ttrain4086-cpu/Kicad-VME-Wren-Update/clocks.kicad_sch

## KiCad design clocks.kicad_sch (2026-05-15)

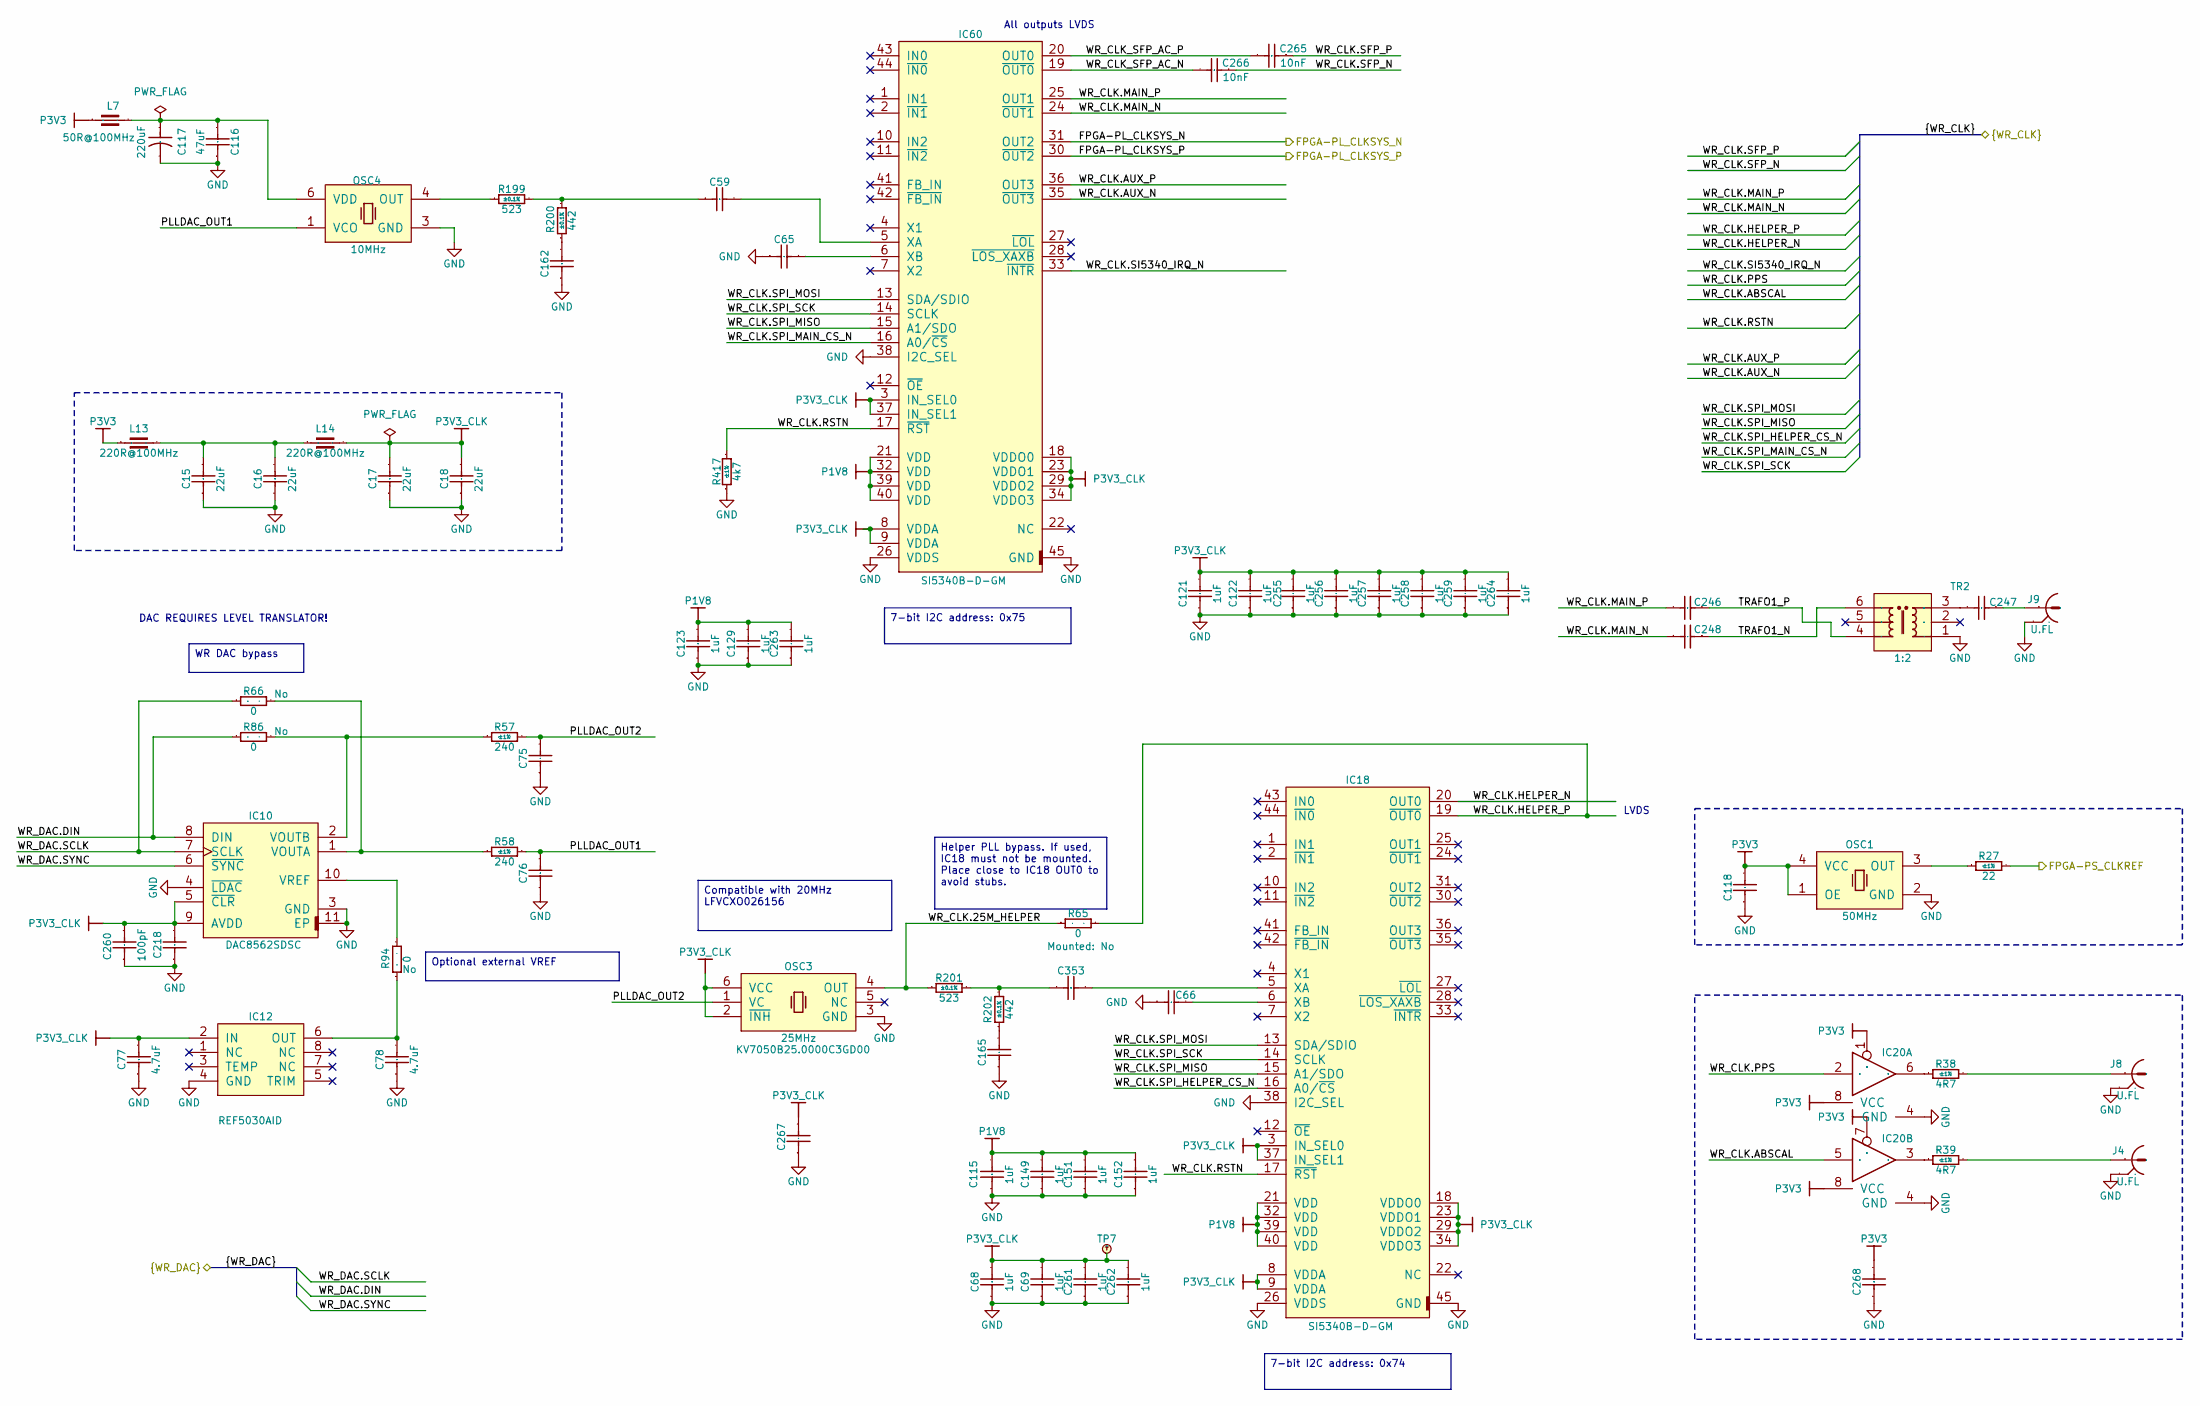
[picture p1: schematic clocks.kicad_sch]

Parts:
C15, C16, C17, C18: CC0603_22UF_10V_20%_X5R; CAPC1608X90N; Voltage 10V; Tolerance ±20%; Part Number CC0603_22UF_10V_20%_X5R
C59, C65, C66, C75, C76, C118, C162, C165, C218, C246, C247, C248, C267, C268, C353: CC0402_100NF_16V_10%_X7R; CAPC1005X55N; Voltage 16V; Tolerance ±10%; Part Number CC0402_100NF_16V_10%_X7R
C68, C69, C115, C121, C122, C123, C129, C149, C151, C152, C255, C256, C257, C258, C259, C261, C262, C263, C264: CC0402_1UF_25V_10%_X5R; CAPC1005X55N; Voltage 25V; Tolerance ±10%; Part Number CC0402_1UF_25V_10%_X5R
C77, C78: CC0402_4.7UF_6.3V_20%_X5R; CAPC1005X55N; Voltage 6.3V; Tolerance ±20%; Part Number CC0402_4.7UF_6.3V_20%_X5R
C116: CC1206_47UF_25V_20%_X5R; CAPC3216X180N; Voltage 25V; Tolerance ±20%; Part Number CC1206_47UF_25V_20%_X5R
C117: CAER_220UF_16V_20%_PANASONIC_16SEPC220MD; CAPPR350-850X700_A; Voltage 16V; Tolerance ±20%; Part Number CAER_220UF_16V_20%_PANASONIC_16SEPC220MD
C260: CC0402_100PF_50V_5%_C0G; CAPC1005X55N; Voltage 50V; Tolerance ±5%; Part Number CC0402_100PF_50V_5%_C0G
C265, C266: CC0402_10NF_16V_10%_X7R; CAPC1005X55N; Voltage 16V; Tolerance ±10%; Part Number CC0402_10NF_16V_10%_X7R
IC10: DAC8562SDSC; TEXAS_DSC (S-PWSON-N10); Part Number DAC8562SDSC
IC12: REF5030AID; SOIC127P600X175-8N; Part Number REF5030AID
IC18, IC60: SI5340B-D-GM; QFN50P700X700X90-45N-S530; Part Number SI5340B-D-GM
IC20: SN74LVC2G126DCT; SOP65P400X130-8N; Part Number SN74LVC2G126DCT
J4, J8, J9: HIROSE_U.FL-R-SMT-1(10); Part Number HIROSE_U.FL-R-SMT-1(10)
L7: IND1206_MURATA_BLM31PG500SN1; IND_MURATA_BLM31PG; Part Number IND1206_MURATA_BLM31PG500SN1
L13, L14: IND0805_MURATA_BLM21PG221SN1D; INDC2012X105N; Tolerance ±25%; Part Number IND0805_MURATA_BLM21PG221SN1D
OSC1: OSC_50MHZ_EPSON_SG-8018CE; OSC_EPSON_SG-8018CE; Part Number OSC_50MHZ_EPSON_SG-8018CE
OSC3: OSC_25MHZ_KYOCERA_KV7050B25.0000C3GD00; OSC_KYOCERA_KV7050B-C3; Part Number OSC_25MHZ_KYOCERA_KV7050B25.0000C3GD00
OSC4: OSC_10MHZ_CONNOR-WINFIELD_DOT050V-010.0M; OSC_CONNOR-WINFIELD_DOT050V; Part Number OSC_10MHZ_CONNOR-WINFIELD_DOT050V-010.0M
R27: R0402_22R_1%_0.0625W_100PPM; RESC1005X40N; Tolerance ±1%; Part Number R0402_22R_1%_0.0625W_100PPM
R38, R39: R0805_4R7_1%_0.125W_200PPM; RESC2012X60N; Tolerance ±1%; Part Number R0805_4R7_1%_0.125W_200PPM
R57, R58: R0402_240R_1%_0.0625W_100PPM; RESC1005X40N; Tolerance ±1%; Part Number R0402_240R_1%_0.0625W_100PPM
R65, R66, R86, R94: R0402_0R_JUMPER; RESC1005X40N; Part Number R0402_0R_JUMPER
R199, R201: R0603_523R_0.1%_0.063W_10PPM; RESC1608X55N; Tolerance ±0.1%; Part Number R0603_523R_0.1%_0.063W_10PPM
R200, R202: R0603_442R_0.1%_0.063W_10PPM; RESC1608X55N; Tolerance ±0.1%; Part Number R0603_442R_0.1%_0.063W_10PPM
R417: R0402_4K7_1%_0.0625W_100PPM; RESC1005X40N; Tolerance ±1%; Part Number R0402_4K7_1%_0.0625W_100PPM
TP7: Tomachie_TP_N; TPS127
TR2: XFMR_MINI-CIRCUITS_ADT2-1T+; XFMR_MINI-CIRCUITS_CD542; Part Number XFMR_MINI-CIRCUITS_ADT2-1T+

Connections:
FPGA-PL_CLKSYS_N: IC60.31 (OUT2)
FPGA-PL_CLKSYS_P: IC60.30 (~OUT2)
FPGA-PS_CLKREF: R27.2
GND: C15.1, C16.1, C17.1, C18.1, C65.1, C66.1, C68.1, C69.1, C75.1, C76.1, C77.1, C78.1, C115.1, C116.1, C117.2, C118.1, C121.1, C122.1, C123.1, C129.1, C149.1, C151.1, C152.1, C162.1, C165.1, C218.1, C255.1, C256.1, C257.1, C258.1, C259.1, C260.1, C261.1, C262.1, C263.1, C264.1, C267.1, C268.1, IC10.3 (GND), IC10.4 (~LDAC), IC10.11 (EP), IC12.4 (GND), IC18.26 (VDDS), IC18.38 (I2C_SEL), IC18.45 (GND), IC20.4 (GND), IC60.26 (VDDS), IC60.38 (I2C_SEL), IC60.45 (GND), J4.2, J8.2, J9.2, OSC1.2 (GND), OSC3.3 (GND), OSC4.3 (GND), R417.1, TR2.1
unnamed: C15.2, C16.2, L13.2, L14.1
unnamed: C59.1, R199.2, R200.2
unnamed: C59.2, IC60.5 (XA)
unnamed: C65.2, IC60.6 (XB)
unnamed: C66.2, IC18.6 (XB)
unnamed: C78.2, IC12.6 (OUT), R94.1
unnamed: C116.2, C117.1, L7.2, OSC4.6 (VDD)
unnamed: C162.2, R200.1
unnamed: C165.2, R202.1
unnamed: C247.1, J9.1
unnamed: C247.2, TR2.3 (PDOT)
unnamed: C353.1, R201.2, R202.2
unnamed: C353.2, IC18.5 (XA)
unnamed: IC10.1 (VOUTA), R58.1, R66.2
unnamed: IC10.2 (VOUTB), R57.1, R86.2
unnamed: IC10.10 (VREF), R94.2
unnamed: IC20.3 (2Y), R39.1
unnamed: IC20.6 (1Y), R38.1
unnamed: J4.1, R39.2
unnamed: J8.1, R38.2
unnamed: OSC1.3 (OUT), R27.1
unnamed: OSC4.4 (OUT), R199.1
P1V8: C115.2, C123.2, C129.2, C149.2, C151.2, C152.2, C263.2, IC18.21 (VDD), IC18.32 (VDD), IC18.39 (VDD), IC18.40 (VDD), IC60.21 (VDD), IC60.32 (VDD), IC60.39 (VDD), IC60.40 (VDD)
P3V3: C118.2, C268.2, IC20.1 (1~OE), IC20.7 (7~OE), IC20.8 (VCC), L7.1, L13.1, OSC1.1 (OE), OSC1.4 (VCC)
P3V3_CLK: C17.2, C18.2, C68.2, C69.2, C77.2, C121.2, C122.2, C218.2, C255.2, C256.2, C257.2, C258.2, C259.2, C260.2, C261.2, C262.2, C264.2, C267.2, IC10.5 (~CLR), IC10.9 (AVDD), IC12.2 (IN), IC18.3 (IN_SEL0), IC18.8 (VDDA), IC18.9 (VDDA), IC18.18 (VDDO0), IC18.23 (VDDO1), IC18.29 (VDDO2), IC18.34 (VDDO3), IC18.37 (IN_SEL1), IC60.3 (IN_SEL0), IC60.8 (VDDA), IC60.9 (VDDA), IC60.18 (VDDO0), IC60.23 (VDDO1), IC60.29 (VDDO2), IC60.34 (VDDO3), IC60.37 (IN_SEL1), L14.2, OSC3.2 (~INH), OSC3.6 (VCC), TP7.1
PLLDAC_OUT1: C76.2, OSC4.1 (VCO), R58.2
PLLDAC_OUT2: C75.2, OSC3.1 (VC), R57.2
TRAFO1_N: C248.1, TR2.6 (SDOT)
TRAFO1_P: C246.1, TR2.4 (S)
WR_CLK.25M_HELPER: OSC3.4 (OUT), R65.1, R201.1
WR_CLK.ABSCAL: IC20.5 (2A)
WR_CLK.AUX_N: IC60.35 (~OUT3)
WR_CLK.AUX_P: IC60.36 (OUT3)
WR_CLK.HELPER_N: IC18.20 (OUT0)
WR_CLK.HELPER_P: IC18.19 (~OUT0), R65.2
WR_CLK.MAIN_N: C248.2, IC60.24 (~OUT1)
WR_CLK.MAIN_P: C246.2, IC60.25 (OUT1)
WR_CLK.PPS: IC20.2 (1A)
WR_CLK.RSTN: IC18.17 (~RST), IC60.17 (~RST), R417.2
WR_CLK.SFP_N: C266.1
WR_CLK.SFP_P: C265.1
WR_CLK.SI5340_IRQ_N: IC60.33 (~INTR)
WR_CLK.SPI_HELPER_CS_N: IC18.16 (A0/~CS)
WR_CLK.SPI_MAIN_CS_N: IC60.16 (A0/~CS)
WR_CLK.SPI_MISO: IC18.15 (A1/SDO), IC60.15 (A1/SDO)
WR_CLK.SPI_MOSI: IC18.13 (SDA/SDIO), IC60.13 (SDA/SDIO)
WR_CLK.SPI_SCK: IC18.14 (SCLK), IC60.14 (SCLK)
WR_CLK_SFP_AC_N: C266.2, IC60.19 (~OUT0)
WR_CLK_SFP_AC_P: C265.2, IC60.20 (OUT0)
WR_DAC.DIN: IC10.8 (DIN), R86.1
WR_DAC.SCLK: IC10.7 (SCLK), R66.1
WR_DAC.SYNC: IC10.6 (~SYNC)

Notes on the sheet:
DAC REQUIRES LEVEL TRANSLATOR!
LVDS
All outputs LVDS
Helper PLL bypass. If used, IC18 must not be mounted. Place close to IC18 OUT0 to avoid stubs.
Compatible with 20MHz LFVCXO026156
7-bit I2C address: 0x75
Optional external VREF
7-bit I2C address: 0x74
WR DAC bypass
