ttrain4086-cpu/Kicad-VME-Wren-Update/ddr4-ps.kicad_sch

## KiCad design ddr4-ps.kicad_sch (2026-05-15)

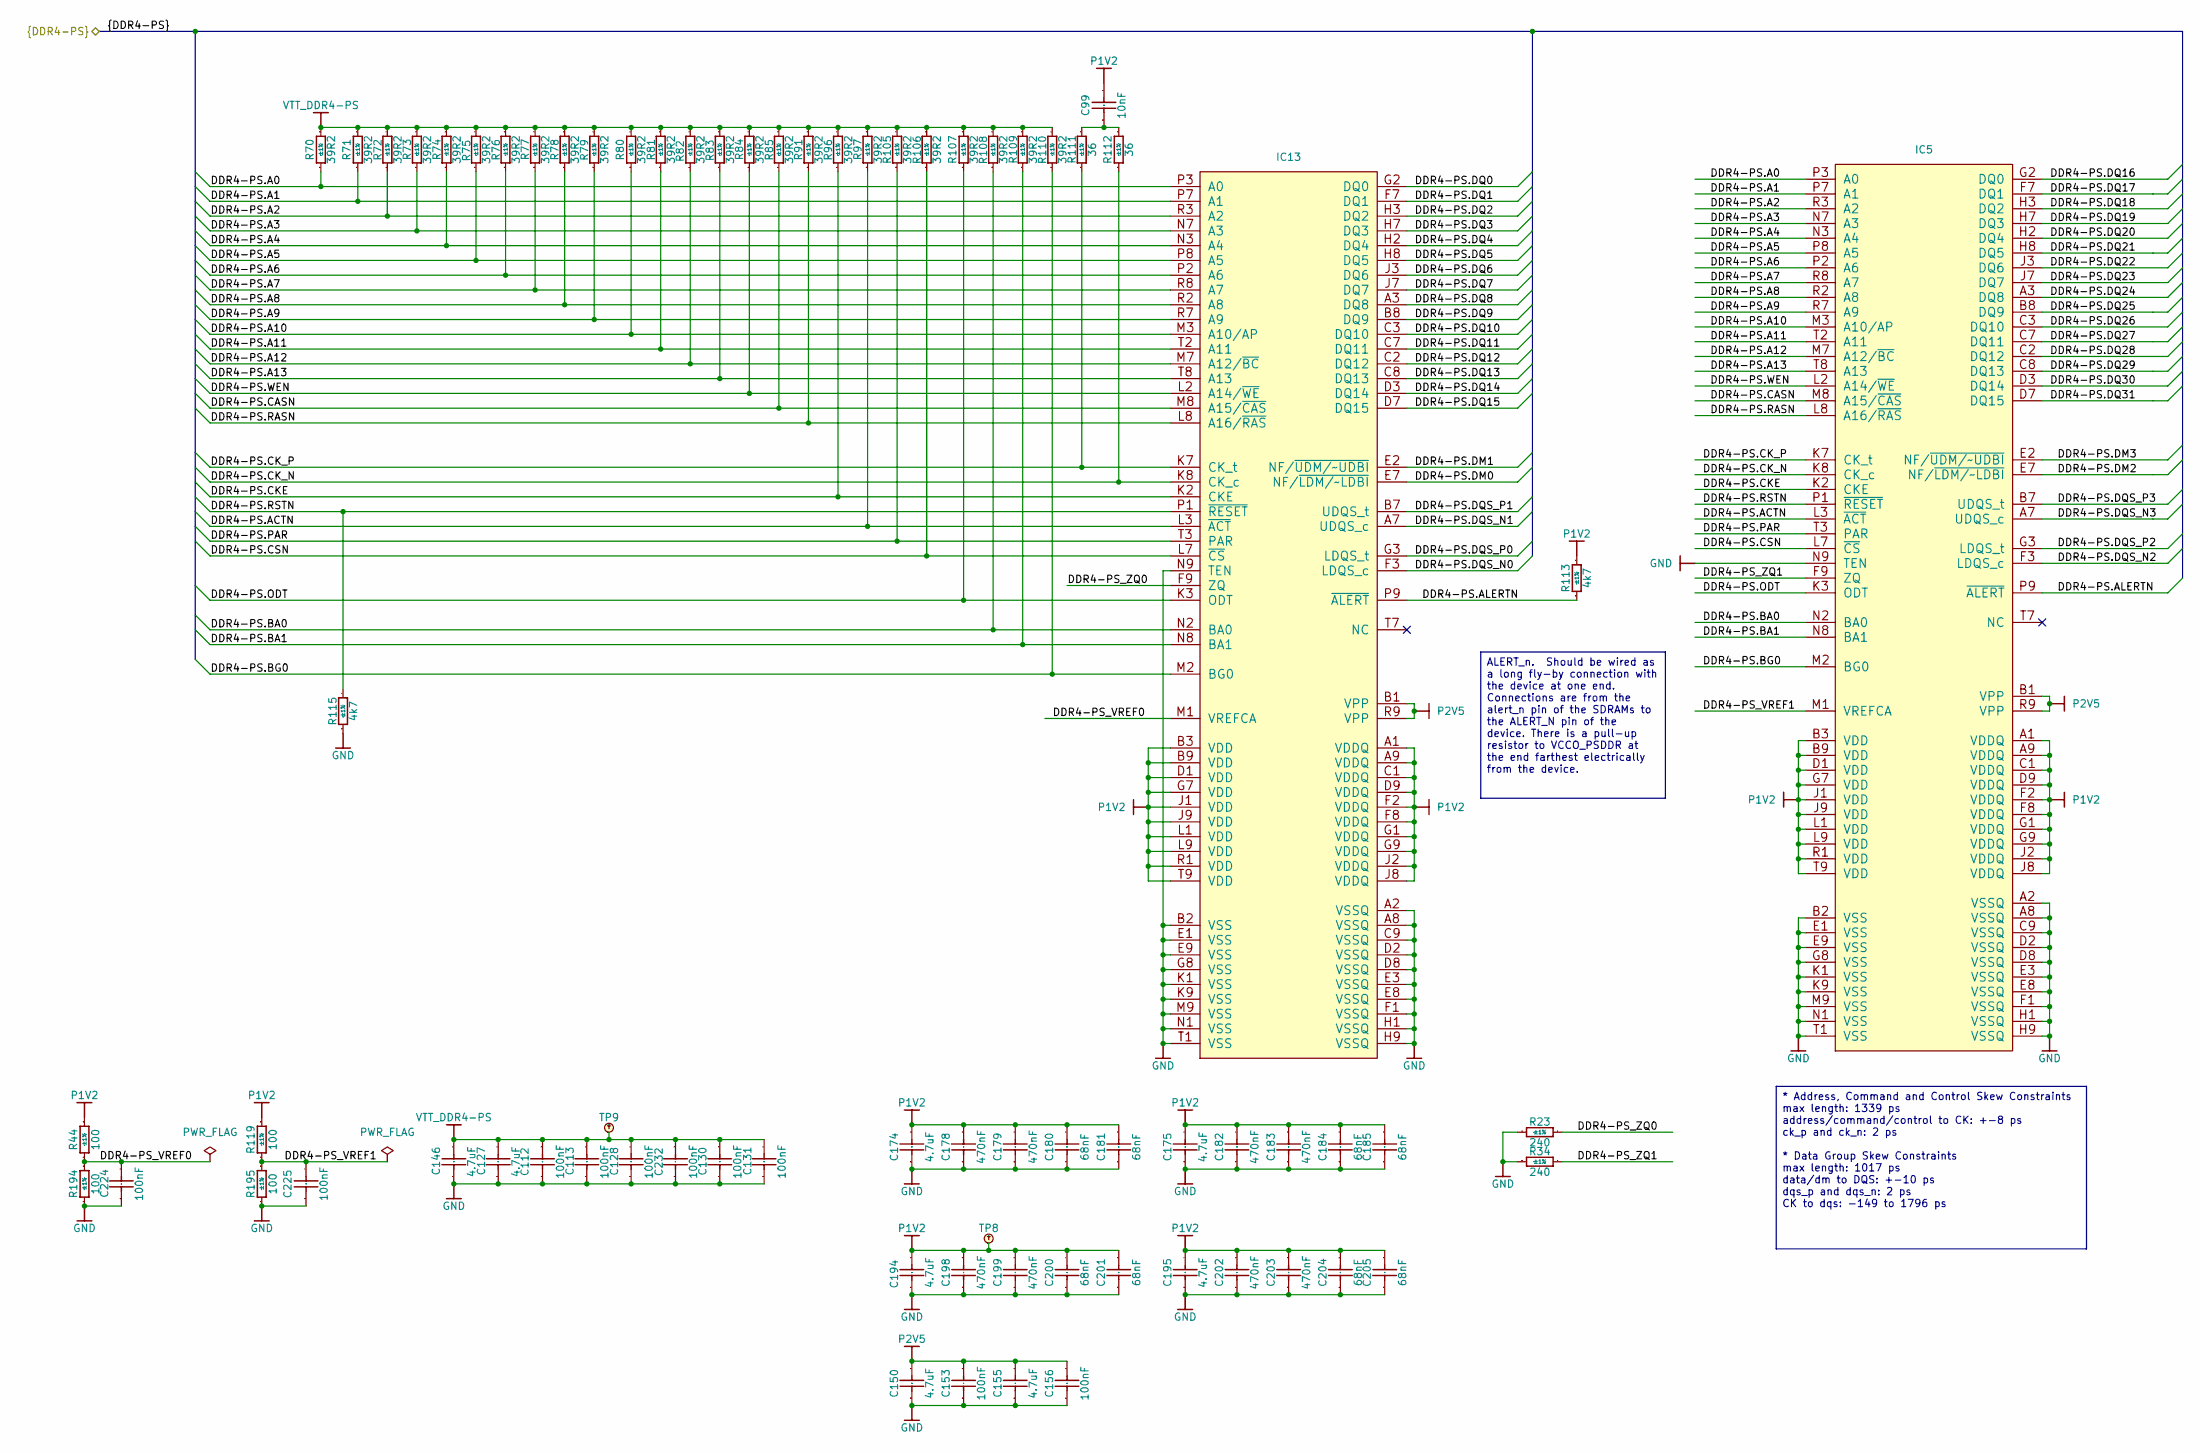
[picture p2: schematic ddr4-ps.kicad_sch]

Parts:
C99: CC0402_10NF_16V_10%_X7R; CAPC1005X55N; Voltage 16V; Tolerance ±10%; Part Number CC0402_10NF_16V_10%_X7R
C112, C113, C128, C130, C131, C153, C156, C224, C225, C232: CC0402_100NF_25V_10%_X7R_YUDEN_TMK105B7104KVHF; CAPC1005X55N; Voltage 25V; Tolerance ±10%; Part Number CC0402_100NF_25V_10%_X7R_YUDEN_TMK105B7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
C127, C146, C150, C155, C174, C175, C194, C195: CC0402_4.7UF_6.3V_20%_X5R; CAPC1005X55N; Voltage 6.3V; Tolerance ±20%; Part Number CC0402_4.7UF_6.3V_20%_X5R
C178, C179, C182, C183, C198, C199, C202, C203: CC0402_470NF_6.3V_10%_X5R; CAPC1005X55N; Voltage 6.3V; Tolerance ±10%; Part Number CC0402_470NF_6.3V_10%_X5R
C180, C181, C184, C185, C200, C201, C204, C205: CC0402_68NF_16V_10%_X7R; CAPC1005X55N; Voltage 16V; Tolerance ±10%; Part Number CC0402_68NF_16V_10%_X7R
IC5, IC13: MT40A512M16LY-075-E; BGA96C80P9X16_750X1350X120; Part Description +1.2V, 8Gb (512 Meg x 16) Automotive DD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
R23, R34: R0402_240R_1%_0.0625W_100PPM; RESC1005X40N; Tolerance ±1%; Part Number R0402_240R_1%_0.0625W_100PPM
R44, R119, R194, R195: R0402_100R_1%_0.0625W_100PPM; RESC1005X40N; Tolerance ±1%; Part Number R0402_100R_1%_0.0625W_100PPM
R70, R71, R72, R73, R74, R75, R76, R77, R78, R79, R80, R81, R82, R83, R84, R85, R91, R96, R97, R105, R106, R107, R108, R109, R110: R0402_39R2_1%_0.063W_100PPM; RESC1005X40N; Tolerance ±1%; Part Number R0402_39R2_1%_0.063W_100PPM
R111, R112: R0402_36R_1%_0.0625W_100PPM; RESC1005X40N; Tolerance ±1%; Part Number R0402_36R_1%_0.0625W_100PPM
R113, R115: R0402_4K7_1%_0.0625W_100PPM; RESC1005X40N; Tolerance ±1%; Part Number R0402_4K7_1%_0.0625W_100PPM
TP8, TP9: Tomachie_TP_N; TPS127

Connections:
DDR4-PS.A0: IC5.P3 (A0), IC13.P3 (A0), R70.1
DDR4-PS.A1: IC5.P7 (A1), IC13.P7 (A1), R71.1
DDR4-PS.A2: IC5.R3 (A2), IC13.R3 (A2), R72.1
DDR4-PS.A3: IC5.N7 (A3), IC13.N7 (A3), R73.1
DDR4-PS.A4: IC5.N3 (A4), IC13.N3 (A4), R74.1
DDR4-PS.A5: IC5.P8 (A5), IC13.P8 (A5), R75.1
DDR4-PS.A6: IC5.P2 (A6), IC13.P2 (A6), R76.1
DDR4-PS.A7: IC5.R8 (A7), IC13.R8 (A7), R77.1
DDR4-PS.A8: IC5.R2 (A8), IC13.R2 (A8), R78.1
DDR4-PS.A9: IC5.R7 (A9), IC13.R7 (A9), R79.1
DDR4-PS.A10: IC5.M3 (A10/AP), IC13.M3 (A10/AP), R80.1
DDR4-PS.A11: IC5.T2 (A11), IC13.T2 (A11), R81.1
DDR4-PS.A12: IC5.M7 (A12/~BC), IC13.M7 (A12/~BC), R82.1
DDR4-PS.A13: IC5.T8 (A13), IC13.T8 (A13), R83.1
DDR4-PS.ACTN: IC5.L3 (~ACT), IC13.L3 (~ACT), R97.1
DDR4-PS.ALERTN: IC5.P9 (~ALERT), IC13.P9 (~ALERT), R113.1
DDR4-PS.BA0: IC5.N2 (BA0), IC13.N2 (BA0), R108.1
DDR4-PS.BA1: IC5.N8 (BA1), IC13.N8 (BA1), R109.1
DDR4-PS.BG0: IC5.M2 (BG0), IC13.M2 (BG0), R110.1
DDR4-PS.CASN: IC5.M8 (A15/~CAS), IC13.M8 (A15/~CAS), R85.1
DDR4-PS.CKE: IC5.K2 (CKE), IC13.K2 (CKE), R96.1
DDR4-PS.CK_N: IC5.K8 (CK_c), IC13.K8 (CK_c), R112.1
DDR4-PS.CK_P: IC5.K7 (CK_t), IC13.K7 (CK_t), R111.1
DDR4-PS.CSN: IC5.L7 (~CS), IC13.L7 (~CS), R106.1
DDR4-PS.DM0: IC13.E7 (NF/~LDM/~LDBI)
DDR4-PS.DM1: IC13.E2 (NF/~UDM/~UDBI)
DDR4-PS.DM2: IC5.E7 (NF/~LDM/~LDBI)
DDR4-PS.DM3: IC5.E2 (NF/~UDM/~UDBI)
DDR4-PS.DQ0: IC13.G2 (DQ0)
DDR4-PS.DQ1: IC13.F7 (DQ1)
DDR4-PS.DQ2: IC13.H3 (DQ2)
DDR4-PS.DQ3: IC13.H7 (DQ3)
DDR4-PS.DQ4: IC13.H2 (DQ4)
DDR4-PS.DQ5: IC13.H8 (DQ5)
DDR4-PS.DQ6: IC13.J3 (DQ6)
DDR4-PS.DQ7: IC13.J7 (DQ7)
DDR4-PS.DQ8: IC13.A3 (DQ8)
DDR4-PS.DQ9: IC13.B8 (DQ9)
DDR4-PS.DQ10: IC13.C3 (DQ10)
DDR4-PS.DQ11: IC13.C7 (DQ11)
DDR4-PS.DQ12: IC13.C2 (DQ12)
DDR4-PS.DQ13: IC13.C8 (DQ13)
DDR4-PS.DQ14: IC13.D3 (DQ14)
DDR4-PS.DQ15: IC13.D7 (DQ15)
DDR4-PS.DQ16: IC5.G2 (DQ0)
DDR4-PS.DQ17: IC5.F7 (DQ1)
DDR4-PS.DQ18: IC5.H3 (DQ2)
DDR4-PS.DQ19: IC5.H7 (DQ3)
DDR4-PS.DQ20: IC5.H2 (DQ4)
DDR4-PS.DQ21: IC5.H8 (DQ5)
DDR4-PS.DQ22: IC5.J3 (DQ6)
DDR4-PS.DQ23: IC5.J7 (DQ7)
DDR4-PS.DQ24: IC5.A3 (DQ8)
DDR4-PS.DQ25: IC5.B8 (DQ9)
DDR4-PS.DQ26: IC5.C3 (DQ10)
DDR4-PS.DQ27: IC5.C7 (DQ11)
DDR4-PS.DQ28: IC5.C2 (DQ12)
DDR4-PS.DQ29: IC5.C8 (DQ13)
DDR4-PS.DQ30: IC5.D3 (DQ14)
DDR4-PS.DQ31: IC5.D7 (DQ15)
DDR4-PS.DQS_N0: IC13.F3 (LDQS_c)
DDR4-PS.DQS_N1: IC13.A7 (UDQS_c)
DDR4-PS.DQS_N2: IC5.F3 (LDQS_c)
DDR4-PS.DQS_N3: IC5.A7 (UDQS_c)
DDR4-PS.DQS_P0: IC13.G3 (LDQS_t)
DDR4-PS.DQS_P1: IC13.B7 (UDQS_t)
DDR4-PS.DQS_P2: IC5.G3 (LDQS_t)
DDR4-PS.DQS_P3: IC5.B7 (UDQS_t)
DDR4-PS.ODT: IC5.K3 (ODT), IC13.K3 (ODT), R107.1
DDR4-PS.PAR: IC5.T3 (PAR), IC13.T3 (PAR), R105.1
DDR4-PS.RASN: IC5.L8 (A16/~RAS), IC13.L8 (A16/~RAS), R91.1
DDR4-PS.RSTN: IC5.P1 (~RESET), IC13.P1 (~RESET), R115.2
DDR4-PS.WEN: IC5.L2 (A14/~WE), IC13.L2 (A14/~WE), R84.1
DDR4-PS_VREF0: C224.2, IC13.M1 (VREFCA), R44.2, R194.1
DDR4-PS_VREF1: C225.2, IC5.M1 (VREFCA), R119.2, R195.1
DDR4-PS_ZQ0: IC13.F9 (ZQ), R23.2
DDR4-PS_ZQ1: IC5.F9 (ZQ), R34.2
GND: C112.1, C113.1, C127.1, C128.1, C130.1, C131.1, C146.1, C150.1, C153.1, C155.1, C156.1, C174.1, C175.1, C178.1, C179.1, C180.1, C181.1, C182.1, C183.1, C184.1, C185.1, C194.1, C195.1, C198.1, C199.1, C200.1, C201.1, C202.1, C203.1, C204.1, C205.1, C224.1, C225.1, C232.1, IC5.A2 (VSSQ), IC5.A8 (VSSQ), IC5.B2 (VSS), IC5.C9 (VSSQ), IC5.D2 (VSSQ), IC5.D8 (VSSQ), IC5.E1 (VSS), IC5.E3 (VSSQ), IC5.E8 (VSSQ), IC5.E9 (VSS), IC5.F1 (VSSQ), IC5.G8 (VSS), IC5.H1 (VSSQ), IC5.H9 (VSSQ), IC5.K1 (VSS), IC5.K9 (VSS), IC5.M9 (VSS), IC5.N1 (VSS), IC5.N9 (TEN), IC5.T1 (VSS), IC13.A2 (VSSQ), IC13.A8 (VSSQ), IC13.B2 (VSS), IC13.C9 (VSSQ), IC13.D2 (VSSQ), IC13.D8 (VSSQ), IC13.E1 (VSS), IC13.E3 (VSSQ), IC13.E8 (VSSQ), IC13.E9 (VSS), IC13.F1 (VSSQ), IC13.G8 (VSS), IC13.H1 (VSSQ), IC13.H9 (VSSQ), IC13.K1 (VSS), IC13.K9 (VSS), IC13.M9 (VSS), IC13.N1 (VSS), IC13.N9 (TEN), IC13.T1 (VSS), R23.1, R34.1, R115.1, R194.2, R195.2
unnamed: C99.1, R111.2, R112.2
P1V2: C99.2, C174.2, C175.2, C178.2, C179.2, C180.2, C181.2, C182.2, C183.2, C184.2, C185.2, C194.2, C195.2, C198.2, C199.2, C200.2, C201.2, C202.2, C203.2, C204.2, C205.2, IC5.A1 (VDDQ), IC5.A9 (VDDQ), IC5.B3 (VDD), IC5.B9 (VDD), IC5.C1 (VDDQ), IC5.D1 (VDD), IC5.D9 (VDDQ), IC5.F2 (VDDQ), IC5.F8 (VDDQ), IC5.G1 (VDDQ), IC5.G7 (VDD), IC5.G9 (VDDQ), IC5.J1 (VDD), IC5.J2 (VDDQ), IC5.J8 (VDDQ), IC5.J9 (VDD), IC5.L1 (VDD), IC5.L9 (VDD), IC5.R1 (VDD), IC5.T9 (VDD), IC13.A1 (VDDQ), IC13.A9 (VDDQ), IC13.B3 (VDD), IC13.B9 (VDD), IC13.C1 (VDDQ), IC13.D1 (VDD), IC13.D9 (VDDQ), IC13.F2 (VDDQ), IC13.F8 (VDDQ), IC13.G1 (VDDQ), IC13.G7 (VDD), IC13.G9 (VDDQ), IC13.J1 (VDD), IC13.J2 (VDDQ), IC13.J8 (VDDQ), IC13.J9 (VDD), IC13.L1 (VDD), IC13.L9 (VDD), IC13.R1 (VDD), IC13.T9 (VDD), R44.1, R113.2, R119.1, TP8.1
P2V5: C150.2, C153.2, C155.2, C156.2, IC5.B1 (VPP), IC5.R9 (VPP), IC13.B1 (VPP), IC13.R9 (VPP)
VTT_DDR4-PS: C112.2, C113.2, C127.2, C128.2, C130.2, C131.2, C146.2, C232.2, R70.2, R71.2, R72.2, R73.2, R74.2, R75.2, R76.2, R77.2, R78.2, R79.2, R80.2, R81.2, R82.2, R83.2, R84.2, R85.2, R91.2, R96.2, R97.2, R105.2, R106.2, R107.2, R108.2, R109.2, R110.2, TP9.1

Notes on the sheet:
* Address, Command and Control Skew Constraints max length: 1339 ps address/command/control to CK: +-8 ps ck_p and ck_n: 2 ps * Data Group Skew Constraints max length: 1017 ps data/dm to DQS: +-10 ps dqs_p and dqs_n: 2 ps CK to dqs: -149 to 1796 ps
ALERT_n. Should be wired as a long fly-by connection with the device at one end. Connections are from the alert_n pin of the SDRAMs to the ALERT_N pin of the device. There is a pull-up resistor to VCCO_PSDDR at the end farthest electrically from the device.
