ttrain4086-cpu/Kicad-VME-Wren-Update/flash.kicad_sch

## KiCad design flash.kicad_sch (2026-05-15)

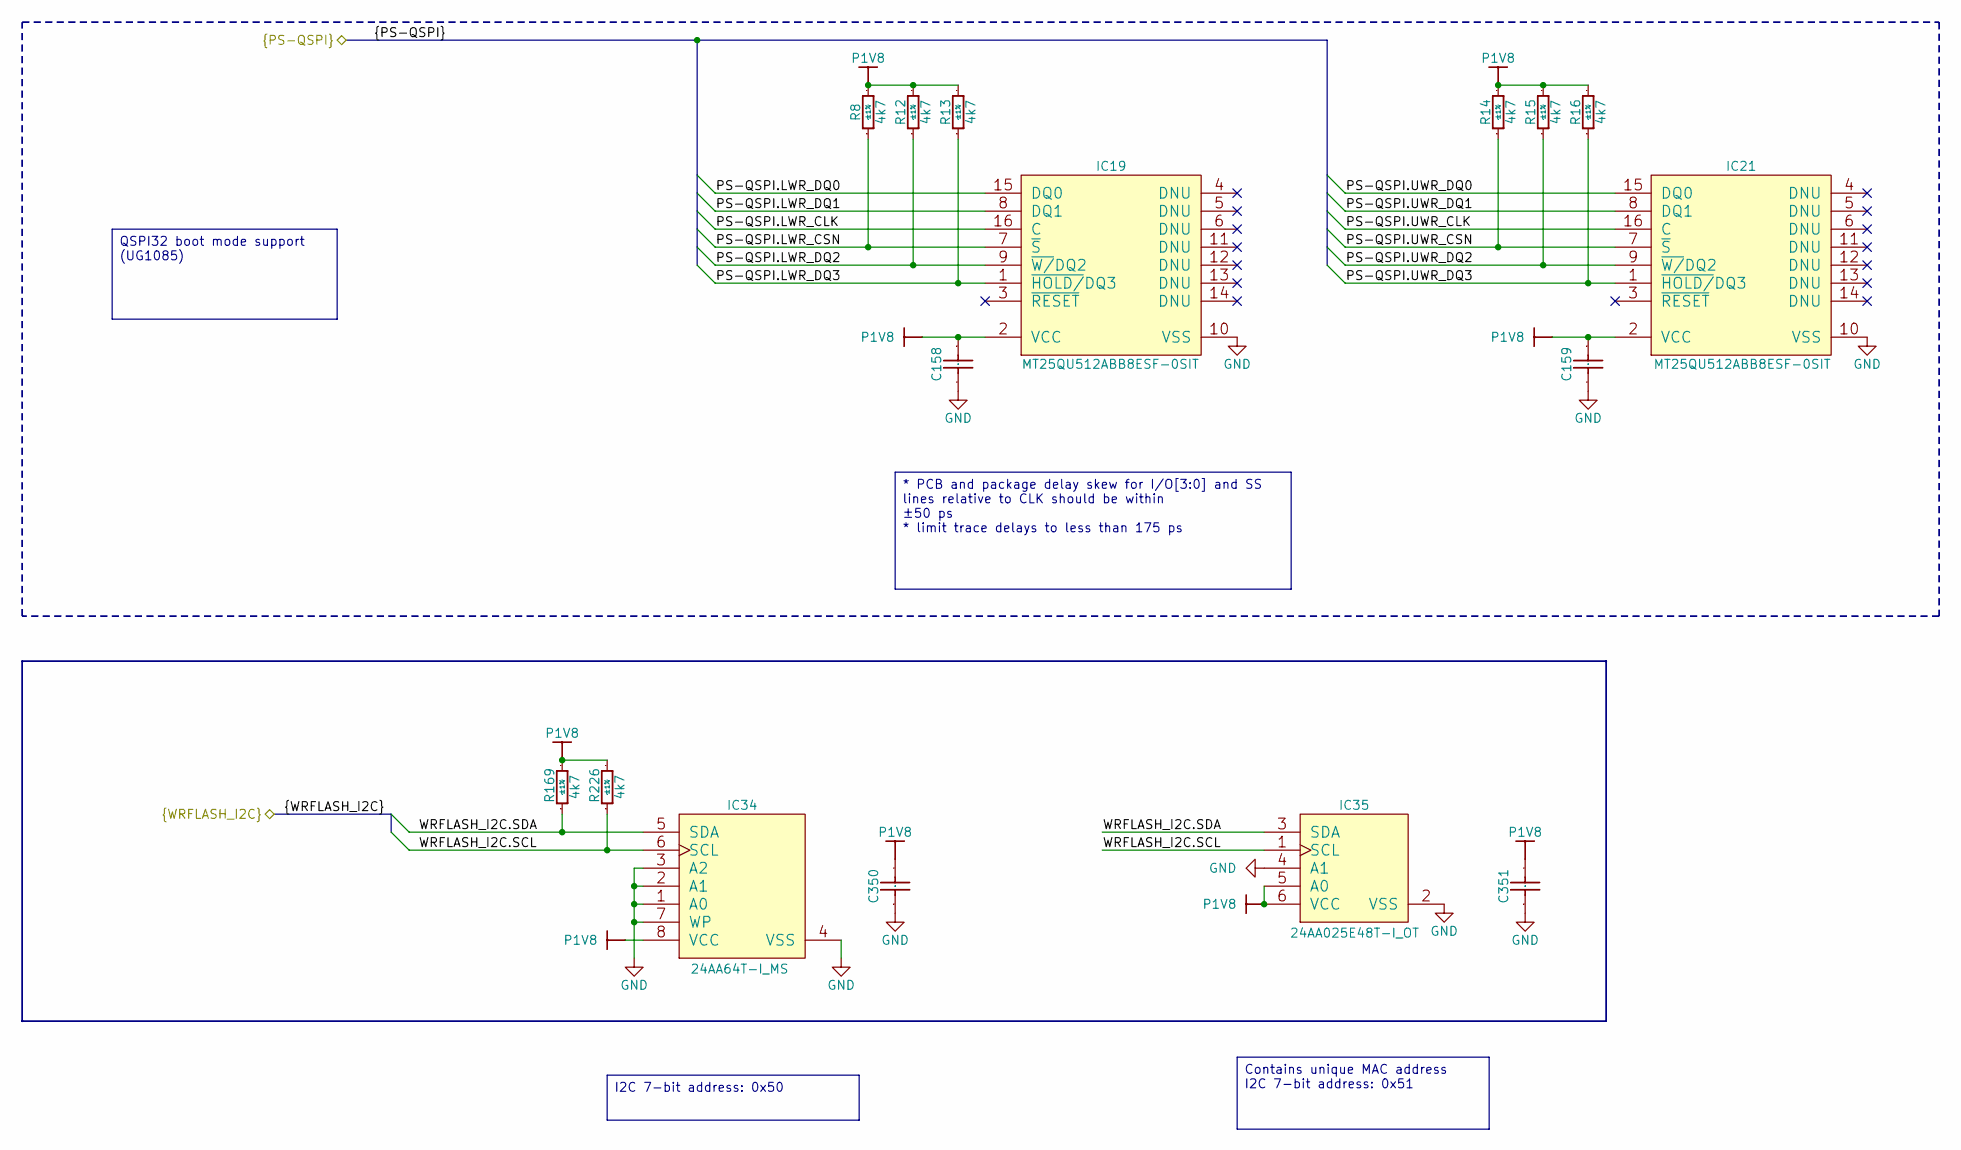
[picture p3: schematic flash.kicad_sch]

Parts:
C158, C159, C350, C351: CC0402_100NF_16V_10%_X7R; CAPC1005X55N; Voltage 16V; Tolerance ±10%; Part Number CC0402_100NF_16V_10%_X7R
IC19, IC21: MT25QU512ABB8ESF-0SIT; SOIC127P1030X265-16N; Part Number MT25QU512ABB8ESF-0SIT
IC34: 24AA64T-I_MS; SOP65P490X110-8N; Part Number 24AA64T-I_MS
IC35: 24AA025E48T-I_OT; SOT95P280X145-6N; Part Number 24AA025E48T-I_OT
R8, R12, R13, R14, R15, R16, R169, R226: R0402_4K7_1%_0.0625W_100PPM; RESC1005X40N; Tolerance ±1%; Part Number R0402_4K7_1%_0.0625W_100PPM

Connections:
GND: C158.2, C159.2, C350.1, C351.1, IC19.10 (VSS), IC21.10 (VSS), IC34.1 (A0), IC34.2 (A1), IC34.3 (A2), IC34.4 (VSS), IC34.7 (WP), IC35.2 (VSS), IC35.4 (A1)
P1V8: C158.1, C159.1, C350.2, C351.2, IC19.2 (VCC), IC21.2 (VCC), IC34.8 (VCC), IC35.5 (A0), IC35.6 (VCC), R8.2, R12.2, R13.2, R14.2, R15.2, R16.2, R169.2, R226.2
PS-QSPI.LWR_CLK: IC19.16 (C)
PS-QSPI.LWR_CSN: IC19.7 (~S), R8.1
PS-QSPI.LWR_DQ0: IC19.15 (DQ0)
PS-QSPI.LWR_DQ1: IC19.8 (DQ1)
PS-QSPI.LWR_DQ2: IC19.9 (~W/DQ2), R12.1
PS-QSPI.LWR_DQ3: IC19.1 (~HOLD/DQ3), R13.1
PS-QSPI.UWR_CLK: IC21.16 (C)
PS-QSPI.UWR_CSN: IC21.7 (~S), R14.1
PS-QSPI.UWR_DQ0: IC21.15 (DQ0)
PS-QSPI.UWR_DQ1: IC21.8 (DQ1)
PS-QSPI.UWR_DQ2: IC21.9 (~W/DQ2), R15.1
PS-QSPI.UWR_DQ3: IC21.1 (~HOLD/DQ3), R16.1
WRFLASH_I2C.SCL: IC34.6 (SCL), IC35.1 (SCL), R226.1
WRFLASH_I2C.SDA: IC34.5 (SDA), IC35.3 (SDA), R169.1

Notes on the sheet:
* PCB and package delay skew for I/O[3:0] and SS lines relative to CLK should be within ±50 ps * limit trace delays to less than 175 ps
QSPI32 boot mode support (UG1085)
I2C 7-bit address: 0x50
Contains unique MAC address I2C 7-bit address: 0x51
