ttrain4086-cpu/Kicad-VME-Wren-Update/fp_connectors.kicad_sch

## KiCad design fp_connectors.kicad_sch (2026-05-15)

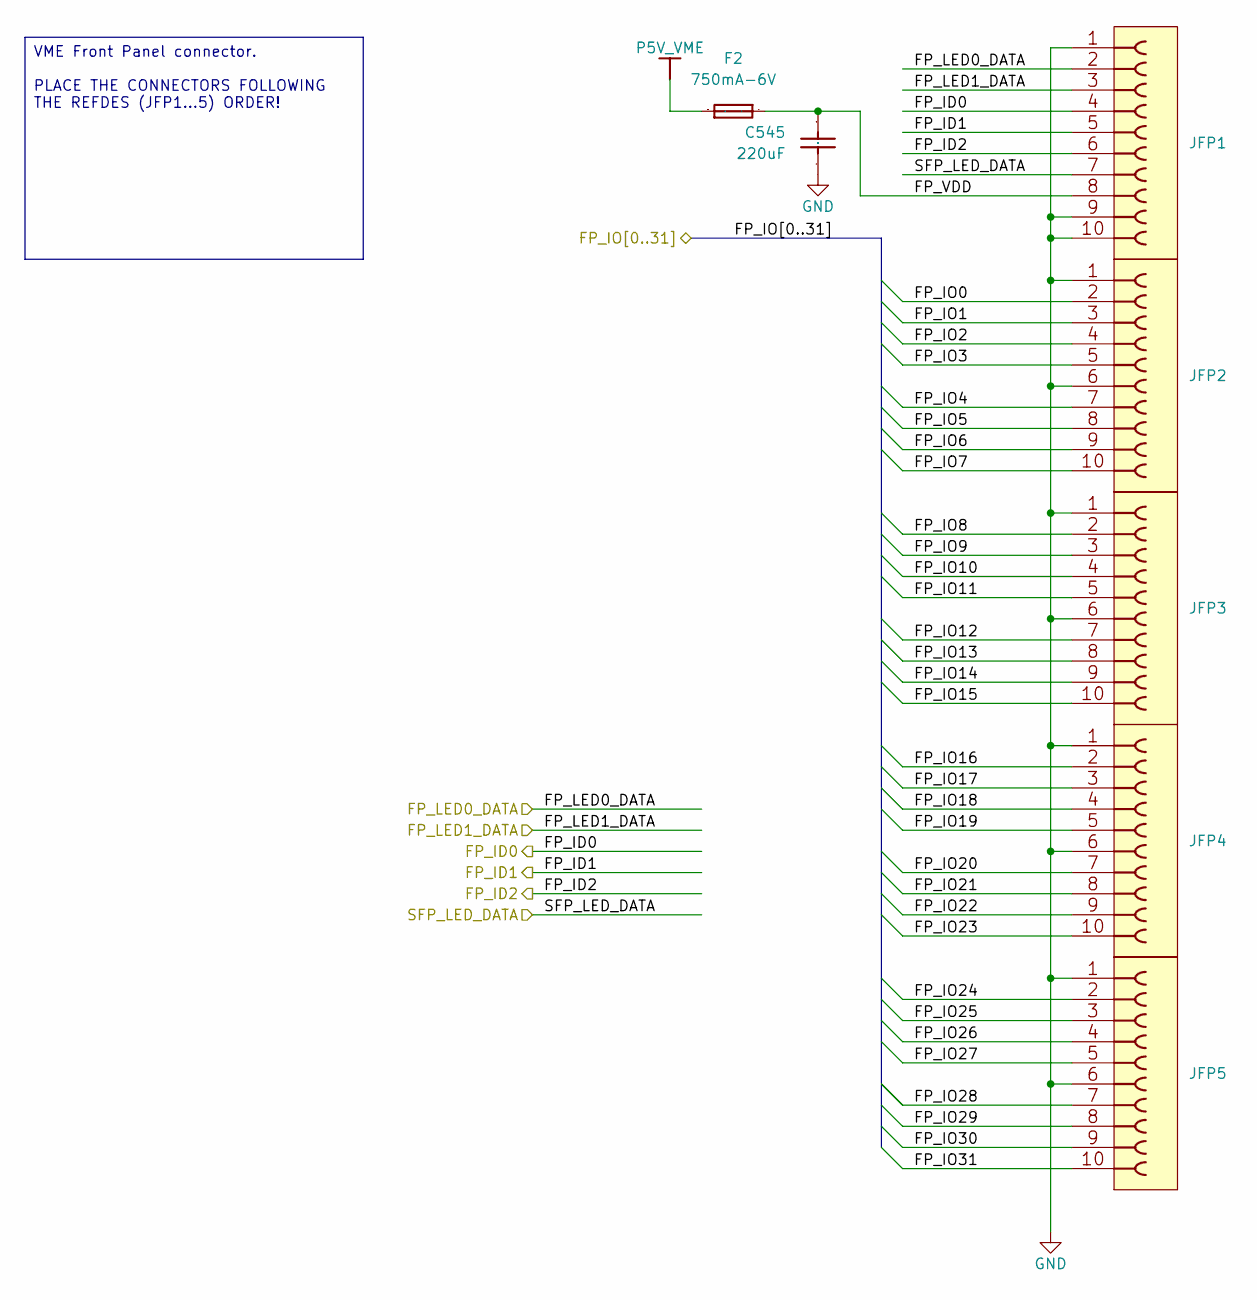
[picture p4: schematic fp_connectors.kicad_sch]

Parts:
C545: CC1210_220UF_6.3V_20%_X5R; CAPC3225X280N; Voltage 6.3V; Tolerance ±20%; Part Number CC1210_220UF_6.3V_20%_X5R
F2: FUSR_LITTELFUSE_0603L075SL; FUSR_LITTELFUSE_0603L; Part Number FUSR_LITTELFUSE_0603L075SL
JFP1, JFP2, JFP3, JFP4, JFP5: HARWIN_M22-6541042R; Part Number HARWIN_M22-6541042R

Connections:
FP_ID0: JFP1.4
FP_ID1: JFP1.5
FP_ID2: JFP1.6
FP_IO0: JFP2.2
FP_IO1: JFP2.3
FP_IO2: JFP2.4
FP_IO3: JFP2.5
FP_IO4: JFP2.7
FP_IO5: JFP2.8
FP_IO6: JFP2.9
FP_IO7: JFP2.10
FP_IO8: JFP3.2
FP_IO9: JFP3.3
FP_IO10: JFP3.4
FP_IO11: JFP3.5
FP_IO12: JFP3.7
FP_IO13: JFP3.8
FP_IO14: JFP3.9
FP_IO15: JFP3.10
FP_IO16: JFP4.2
FP_IO17: JFP4.3
FP_IO18: JFP4.4
FP_IO19: JFP4.5
FP_IO20: JFP4.7
FP_IO21: JFP4.8
FP_IO22: JFP4.9
FP_IO23: JFP4.10
FP_IO24: JFP5.2
FP_IO25: JFP5.3
FP_IO26: JFP5.4
FP_IO27: JFP5.5
FP_IO28: JFP5.7
FP_IO29: JFP5.8
FP_IO30: JFP5.9
FP_IO31: JFP5.10
FP_LED0_DATA: JFP1.2
FP_LED1_DATA: JFP1.3
FP_VDD: C545.1, F2.2, JFP1.8
GND: C545.2, JFP1.1, JFP1.9, JFP1.10, JFP2.1, JFP2.6, JFP3.1, JFP3.6, JFP4.1, JFP4.6, JFP5.1, JFP5.6
P5V_VME: F2.1
SFP_LED_DATA: JFP1.7

Notes on the sheet:
VME Front Panel connector. PLACE THE CONNECTORS FOLLOWING THE REFDES (JFP1...5) ORDER!
