ttrain4086-cpu/Kicad-VME-Wren-Update/fpga-config.kicad_sch

## KiCad design fpga-config.kicad_sch (2026-05-15)

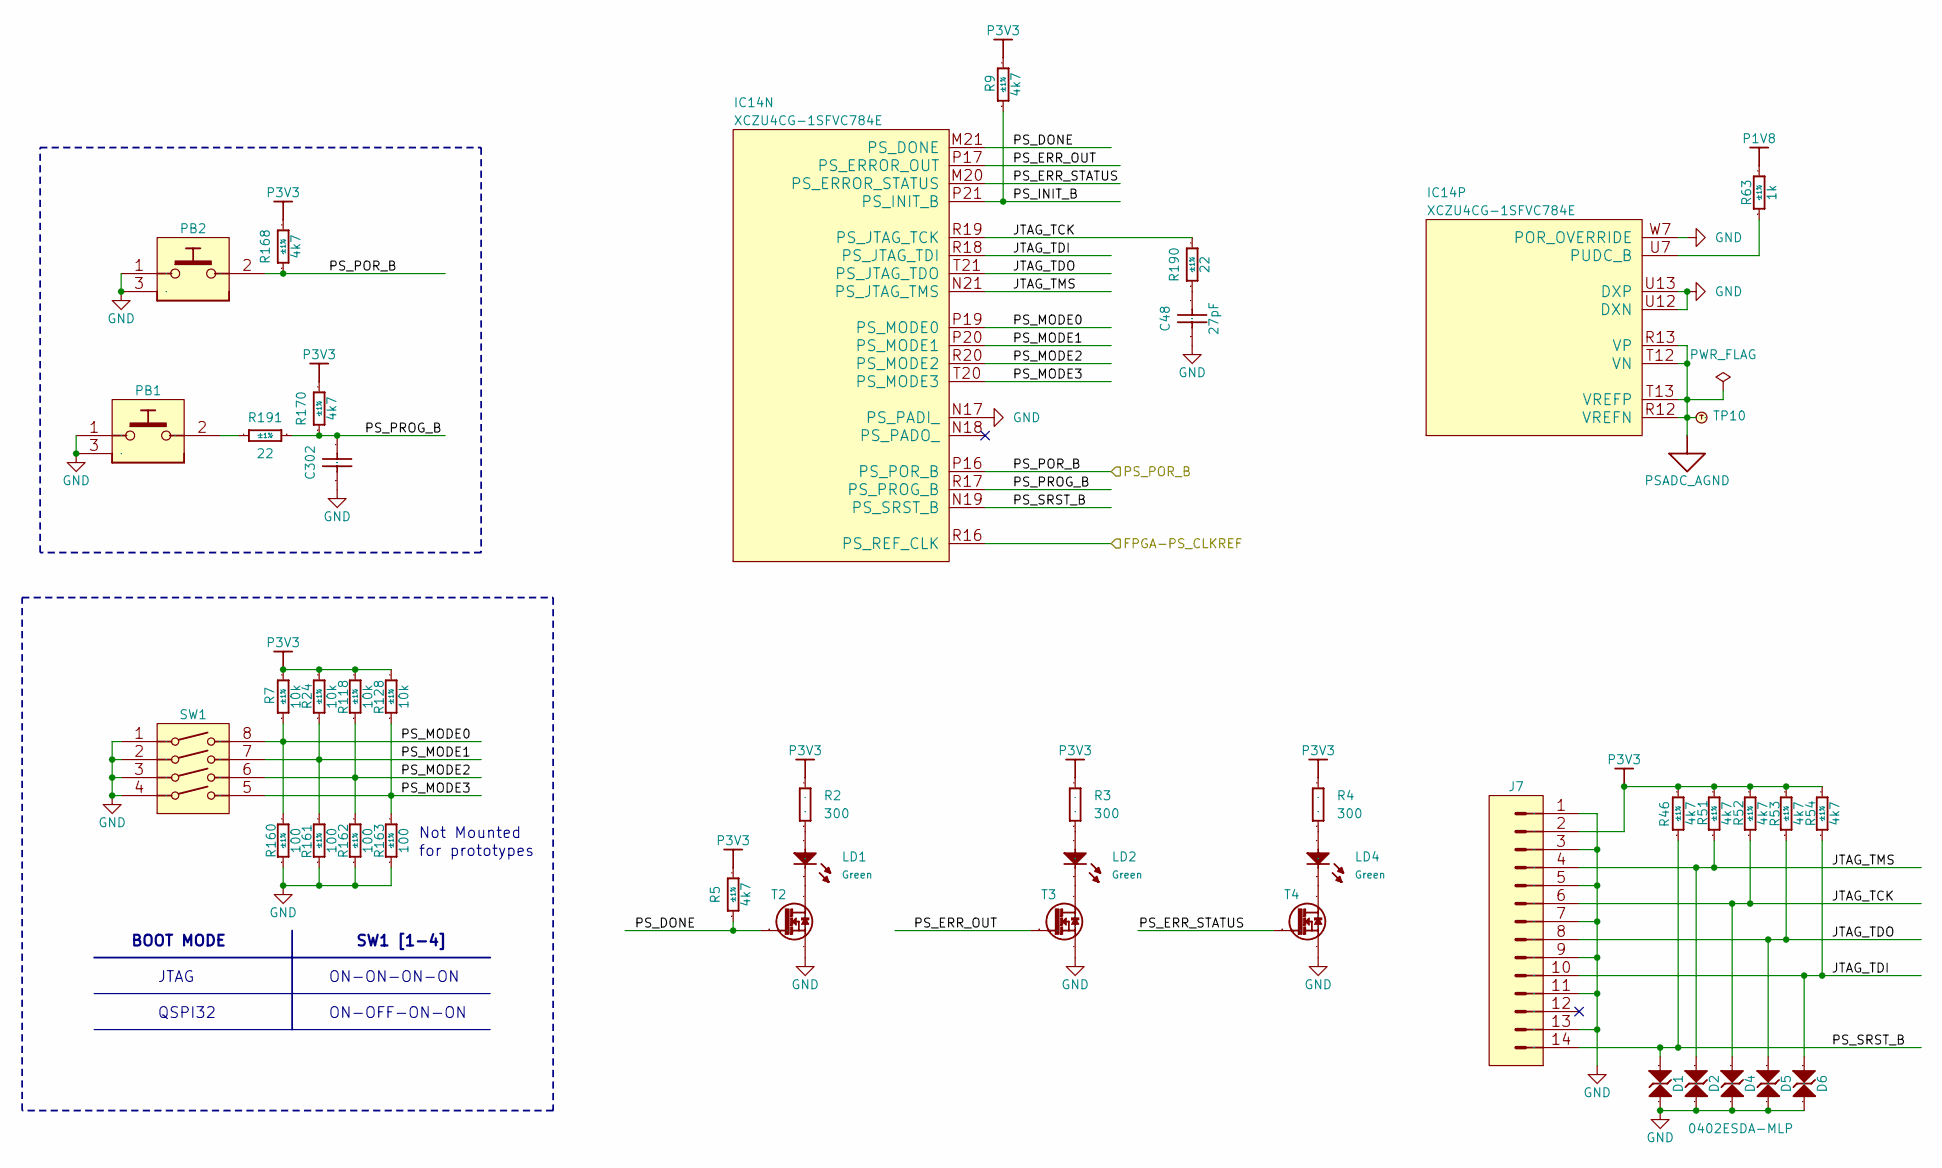
[picture p5: schematic fpga-config.kicad_sch]

Parts:
C48: CC0402_27PF_50V_5%_C0G; CAPC1005X55N; Voltage 50V; Tolerance ±5%; Part Number CC0402_27PF_50V_5%_C0G
C302: CC0402_100NF_16V_10%_X7R; CAPC1005X55N; Voltage 16V; Tolerance ±10%; Part Number CC0402_100NF_16V_10%_X7R
D1, D2, D4, D5, D6: 0402ESDA-MLP; EATON_0402ESDA-MLP; Voltage 8kV; Part Number 0402ESDA-MLP
IC14: XCZU4CG-1SFVC784E; BGA784C80P28X28_2300X2300X332; Part Number XCZU4CG-1SFVC784E
J7: MOLEX_87832-1420; Part Number MOLEX_87832-1420
LD1, LD2, LD4: LED_KINGBRIGHT_KPH-1608CGCK; Part Number LED_KINGBRIGHT_KPH-1608CGCK
PB1, PB2: PB_OMRON_B3U-1100P; Part Number PB_OMRON_B3U-1100P
R2, R3, R4: R0402_300R_1%_0.0625W_100PPM; RESC1005X40N; Tolerance ±1%; Part Number R0402_300R_1%_0.0625W_100PPM
R5, R9, R46, R51, R52, R53, R54, R168, R170: R0402_4K7_1%_0.0625W_100PPM; RESC1005X40N; Tolerance ±1%; Part Number R0402_4K7_1%_0.0625W_100PPM
R7, R24, R118, R128: R0402_10K_1%_0.0625W_100PPM; RESC1005X40N; Tolerance ±1%; Part Number R0402_10K_1%_0.0625W_100PPM
R63: R0402_1K_1%_0.0625W_100PPM; RESC1005X40N; Tolerance ±1%; Part Number R0402_1K_1%_0.0625W_100PPM
R160, R161, R162, R163: R0402_100R_1%_0.0625W_100PPM; RESC1005X40N; Tolerance ±1%; Part Number R0402_100R_1%_0.0625W_100PPM
R190, R191: R0402_22R_1%_0.0625W_100PPM; RESC1005X40N; Tolerance ±1%; Part Number R0402_22R_1%_0.0625W_100PPM
SW1: SW_TYCO_1571983-4; Part Number SW_TYCO_1571983-4
T2, T3, T4: BSS138LT1G; SOT95P240X110-3N; Part Number BSS138LT1G
TP10: Tomachie_TP_E; TPS127

Connections:
FPGA-PS_CLKREF: IC14.R16 (PS_REF_CLK)
GND: C48.1, C302.1, D1.2, D2.2, D4.2, D5.2, D6.2, IC14.N17 (PS_PADI_), IC14.U12 (DXN), IC14.U13 (DXP), IC14.W7 (POR_OVERRIDE), J7.1, J7.3, J7.5, J7.7, J7.9, J7.11, J7.13, PB1.1, PB1.3, PB2.1, PB2.3, R160.1, R161.1, R162.1, R163.1, SW1.1, SW1.2, SW1.3, SW1.4, T2.2 (S), T3.2 (S), T4.2 (S)
JTAG_TCK: D4.1, IC14.R19 (PS_JTAG_TCK), J7.6, R52.1, R190.2
JTAG_TDI: D6.1, IC14.R18 (PS_JTAG_TDI), J7.10, R54.1
JTAG_TDO: D5.1, IC14.T21 (PS_JTAG_TDO), J7.8, R53.1
JTAG_TMS: D2.1, IC14.N21 (PS_JTAG_TMS), J7.4, R51.1
unnamed: C48.2, R190.1
unnamed: IC14.U7 (PUDC_B), R63.1
unnamed: LD1.1 (C), T2.3 (D)
unnamed: LD1.2 (A), R2.1
unnamed: LD2.1 (C), T3.3 (D)
unnamed: LD2.2 (A), R3.1
unnamed: LD4.1 (C), T4.3 (D)
unnamed: LD4.2 (A), R4.1
unnamed: PB1.2, R191.2
P1V8: R63.2
P3V3: J7.2, R2.2, R3.2, R4.2, R5.2, R7.2, R9.2, R24.2, R46.2, R51.2, R52.2, R53.2, R54.2, R118.2, R128.2, R168.2, R170.2
PSADC_AGND: IC14.R12 (VREFN), IC14.R13 (VP), IC14.T12 (VN), IC14.T13 (VREFP), TP10.1
PS_DONE: IC14.M21 (PS_DONE), R5.1, T2.1 (G)
PS_ERR_OUT: IC14.P17 (PS_ERROR_OUT), T3.1 (G)
PS_ERR_STATUS: IC14.M20 (PS_ERROR_STATUS), T4.1 (G)
PS_INIT_B: IC14.P21 (PS_INIT_B), R9.1
PS_MODE0: IC14.P19 (PS_MODE0), R7.1, R160.2, SW1.8
PS_MODE1: IC14.P20 (PS_MODE1), R24.1, R161.2, SW1.7
PS_MODE2: IC14.R20 (PS_MODE2), R118.1, R162.2, SW1.6
PS_MODE3: IC14.T20 (PS_MODE3), R128.1, R163.2, SW1.5
PS_POR_B: IC14.P16 (PS_POR_B), PB2.2, R168.1
PS_PROG_B: C302.2, IC14.R17 (PS_PROG_B), R170.1, R191.1
PS_SRST_B: D1.1, IC14.N19 (PS_SRST_B), J7.14, R46.1

Notes on the sheet:
ON-ON-ON-ON
for prototypes
Not Mounted
BOOT MODE
JTAG
ON-OFF-ON-ON
QSPI32
SW1 [1-4]
