ttrain4086-cpu/Kicad-VME-Wren-Update/fpga-hd-banks.kicad_sch

## KiCad design fpga-hd-banks.kicad_sch (2026-05-15)

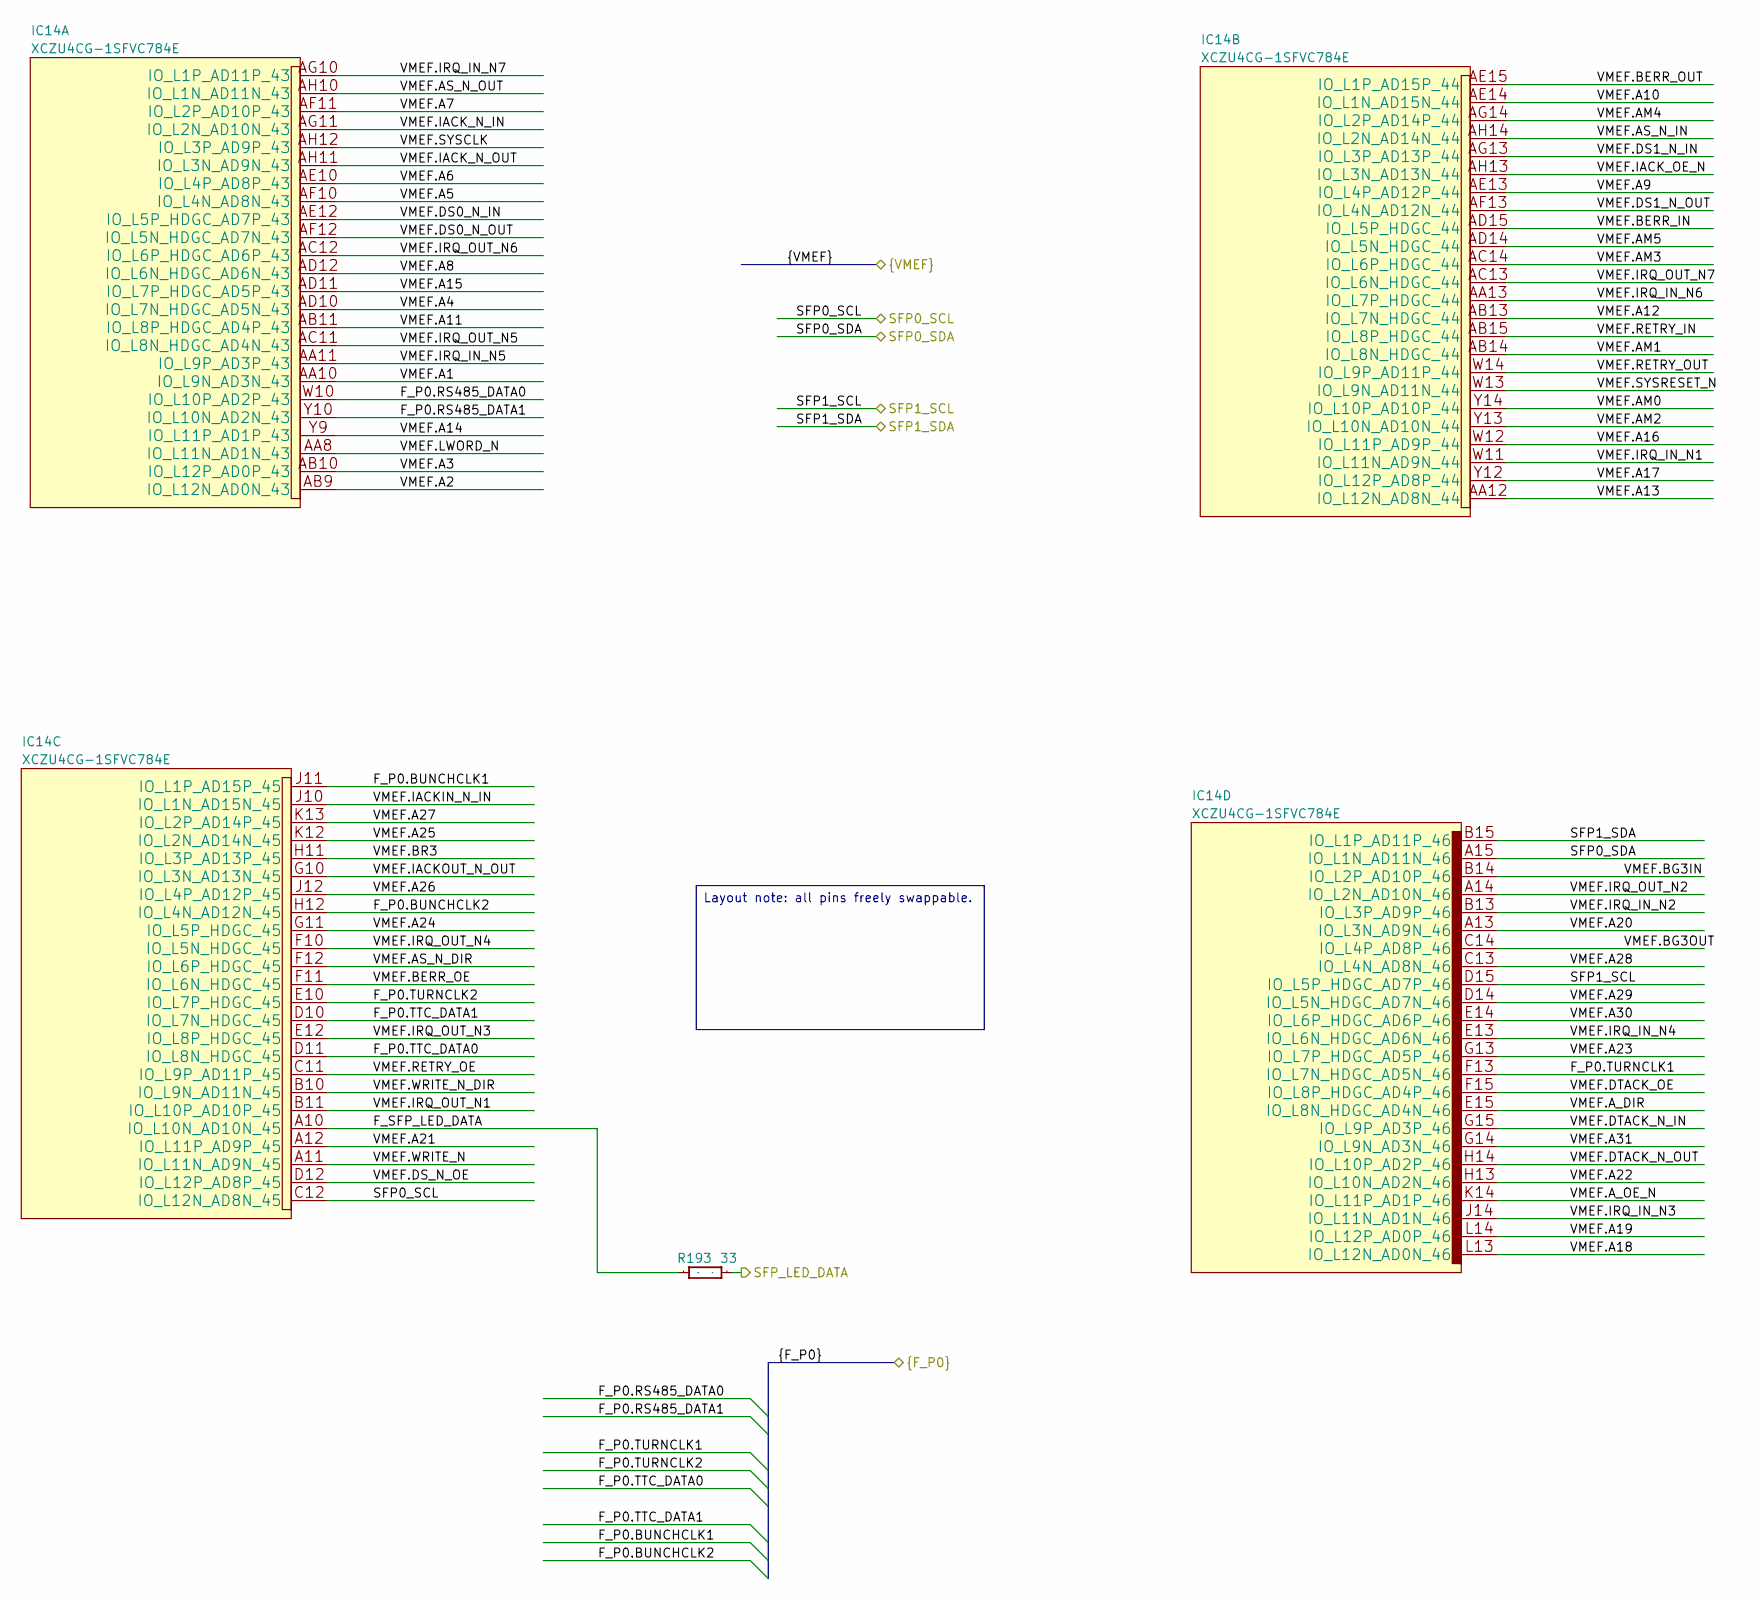
[picture p6: schematic fpga-hd-banks.kicad_sch]

Parts:
IC14: XCZU4CG-1SFVC784E; BGA784C80P28X28_2300X2300X332; Part Number XCZU4CG-1SFVC784E
R193: R0402_33R_1%_0.0625W_100PPM; RESC1005X40N; Tolerance ±1%; Part Number R0402_33R_1%_0.0625W_100PPM

Connections:
F_P0.BUNCHCLK1: IC14.J11 (IO_L1P_AD15P_45)
F_P0.BUNCHCLK2: IC14.H12 (IO_L4N_AD12N_45)
F_P0.RS485_DATA0: IC14.W10 (IO_L10P_AD2P_43)
F_P0.RS485_DATA1: IC14.Y10 (IO_L10N_AD2N_43)
F_P0.TTC_DATA0: IC14.D11 (IO_L8N_HDGC_45)
F_P0.TTC_DATA1: IC14.D10 (IO_L7N_HDGC_45)
F_P0.TURNCLK1: IC14.F13 (IO_L7N_HDGC_AD5N_46)
F_P0.TURNCLK2: IC14.E10 (IO_L7P_HDGC_45)
F_SFP_LED_DATA: IC14.A10 (IO_L10N_AD10N_45), R193.1
SFP0_SCL: IC14.C12 (IO_L12N_AD8N_45)
SFP0_SDA: IC14.A15 (IO_L1N_AD11N_46)
SFP1_SCL: IC14.D15 (IO_L5P_HDGC_AD7P_46)
SFP1_SDA: IC14.B15 (IO_L1P_AD11P_46)
SFP_LED_DATA: R193.2
VMEF.A1: IC14.AA10 (IO_L9N_AD3N_43)
VMEF.A2: IC14.AB9 (IO_L12N_AD0N_43)
VMEF.A3: IC14.AB10 (IO_L12P_AD0P_43)
VMEF.A4: IC14.AD10 (IO_L7N_HDGC_AD5N_43)
VMEF.A5: IC14.AF10 (IO_L4N_AD8N_43)
VMEF.A6: IC14.AE10 (IO_L4P_AD8P_43)
VMEF.A7: IC14.AF11 (IO_L2P_AD10P_43)
VMEF.A8: IC14.AD12 (IO_L6N_HDGC_AD6N_43)
VMEF.A9: IC14.AE13 (IO_L4P_AD12P_44)
VMEF.A10: IC14.AE14 (IO_L1N_AD15N_44)
VMEF.A11: IC14.AB11 (IO_L8P_HDGC_AD4P_43)
VMEF.A12: IC14.AB13 (IO_L7N_HDGC_44)
VMEF.A13: IC14.AA12 (IO_L12N_AD8N_44)
VMEF.A14: IC14.Y9 (IO_L11P_AD1P_43)
VMEF.A15: IC14.AD11 (IO_L7P_HDGC_AD5P_43)
VMEF.A16: IC14.W12 (IO_L11P_AD9P_44)
VMEF.A17: IC14.Y12 (IO_L12P_AD8P_44)
VMEF.A18: IC14.L13 (IO_L12N_AD0N_46)
VMEF.A19: IC14.L14 (IO_L12P_AD0P_46)
VMEF.A20: IC14.A13 (IO_L3N_AD9N_46)
VMEF.A21: IC14.A12 (IO_L11P_AD9P_45)
VMEF.A22: IC14.H13 (IO_L10N_AD2N_46)
VMEF.A23: IC14.G13 (IO_L7P_HDGC_AD5P_46)
VMEF.A24: IC14.G11 (IO_L5P_HDGC_45)
VMEF.A25: IC14.K12 (IO_L2N_AD14N_45)
VMEF.A26: IC14.J12 (IO_L4P_AD12P_45)
VMEF.A27: IC14.K13 (IO_L2P_AD14P_45)
VMEF.A28: IC14.C13 (IO_L4N_AD8N_46)
VMEF.A29: IC14.D14 (IO_L5N_HDGC_AD7N_46)
VMEF.A30: IC14.E14 (IO_L6P_HDGC_AD6P_46)
VMEF.A31: IC14.G14 (IO_L9N_AD3N_46)
VMEF.AM0: IC14.Y14 (IO_L10P_AD10P_44)
VMEF.AM1: IC14.AB14 (IO_L8N_HDGC_44)
VMEF.AM2: IC14.Y13 (IO_L10N_AD10N_44)
VMEF.AM3: IC14.AC14 (IO_L6P_HDGC_44)
VMEF.AM4: IC14.AG14 (IO_L2P_AD14P_44)
VMEF.AM5: IC14.AD14 (IO_L5N_HDGC_44)
VMEF.AS_N_DIR: IC14.F12 (IO_L6P_HDGC_45)
VMEF.AS_N_IN: IC14.AH14 (IO_L2N_AD14N_44)
VMEF.AS_N_OUT: IC14.AH10 (IO_L1N_AD11N_43)
VMEF.A_DIR: IC14.E15 (IO_L8N_HDGC_AD4N_46)
VMEF.A_OE_N: IC14.K14 (IO_L11P_AD1P_46)
VMEF.BERR_IN: IC14.AD15 (IO_L5P_HDGC_44)
VMEF.BERR_OE: IC14.F11 (IO_L6N_HDGC_45)
VMEF.BERR_OUT: IC14.AE15 (IO_L1P_AD15P_44)
VMEF.BG3IN: IC14.B14 (IO_L2P_AD10P_46)
VMEF.BG3OUT: IC14.C14 (IO_L4P_AD8P_46)
VMEF.BR3: IC14.H11 (IO_L3P_AD13P_45)
VMEF.DS0_N_IN: IC14.AE12 (IO_L5P_HDGC_AD7P_43)
VMEF.DS0_N_OUT: IC14.AF12 (IO_L5N_HDGC_AD7N_43)
VMEF.DS1_N_IN: IC14.AG13 (IO_L3P_AD13P_44)
VMEF.DS1_N_OUT: IC14.AF13 (IO_L4N_AD12N_44)
VMEF.DS_N_OE: IC14.D12 (IO_L12P_AD8P_45)
VMEF.DTACK_N_IN: IC14.G15 (IO_L9P_AD3P_46)
VMEF.DTACK_N_OUT: IC14.H14 (IO_L10P_AD2P_46)
VMEF.DTACK_OE: IC14.F15 (IO_L8P_HDGC_AD4P_46)
VMEF.IACKIN_N_IN: IC14.J10 (IO_L1N_AD15N_45)
VMEF.IACKOUT_N_OUT: IC14.G10 (IO_L3N_AD13N_45)
VMEF.IACK_N_IN: IC14.AG11 (IO_L2N_AD10N_43)
VMEF.IACK_N_OUT: IC14.AH11 (IO_L3N_AD9N_43)
VMEF.IACK_OE_N: IC14.AH13 (IO_L3N_AD13N_44)
VMEF.IRQ_IN_N1: IC14.W11 (IO_L11N_AD9N_44)
VMEF.IRQ_IN_N2: IC14.B13 (IO_L3P_AD9P_46)
VMEF.IRQ_IN_N3: IC14.J14 (IO_L11N_AD1N_46)
VMEF.IRQ_IN_N4: IC14.E13 (IO_L6N_HDGC_AD6N_46)
VMEF.IRQ_IN_N5: IC14.AA11 (IO_L9P_AD3P_43)
VMEF.IRQ_IN_N6: IC14.AA13 (IO_L7P_HDGC_44)
VMEF.IRQ_IN_N7: IC14.AG10 (IO_L1P_AD11P_43)
VMEF.IRQ_OUT_N1: IC14.B11 (IO_L10P_AD10P_45)
VMEF.IRQ_OUT_N2: IC14.A14 (IO_L2N_AD10N_46)
VMEF.IRQ_OUT_N3: IC14.E12 (IO_L8P_HDGC_45)
VMEF.IRQ_OUT_N4: IC14.F10 (IO_L5N_HDGC_45)
VMEF.IRQ_OUT_N5: IC14.AC11 (IO_L8N_HDGC_AD4N_43)
VMEF.IRQ_OUT_N6: IC14.AC12 (IO_L6P_HDGC_AD6P_43)
VMEF.IRQ_OUT_N7: IC14.AC13 (IO_L6N_HDGC_44)
VMEF.LWORD_N: IC14.AA8 (IO_L11N_AD1N_43)
VMEF.RETRY_IN: IC14.AB15 (IO_L8P_HDGC_44)
VMEF.RETRY_OE: IC14.C11 (IO_L9P_AD11P_45)
VMEF.RETRY_OUT: IC14.W14 (IO_L9P_AD11P_44)
VMEF.SYSCLK: IC14.AH12 (IO_L3P_AD9P_43)
VMEF.SYSRESET_N: IC14.W13 (IO_L9N_AD11N_44)
VMEF.WRITE_N: IC14.A11 (IO_L11N_AD9N_45)
VMEF.WRITE_N_DIR: IC14.B10 (IO_L9N_AD11N_45)

Notes on the sheet:
Layout note: all pins freely swappable.
