ttrain4086-cpu/Kicad-VME-Wren-Update/fpga-hp-banks.kicad_sch

## KiCad design fpga-hp-banks.kicad_sch (2026-05-15)

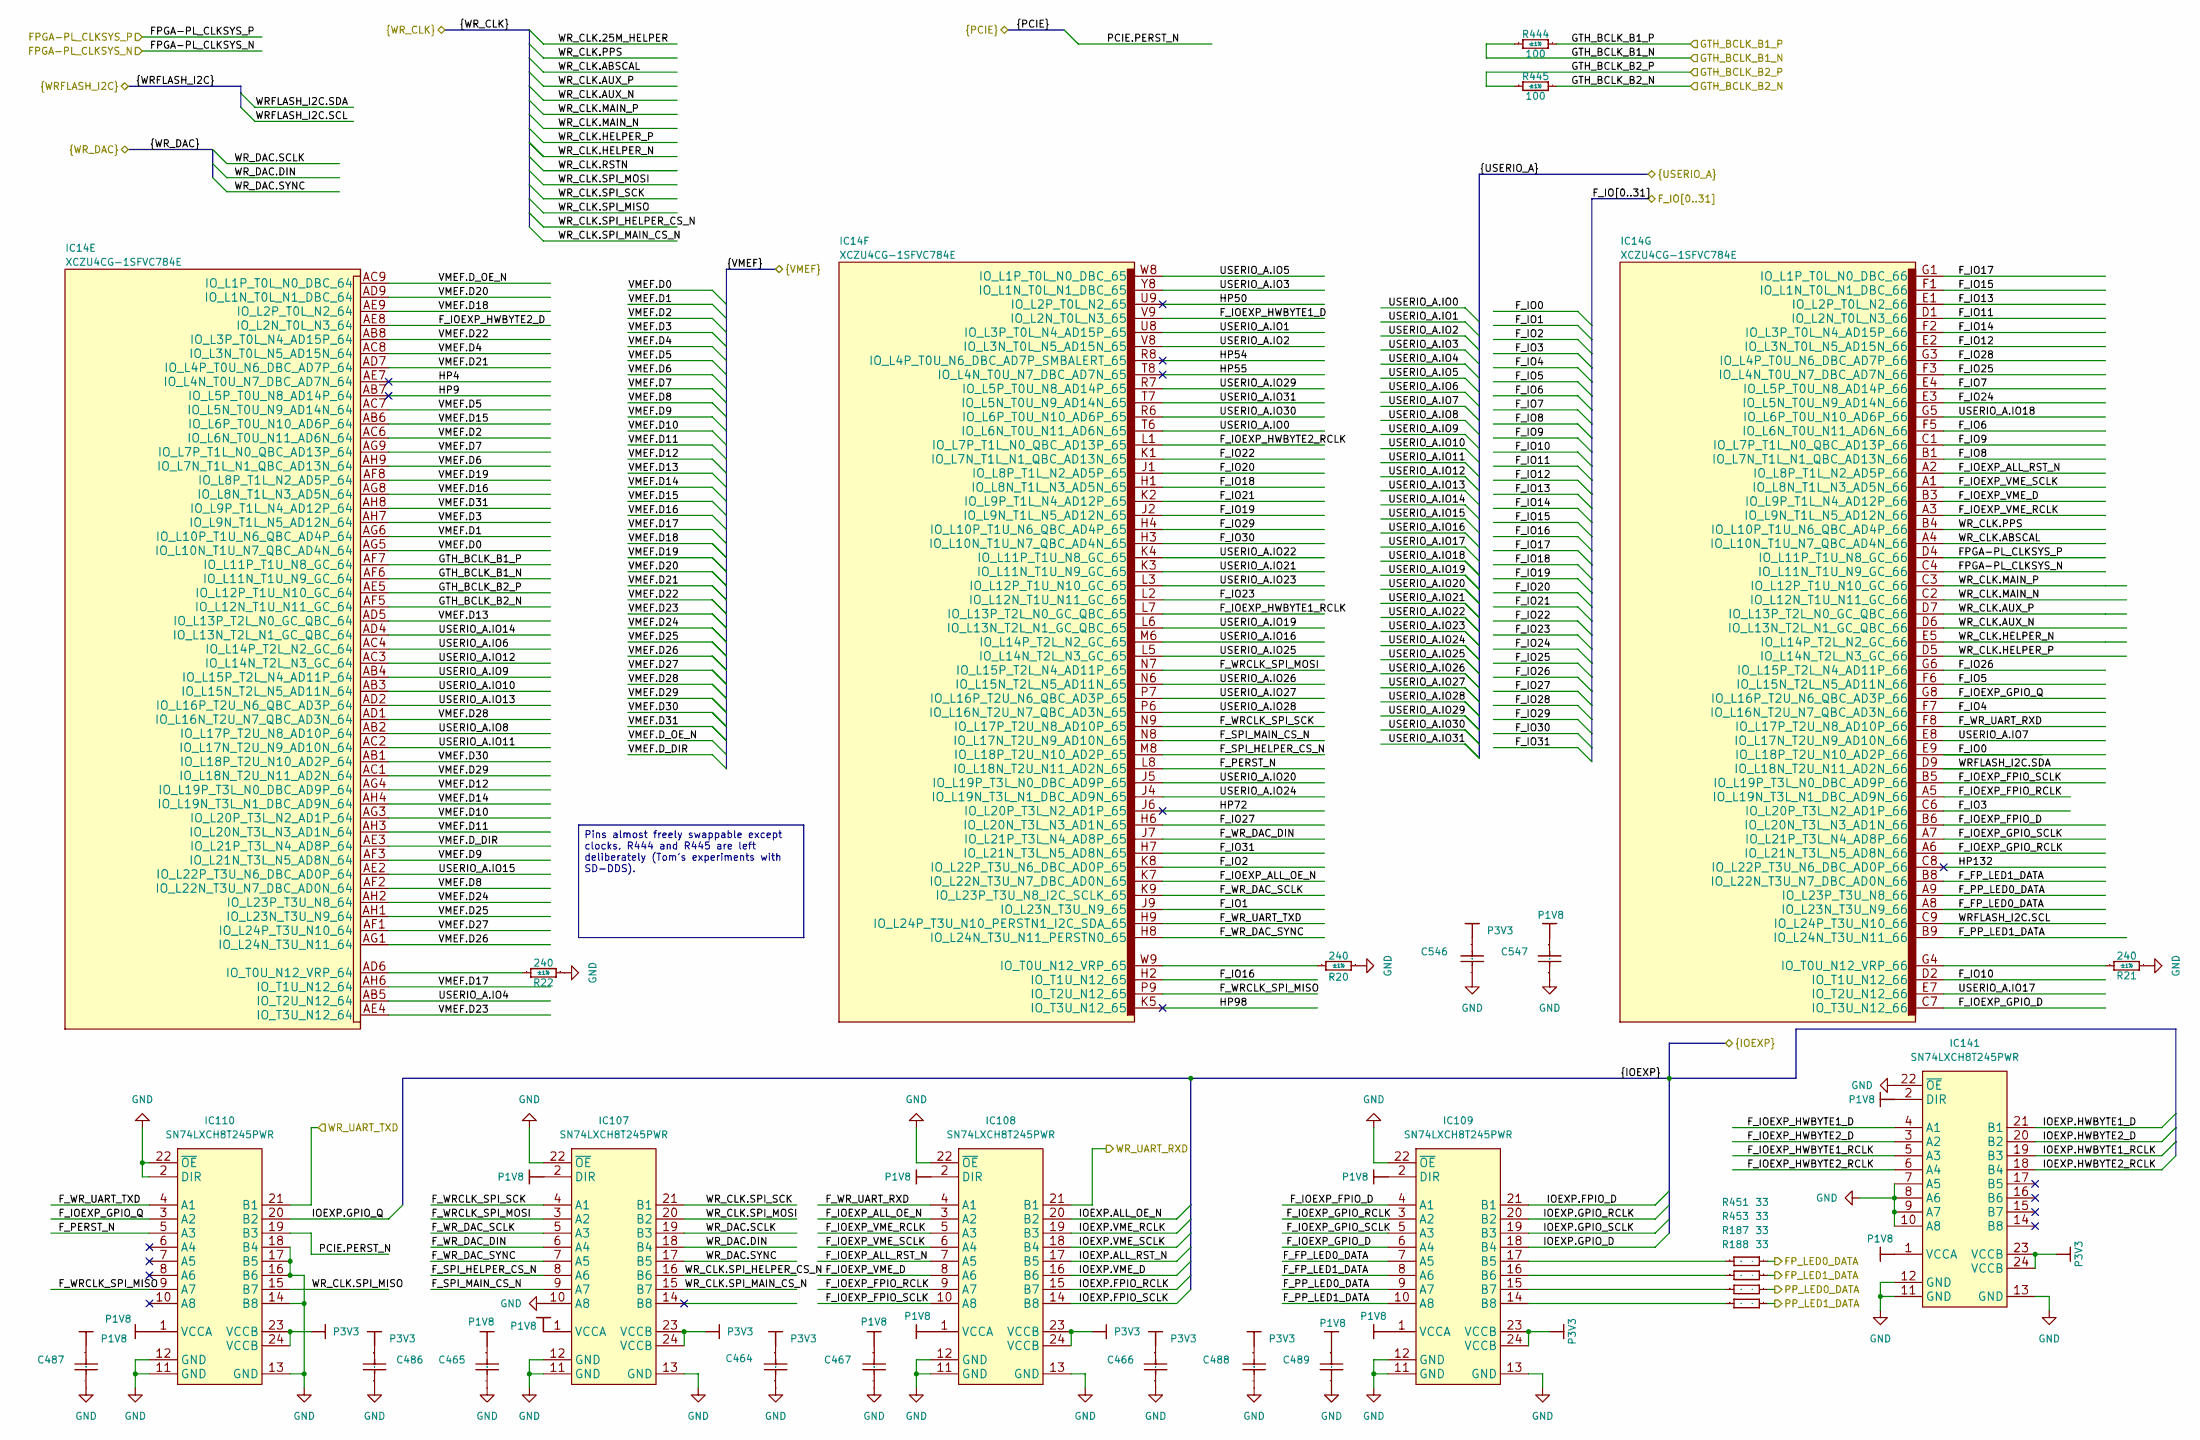
[picture p7: schematic fpga-hp-banks.kicad_sch]

Parts:
C464, C465, C466, C467, C486, C487, C488, C489, C546, C547: CC0402_100NF_16V_10%_X7R; CAPC1005X55N; Voltage 16V; Tolerance ±10%; Part Number CC0402_100NF_16V_10%_X7R
IC14: XCZU4CG-1SFVC784E; BGA784C80P28X28_2300X2300X332; Part Number XCZU4CG-1SFVC784E
IC107, IC108, IC109, IC110, IC141: SN74LXCH8T245PWR; SOP65P640X120-24N
R20, R21, R22: R0402_240R_1%_0.0625W_100PPM; RESC1005X40N; Tolerance ±1%; Part Number R0402_240R_1%_0.0625W_100PPM
R187, R188, R451, R453: R0402_33R_1%_0.0625W_100PPM; RESC1005X40N; Tolerance ±1%; Part Number R0402_33R_1%_0.0625W_100PPM
R444, R445: R0402_100R_1%_0.0625W_100PPM; RESC1005X40N; Tolerance ±1%; Part Number R0402_100R_1%_0.0625W_100PPM

Connections:
FPGA-PL_CLKSYS_N: IC14.C4 (IO_L11N_T1U_N9_GC_66)
FPGA-PL_CLKSYS_P: IC14.D4 (IO_L11P_T1U_N8_GC_66)
FP_LED0_DATA: R451.2
FP_LED1_DATA: R453.2
F_FP_LED0_DATA: IC14.A8 (IO_L23N_T3U_N9_66), IC109.7 (A5)
F_FP_LED1_DATA: IC14.B8 (IO_L22N_T3U_N7_DBC_AD0N_66), IC109.8 (A6)
F_IO0: IC14.E9 (IO_L18P_T2U_N10_AD2P_66)
F_IO1: IC14.J9 (IO_L23N_T3U_N9_65)
F_IO2: IC14.K8 (IO_L22P_T3U_N6_DBC_AD0P_65)
F_IO3: IC14.C6 (IO_L20P_T3L_N2_AD1P_66)
F_IO4: IC14.F7 (IO_L16N_T2U_N7_QBC_AD3N_66)
F_IO5: IC14.F6 (IO_L15N_T2L_N5_AD11N_66)
F_IO6: IC14.F5 (IO_L6N_T0U_N11_AD6N_66)
F_IO7: IC14.E4 (IO_L5P_T0U_N8_AD14P_66)
F_IO8: IC14.B1 (IO_L7N_T1L_N1_QBC_AD13N_66)
F_IO9: IC14.C1 (IO_L7P_T1L_N0_QBC_AD13P_66)
F_IO10: IC14.D2 (IO_T1U_N12_66)
F_IO11: IC14.D1 (IO_L2N_T0L_N3_66)
F_IO12: IC14.E2 (IO_L3N_T0L_N5_AD15N_66)
F_IO13: IC14.E1 (IO_L2P_T0L_N2_66)
F_IO14: IC14.F2 (IO_L3P_T0L_N4_AD15P_66)
F_IO15: IC14.F1 (IO_L1N_T0L_N1_DBC_66)
F_IO16: IC14.H2 (IO_T1U_N12_65)
F_IO17: IC14.G1 (IO_L1P_T0L_N0_DBC_66)
F_IO18: IC14.H1 (IO_L8N_T1L_N3_AD5N_65)
F_IO19: IC14.J2 (IO_L9N_T1L_N5_AD12N_65)
F_IO20: IC14.J1 (IO_L8P_T1L_N2_AD5P_65)
F_IO21: IC14.K2 (IO_L9P_T1L_N4_AD12P_65)
F_IO22: IC14.K1 (IO_L7N_T1L_N1_QBC_AD13N_65)
F_IO23: IC14.L2 (IO_L12N_T1U_N11_GC_65)
F_IO24: IC14.E3 (IO_L5N_T0U_N9_AD14N_66)
F_IO25: IC14.F3 (IO_L4N_T0U_N7_DBC_AD7N_66)
F_IO26: IC14.G6 (IO_L15P_T2L_N4_AD11P_66)
F_IO27: IC14.H6 (IO_L20N_T3L_N3_AD1N_65)
F_IO28: IC14.G3 (IO_L4P_T0U_N6_DBC_AD7P_66)
F_IO29: IC14.H4 (IO_L10P_T1U_N6_QBC_AD4P_65)
F_IO30: IC14.H3 (IO_L10N_T1U_N7_QBC_AD4N_65)
F_IO31: IC14.H7 (IO_L21N_T3L_N5_AD8N_65)
F_IOEXP_ALL_OE_N: IC14.K7 (IO_L22N_T3U_N7_DBC_AD0N_65), IC108.3 (A2)
F_IOEXP_ALL_RST_N: IC14.A2 (IO_L8P_T1L_N2_AD5P_66), IC108.7 (A5)
F_IOEXP_FPIO_D: IC14.B6 (IO_L20N_T3L_N3_AD1N_66), IC109.4 (A1)
F_IOEXP_FPIO_RCLK: IC14.A5 (IO_L19N_T3L_N1_DBC_AD9N_66), IC108.9 (A7)
F_IOEXP_FPIO_SCLK: IC14.B5 (IO_L19P_T3L_N0_DBC_AD9P_66), IC108.10 (A8)
F_IOEXP_GPIO_D: IC14.C7 (IO_T3U_N12_66), IC109.6 (A4)
F_IOEXP_GPIO_Q: IC14.G8 (IO_L16P_T2U_N6_QBC_AD3P_66), IC110.3 (A2)
F_IOEXP_GPIO_RCLK: IC14.A6 (IO_L21N_T3L_N5_AD8N_66), IC109.3 (A2)
F_IOEXP_GPIO_SCLK: IC14.A7 (IO_L21P_T3L_N4_AD8P_66), IC109.5 (A3)
F_IOEXP_HWBYTE1_D: IC14.V9 (IO_L2N_T0L_N3_65), IC141.4 (A1)
F_IOEXP_HWBYTE1_RCLK: IC14.L7 (IO_L13P_T2L_N0_GC_QBC_65), IC141.5 (A3)
F_IOEXP_HWBYTE2_D: IC14.AE8 (IO_L2N_T0L_N3_64), IC141.3 (A2)
F_IOEXP_HWBYTE2_RCLK: IC14.L1 (IO_L7P_T1L_N0_QBC_AD13P_65), IC141.6 (A4)
F_IOEXP_VME_D: IC14.B3 (IO_L9P_T1L_N4_AD12P_66), IC108.8 (A6)
F_IOEXP_VME_RCLK: IC14.A3 (IO_L9N_T1L_N5_AD12N_66), IC108.5 (A3)
F_IOEXP_VME_SCLK: IC14.A1 (IO_L8N_T1L_N3_AD5N_66), IC108.6 (A4)
F_PERST_N: IC14.L8 (IO_L18N_T2U_N11_AD2N_65), IC110.5 (A3)
F_PP_LED0_DATA: IC14.A9 (IO_L23P_T3U_N8_66), IC109.9 (A7)
F_PP_LED1_DATA: IC14.B9 (IO_L24N_T3U_N11_66), IC109.10 (A8)
F_SPI_HELPER_CS_N: IC14.M8 (IO_L18P_T2U_N10_AD2P_65), IC107.8 (A6)
F_SPI_MAIN_CS_N: IC14.N8 (IO_L17N_T2U_N9_AD10N_65), IC107.9 (A7)
F_WRCLK_SPI_MISO: IC14.P9 (IO_T2U_N12_65), IC110.9 (A7)
F_WRCLK_SPI_MOSI: IC14.N7 (IO_L15P_T2L_N4_AD11P_65), IC107.3 (A2)
F_WRCLK_SPI_SCK: IC14.N9 (IO_L17P_T2U_N8_AD10P_65), IC107.4 (A1)
F_WR_DAC_DIN: IC14.J7 (IO_L21P_T3L_N4_AD8P_65), IC107.6 (A4)
F_WR_DAC_SCLK: IC14.K9 (IO_L23P_T3U_N8_I2C_SCLK_65), IC107.5 (A3)
F_WR_DAC_SYNC: IC14.H8 (IO_L24N_T3U_N11_PERSTN0_65), IC107.7 (A5)
F_WR_UART_RXD: IC14.F8 (IO_L17P_T2U_N8_AD10P_66), IC108.4 (A1)
F_WR_UART_TXD: IC14.H9 (IO_L24P_T3U_N10_PERSTN1_I2C_SDA_65), IC110.4 (A1)
GND: C464.2, C465.2, C466.2, C467.2, C486.2, C487.2, C488.2, C489.2, C546.2, C547.2, IC107.10 (A8), IC107.11 (GND), IC107.12 (GND), IC107.13 (GND), IC107.22 (~OE), IC108.11 (GND), IC108.12 (GND), IC108.13 (GND), IC108.22 (~OE), IC109.11 (GND), IC109.12 (GND), IC109.13 (GND), IC109.22 (~OE), IC110.2 (DIR), IC110.11 (GND), IC110.12 (GND), IC110.13 (GND), IC110.14 (B8), IC110.16 (B6), IC110.17 (B5), IC110.18 (B4), IC110.22 (~OE), IC141.7 (A5), IC141.8 (A6), IC141.9 (A7), IC141.10 (A8), IC141.11 (GND), IC141.12 (GND), IC141.13 (GND), IC141.22 (~OE), R20.1, R21.1, R22.1
GTH_BCLK_B1_N: IC14.AF6 (IO_L11N_T1U_N9_GC_64), R444.1
GTH_BCLK_B1_P: IC14.AF7 (IO_L11P_T1U_N8_GC_64), R444.2
GTH_BCLK_B2_N: IC14.AF5 (IO_L12N_T1U_N11_GC_64), R445.2
GTH_BCLK_B2_P: IC14.AE5 (IO_L12P_T1U_N10_GC_64), R445.1
HP4: IC14.AE7 (IO_L4N_T0U_N7_DBC_AD7N_64)
HP9: IC14.AB7 (IO_L5P_T0U_N8_AD14P_64)
HP50: IC14.U9 (IO_L2P_T0L_N2_65)
HP54: IC14.R8 (IO_L4P_T0U_N6_DBC_AD7P_SMBALERT_65)
HP55: IC14.T8 (IO_L4N_T0U_N7_DBC_AD7N_65)
HP72: IC14.J6 (IO_L20P_T3L_N2_AD1P_65)
HP98: IC14.K5 (IO_T3U_N12_65)
HP132: IC14.C8 (IO_L22P_T3U_N6_DBC_AD0P_66)
IOEXP.ALL_OE_N: IC108.20 (B2)
IOEXP.ALL_RST_N: IC108.17 (B5)
IOEXP.FPIO_D: IC109.21 (B1)
IOEXP.FPIO_RCLK: IC108.15 (B7)
IOEXP.FPIO_SCLK: IC108.14 (B8)
IOEXP.GPIO_D: IC109.18 (B4)
IOEXP.GPIO_Q: IC110.20 (B2)
IOEXP.GPIO_RCLK: IC109.20 (B2)
IOEXP.GPIO_SCLK: IC109.19 (B3)
IOEXP.HWBYTE1_D: IC141.21 (B1)
IOEXP.HWBYTE1_RCLK: IC141.19 (B3)
IOEXP.HWBYTE2_D: IC141.20 (B2)
IOEXP.HWBYTE2_RCLK: IC141.18 (B4)
IOEXP.VME_D: IC108.16 (B6)
IOEXP.VME_RCLK: IC108.19 (B3)
IOEXP.VME_SCLK: IC108.18 (B4)
unnamed: IC14.AD6 (IO_T0U_N12_VRP_64), R22.2
unnamed: IC14.G4 (IO_T0U_N12_VRP_66), R21.2
unnamed: IC14.W9 (IO_T0U_N12_VRP_65), R20.2
unnamed: IC109.14 (B8), R188.1
unnamed: IC109.15 (B7), R187.1
unnamed: IC109.16 (B6), R453.1
unnamed: IC109.17 (B5), R451.1
P1V8: C465.1, C467.1, C487.1, C489.1, C547.1, IC107.1 (VCCA), IC107.2 (DIR), IC108.1 (VCCA), IC108.2 (DIR), IC109.1 (VCCA), IC109.2 (DIR), IC110.1 (VCCA), IC141.1 (VCCA), IC141.2 (DIR)
P3V3: C464.1, C466.1, C486.1, C488.1, C546.1, IC107.23 (VCCB), IC107.24 (VCCB), IC108.23 (VCCB), IC108.24 (VCCB), IC109.23 (VCCB), IC109.24 (VCCB), IC110.23 (VCCB), IC110.24 (VCCB), IC141.23 (VCCB), IC141.24 (VCCB)
PCIE.PERST_N: IC110.19 (B3)
PP_LED0_DATA: R187.2
PP_LED1_DATA: R188.2
USERIO_A.IO0: IC14.T6 (IO_L6N_T0U_N11_AD6N_65)
USERIO_A.IO1: IC14.U8 (IO_L3P_T0L_N4_AD15P_65)
USERIO_A.IO2: IC14.V8 (IO_L3N_T0L_N5_AD15N_65)
USERIO_A.IO3: IC14.Y8 (IO_L1N_T0L_N1_DBC_65)
USERIO_A.IO4: IC14.AB5 (IO_T2U_N12_64)
USERIO_A.IO5: IC14.W8 (IO_L1P_T0L_N0_DBC_65)
USERIO_A.IO6: IC14.AC4 (IO_L14P_T2L_N2_GC_64)
USERIO_A.IO7: IC14.E8 (IO_L17N_T2U_N9_AD10N_66)
USERIO_A.IO8: IC14.AB2 (IO_L17P_T2U_N8_AD10P_64)
USERIO_A.IO9: IC14.AB4 (IO_L15P_T2L_N4_AD11P_64)
USERIO_A.IO10: IC14.AB3 (IO_L15N_T2L_N5_AD11N_64)
USERIO_A.IO11: IC14.AC2 (IO_L17N_T2U_N9_AD10N_64)
USERIO_A.IO12: IC14.AC3 (IO_L14N_T2L_N3_GC_64)
USERIO_A.IO13: IC14.AD2 (IO_L16P_T2U_N6_QBC_AD3P_64)
USERIO_A.IO14: IC14.AD4 (IO_L13N_T2L_N1_GC_QBC_64)
USERIO_A.IO15: IC14.AE2 (IO_L22P_T3U_N6_DBC_AD0P_64)
USERIO_A.IO16: IC14.M6 (IO_L14P_T2L_N2_GC_65)
USERIO_A.IO17: IC14.E7 (IO_T2U_N12_66)
USERIO_A.IO18: IC14.G5 (IO_L6P_T0U_N10_AD6P_66)
USERIO_A.IO19: IC14.L6 (IO_L13N_T2L_N1_GC_QBC_65)
USERIO_A.IO20: IC14.J5 (IO_L19P_T3L_N0_DBC_AD9P_65)
USERIO_A.IO21: IC14.K3 (IO_L11N_T1U_N9_GC_65)
USERIO_A.IO22: IC14.K4 (IO_L11P_T1U_N8_GC_65)
USERIO_A.IO23: IC14.L3 (IO_L12P_T1U_N10_GC_65)
USERIO_A.IO24: IC14.J4 (IO_L19N_T3L_N1_DBC_AD9N_65)
USERIO_A.IO25: IC14.L5 (IO_L14N_T2L_N3_GC_65)
USERIO_A.IO26: IC14.N6 (IO_L15N_T2L_N5_AD11N_65)
USERIO_A.IO27: IC14.P7 (IO_L16P_T2U_N6_QBC_AD3P_65)
USERIO_A.IO28: IC14.P6 (IO_L16N_T2U_N7_QBC_AD3N_65)
USERIO_A.IO29: IC14.R7 (IO_L5P_T0U_N8_AD14P_65)
USERIO_A.IO30: IC14.R6 (IO_L6P_T0U_N10_AD6P_65)
USERIO_A.IO31: IC14.T7 (IO_L5N_T0U_N9_AD14N_65)
VMEF.D0: IC14.AG5 (IO_L10N_T1U_N7_QBC_AD4N_64)
VMEF.D1: IC14.AG6 (IO_L10P_T1U_N6_QBC_AD4P_64)
VMEF.D2: IC14.AC6 (IO_L6N_T0U_N11_AD6N_64)
VMEF.D3: IC14.AH7 (IO_L9N_T1L_N5_AD12N_64)
VMEF.D4: IC14.AC8 (IO_L3N_T0L_N5_AD15N_64)
VMEF.D5: IC14.AC7 (IO_L5N_T0U_N9_AD14N_64)
VMEF.D6: IC14.AH9 (IO_L7N_T1L_N1_QBC_AD13N_64)
VMEF.D7: IC14.AG9 (IO_L7P_T1L_N0_QBC_AD13P_64)
VMEF.D8: IC14.AF2 (IO_L22N_T3U_N7_DBC_AD0N_64)
VMEF.D9: IC14.AF3 (IO_L21N_T3L_N5_AD8N_64)
VMEF.D10: IC14.AG3 (IO_L20P_T3L_N2_AD1P_64)
VMEF.D11: IC14.AH3 (IO_L20N_T3L_N3_AD1N_64)
VMEF.D12: IC14.AG4 (IO_L19P_T3L_N0_DBC_AD9P_64)
VMEF.D13: IC14.AD5 (IO_L13P_T2L_N0_GC_QBC_64)
VMEF.D14: IC14.AH4 (IO_L19N_T3L_N1_DBC_AD9N_64)
VMEF.D15: IC14.AB6 (IO_L6P_T0U_N10_AD6P_64)
VMEF.D16: IC14.AG8 (IO_L8N_T1L_N3_AD5N_64)
VMEF.D17: IC14.AH6 (IO_T1U_N12_64)
VMEF.D18: IC14.AE9 (IO_L2P_T0L_N2_64)
VMEF.D19: IC14.AF8 (IO_L8P_T1L_N2_AD5P_64)
VMEF.D20: IC14.AD9 (IO_L1N_T0L_N1_DBC_64)
VMEF.D21: IC14.AD7 (IO_L4P_T0U_N6_DBC_AD7P_64)
VMEF.D22: IC14.AB8 (IO_L3P_T0L_N4_AD15P_64)
VMEF.D23: IC14.AE4 (IO_T3U_N12_64)
VMEF.D24: IC14.AH2 (IO_L23P_T3U_N8_64)
VMEF.D25: IC14.AH1 (IO_L23N_T3U_N9_64)
VMEF.D26: IC14.AG1 (IO_L24N_T3U_N11_64)
VMEF.D27: IC14.AF1 (IO_L24P_T3U_N10_64)
VMEF.D28: IC14.AD1 (IO_L16N_T2U_N7_QBC_AD3N_64)
VMEF.D29: IC14.AC1 (IO_L18N_T2U_N11_AD2N_64)
VMEF.D30: IC14.AB1 (IO_L18P_T2U_N10_AD2P_64)
VMEF.D31: IC14.AH8 (IO_L9P_T1L_N4_AD12P_64)
VMEF.D_DIR: IC14.AE3 (IO_L21P_T3L_N4_AD8P_64)
VMEF.D_OE_N: IC14.AC9 (IO_L1P_T0L_N0_DBC_64)
WRFLASH_I2C.SCL: IC14.C9 (IO_L24P_T3U_N10_66)
WRFLASH_I2C.SDA: IC14.D9 (IO_L18N_T2U_N11_AD2N_66)
WR_CLK.ABSCAL: IC14.A4 (IO_L10N_T1U_N7_QBC_AD4N_66)
WR_CLK.AUX_N: IC14.D6 (IO_L13N_T2L_N1_GC_QBC_66)
WR_CLK.AUX_P: IC14.D7 (IO_L13P_T2L_N0_GC_QBC_66)
WR_CLK.HELPER_N: IC14.E5 (IO_L14P_T2L_N2_GC_66)
WR_CLK.HELPER_P: IC14.D5 (IO_L14N_T2L_N3_GC_66)
WR_CLK.MAIN_N: IC14.C2 (IO_L12N_T1U_N11_GC_66)
WR_CLK.MAIN_P: IC14.C3 (IO_L12P_T1U_N10_GC_66)
WR_CLK.PPS: IC14.B4 (IO_L10P_T1U_N6_QBC_AD4P_66)
WR_CLK.SPI_HELPER_CS_N: IC107.16 (B6)
WR_CLK.SPI_MAIN_CS_N: IC107.15 (B7)
WR_CLK.SPI_MISO: IC110.15 (B7)
WR_CLK.SPI_MOSI: IC107.20 (B2)
WR_CLK.SPI_SCK: IC107.21 (B1)
WR_DAC.DIN: IC107.18 (B4)
WR_DAC.SCLK: IC107.19 (B3)
WR_DAC.SYNC: IC107.17 (B5)
WR_UART_RXD: IC108.21 (B1)
WR_UART_TXD: IC110.21 (B1)

Notes on the sheet:
Pins almost freely swappable except clocks. R444 and R445 are left deliberately (Tom's experiments with SD-DDS).
