ttrain4086-cpu/Kicad-VME-Wren-Update/fpga-mgts-power.kicad_sch

## KiCad design fpga-mgts-power.kicad_sch (2026-05-15)

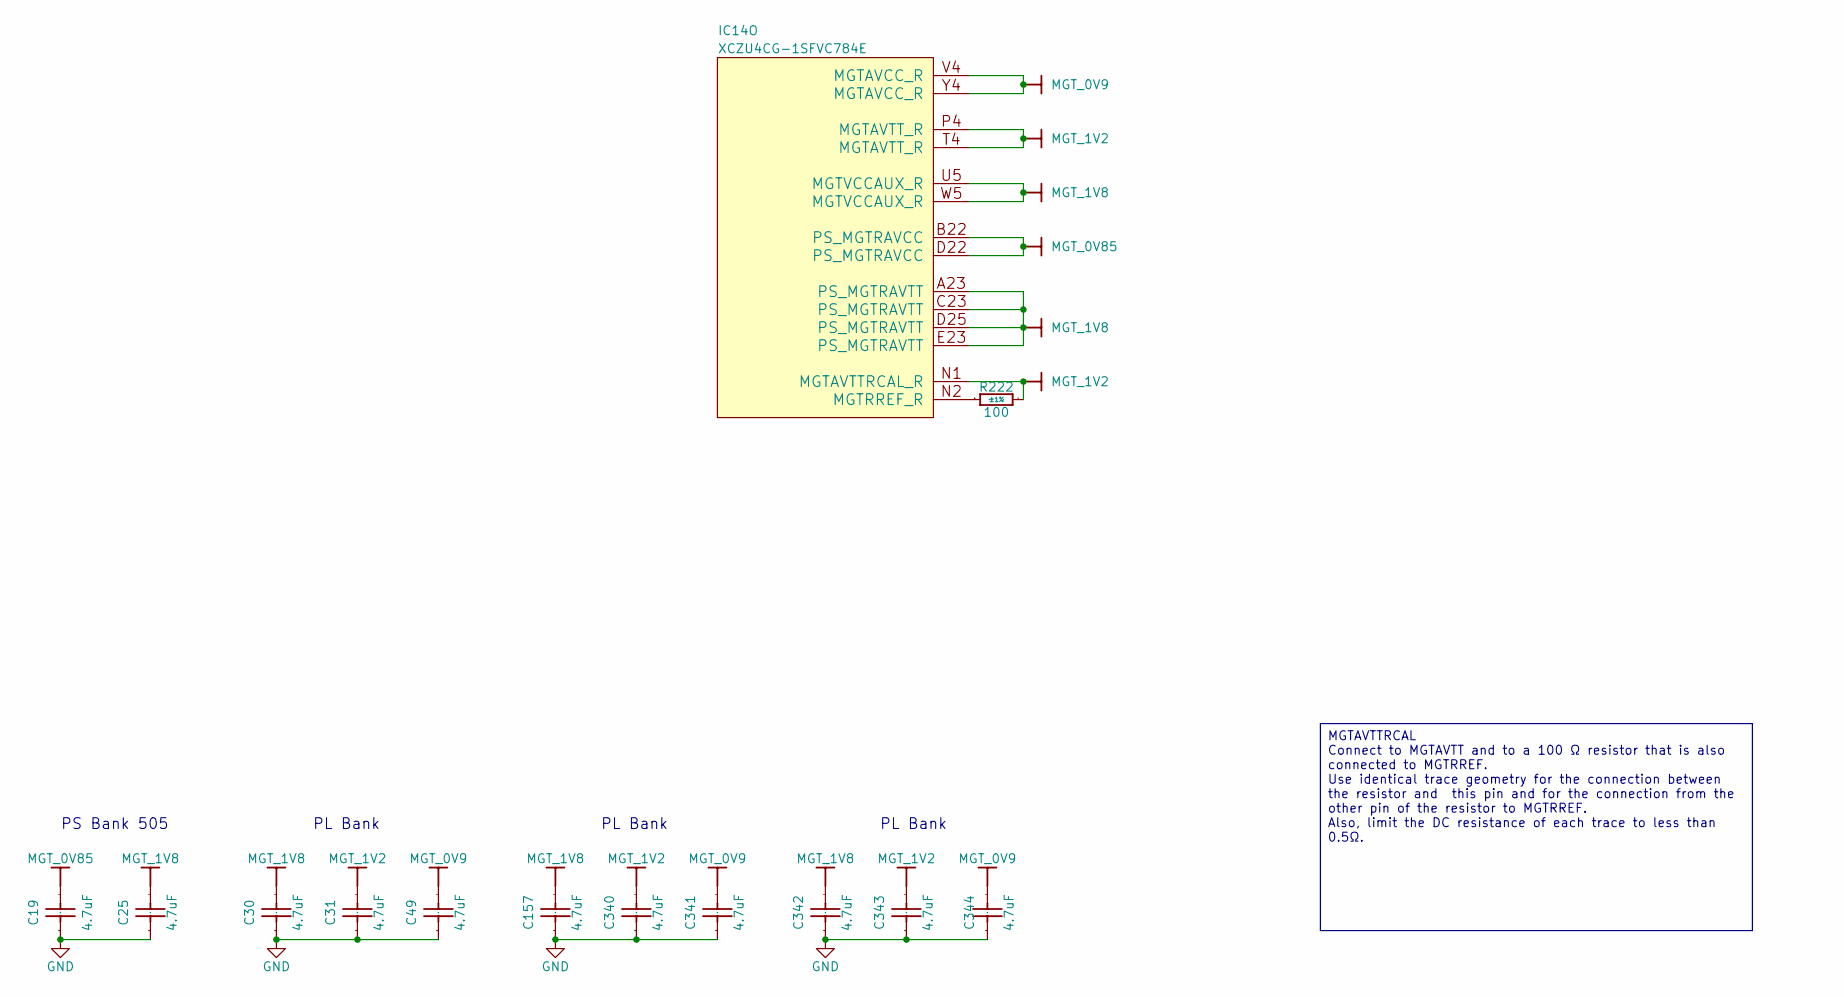
[picture p8: schematic fpga-mgts-power.kicad_sch]

Parts:
C19, C25, C30, C31, C49, C157, C340, C341, C342, C343, C344: CC0402_4.7UF_6.3V_20%_X5R; CAPC1005X55N; Voltage 6.3V; Tolerance ±20%; Part Number CC0402_4.7UF_6.3V_20%_X5R
IC14: XCZU4CG-1SFVC784E; BGA784C80P28X28_2300X2300X332; Part Number XCZU4CG-1SFVC784E
R222: R0402_100R_1%_0.0625W_100PPM; RESC1005X40N; Tolerance ±1%; Part Number R0402_100R_1%_0.0625W_100PPM

Connections:
GND: C19.1, C25.1, C30.1, C31.1, C49.1, C157.1, C340.1, C341.1, C342.1, C343.1, C344.1
MGT_0V9: C49.2, C341.2, C344.2, IC14.V4 (MGTAVCC_R), IC14.Y4 (MGTAVCC_R)
MGT_0V85: C19.2, IC14.B22 (PS_MGTRAVCC), IC14.D22 (PS_MGTRAVCC)
MGT_1V2: C31.2, C340.2, C343.2, IC14.N1 (MGTAVTTRCAL_R), IC14.P4 (MGTAVTT_R), IC14.T4 (MGTAVTT_R), R222.2
MGT_1V8: C25.2, C30.2, C157.2, C342.2, IC14.A23 (PS_MGTRAVTT), IC14.C23 (PS_MGTRAVTT), IC14.D25 (PS_MGTRAVTT), IC14.E23 (PS_MGTRAVTT), IC14.U5 (MGTVCCAUX_R), IC14.W5 (MGTVCCAUX_R)
unnamed: IC14.N2 (MGTRREF_R), R222.1

Notes on the sheet:
PL Bank
PS Bank 505
MGTAVTTRCAL Connect to MGTAVTT and to a 100 Ω resistor that is also connected to MGTRREF. Use identical trace geometry for the connection between the resistor and this pin and for the connection from the other pin of the resistor to MGTRREF. Also, limit the DC resistance of each trace to less than 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
