ttrain4086-cpu/Kicad-VME-Wren-Update/fpga-mgts.kicad_sch

## KiCad design fpga-mgts.kicad_sch (2026-05-15)

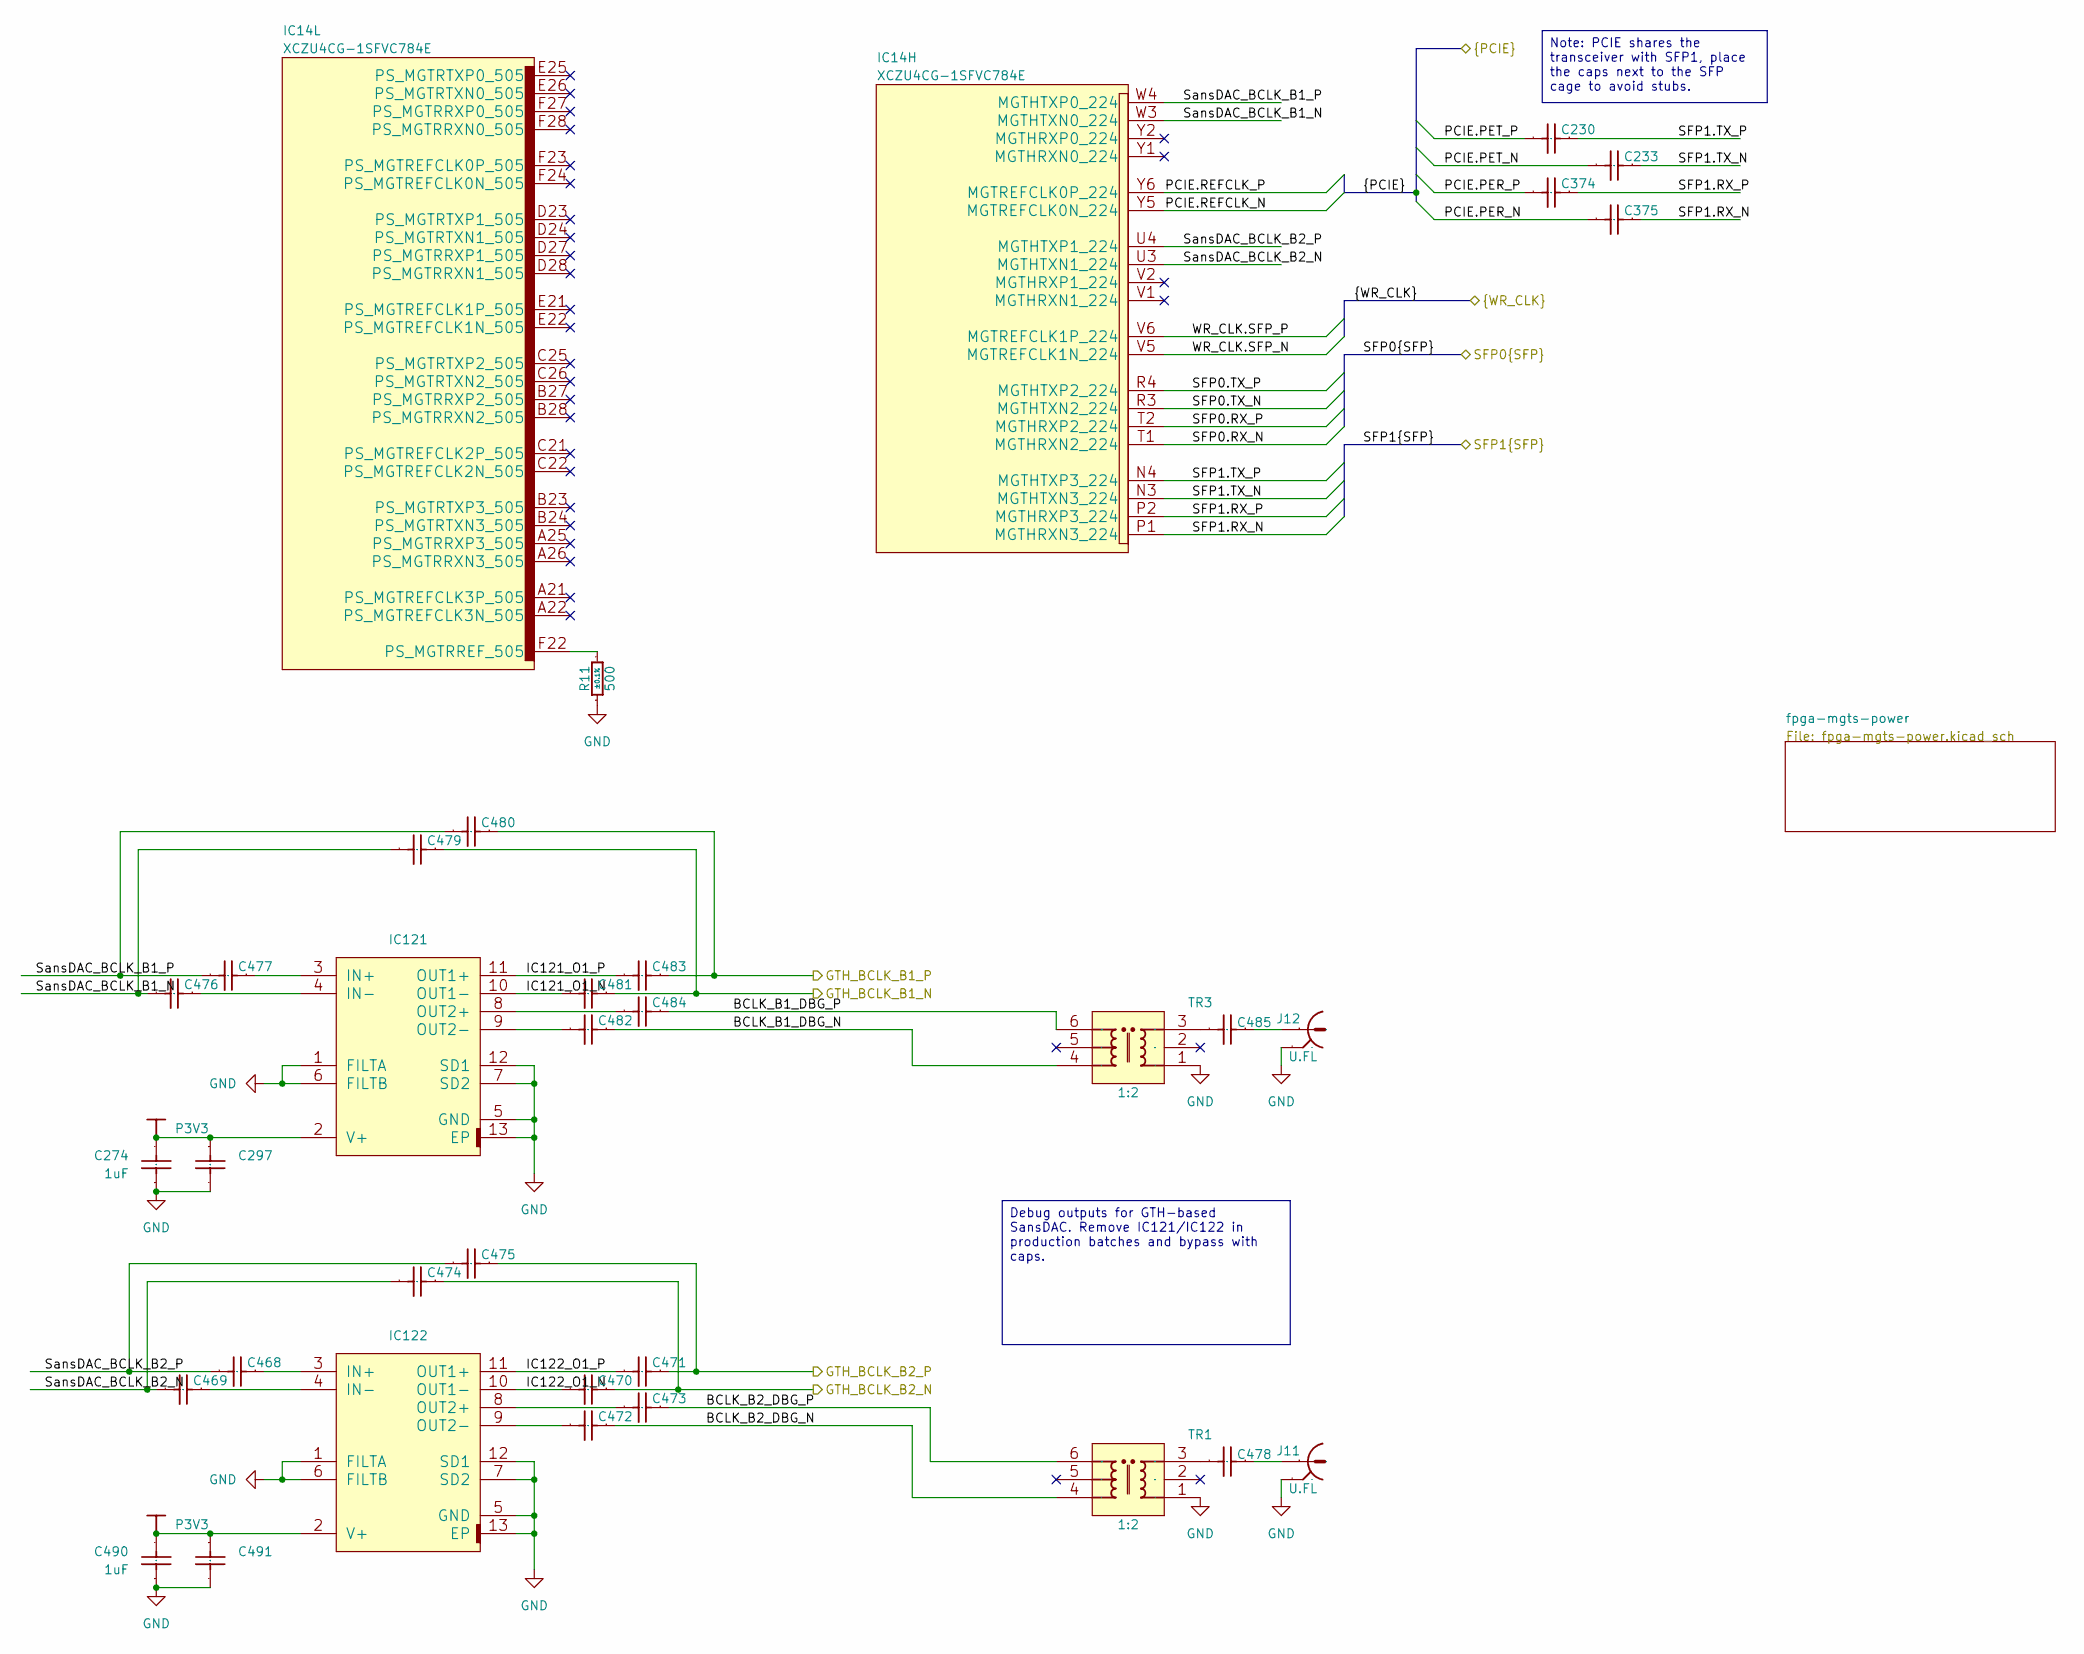
[picture p9: schematic fpga-mgts.kicad_sch]

Parts:
C230, C233, C297, C374, C375, C468, C469, C470, C471, C472, C473, C474, C475, C476, C477, C478, C479, C480, C481, C482, C483, C484, C485, C491: CC0402_100NF_16V_10%_X7R; CAPC1005X55N; Voltage 16V; Tolerance ±10%; Part Number CC0402_100NF_16V_10%_X7R
C274, C490: CC0402_1UF_25V_10%_X5R; CAPC1005X55N; Voltage 25V; Tolerance ±10%; Part Number CC0402_1UF_25V_10%_X5R
IC14: XCZU4CG-1SFVC784E; BGA784C80P28X28_2300X2300X332; Part Number XCZU4CG-1SFVC784E
IC121, IC122: LTC6957IDD-2#PBF; SON45P300X300X80-13N-R175X248; Part Description Low Phase Noise, Dual Output Buffer/Dri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
J11, J12: HIROSE_U.FL-R-SMT-1(10); Part Number HIROSE_U.FL-R-SMT-1(10)
R11: R0402_500R_0.1%_0.05W_25PPM_VISHAY_PNM; RESC1106X84N; Tolerance ±0.1%; Part Number R0402_500R_0.1%_0.05W_25PPM_VISHAY_PNM
TR1, TR3: XFMR_MINI-CIRCUITS_ADT2-1T+; XFMR_MINI-CIRCUITS_CD542; Part Number XFMR_MINI-CIRCUITS_ADT2-1T+

Connections:
BCLK_B1_DBG_N: C482.1, TR3.4 (S)
BCLK_B1_DBG_P: C484.1, TR3.6 (SDOT)
BCLK_B2_DBG_N: C472.1, TR1.4 (S)
BCLK_B2_DBG_P: C473.1, TR1.6 (SDOT)
GND: C274.1, C297.2, C490.1, C491.2, IC121.1 (FILTA), IC121.5 (GND), IC121.6 (FILTB), IC121.7 (SD2), IC121.12 (SD1), IC121.13 (EP), IC122.1 (FILTA), IC122.5 (GND), IC122.6 (FILTB), IC122.7 (SD2), IC122.12 (SD1), IC122.13 (EP), J11.2, J12.2, R11.1, TR1.1, TR3.1
GTH_BCLK_B1_N: C479.1, C481.1
GTH_BCLK_B1_P: C480.1, C483.1
GTH_BCLK_B2_N: C470.1, C474.1
GTH_BCLK_B2_P: C471.1, C475.1
IC121_O1_N: C481.2, IC121.10 (OUT1-)
IC121_O1_P: C483.2, IC121.11 (OUT1+)
IC122_O1_N: C470.2, IC122.10 (OUT1-)
IC122_O1_P: C471.2, IC122.11 (OUT1+)
unnamed: C468.1, IC122.3 (IN+)
unnamed: C469.1, IC122.4 (IN-)
unnamed: C472.2, IC122.9 (OUT2-)
unnamed: C473.2, IC122.8 (OUT2+)
unnamed: C476.1, IC121.4 (IN-)
unnamed: C477.1, IC121.3 (IN+)
unnamed: C478.1, J11.1
unnamed: C478.2, TR1.3 (PDOT)
unnamed: C482.2, IC121.9 (OUT2-)
unnamed: C484.2, IC121.8 (OUT2+)
unnamed: C485.1, J12.1
unnamed: C485.2, TR3.3 (PDOT)
unnamed: IC14.F22 (PS_MGTRREF_505), R11.2
P3V3: C274.2, C297.1, C490.2, C491.1, IC121.2 (V+), IC122.2 (V+)
PCIE.PER_N: C375.2
PCIE.PER_P: C374.2
PCIE.PET_N: C233.2
PCIE.PET_P: C230.2
PCIE.REFCLK_N: IC14.Y5 (MGTREFCLK0N_224)
PCIE.REFCLK_P: IC14.Y6 (MGTREFCLK0P_224)
SFP0.RX_N: IC14.T1 (MGTHRXN2_224)
SFP0.RX_P: IC14.T2 (MGTHRXP2_224)
SFP0.TX_N: IC14.R3 (MGTHTXN2_224)
SFP0.TX_P: IC14.R4 (MGTHTXP2_224)
SFP1.RX_N: C375.1, IC14.P1 (MGTHRXN3_224)
SFP1.RX_P: C374.1, IC14.P2 (MGTHRXP3_224)
SFP1.TX_N: C233.1, IC14.N3 (MGTHTXN3_224)
SFP1.TX_P: C230.1, IC14.N4 (MGTHTXP3_224)
SansDAC_BCLK_B1_N: C476.2, C479.2, IC14.W3 (MGTHTXN0_224)
SansDAC_BCLK_B1_P: C477.2, C480.2, IC14.W4 (MGTHTXP0_224)
SansDAC_BCLK_B2_N: C469.2, C474.2, IC14.U3 (MGTHTXN1_224)
SansDAC_BCLK_B2_P: C468.2, C475.2, IC14.U4 (MGTHTXP1_224)
WR_CLK.SFP_N: IC14.V5 (MGTREFCLK1N_224)
WR_CLK.SFP_P: IC14.V6 (MGTREFCLK1P_224)

Notes on the sheet:
Note: PCIE shares the transceiver with SFP1, place the caps next to the SFP cage to avoid stubs.
Debug outputs for GTH-based SansDAC. Remove IC121/IC122 in production batches and bypass with caps.
