ttrain4086-cpu/Kicad-VME-Wren-Update/fpga-power-gnd.kicad_sch

## KiCad design fpga-power-gnd.kicad_sch (2026-05-15)

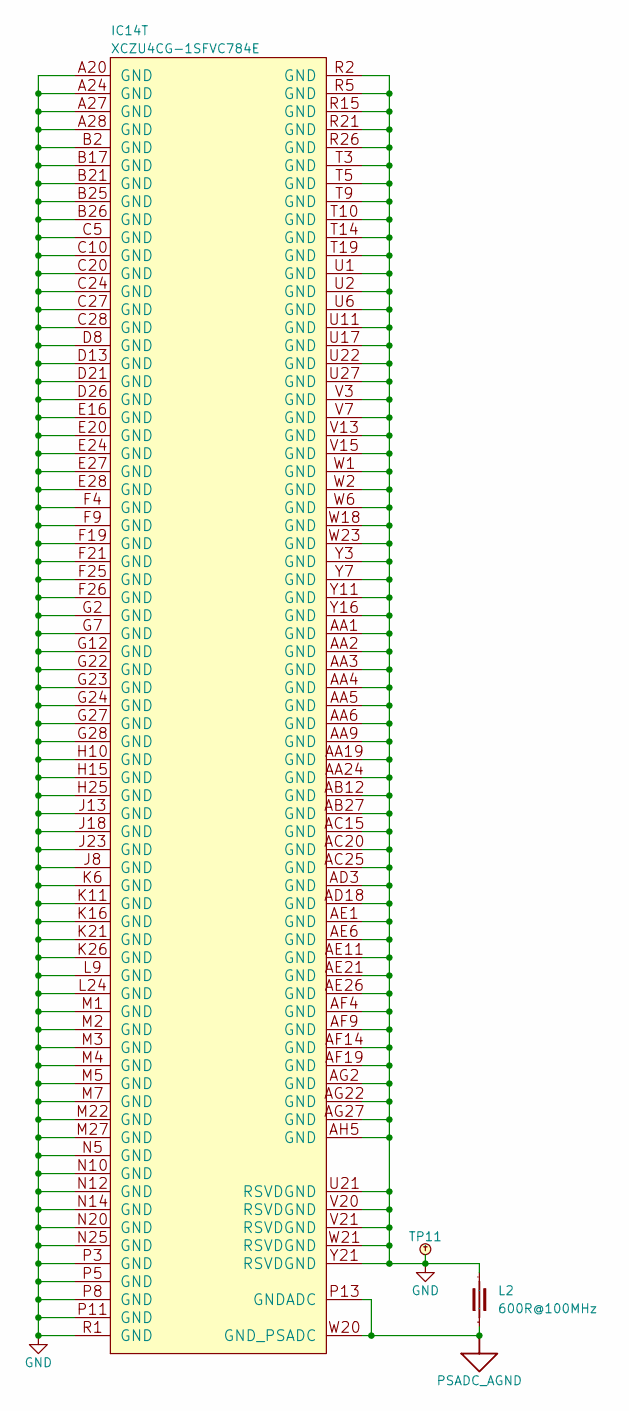
[picture p10: schematic fpga-power-gnd.kicad_sch]

Parts:
IC14: XCZU4CG-1SFVC784E; BGA784C80P28X28_2300X2300X332; Part Number XCZU4CG-1SFVC784E
L2: IND0805_WURTH_742792040; INDC2012X110N; Tolerance ±25%; Part Number IND0805_WURTH_742792040
TP11: Tomachie_TP_N; TPS127

Connections:
GND: IC14.A20 (GND), IC14.A24 (GND), IC14.A27 (GND), IC14.A28 (GND), IC14.AA1 (GND), IC14.AA2 (GND), IC14.AA3 (GND), IC14.AA4 (GND), IC14.AA5 (GND), IC14.AA6 (GND), IC14.AA9 (GND), IC14.AA19 (GND), IC14.AA24 (GND), IC14.AB12 (GND), IC14.AB27 (GND), IC14.AC15 (GND), IC14.AC20 (GND), IC14.AC25 (GND), IC14.AD3 (GND), IC14.AD18 (GND), IC14.AE1 (GND), IC14.AE6 (GND), IC14.AE11 (GND), IC14.AE21 (GND), IC14.AE26 (GND), IC14.AF4 (GND), IC14.AF9 (GND), IC14.AF14 (GND), IC14.AF19 (GND), IC14.AG2 (GND), IC14.AG22 (GND), IC14.AG27 (GND), IC14.AH5 (GND), IC14.B2 (GND), IC14.B17 (GND), IC14.B21 (GND), IC14.B25 (GND), IC14.B26 (GND), IC14.C5 (GND), IC14.C10 (GND), IC14.C20 (GND), IC14.C24 (GND), IC14.C27 (GND), IC14.C28 (GND), IC14.D8 (GND), IC14.D13 (GND), IC14.D21 (GND), IC14.D26 (GND), IC14.E16 (GND), IC14.E20 (GND), IC14.E24 (GND), IC14.E27 (GND), IC14.E28 (GND), IC14.F4 (GND), IC14.F9 (GND), IC14.F19 (GND), IC14.F21 (GND), IC14.F25 (GND), IC14.F26 (GND), IC14.G2 (GND), IC14.G7 (GND), IC14.G12 (GND), IC14.G22 (GND), IC14.G23 (GND), IC14.G24 (GND), IC14.G27 (GND), IC14.G28 (GND), IC14.H10 (GND), IC14.H15 (GND), IC14.H25 (GND), IC14.J8 (GND), IC14.J13 (GND), IC14.J18 (GND), IC14.J23 (GND), IC14.K6 (GND), IC14.K11 (GND), IC14.K16 (GND), IC14.K21 (GND), IC14.K26 (GND), IC14.L9 (GND), IC14.L24 (GND), IC14.M1 (GND), IC14.M2 (GND), IC14.M3 (GND), IC14.M4 (GND), IC14.M5 (GND), IC14.M7 (GND), IC14.M22 (GND), IC14.M27 (GND), IC14.N5 (GND), IC14.N10 (GND), IC14.N12 (GND), IC14.N14 (GND), IC14.N20 (GND), IC14.N25 (GND), IC14.P3 (GND), IC14.P5 (GND), IC14.P8 (GND), IC14.P11 (GND), IC14.R1 (GND), IC14.R2 (GND), IC14.R5 (GND), IC14.R15 (GND), IC14.R21 (GND), IC14.R26 (GND), IC14.T3 (GND), IC14.T5 (GND), IC14.T9 (GND), IC14.T10 (GND), IC14.T14 (GND), IC14.T19 (GND), IC14.U1 (GND), IC14.U2 (GND), IC14.U6 (GND), IC14.U11 (GND), IC14.U17 (GND), IC14.U21 (RSVDGND), IC14.U22 (GND), IC14.U27 (GND), IC14.V3 (GND), IC14.V7 (GND), IC14.V13 (GND), IC14.V15 (GND), IC14.V20 (RSVDGND), IC14.V21 (RSVDGND), IC14.W1 (GND), IC14.W2 (GND), IC14.W6 (GND), IC14.W18 (GND), IC14.W21 (RSVDGND), IC14.W23 (GND), IC14.Y3 (GND), IC14.Y7 (GND), IC14.Y11 (GND), IC14.Y16 (GND), IC14.Y21 (RSVDGND), L2.2, TP11.1
PSADC_AGND: IC14.P13 (GNDADC), IC14.W20 (GND_PSADC), L2.1
