ttrain4086-cpu/Kicad-VME-Wren-Update/fpga-power.kicad_sch

## KiCad design fpga-power.kicad_sch (2026-05-15)

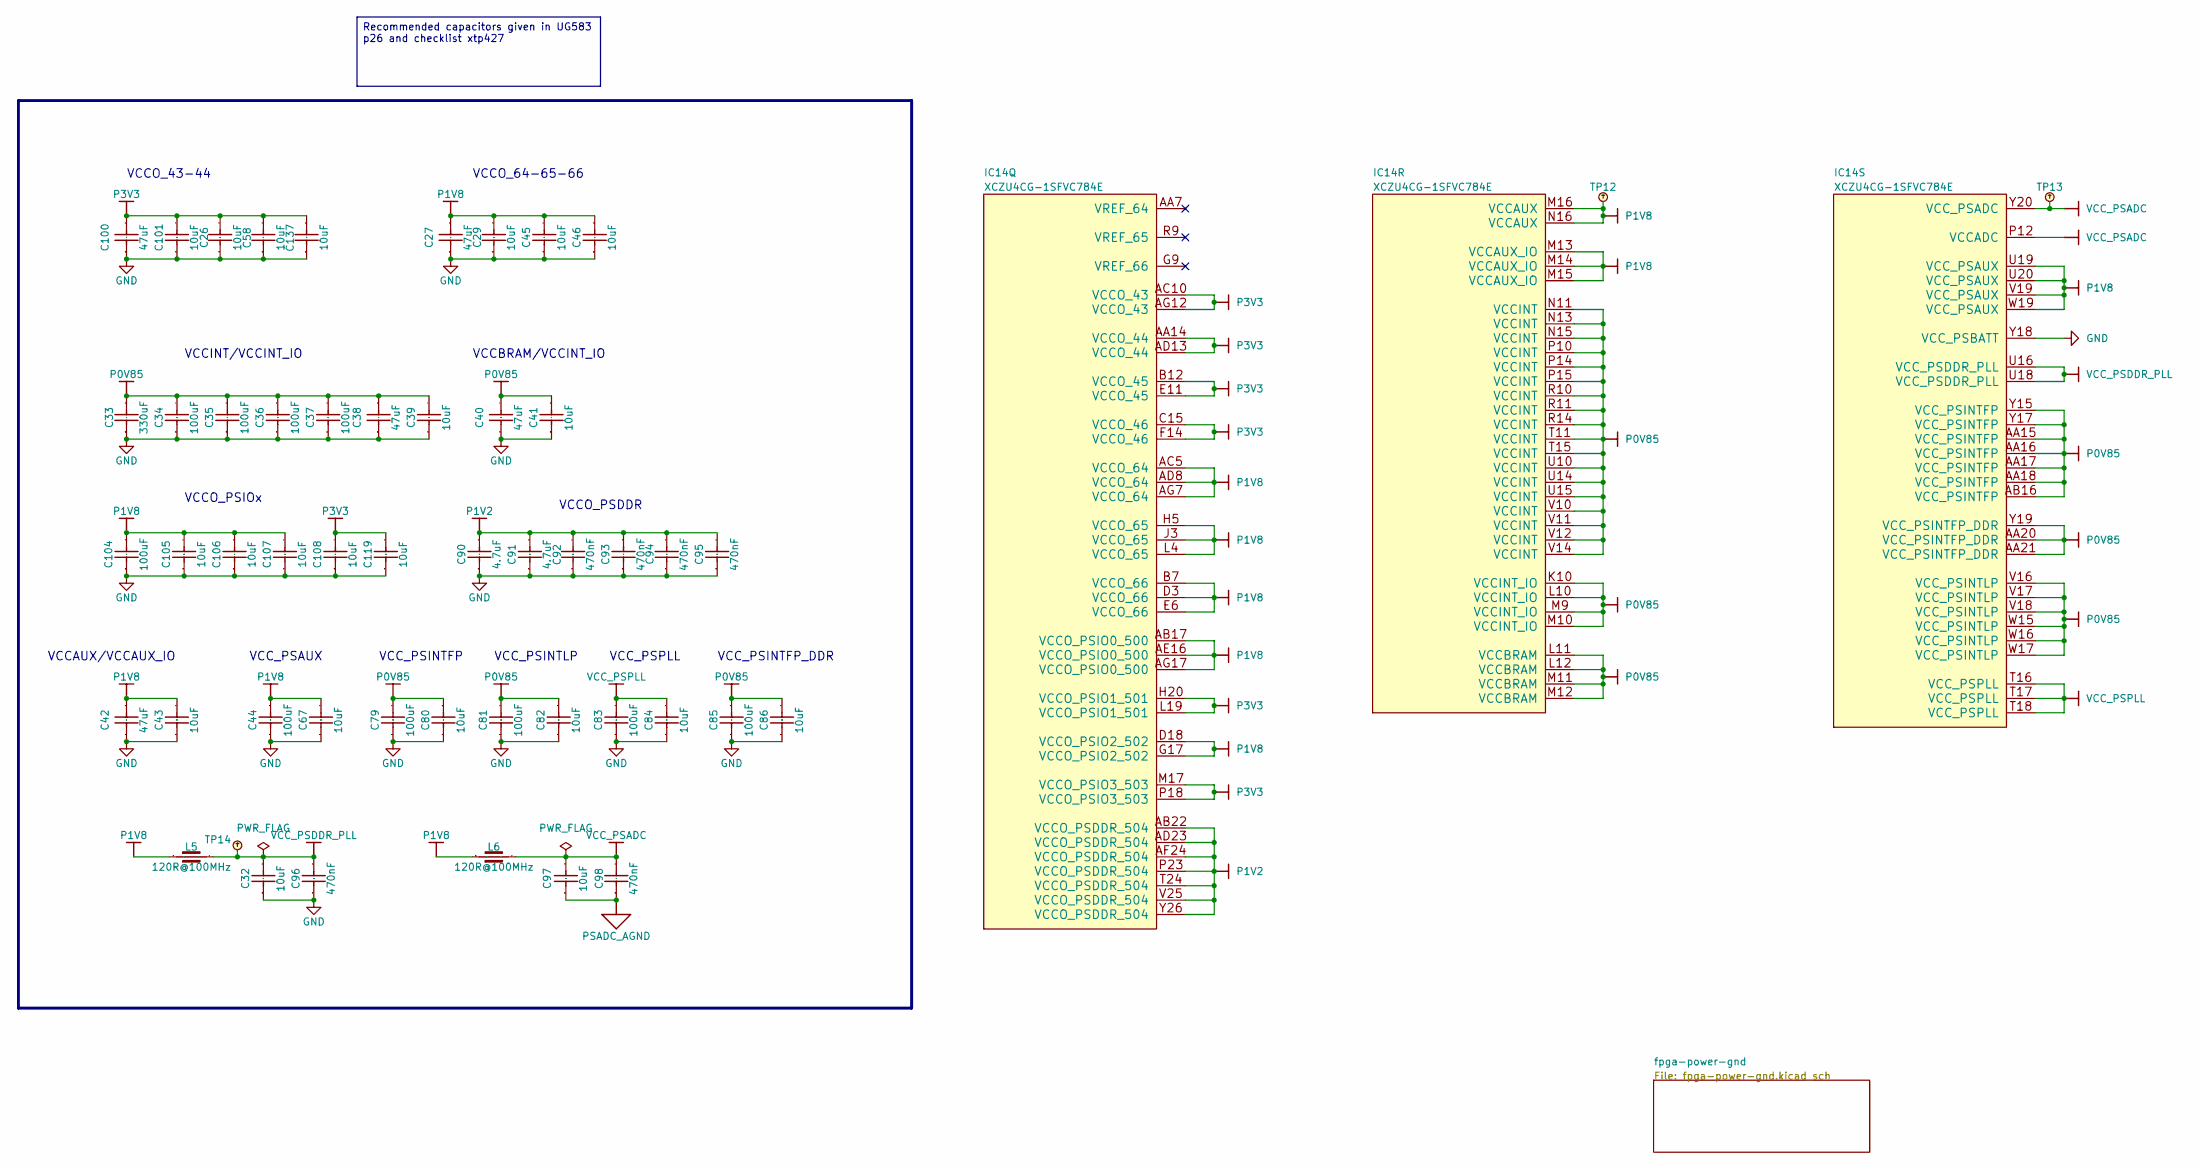
[picture p11: schematic fpga-power.kicad_sch]

Parts:
C26, C29, C32, C39, C41, C43, C45, C46, C58, C67, C80, C82, C84, C86, C97, C101, C105, C106, C107, C108, C119, C137: CC0402_10UF_6.3V_20%_X5R; CAPC1005X70N; Voltage 6.3V; Tolerance ±10%; Part Number CC0402_10UF_6.3V_20%_X5R
C27, C38, C40, C42, C100: CC0603_47UF_6.3V_20%_X5R; CAPC1608X100N; Voltage 6.3V; Tolerance ±20%; Part Number CC0603_47UF_6.3V_20%_X5R
C33: CC1210_330UF_4V_20%_X5R; CAPC3225X280N; Voltage 4V; Tolerance ±20%; Part Number CC1210_330UF_4V_20%_X5R
C34, C35, C36, C37, C44, C79, C81, C83, C85, C104: CC0805_100UF_4V_20%_X6S_MURATA_GRM21BC80G107ME15; CAPC2013X145N; Voltage 4V; Tolerance ±20%; Part Number CC0805_100UF_4V_20%_X6S_MURATA_GRM21BC8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
C90, C91: CC0402_4.7UF_6.3V_20%_X5R; CAPC1005X55N; Voltage 6.3V; Tolerance ±20%; Part Number CC0402_4.7UF_6.3V_20%_X5R
C92, C93, C94, C95, C96, C98: CC0402_470NF_6.3V_10%_X5R; CAPC1005X55N; Voltage 6.3V; Tolerance ±10%; Part Number CC0402_470NF_6.3V_10%_X5R
IC14: XCZU4CG-1SFVC784E; BGA784C80P28X28_2300X2300X332; Part Number XCZU4CG-1SFVC784E
L5, L6: IND0603_MURATA_BLM18PG121SN1D; INDC1608X95N; Part Number IND0603_MURATA_BLM18PG121SN1D
TP12, TP13, TP14: Tomachie_TP_N; TPS127

Connections:
GND: C26.1, C27.1, C29.1, C32.1, C33.1, C34.1, C35.1, C36.1, C37.1, C38.1, C39.1, C40.1, C41.1, C42.1, C43.1, C44.1, C45.1, C46.1, C58.1, C67.1, C79.1, C80.1, C81.1, C82.1, C83.1, C84.1, C85.1, C86.1, C90.1, C91.1, C92.1, C93.1, C94.1, C95.1, C96.1, C100.1, C101.1, C104.1, C105.1, C106.1, C107.1, C108.1, C119.1, C137.1, IC14.Y18 (VCC_PSBATT)
P0V85: C33.2, C34.2, C35.2, C36.2, C37.2, C38.2, C39.2, C40.2, C41.2, C79.2, C80.2, C81.2, C82.2, C85.2, C86.2, IC14.AA15 (VCC_PSINTFP), IC14.AA16 (VCC_PSINTFP), IC14.AA17 (VCC_PSINTFP), IC14.AA18 (VCC_PSINTFP), IC14.AA20 (VCC_PSINTFP_DDR), IC14.AA21 (VCC_PSINTFP_DDR), IC14.AB16 (VCC_PSINTFP), IC14.K10 (VCCINT_IO), IC14.L10 (VCCINT_IO), IC14.L11 (VCCBRAM), IC14.L12 (VCCBRAM), IC14.M9 (VCCINT_IO), IC14.M10 (VCCINT_IO), IC14.M11 (VCCBRAM), IC14.M12 (VCCBRAM), IC14.N11 (VCCINT), IC14.N13 (VCCINT), IC14.N15 (VCCINT), IC14.P10 (VCCINT), IC14.P14 (VCCINT), IC14.P15 (VCCINT), IC14.R10 (VCCINT), IC14.R11 (VCCINT), IC14.R14 (VCCINT), IC14.T11 (VCCINT), IC14.T15 (VCCINT), IC14.U10 (VCCINT), IC14.U14 (VCCINT), IC14.U15 (VCCINT), IC14.V10 (VCCINT), IC14.V11 (VCCINT), IC14.V12 (VCCINT), IC14.V14 (VCCINT), IC14.V16 (VCC_PSINTLP), IC14.V17 (VCC_PSINTLP), IC14.V18 (VCC_PSINTLP), IC14.W15 (VCC_PSINTLP), IC14.W16 (VCC_PSINTLP), IC14.W17 (VCC_PSINTLP), IC14.Y15 (VCC_PSINTFP), IC14.Y17 (VCC_PSINTFP), IC14.Y19 (VCC_PSINTFP_DDR)
P1V2: C90.2, C91.2, C92.2, C93.2, C94.2, C95.2, IC14.AB22 (VCCO_PSDDR_504), IC14.AD23 (VCCO_PSDDR_504), IC14.AF24 (VCCO_PSDDR_504), IC14.P23 (VCCO_PSDDR_504), IC14.T24 (VCCO_PSDDR_504), IC14.V25 (VCCO_PSDDR_504), IC14.Y26 (VCCO_PSDDR_504)
P1V8: C27.2, C29.2, C42.2, C43.2, C44.2, C45.2, C46.2, C67.2, C104.2, C105.2, C106.2, C107.2, IC14.AB17 (VCCO_PSIO0_500), IC14.AC5 (VCCO_64), IC14.AD8 (VCCO_64), IC14.AE16 (VCCO_PSIO0_500), IC14.AG7 (VCCO_64), IC14.AG17 (VCCO_PSIO0_500), IC14.B7 (VCCO_66), IC14.D3 (VCCO_66), IC14.D18 (VCCO_PSIO2_502), IC14.E6 (VCCO_66), IC14.G17 (VCCO_PSIO2_502), IC14.H5 (VCCO_65), IC14.J3 (VCCO_65), IC14.L4 (VCCO_65), IC14.M13 (VCCAUX_IO), IC14.M14 (VCCAUX_IO), IC14.M15 (VCCAUX_IO), IC14.M16 (VCCAUX), IC14.N16 (VCCAUX), IC14.U19 (VCC_PSAUX), IC14.U20 (VCC_PSAUX), IC14.V19 (VCC_PSAUX), IC14.W19 (VCC_PSAUX), L5.1, L6.1, TP12.1
P3V3: C26.2, C58.2, C100.2, C101.2, C108.2, C119.2, C137.2, IC14.AA14 (VCCO_44), IC14.AC10 (VCCO_43), IC14.AD13 (VCCO_44), IC14.AG12 (VCCO_43), IC14.B12 (VCCO_45), IC14.C15 (VCCO_46), IC14.E11 (VCCO_45), IC14.F14 (VCCO_46), IC14.H20 (VCCO_PSIO1_501), IC14.L19 (VCCO_PSIO1_501), IC14.M17 (VCCO_PSIO3_503), IC14.P18 (VCCO_PSIO3_503)
PSADC_AGND: C97.1, C98.1
VCC_PSADC: C97.2, C98.2, IC14.P12 (VCCADC), IC14.Y20 (VCC_PSADC), L6.2, TP13.1
VCC_PSDDR_PLL: C32.2, C96.2, IC14.U16 (VCC_PSDDR_PLL), IC14.U18 (VCC_PSDDR_PLL), L5.2, TP14.1
VCC_PSPLL: C83.2, C84.2, IC14.T16 (VCC_PSPLL), IC14.T17 (VCC_PSPLL), IC14.T18 (VCC_PSPLL)

Notes on the sheet:
VCCINT/VCCINT_IO
VCC_PSAUX
VCCO_64-65-66
VCCAUX/VCCAUX_IO
VCC_PSINTFP
VCCBRAM/VCCINT_IO
VCC_PSPLL
VCCO_PSIOx
VCCO_PSDDR
VCCO_43-44
VCC_PSINTLP
VCC_PSINTFP_DDR
Recommended capacitors given in UG583 p26 and checklist xtp427
