ttrain4086-cpu/Kicad-VME-Wren-Update/fpga-ps-ddr.kicad_sch

## KiCad design fpga-ps-ddr.kicad_sch (2026-05-15)

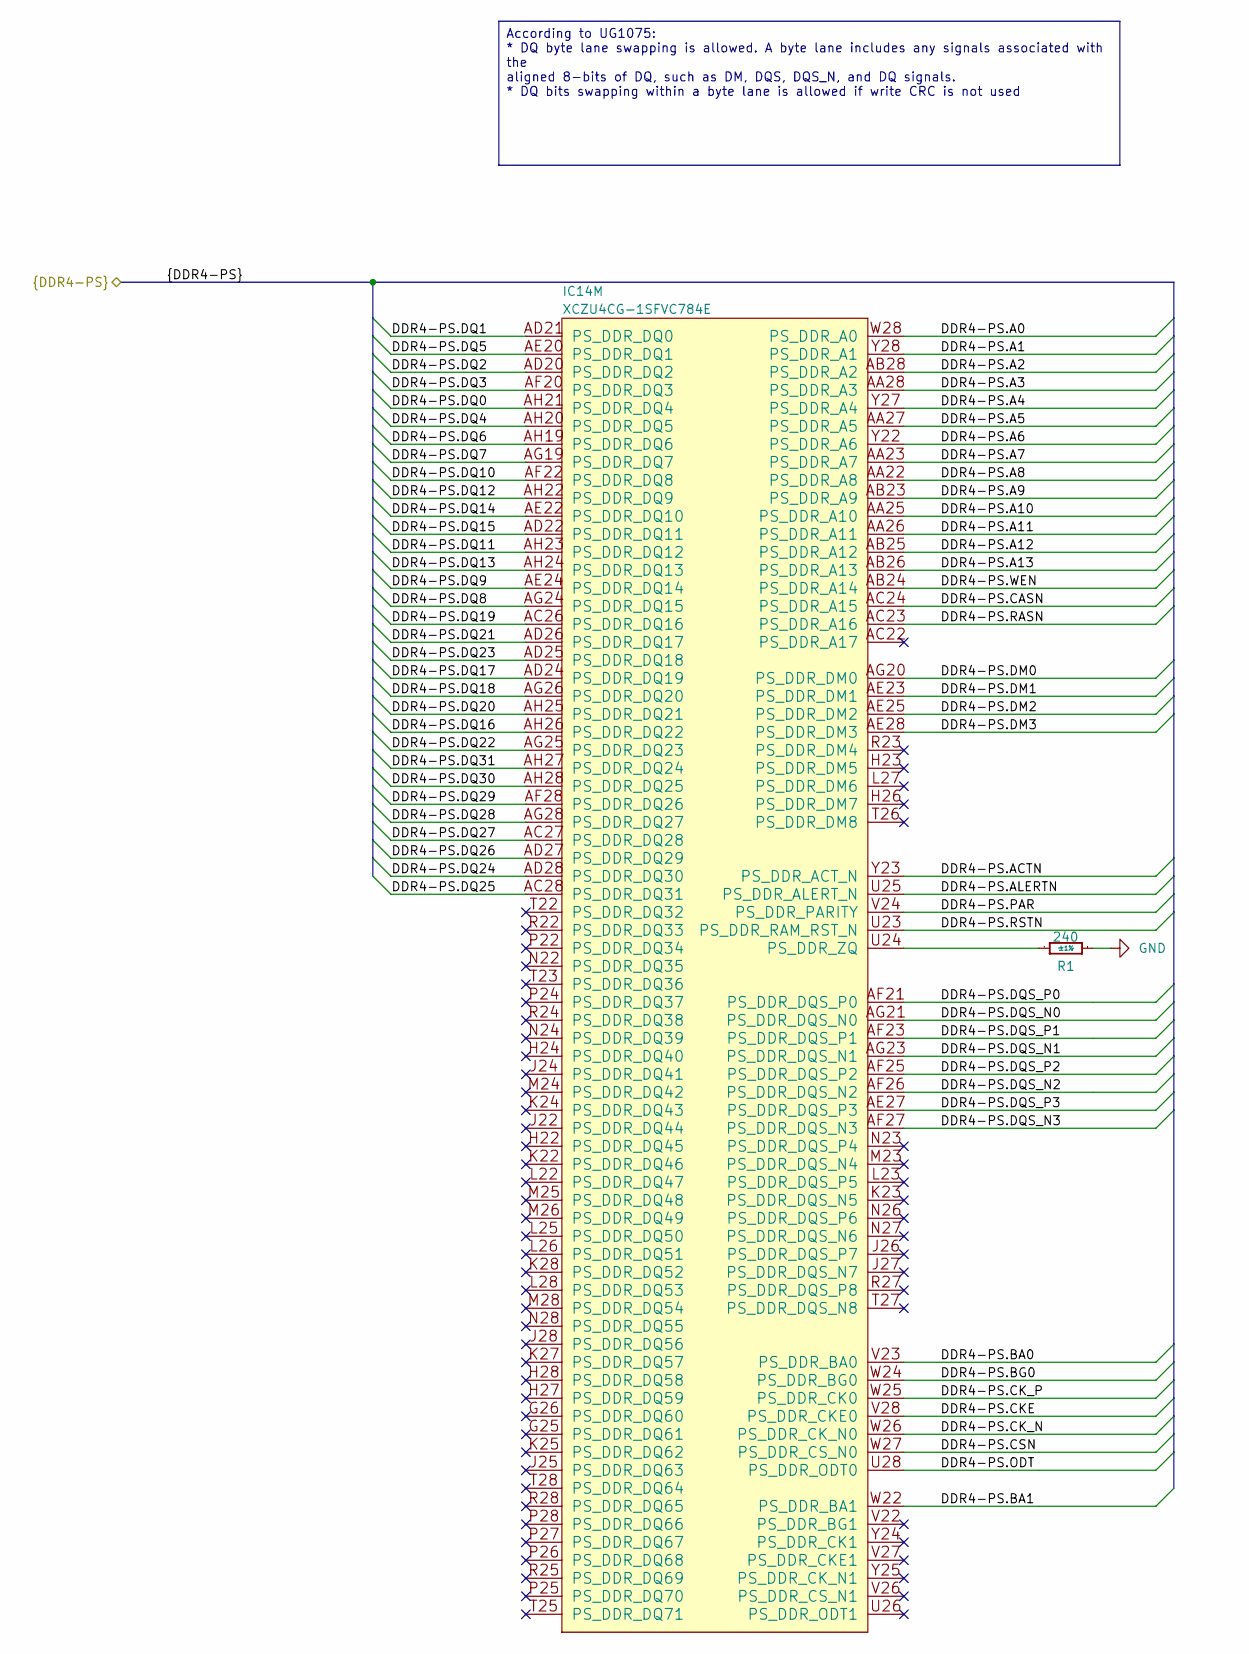
[picture p12: schematic fpga-ps-ddr.kicad_sch]

Parts:
IC14: XCZU4CG-1SFVC784E; BGA784C80P28X28_2300X2300X332; Part Number XCZU4CG-1SFVC784E
R1: R0402_240R_1%_0.0625W_100PPM; RESC1005X40N; Tolerance ±1%; Part Number R0402_240R_1%_0.0625W_100PPM

Connections:
DDR4-PS.A0: IC14.W28 (PS_DDR_A0)
DDR4-PS.A1: IC14.Y28 (PS_DDR_A1)
DDR4-PS.A2: IC14.AB28 (PS_DDR_A2)
DDR4-PS.A3: IC14.AA28 (PS_DDR_A3)
DDR4-PS.A4: IC14.Y27 (PS_DDR_A4)
DDR4-PS.A5: IC14.AA27 (PS_DDR_A5)
DDR4-PS.A6: IC14.Y22 (PS_DDR_A6)
DDR4-PS.A7: IC14.AA23 (PS_DDR_A7)
DDR4-PS.A8: IC14.AA22 (PS_DDR_A8)
DDR4-PS.A9: IC14.AB23 (PS_DDR_A9)
DDR4-PS.A10: IC14.AA25 (PS_DDR_A10)
DDR4-PS.A11: IC14.AA26 (PS_DDR_A11)
DDR4-PS.A12: IC14.AB25 (PS_DDR_A12)
DDR4-PS.A13: IC14.AB26 (PS_DDR_A13)
DDR4-PS.ACTN: IC14.Y23 (PS_DDR_ACT_N)
DDR4-PS.ALERTN: IC14.U25 (PS_DDR_ALERT_N)
DDR4-PS.BA0: IC14.V23 (PS_DDR_BA0)
DDR4-PS.BA1: IC14.W22 (PS_DDR_BA1)
DDR4-PS.BG0: IC14.W24 (PS_DDR_BG0)
DDR4-PS.CASN: IC14.AC24 (PS_DDR_A15)
DDR4-PS.CKE: IC14.V28 (PS_DDR_CKE0)
DDR4-PS.CK_N: IC14.W26 (PS_DDR_CK_N0)
DDR4-PS.CK_P: IC14.W25 (PS_DDR_CK0)
DDR4-PS.CSN: IC14.W27 (PS_DDR_CS_N0)
DDR4-PS.DM0: IC14.AG20 (PS_DDR_DM0)
DDR4-PS.DM1: IC14.AE23 (PS_DDR_DM1)
DDR4-PS.DM2: IC14.AE25 (PS_DDR_DM2)
DDR4-PS.DM3: IC14.AE28 (PS_DDR_DM3)
DDR4-PS.DQ0: IC14.AH21 (PS_DDR_DQ4)
DDR4-PS.DQ1: IC14.AD21 (PS_DDR_DQ0)
DDR4-PS.DQ2: IC14.AD20 (PS_DDR_DQ2)
DDR4-PS.DQ3: IC14.AF20 (PS_DDR_DQ3)
DDR4-PS.DQ4: IC14.AH20 (PS_DDR_DQ5)
DDR4-PS.DQ5: IC14.AE20 (PS_DDR_DQ1)
DDR4-PS.DQ6: IC14.AH19 (PS_DDR_DQ6)
DDR4-PS.DQ7: IC14.AG19 (PS_DDR_DQ7)
DDR4-PS.DQ8: IC14.AG24 (PS_DDR_DQ15)
DDR4-PS.DQ9: IC14.AE24 (PS_DDR_DQ14)
DDR4-PS.DQ10: IC14.AF22 (PS_DDR_DQ8)
DDR4-PS.DQ11: IC14.AH23 (PS_DDR_DQ12)
DDR4-PS.DQ12: IC14.AH22 (PS_DDR_DQ9)
DDR4-PS.DQ13: IC14.AH24 (PS_DDR_DQ13)
DDR4-PS.DQ14: IC14.AE22 (PS_DDR_DQ10)
DDR4-PS.DQ15: IC14.AD22 (PS_DDR_DQ11)
DDR4-PS.DQ16: IC14.AH26 (PS_DDR_DQ22)
DDR4-PS.DQ17: IC14.AD24 (PS_DDR_DQ19)
DDR4-PS.DQ18: IC14.AG26 (PS_DDR_DQ20)
DDR4-PS.DQ19: IC14.AC26 (PS_DDR_DQ16)
DDR4-PS.DQ20: IC14.AH25 (PS_DDR_DQ21)
DDR4-PS.DQ21: IC14.AD26 (PS_DDR_DQ17)
DDR4-PS.DQ22: IC14.AG25 (PS_DDR_DQ23)
DDR4-PS.DQ23: IC14.AD25 (PS_DDR_DQ18)
DDR4-PS.DQ24: IC14.AD28 (PS_DDR_DQ30)
DDR4-PS.DQ25: IC14.AC28 (PS_DDR_DQ31)
DDR4-PS.DQ26: IC14.AD27 (PS_DDR_DQ29)
DDR4-PS.DQ27: IC14.AC27 (PS_DDR_DQ28)
DDR4-PS.DQ28: IC14.AG28 (PS_DDR_DQ27)
DDR4-PS.DQ29: IC14.AF28 (PS_DDR_DQ26)
DDR4-PS.DQ30: IC14.AH28 (PS_DDR_DQ25)
DDR4-PS.DQ31: IC14.AH27 (PS_DDR_DQ24)
DDR4-PS.DQS_N0: IC14.AG21 (PS_DDR_DQS_N0)
DDR4-PS.DQS_N1: IC14.AG23 (PS_DDR_DQS_N1)
DDR4-PS.DQS_N2: IC14.AF26 (PS_DDR_DQS_N2)
DDR4-PS.DQS_N3: IC14.AF27 (PS_DDR_DQS_N3)
DDR4-PS.DQS_P0: IC14.AF21 (PS_DDR_DQS_P0)
DDR4-PS.DQS_P1: IC14.AF23 (PS_DDR_DQS_P1)
DDR4-PS.DQS_P2: IC14.AF25 (PS_DDR_DQS_P2)
DDR4-PS.DQS_P3: IC14.AE27 (PS_DDR_DQS_P3)
DDR4-PS.ODT: IC14.U28 (PS_DDR_ODT0)
DDR4-PS.PAR: IC14.V24 (PS_DDR_PARITY)
DDR4-PS.RASN: IC14.AC23 (PS_DDR_A16)
DDR4-PS.RSTN: IC14.U23 (PS_DDR_RAM_RST_N)
DDR4-PS.WEN: IC14.AB24 (PS_DDR_A14)
GND: R1.1
unnamed: IC14.U24 (PS_DDR_ZQ), R1.2

Notes on the sheet:
According to UG1075: * DQ byte lane swapping is allowed. A byte lane includes any signals associated with the aligned 8-bits of DQ, such as DM, DQS, DQS_N, and DQ signals. * DQ bits swapping within a byte lane is allowed if write CRC is not used
