ttrain4086-cpu/Kicad-VME-Wren-Update/io_driver.kicad_sch

## KiCad design io_driver.kicad_sch (2026-05-15)

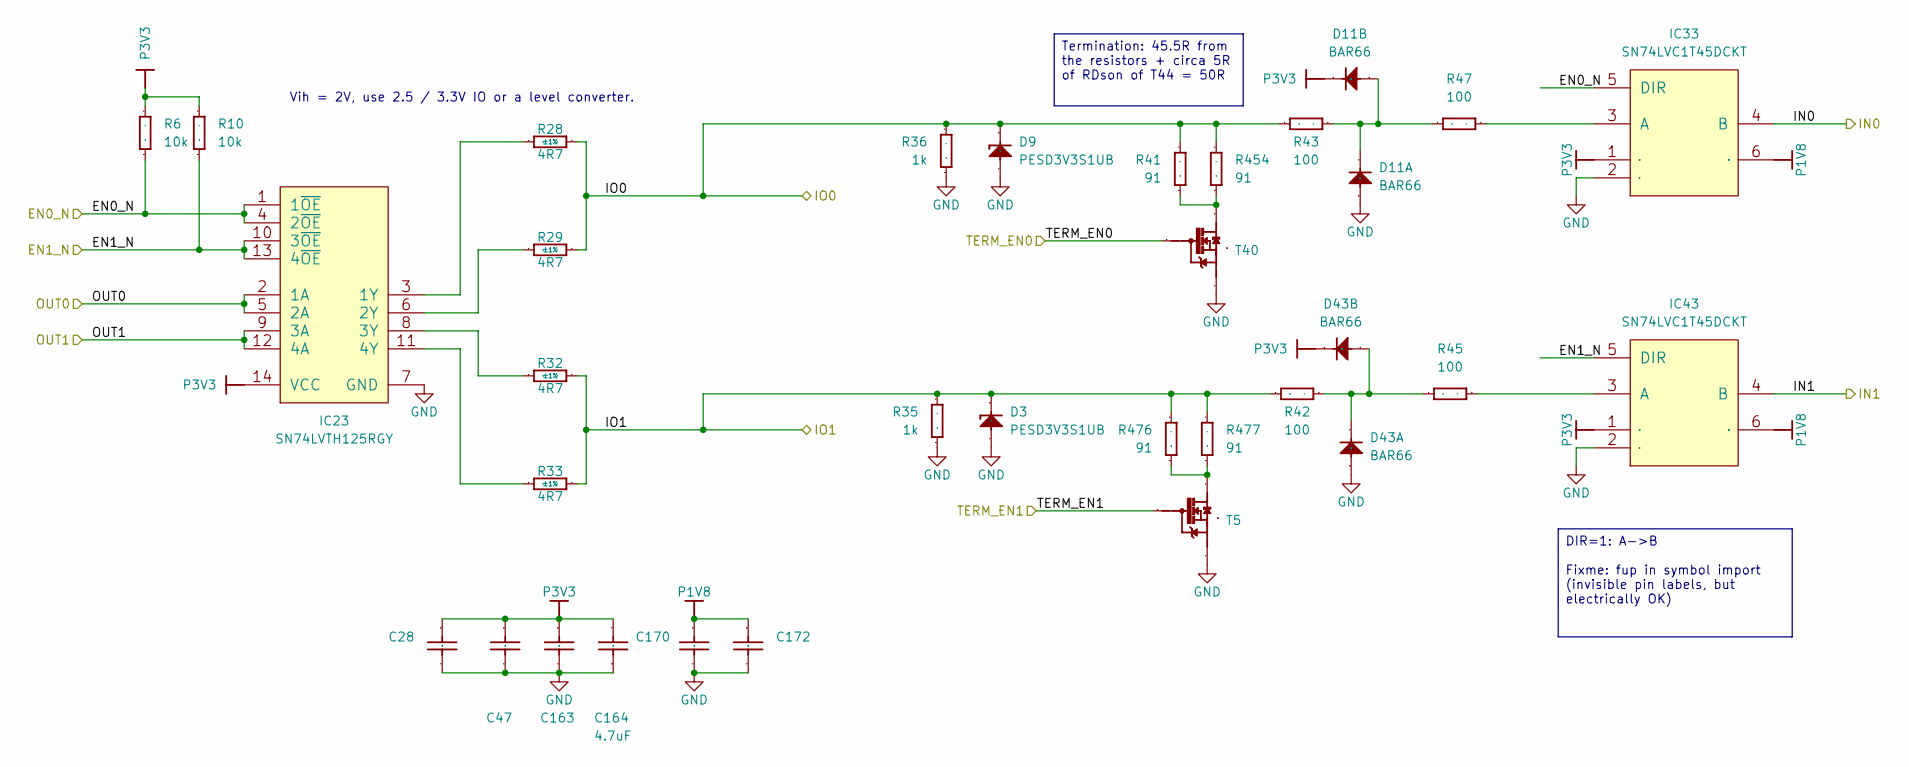
[picture p13: schematic io_driver.kicad_sch]

Parts:
C28, C47, C163, C170, C172: CC0402_100NF_16V_10%_X7R; CAPC1005X55N; Voltage 16V; Tolerance ±10%; Part Number CC0402_100NF_16V_10%_X7R
C164: CC0402_4.7UF_6.3V_20%_X5R; CAPC1005X55N; Voltage 6.3V; Tolerance ±20%; Part Number CC0402_4.7UF_6.3V_20%_X5R
D3, D9: PESD3V3S1UB; SODFL1608X65N; Voltage 3V3; Part Number PESD3V3S1UB
D11, D43: BAR66; SOT95P240X110-3N; Voltage 150V; Part Description Silicon PIN Diode Array (Series Connect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
IC23: SN74LVTH125RGY; TEXAS_RGY (S-PVQFN-N14); Part Number SN74LVTH125RGY
IC33, IC43: SN74LVC1T45DCKT; SOT65P210X110-6N; Part Description Single-Bit Dual-Supply Bus Transceiver 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
R6, R10: R0402_10K_1%_0.0625W_100PPM; RESC1005X40N; Tolerance ±1%; Part Number R0402_10K_1%_0.0625W_100PPM
R28, R29, R32, R33: R0402_4R7_1%_0.0625W_200PPM; RESC1005X40N; Tolerance ±1%; Part Number R0402_4R7_1%_0.0625W_200PPM
R35, R36: R0402_1K_1%_0.0625W_100PPM; RESC1005X40N; Tolerance ±1%; Part Number R0402_1K_1%_0.0625W_100PPM
R41, R454, R476, R477: R1206_91R_1%_0.25W_100PPM; RESC3216X65N; Tolerance ±1%; Part Number R1206_91R_1%_0.25W_100PPM
R42, R43, R45, R47: R0402_100R_1%_0.0625W_100PPM; RESC1005X40N; Tolerance ±1%; Part Number R0402_100R_1%_0.0625W_100PPM
T5, T40: FDV301N; SOT95P240X110-3N; Part Description 25V, 0.22A, N-Channel Digital FET

Connections:
EN0_N: IC23.1 (1~OE), IC23.4 (2~OE), IC33.5 (DIR), R6.1
EN1_N: IC23.10 (3~OE), IC23.13 (4~OE), IC43.5 (DIR), R10.1
GND: C28.2, C47.2, C163.2, C164.1, C170.2, C172.2, D3.2 (A), D9.2 (A), D11.1 (A), D43.1 (A), IC23.7 (GND), IC33.2 (GND), IC43.2 (GND), R35.1, R36.1, T5.2 (S), T40.2 (S)
IN0: IC33.4 (B)
IN1: IC43.4 (B)
IO0: D9.1 (C), R28.2, R29.2, R36.2, R41.2, R43.1, R454.2
IO1: D3.1 (C), R32.2, R33.2, R35.2, R42.1, R476.2, R477.2
unnamed: D11.3 (COMAC), R43.2, R47.1
unnamed: D43.3 (COMAC), R42.2, R45.1
unnamed: IC23.3 (1Y), R28.1
unnamed: IC23.6 (2Y), R29.1
unnamed: IC23.8 (3Y), R32.1
unnamed: IC23.11 (4Y), R33.1
unnamed: IC33.3 (A), R47.2
unnamed: IC43.3 (A), R45.2
unnamed: R41.1, R454.1, T40.3 (D)
unnamed: R476.1, R477.1, T5.3 (D)
OUT0: IC23.2 (1A), IC23.5 (2A)
OUT1: IC23.9 (3A), IC23.12 (4A)
P1V8: C170.1, C172.1, IC33.6 (VCCB), IC43.6 (VCCB)
P3V3: C28.1, C47.1, C163.1, C164.2, D11.2 (C), D43.2 (C), IC23.14 (VCC), IC33.1 (VCCA), IC43.1 (VCCA), R6.2, R10.2
TERM_EN0: T40.1 (G)
TERM_EN1: T5.1 (G)

Notes on the sheet:
Vih = 2V, use 2.5 / 3.3V IO or a level converter.
Termination: 45.5R from the resistors + circa 5R of RDson of T44 = 50R
DIR=1: A->B Fixme: fup in symbol import (invisible pin labels, but electrically OK)
