ttrain4086-cpu/Kicad-VME-Wren-Update/io_driver_8x.kicad_sch

## KiCad design io_driver_8x.kicad_sch (2026-05-15)

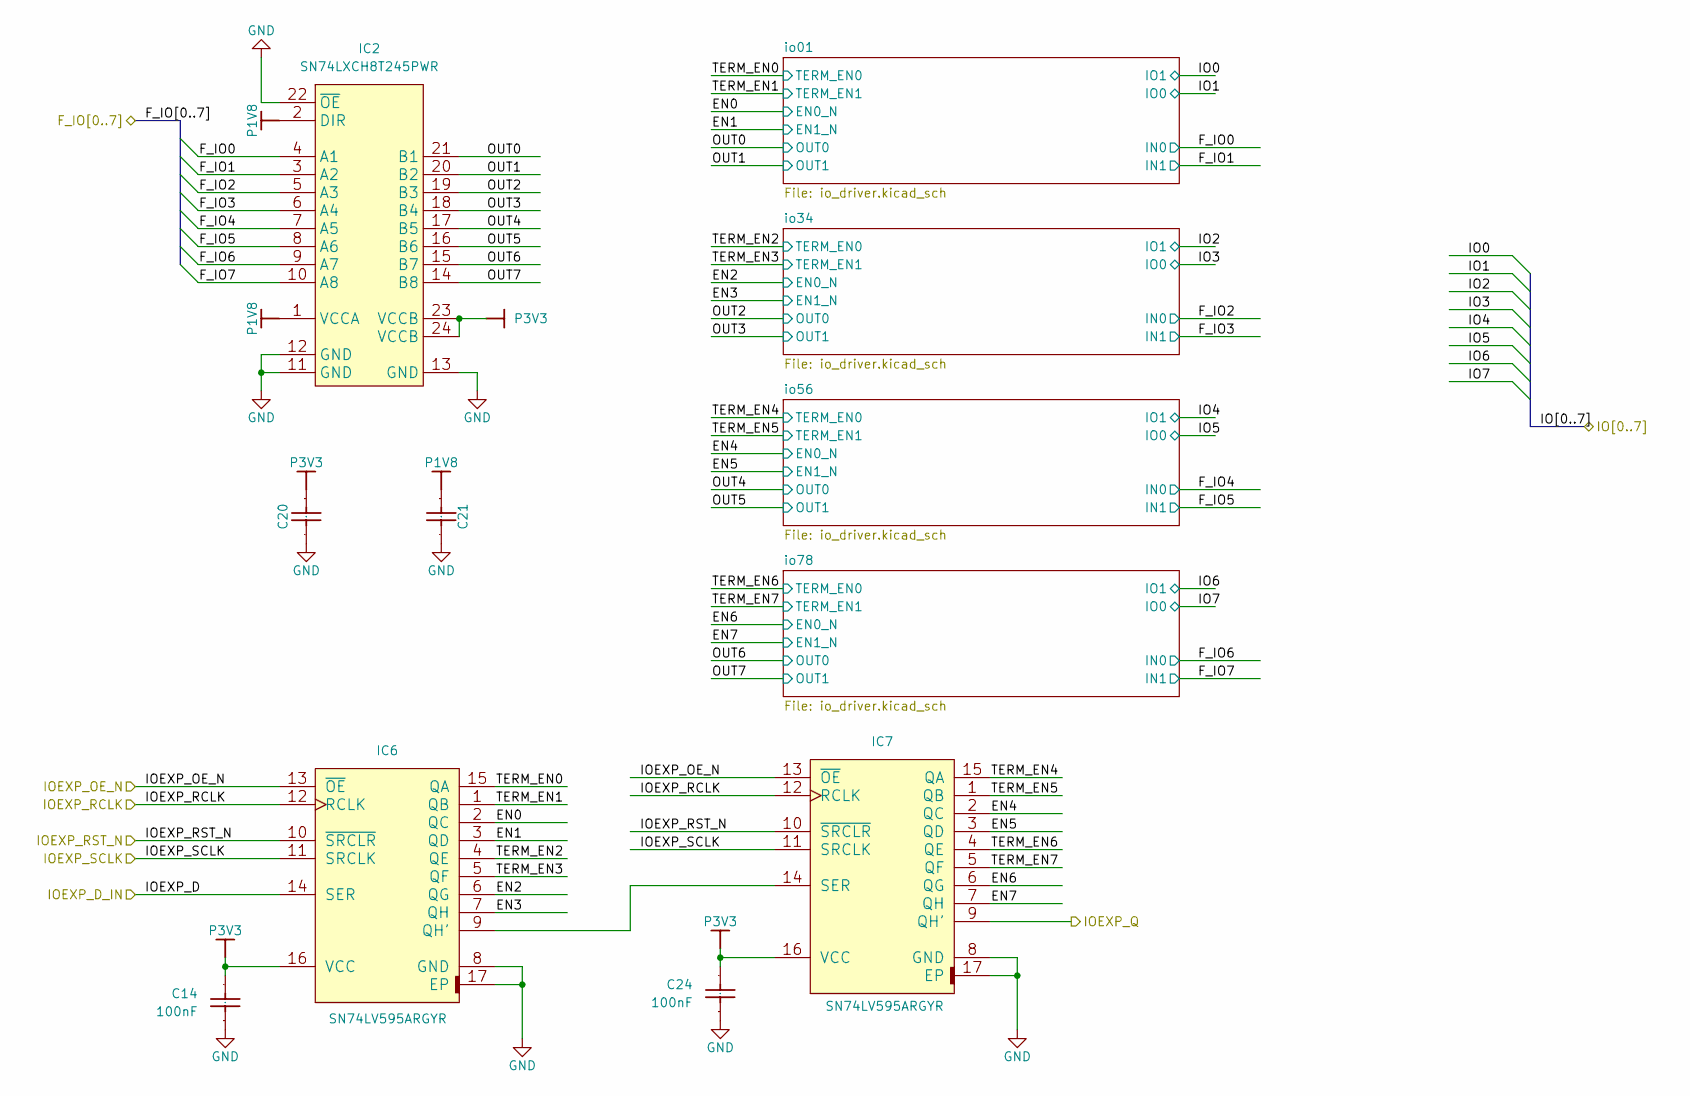
[picture p14: schematic io_driver_8x.kicad_sch]

Parts:
C14, C20, C21, C24: CC0402_100NF_16V_10%_X7R; CAPC1005X55N; Voltage 16V; Tolerance ±10%; Part Number CC0402_100NF_16V_10%_X7R
IC2: SN74LXCH8T245PWR; SOP65P640X120-24N
IC6, IC7: SN74LV595ARGYR; TEXAS_RGY (R-PVQFN-N16); Part Description 8-Bit Shift Register with 3-State Outpu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

Connections:
EN0: IC6.2 (QC)
EN1: IC6.3 (QD)
EN2: IC6.6 (QG)
EN3: IC6.7 (QH)
EN4: IC7.2 (QC)
EN5: IC7.3 (QD)
EN6: IC7.6 (QG)
EN7: IC7.7 (QH)
F_IO0: IC2.4 (A1)
F_IO1: IC2.3 (A2)
F_IO2: IC2.5 (A3)
F_IO3: IC2.6 (A4)
F_IO4: IC2.7 (A5)
F_IO5: IC2.8 (A6)
F_IO6: IC2.9 (A7)
F_IO7: IC2.10 (A8)
GND: C14.1, C20.2, C21.2, C24.1, IC2.11 (GND), IC2.12 (GND), IC2.13 (GND), IC2.22 (~OE), IC6.8 (GND), IC6.17 (EP), IC7.8 (GND), IC7.17 (EP)
IOEXP_D: IC6.14 (SER)
IOEXP_OE_N: IC6.13 (~OE), IC7.13 (~OE)
IOEXP_Q: IC7.9 (QH')
IOEXP_RCLK: IC6.12 (RCLK), IC7.12 (RCLK)
IOEXP_RST_N: IC6.10 (~SRCLR), IC7.10 (~SRCLR)
IOEXP_SCLK: IC6.11 (SRCLK), IC7.11 (SRCLK)
unnamed: IC6.9 (QH'), IC7.14 (SER)
OUT0: IC2.21 (B1)
OUT1: IC2.20 (B2)
OUT2: IC2.19 (B3)
OUT3: IC2.18 (B4)
OUT4: IC2.17 (B5)
OUT5: IC2.16 (B6)
OUT6: IC2.15 (B7)
OUT7: IC2.14 (B8)
P1V8: C21.1, IC2.1 (VCCA), IC2.2 (DIR)
P3V3: C14.2, C20.1, C24.2, IC2.23 (VCCB), IC2.24 (VCCB), IC6.16 (VCC), IC7.16 (VCC)
TERM_EN0: IC6.15 (QA)
TERM_EN1: IC6.1 (QB)
TERM_EN2: IC6.4 (QE)
TERM_EN3: IC6.5 (QF)
TERM_EN4: IC7.15 (QA)
TERM_EN5: IC7.1 (QB)
TERM_EN6: IC7.4 (QE)
TERM_EN7: IC7.5 (QF)
