ttrain4086-cpu/Kicad-VME-Wren-Update/io_driver_32x.kicad_sch

## KiCad design io_driver_32x.kicad_sch (2026-05-15)

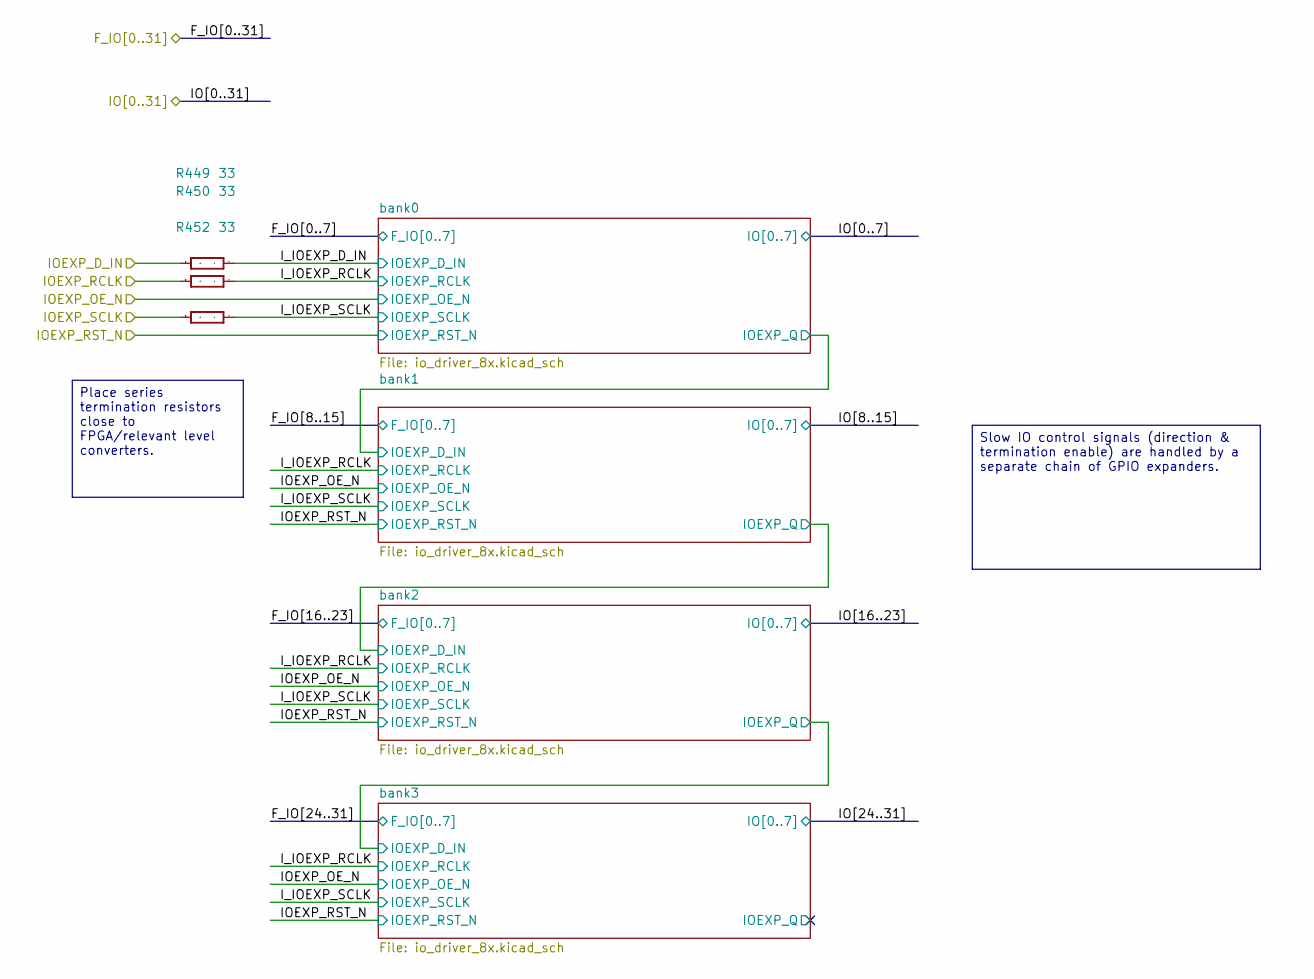
[picture p15: schematic io_driver_32x.kicad_sch]

Parts:
R449, R450, R452: R0402_33R_1%_0.0625W_100PPM; RESC1005X40N; Tolerance ±1%; Part Number R0402_33R_1%_0.0625W_100PPM

Connections:
IOEXP_D_IN: R449.1
IOEXP_RCLK: R450.1
IOEXP_SCLK: R452.1
I_IOEXP_D_IN: R449.2
I_IOEXP_RCLK: R450.2
I_IOEXP_SCLK: R452.2

Notes on the sheet:
Place series termination resistors close to FPGA/relevant level converters.
Slow IO control signals (direction & termination enable) are handled by a separate chain of GPIO expanders.
