ttrain4086-cpu/Kicad-VME-Wren-Update/pcie_connector.kicad_sch

## KiCad design pcie_connector.kicad_sch (2026-05-15)

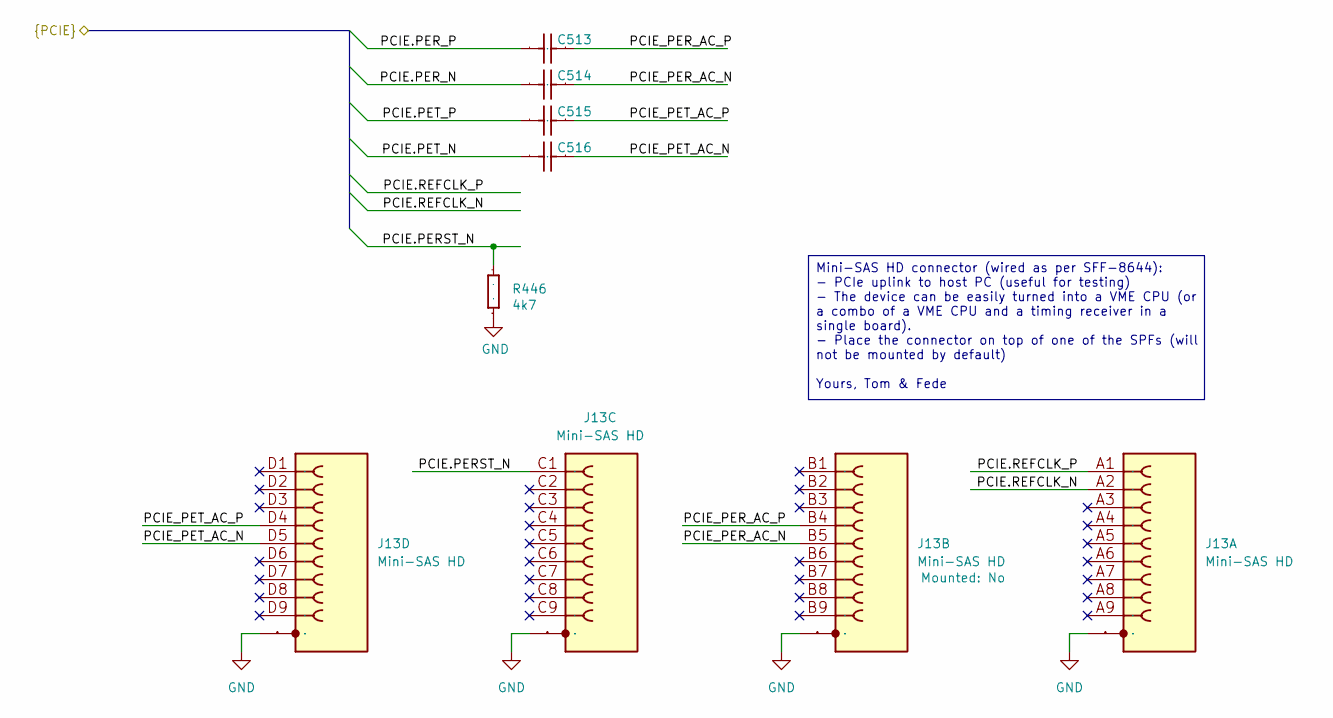
[picture p16: schematic pcie_connector.kicad_sch]

Parts:
C513, C514, C515, C516: CC0402_100NF_16V_10%_X7R; CAPC1005X55N; Voltage 16V; Tolerance ±10%; Part Number CC0402_100NF_16V_10%_X7R
J13: TYCO_2149027-1; Part Number TYCO_2149027-1
R446: R0402_4K7_1%_0.0625W_100PPM; RESC1005X40N; Tolerance ±1%; Part Number R0402_4K7_1%_0.0625W_100PPM

Connections:
GND: J13.SHIELD, R446.1
PCIE.PERST_N: J13.C1 (c1), R446.2
PCIE.PER_N: C514.2
PCIE.PER_P: C513.2
PCIE.PET_N: C516.2
PCIE.PET_P: C515.2
PCIE.REFCLK_N: J13.A2 (a2)
PCIE.REFCLK_P: J13.A1 (a1)
PCIE_PER_AC_N: C514.1, J13.B5 (b5)
PCIE_PER_AC_P: C513.1, J13.B4 (b4)
PCIE_PET_AC_N: C516.1, J13.D5 (d5)
PCIE_PET_AC_P: C515.1, J13.D4 (d4)

Notes on the sheet:
Mini-SAS HD connector (wired as per SFF-8644): - PCIe uplink to host PC (useful for testing) - The device can be easily turned into a VME CPU (or a combo of a VME CPU and a timing receiver in a single board). - Place the connector on top of one of the SPFs (will not be mounted by default) Yours, To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
