ttrain4086-cpu/Kicad-VME-Wren-Update/power-supply-1.kicad_sch

## KiCad design power-supply-1.kicad_sch (2026-05-15)

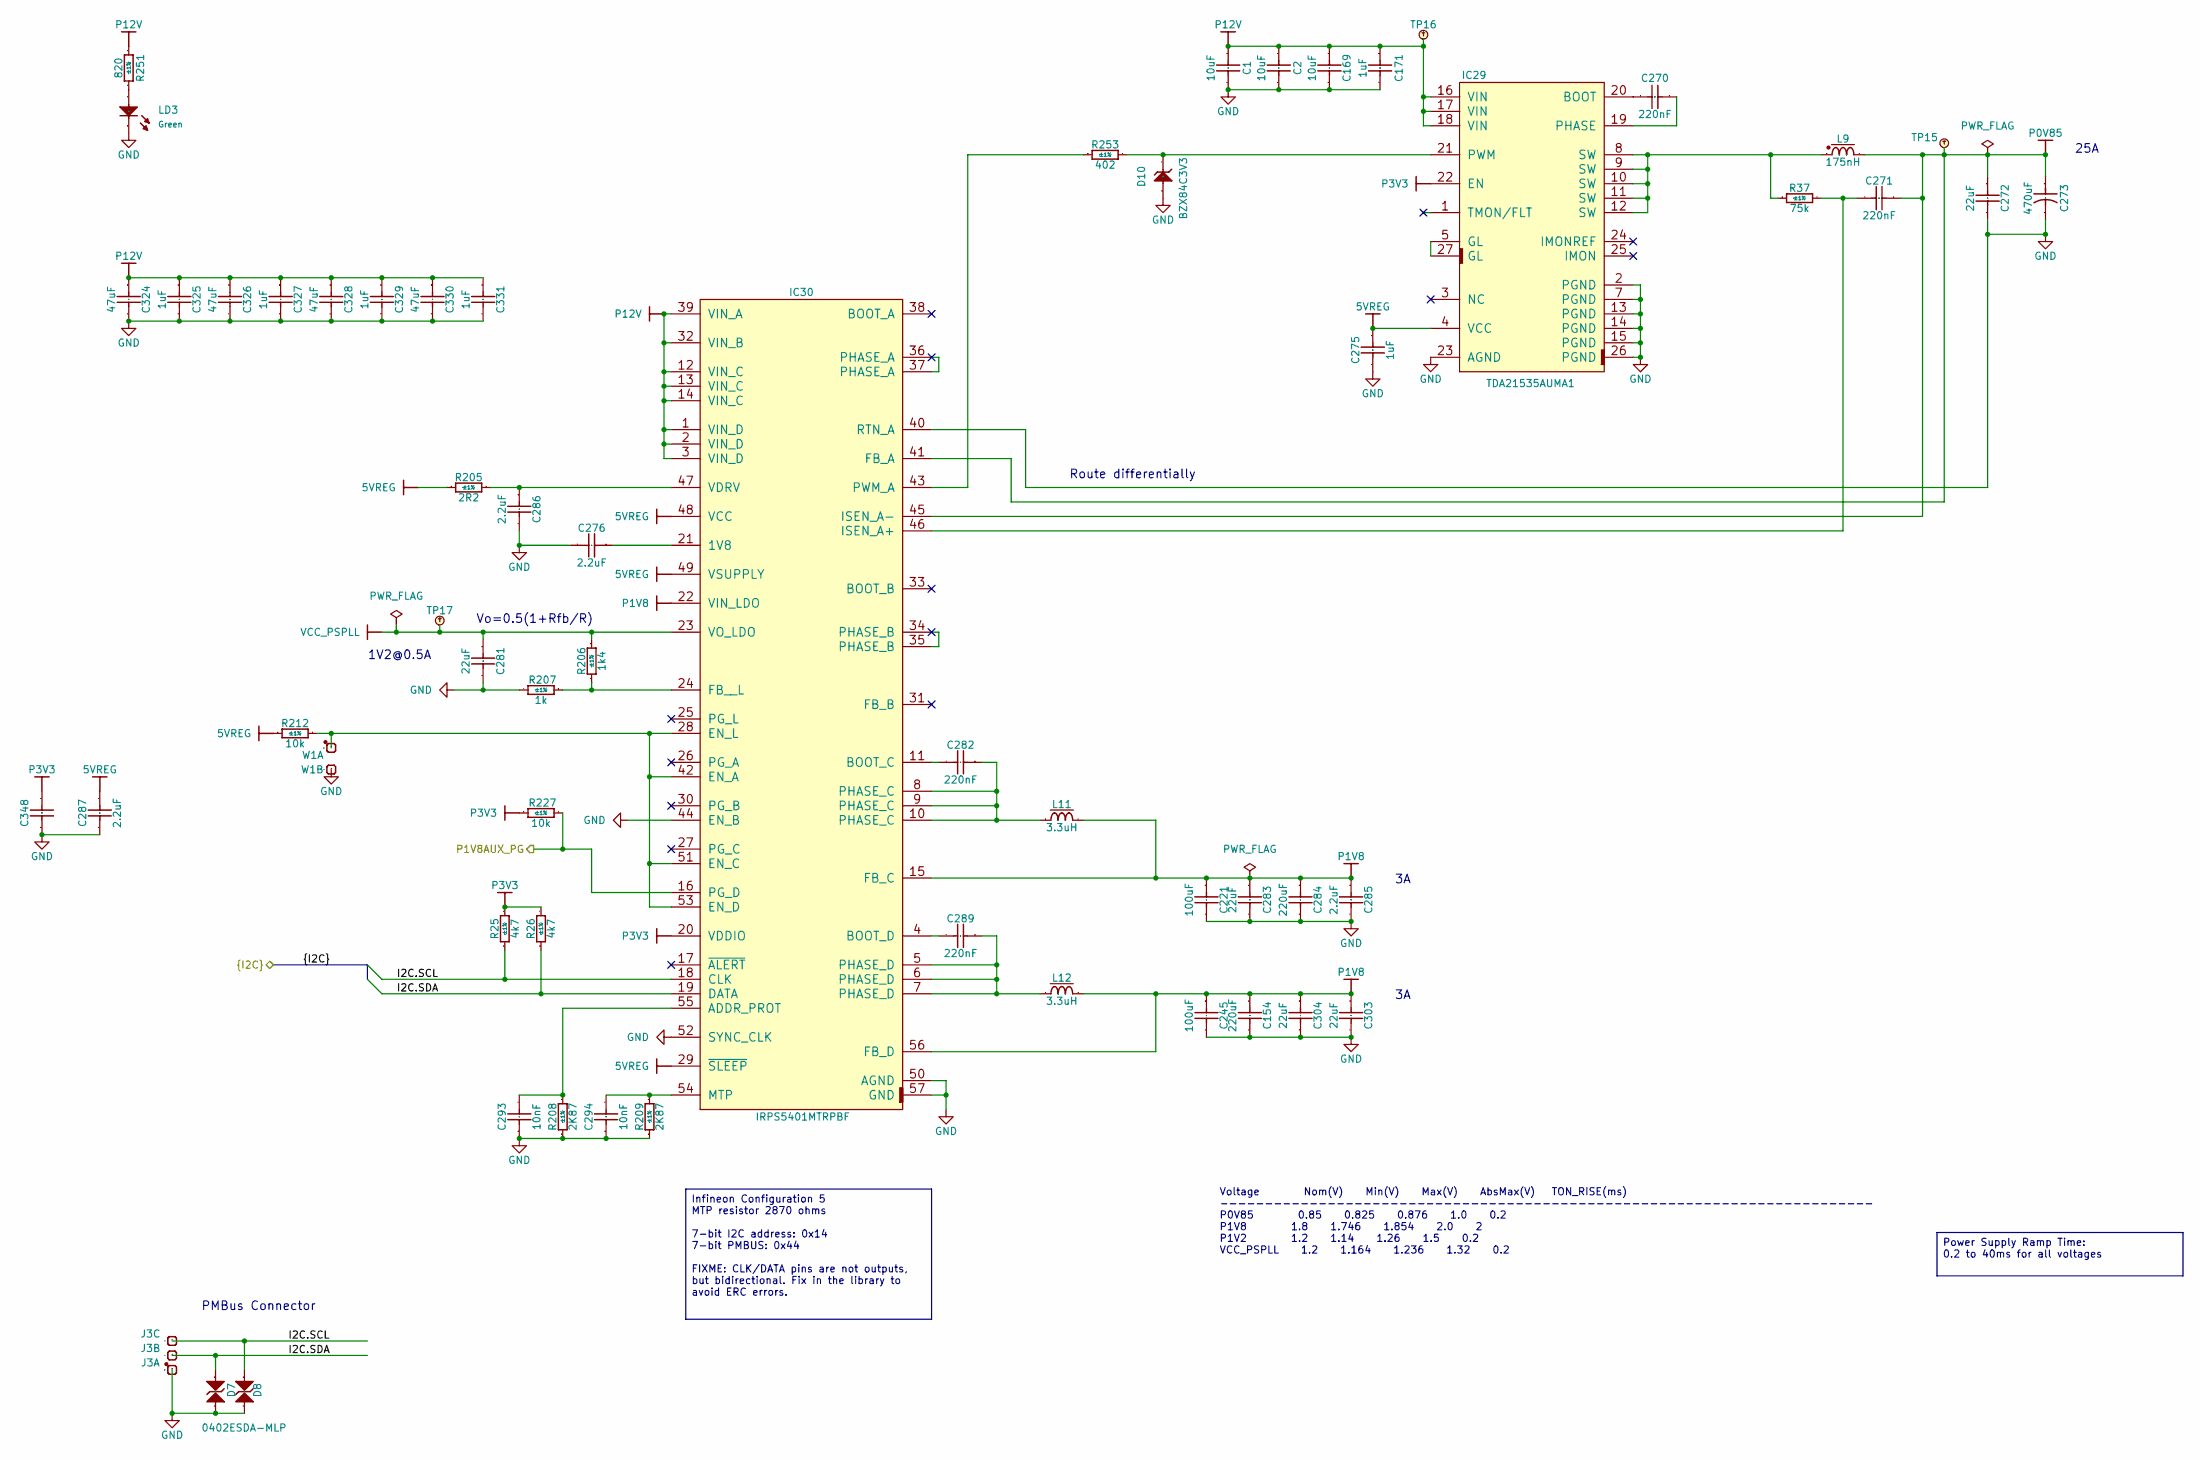
[picture p17: schematic power-supply-1.kicad_sch]

Parts:
C1, C2, C169: CC1206_10UF_25V_10%_X7R; CAPC3216X180N; Voltage 25V; Tolerance ±10%; Part Number CC1206_10UF_25V_10%_X7R
C154, C284: CC1210_220UF_6.3V_20%_X5R; CAPC3225X280N; Voltage 6.3V; Tolerance ±20%; Part Number CC1210_220UF_6.3V_20%_X5R
C171, C275, C325, C327, C329, C331: CC0402_1UF_25V_10%_X5R; CAPC1005X55N; Voltage 25V; Tolerance ±10%; Part Number CC0402_1UF_25V_10%_X5R
C221, C245: CC0805_100UF_4V_20%_X6S_MURATA_GRM21BC80G107ME15; CAPC2013X145N; Voltage 4V; Tolerance ±20%; Part Number CC0805_100UF_4V_20%_X6S_MURATA_GRM21BC8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
C270, C271, C282, C289: CC0402_220NF_16V_10%_X7R; CAPC1005X55N; Voltage 16V; Tolerance ±10%; Part Number CC0402_220NF_16V_10%_X7R
C272, C281, C283, C303, C304: CC0603_22UF_10V_20%_X5R; CAPC1608X90N; Voltage 10V; Tolerance ±20%; Part Number CC0603_22UF_10V_20%_X5R
C273: CAEM7343-20_470UF_2V_20%_LESR0003_PANASONIC_EEFGX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; CAPMP7343X200N; Voltage 2V; Tolerance ±20%; Part Number CAEM7343-20_470UF_2V_20%_LESR0003_PANAS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
C276, C285, C286, C287: CC0402_2.2UF_16V_10%_X5R; CAPC1005X55N; Voltage 16V; Tolerance ±10%; Part Number CC0402_2.2UF_16V_10%_X5R
C293, C294: CC0402_10NF_16V_10%_X7R; CAPC1005X55N; Voltage 16V; Tolerance ±10%; Part Number CC0402_10NF_16V_10%_X7R
C324, C326, C328, C330: CC1206_47UF_25V_20%_X5R; CAPC3216X180N; Voltage 25V; Tolerance ±20%; Part Number CC1206_47UF_25V_20%_X5R
C348: CC0402_100NF_16V_10%_X7R; CAPC1005X55N; Voltage 16V; Tolerance ±10%; Part Number CC0402_100NF_16V_10%_X7R
D7, D8: 0402ESDA-MLP; EATON_0402ESDA-MLP; Voltage 8kV; Part Number 0402ESDA-MLP
D10: BZX84C3V3; SOT95P240X130-3N; Voltage 3V3; Part Number BZX84C3V3
IC29: TDA21535AUMA1; INFINEON_TDA21535; Part Number TDA21535AUMA1
IC30: IRPS5401MTRPBF; INFINEON_PG-VQFN-56-900 (IRPS5401M); Part Number IRPS5401MTRPBF
J3: SAMTEC_MTLW-103-07-L-S-250; Part Number SAMTEC_MTLW-103-07-L-S-250
L9: IND_175NH_15%_PULSE_PA2607.181NL; IND_PULSE_PA2607; Tolerance ±15%; Part Number IND_175NH_15%_PULSE_PA2607.181NL
L11, L12: IND_3.3UH_20%_COILCRAFT_XAL4030; IND_COILCRAFT_XAL4030; Tolerance ±20%; Part Number IND_3.3UH_20%_COILCRAFT_XAL4030
LD3: LED_KINGBRIGHT_KPH-1608CGCK; Part Number LED_KINGBRIGHT_KPH-1608CGCK
R25, R26: R0402_4K7_1%_0.0625W_100PPM; RESC1005X40N; Tolerance ±1%; Part Number R0402_4K7_1%_0.0625W_100PPM
R37: R0402_75K_1%_0.0625W_100PPM; RESC1005X40N; Tolerance ±1%; Part Number R0402_75K_1%_0.0625W_100PPM
R205: R0402_2R2_1%_0.0625W_200PPM; RESC1005X40N; Tolerance ±1%; Part Number R0402_2R2_1%_0.0625W_200PPM
R206: R0402_1K4_1%_0.063W_100PPM; RESC1005X40N; Tolerance ±1%; Part Number R0402_1K4_1%_0.063W_100PPM
R207: R0402_1K_1%_0.0625W_100PPM; RESC1005X40N; Tolerance ±1%; Part Number R0402_1K_1%_0.0625W_100PPM
R208, R209: R0402_2K87_1%_0.063W_100PPM; RESC1005X40N; Tolerance ±1%; Part Number R0402_2K87_1%_0.063W_100PPM
R212, R227: R0402_10K_1%_0.0625W_100PPM; RESC1005X40N; Tolerance ±1%; Part Number R0402_10K_1%_0.0625W_100PPM
R251: R0603_820R_1%_0.1W_100PPM; RESC1608X55N; Tolerance ±1%; Part Number R0603_820R_1%_0.1W_100PPM
R253: R0402_402R_1%_0.063W_100PPM; RESC1005X40N; Tolerance ±1%; Part Number R0402_402R_1%_0.063W_100PPM
TP15, TP16, TP17: Tomachie_TP_N; TPS127
W1: SAMTEC_MTLW-102-07-L-S-250; Part Number SAMTEC_MTLW-102-07-L-S-250

Connections:
5VREG: C275.1, C287.1, IC29.4 (VCC), IC30.29 (~SLEEP), IC30.48 (VCC), IC30.49 (VSUPPLY), R205.1, R212.1
GND: C1.2, C2.2, C154.2, C169.2, C171.2, C221.2, C245.2, C272.2, C273.2, C275.2, C276.2, C281.2, C283.2, C284.2, C285.2, C286.2, C287.2, C293.1, C294.1, C303.2, C304.2, C324.2, C325.2, C326.2, C327.2, C328.2, C329.2, C330.2, C331.2, C348.1, D7.2, D8.2, D10.1 (A), IC29.2 (PGND), IC29.7 (PGND), IC29.13 (PGND), IC29.14 (PGND), IC29.15 (PGND), IC29.23 (AGND), IC29.26 (PGND), IC30.40 (RTN_A), IC30.44 (EN_B), IC30.50 (AGND), IC30.52 (SYNC_CLK), IC30.57 (GND), J3.1, LD3.1 (C), R207.2, R208.1, R209.1, W1.2
I2C.SCL: D8.1, IC30.18 (CLK), J3.3, R25.1
I2C.SDA: D7.1, IC30.19 (DATA), J3.2, R26.1
unnamed: C270.1, IC29.19 (PHASE)
unnamed: C270.2, IC29.20 (BOOT)
unnamed: C271.2, IC30.46 (ISEN_A+), R37.2
unnamed: C276.1, IC30.21 (1V8)
unnamed: C282.1, IC30.8 (PHASE_C), IC30.9 (PHASE_C), IC30.10 (PHASE_C), L11.1
unnamed: C282.2, IC30.11 (BOOT_C)
unnamed: C286.1, IC30.47 (VDRV), R205.2
unnamed: C289.1, IC30.5 (PHASE_D), IC30.6 (PHASE_D), IC30.7 (PHASE_D), L12.1
unnamed: C289.2, IC30.4 (BOOT_D)
unnamed: C293.2, IC30.55 (ADDR_PROT), R208.2
unnamed: C294.2, IC30.54 (MTP), R209.2
unnamed: D10.3 (C), IC29.21 (PWM), R253.2
unnamed: IC29.8 (SW), IC29.9 (SW), IC29.10 (SW), IC29.11 (SW), IC29.12 (SW), L9.1, R37.1
unnamed: IC29.5 (GL), IC29.27 (GL)
unnamed: IC30.24 (FB__L), R206.1, R207.1
unnamed: IC30.28 (EN_L), IC30.42 (EN_A), IC30.51 (EN_C), IC30.53 (EN_D), R212.2, W1.1
unnamed: IC30.34 (PHASE_B), IC30.35 (PHASE_B)
unnamed: IC30.36 (PHASE_A), IC30.37 (PHASE_A)
unnamed: IC30.43 (PWM_A), R253.1
unnamed: LD3.2 (A), R251.2
P0V85: C271.1, C272.1, C273.1, IC30.41 (FB_A), IC30.45 (ISEN_A-), L9.2, TP15.1
P1V8: C154.1, C221.1, C245.1, C283.1, C284.1, C285.1, C303.1, C304.1, IC30.15 (FB_C), IC30.22 (VIN_LDO), IC30.56 (FB_D), L11.2, L12.2
P1V8AUX_PG: IC30.16 (PG_D), R227.2
P3V3: C348.2, IC29.22 (EN), IC30.20 (VDDIO), R25.2, R26.2, R227.1
P12V: C1.1, C2.1, C169.1, C171.1, C324.1, C325.1, C326.1, C327.1, C328.1, C329.1, C330.1, C331.1, IC29.16 (VIN), IC29.17 (VIN), IC29.18 (VIN), IC30.1 (VIN_D), IC30.2 (VIN_D), IC30.3 (VIN_D), IC30.12 (VIN_C), IC30.13 (VIN_C), IC30.14 (VIN_C), IC30.32 (VIN_B), IC30.39 (VIN_A), R251.1, TP16.1
VCC_PSPLL: C281.1, IC30.23 (VO_LDO), R206.2, TP17.1

Notes on the sheet:
PMBus Connector
Route differentially
Vo=0.5(1+Rfb/R)
1V2@0.5A
25A
Voltage Nom(V) Min(V) Max(V) AbsMax(V) TON_RISE(ms) ------------------------------------------------------------------------- P0V85 0.85 0.825 0.876 1.0 0.2 P1V8 1.8 1.746 1.854 2.0 2 P1V2 1.2 1.14 1.26 1.5 0.2 VCC_PSPLL 1.2 1.164 1.236 1.32 0.2
Power Supply Ramp Time: 0.2 to 40ms for all voltages
Infineon Configuration 5 MTP resistor 2870 ohms 7-bit I2C address: 0x14 7-bit PMBUS: 0x44 FIXME: CLK/DATA pins are not outputs, but bidirectional. Fix in the library to avoid ERC errors.
