ttrain4086-cpu/Kicad-VME-Wren-Update/power-supply-2.kicad_sch

## KiCad design power-supply-2.kicad_sch (2026-05-15)

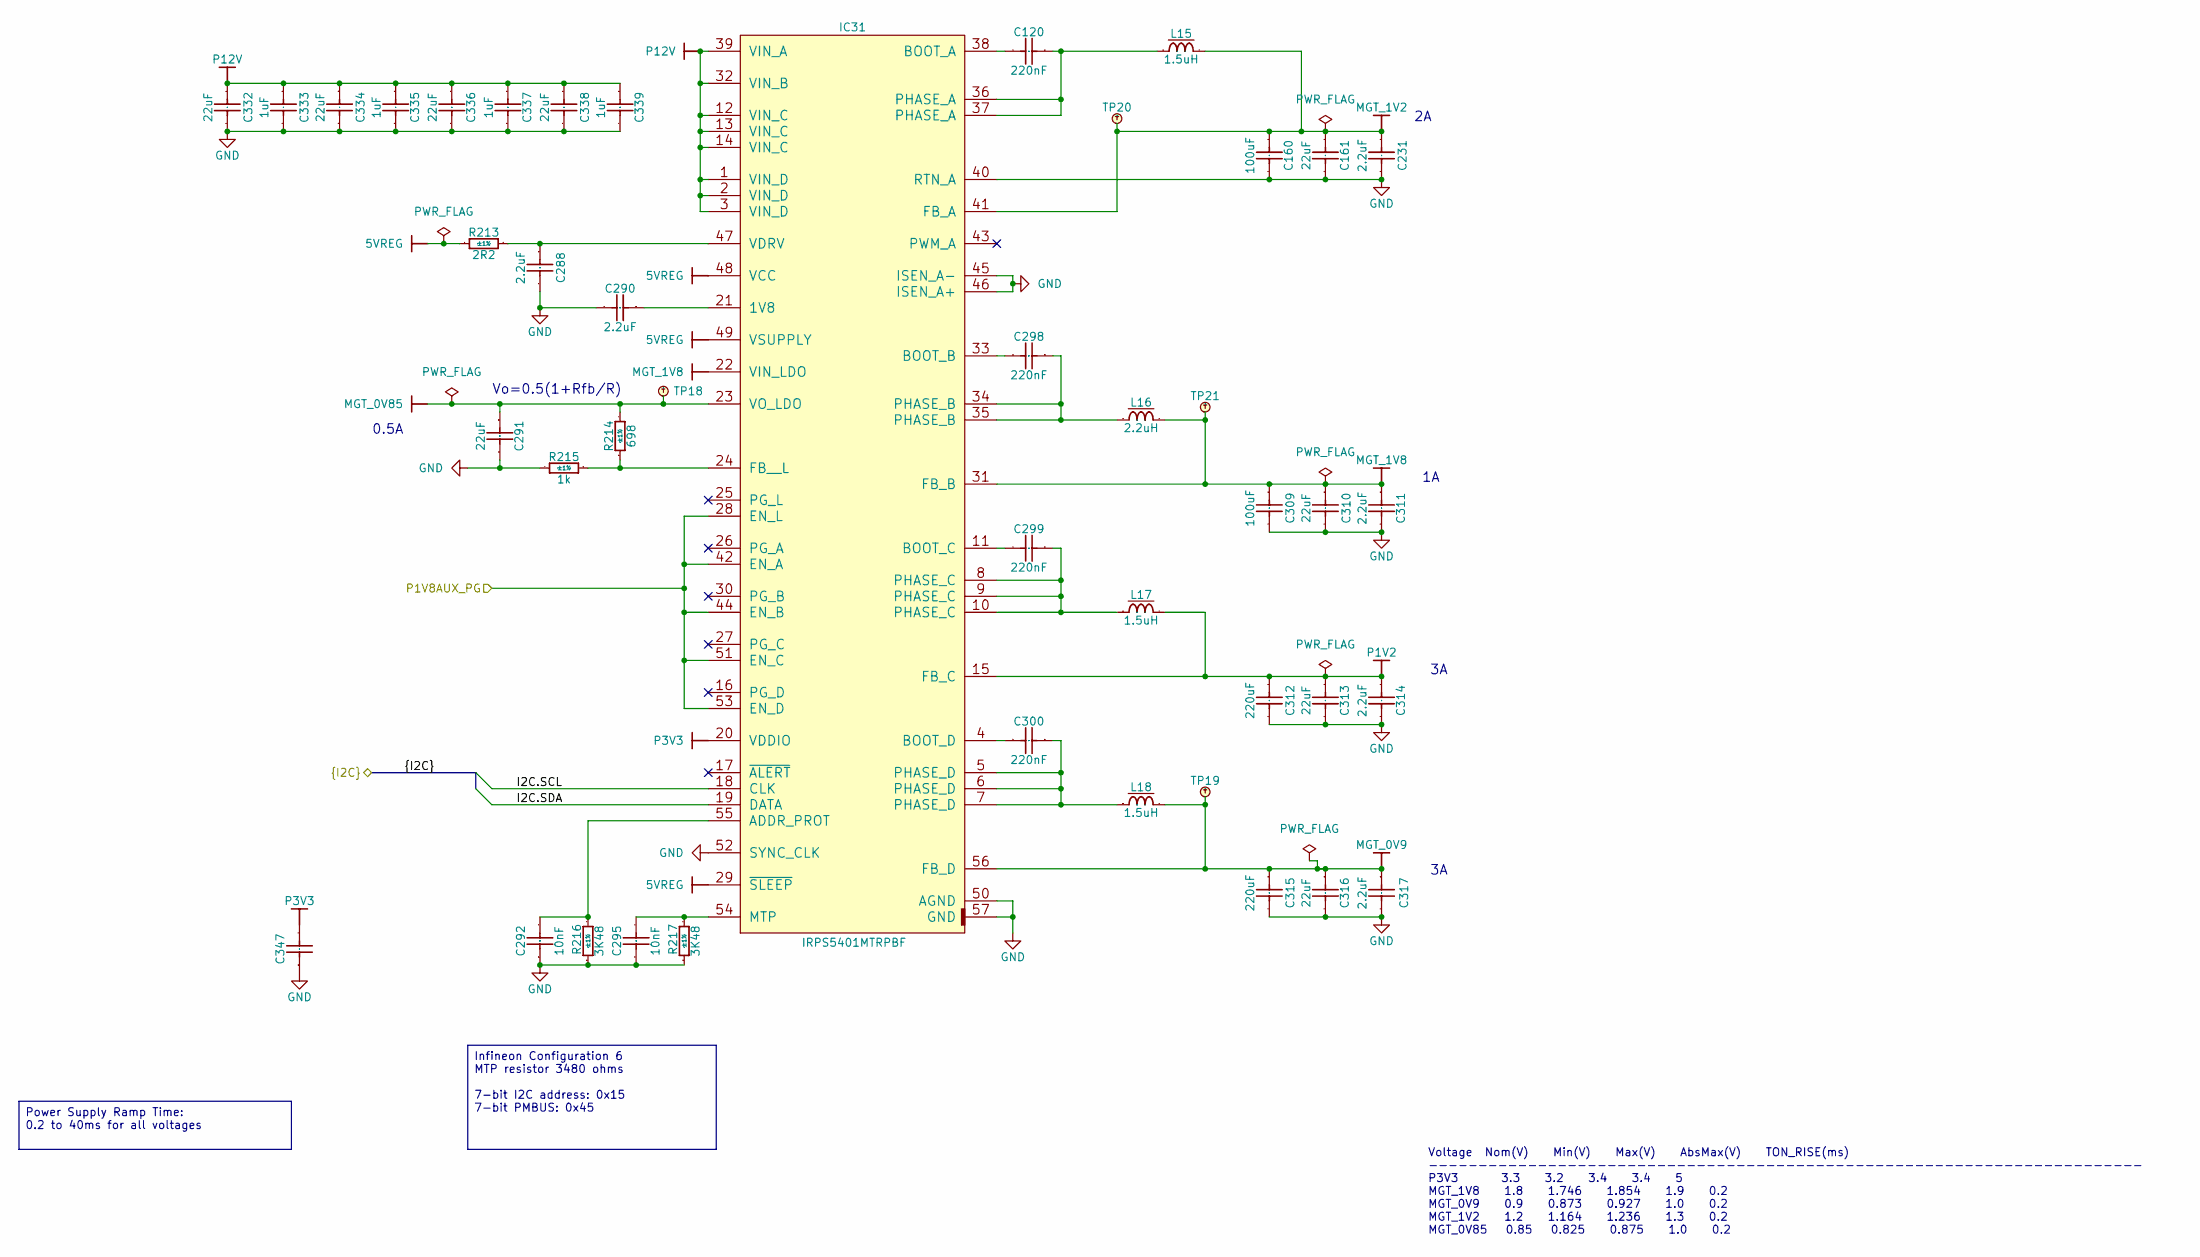
[picture p18: schematic power-supply-2.kicad_sch]

Parts:
C120, C298, C299, C300: CC0402_220NF_16V_10%_X7R; CAPC1005X55N; Voltage 16V; Tolerance ±10%; Part Number CC0402_220NF_16V_10%_X7R
C160, C309: CC0805_100UF_4V_20%_X6S_MURATA_GRM21BC80G107ME15; CAPC2013X145N; Voltage 4V; Tolerance ±20%; Part Number CC0805_100UF_4V_20%_X6S_MURATA_GRM21BC8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
C161, C291, C310, C313, C316: CC0603_22UF_10V_20%_X5R; CAPC1608X90N; Voltage 10V; Tolerance ±20%; Part Number CC0603_22UF_10V_20%_X5R
C231, C288, C290, C311, C314, C317: CC0402_2.2UF_16V_10%_X5R; CAPC1005X55N; Voltage 16V; Tolerance ±10%; Part Number CC0402_2.2UF_16V_10%_X5R
C292, C295: CC0402_10NF_16V_10%_X7R; CAPC1005X55N; Voltage 16V; Tolerance ±10%; Part Number CC0402_10NF_16V_10%_X7R
C312, C315: CC1210_220UF_6.3V_20%_X5R; CAPC3225X280N; Voltage 6.3V; Tolerance ±20%; Part Number CC1210_220UF_6.3V_20%_X5R
C332, C334, C336, C338: CC1206_22UF_25V_20%_X5R; CAPC3216X180N; Voltage 25V; Tolerance ±20%; Part Number CC1206_22UF_25V_20%_X5R
C333, C335, C337, C339: CC0402_1UF_25V_10%_X5R; CAPC1005X55N; Voltage 25V; Tolerance ±10%; Part Number CC0402_1UF_25V_10%_X5R
C347: CC0402_100NF_16V_10%_X7R; CAPC1005X55N; Voltage 16V; Tolerance ±10%; Part Number CC0402_100NF_16V_10%_X7R
IC31: IRPS5401MTRPBF; INFINEON_PG-VQFN-56-900 (IRPS5401M); Part Number IRPS5401MTRPBF
L15, L17, L18: IND_1.5UH_20%_COILCRAFT_XAL4020; IND_COILCRAFT_XAL4020; Tolerance ±20%; Part Number IND_1.5UH_20%_COILCRAFT_XAL4020
L16: IND_2.2UH_20%_COILCRAFT_XAL4020; IND_COILCRAFT_XAL4020; Tolerance ±20%; Part Number IND_2.2UH_20%_COILCRAFT_XAL4020
R213: R0402_2R2_1%_0.0625W_200PPM; RESC1005X40N; Tolerance ±1%; Part Number R0402_2R2_1%_0.0625W_200PPM
R214: R0402_698R_1%_0.063W_100PPM; RESC1005X40N; Tolerance ±1%; Part Number R0402_698R_1%_0.063W_100PPM
R215: R0402_1K_1%_0.0625W_100PPM; RESC1005X40N; Tolerance ±1%; Part Number R0402_1K_1%_0.0625W_100PPM
R216, R217: R0402_3K48_1%_0.063W_100PPM; RESC1005X40N; Tolerance ±1%; Part Number R0402_3K48_1%_0.063W_100PPM
TP18, TP19, TP20, TP21: Tomachie_TP_N; TPS127

Connections:
5VREG: IC31.29 (~SLEEP), IC31.48 (VCC), IC31.49 (VSUPPLY), R213.1
GND: C160.2, C161.2, C231.2, C288.2, C290.2, C291.2, C292.1, C295.1, C309.2, C310.2, C311.2, C312.2, C313.2, C314.2, C315.2, C316.2, C317.2, C332.2, C333.2, C334.2, C335.2, C336.2, C337.2, C338.2, C339.2, C347.1, IC31.40 (RTN_A), IC31.45 (ISEN_A-), IC31.46 (ISEN_A+), IC31.50 (AGND), IC31.52 (SYNC_CLK), IC31.57 (GND), R215.2, R216.1, R217.1
I2C.SCL: IC31.18 (CLK)
I2C.SDA: IC31.19 (DATA)
MGT_0V9: C315.1, C316.1, C317.1, IC31.56 (FB_D), L18.2, TP19.1
MGT_0V85: C291.1, IC31.23 (VO_LDO), R214.2, TP18.1
MGT_1V2: C160.1, C161.1, C231.1, IC31.41 (FB_A), L15.2, TP20.1
MGT_1V8: C309.1, C310.1, C311.1, IC31.22 (VIN_LDO), IC31.31 (FB_B), L16.2, TP21.1
unnamed: C120.1, IC31.36 (PHASE_A), IC31.37 (PHASE_A), L15.1
unnamed: C120.2, IC31.38 (BOOT_A)
unnamed: C288.1, IC31.47 (VDRV), R213.2
unnamed: C290.1, IC31.21 (1V8)
unnamed: C292.2, IC31.55 (ADDR_PROT), R216.2
unnamed: C295.2, IC31.54 (MTP), R217.2
unnamed: C298.1, IC31.34 (PHASE_B), IC31.35 (PHASE_B), L16.1
unnamed: C298.2, IC31.33 (BOOT_B)
unnamed: C299.1, IC31.8 (PHASE_C), IC31.9 (PHASE_C), IC31.10 (PHASE_C), L17.1
unnamed: C299.2, IC31.11 (BOOT_C)
unnamed: C300.1, IC31.5 (PHASE_D), IC31.6 (PHASE_D), IC31.7 (PHASE_D), L18.1
unnamed: C300.2, IC31.4 (BOOT_D)
unnamed: IC31.24 (FB__L), R214.1, R215.1
P1V2: C312.1, C313.1, C314.1, IC31.15 (FB_C), L17.2
P1V8AUX_PG: IC31.28 (EN_L), IC31.42 (EN_A), IC31.44 (EN_B), IC31.51 (EN_C), IC31.53 (EN_D)
P3V3: C347.2, IC31.20 (VDDIO)
P12V: C332.1, C333.1, C334.1, C335.1, C336.1, C337.1, C338.1, C339.1, IC31.1 (VIN_D), IC31.2 (VIN_D), IC31.3 (VIN_D), IC31.12 (VIN_C), IC31.13 (VIN_C), IC31.14 (VIN_C), IC31.32 (VIN_B), IC31.39 (VIN_A)

Notes on the sheet:
0.5A
Vo=0.5(1+Rfb/R)
Infineon Configuration 6 MTP resistor 3480 ohms 7-bit I2C address: 0x15 7-bit PMBUS: 0x45
Power Supply Ramp Time: 0.2 to 40ms for all voltages
Voltage Nom(V) Min(V) Max(V) AbsMax(V) TON_RISE(ms) ------------------------------------------------------------------------ P3V3 3.3 3.2 3.4 3.4 5 MGT_1V8 1.8 1.746 1.854 1.9 0.2 MGT_0V9 0.9 0.873 0.927 1.0 0.2 MGT_1V2 1.2 1.164 1.236 1.3 0.2 MGT_0V85 0.85 0.825 0.875 1.0 0.2
