ttrain4086-cpu/Kicad-VME-Wren-Update/power-supply-3.kicad_sch

## KiCad design power-supply-3.kicad_sch (2026-05-15)

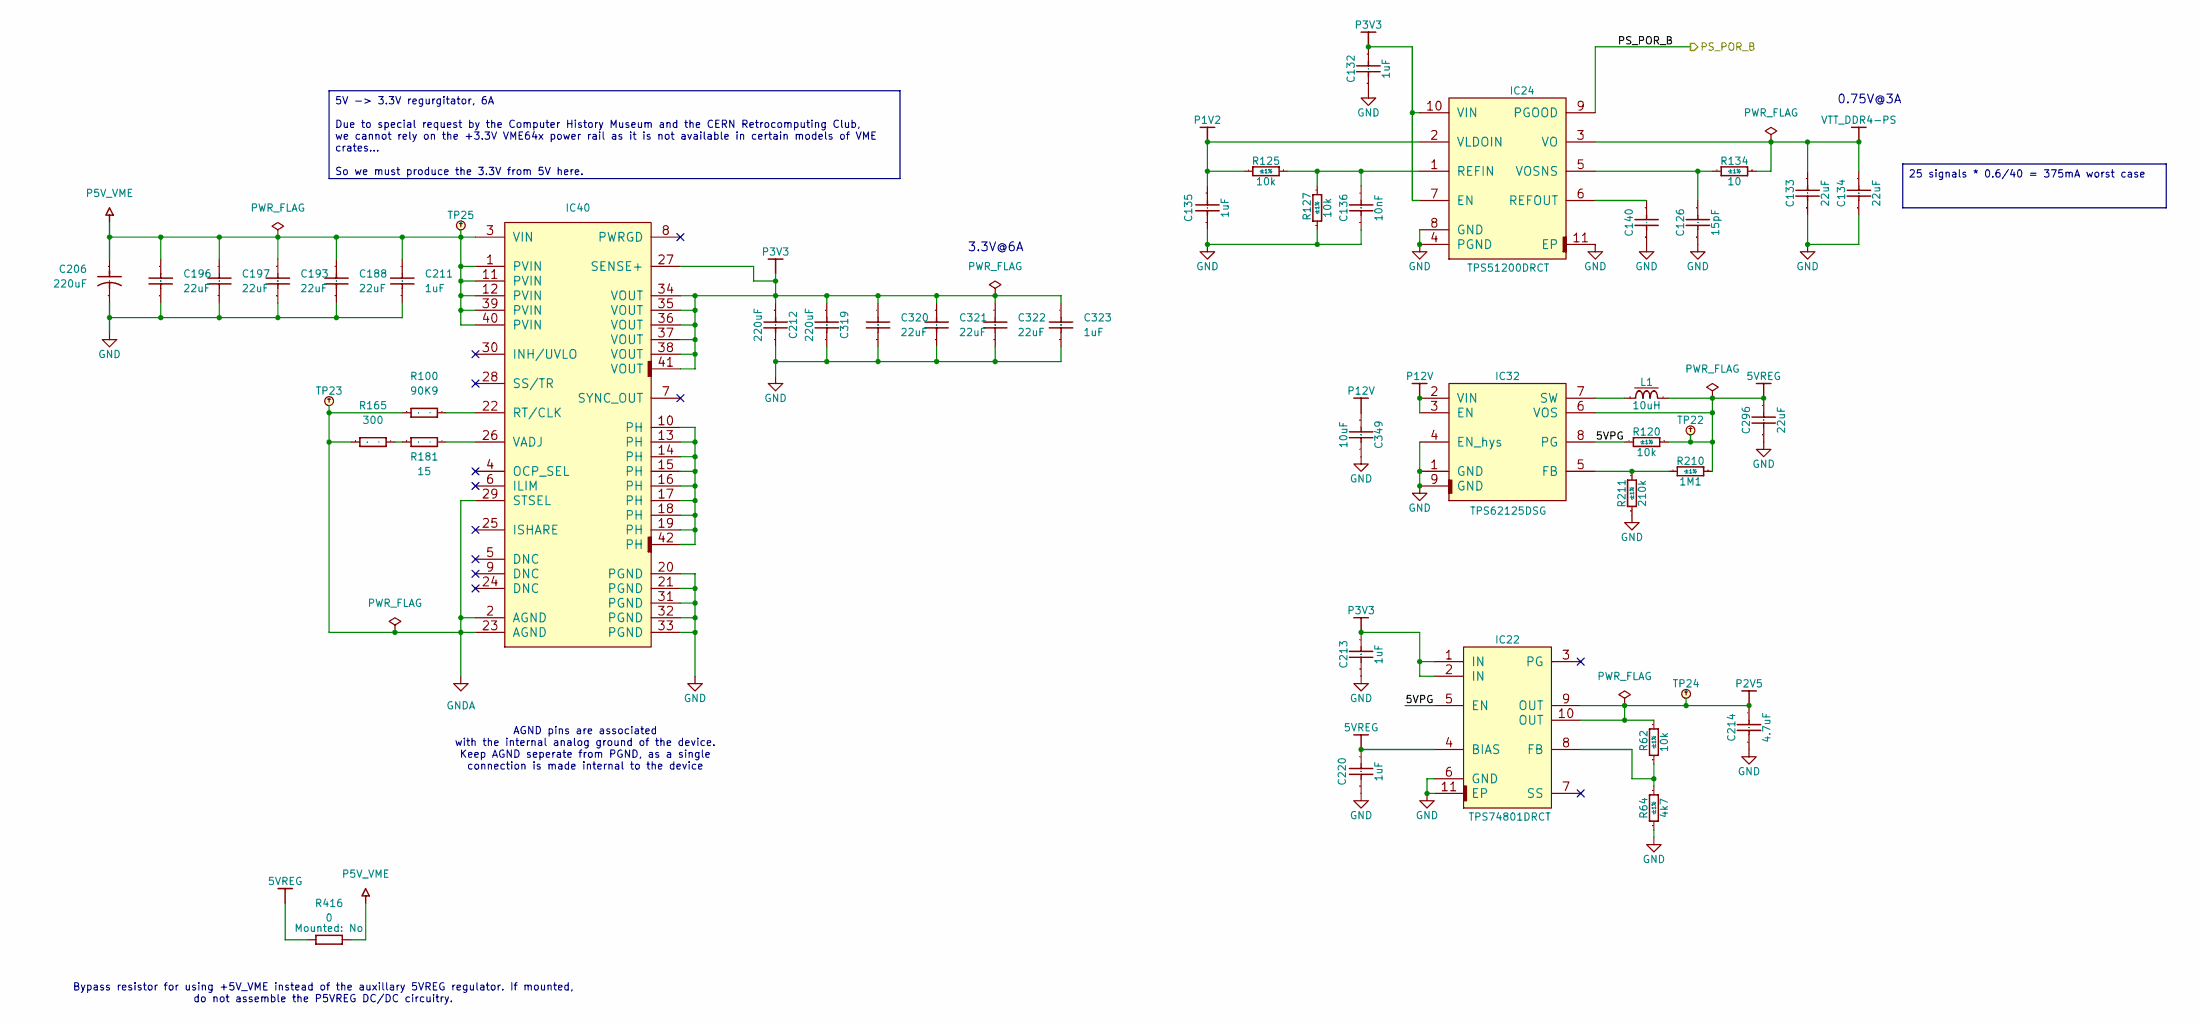
[picture p19: schematic power-supply-3.kicad_sch]

Parts:
C126: CC0402_15PF_50V_5%_C0G; CAPC1005X55N; Voltage 50V; Tolerance ±5%; Part Number CC0402_15PF_50V_5%_C0G
C132, C135, C211, C213, C220, C323: CC0402_1UF_25V_10%_X5R; CAPC1005X55N; Voltage 25V; Tolerance ±10%; Part Number CC0402_1UF_25V_10%_X5R
C133, C134, C188, C193, C196, C197, C296, C320, C321, C322: CC0603_22UF_10V_20%_X5R; CAPC1608X90N; Voltage 10V; Tolerance ±20%; Part Number CC0603_22UF_10V_20%_X5R
C136: CC0402_10NF_16V_10%_X7R; CAPC1005X55N; Voltage 16V; Tolerance ±10%; Part Number CC0402_10NF_16V_10%_X7R
C140: CC0402_100NF_16V_10%_X7R; CAPC1005X55N; Voltage 16V; Tolerance ±10%; Part Number CC0402_100NF_16V_10%_X7R
C206: CAER_220UF_16V_20%_PANASONIC_16SEPC220MD; CAPPR350-850X700_A; Voltage 16V; Tolerance ±20%; Part Number CAER_220UF_16V_20%_PANASONIC_16SEPC220MD
C212, C319: CC1210_220UF_6.3V_20%_X5R; CAPC3225X280N; Voltage 6.3V; Tolerance ±20%; Part Number CC1210_220UF_6.3V_20%_X5R
C214: CC0402_4.7UF_6.3V_20%_X5R; CAPC1005X55N; Voltage 6.3V; Tolerance ±20%; Part Number CC0402_4.7UF_6.3V_20%_X5R
C349: CC1206_10UF_25V_10%_X7R; CAPC3216X180N; Voltage 25V; Tolerance ±10%; Part Number CC1206_10UF_25V_10%_X7R
IC22: TPS74801DRCT; TEXAS_DRC (S-PVSON-N10); Part Number TPS74801DRCT
IC24: TPS51200DRCT; TEXAS_DRC (S-PVSON-N10); Part Number TPS51200DRCT
IC32: TPS62125DSG; SON50P200X200X80-9N-R100X170; Part Number TPS62125DSG
IC40: LMZ31704RVQT; TEXAS_RVQ (S-PB3QFN-N42); Part Description 4A SIMPLE SWITCHER® Power Module with 2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
L1: IND_10UH_20%_TDK_VLCF5020-1; IND_TDK_VLCF5020-1; Tolerance ±20%; Part Number IND_10UH_20%_TDK_VLCF5020-1
R62, R120, R125, R127: R0402_10K_1%_0.0625W_100PPM; RESC1005X40N; Tolerance ±1%; Part Number R0402_10K_1%_0.0625W_100PPM
R64: R0402_4K7_1%_0.0625W_100PPM; RESC1005X40N; Tolerance ±1%; Part Number R0402_4K7_1%_0.0625W_100PPM
R100: R0402_90K9_1%_0.063W_100PPM; RESC1005X40N; Tolerance ±1%; Part Number R0402_90K9_1%_0.063W_100PPM
R134: R0402_10R_1%_0.0625W_200PPM; RESC1005X40N; Tolerance ±1%; Part Number R0402_10R_1%_0.0625W_200PPM
R165: R0402_300R_1%_0.0625W_100PPM; RESC1005X40N; Tolerance ±1%; Part Number R0402_300R_1%_0.0625W_100PPM
R181: R0603_15R_1%_0.1W_100PPM; RESC1608X55N; Tolerance ±1%; Part Number R0603_15R_1%_0.1W_100PPM
R210: R0402_1M1_1%_0.0625W_100PPM; RESC1005X40N; Tolerance ±1%; Part Number R0402_1M1_1%_0.0625W_100PPM
R211: R0402_210K_1%_0.063W_100PPM; RESC1005X40N; Tolerance ±1%; Part Number R0402_210K_1%_0.063W_100PPM
R416: R1206_0R_JUMPER; RESC3216X65N; Part Number R1206_0R_JUMPER
TP22, TP23, TP24, TP25: Tomachie_TP_N; TPS127

Connections:
5VPG: IC22.5 (EN), IC32.8 (PG), R120.2
5VREG: C220.2, C296.2, IC22.4 (BIAS), IC32.6 (VOS), L1.2, R120.1, R210.1, R416.1, TP22.1
GND: C126.1, C132.1, C133.1, C134.1, C135.1, C136.1, C140.1, C188.1, C193.1, C196.1, C197.1, C206.2, C211.1, C212.2, C213.1, C214.1, C220.1, C296.1, C319.2, C320.1, C321.1, C322.1, C323.1, C349.2, IC22.6 (GND), IC22.11 (EP), IC24.4 (PGND), IC24.8 (GND), IC24.11 (EP), IC32.1 (GND), IC32.4 (EN_hys), IC32.9 (GND), IC40.20 (PGND), IC40.21 (PGND), IC40.31 (PGND), IC40.32 (PGND), IC40.33 (PGND), R64.1, R127.1, R211.1
GNDA: IC40.2 (AGND), IC40.23 (AGND), IC40.29 (STSEL), R100.1, R165.1, TP23.1
unnamed: C126.2, IC24.5 (VOSNS), R134.2
unnamed: C136.2, IC24.1 (REFIN), R125.1, R127.2
unnamed: C140.2, IC24.6 (REFOUT)
unnamed: IC22.8 (FB), R62.1, R64.2
unnamed: IC32.5 (FB), R210.2, R211.2
unnamed: IC32.7 (SW), L1.1
unnamed: IC40.10 (PH), IC40.13 (PH), IC40.14 (PH), IC40.15 (PH), IC40.16 (PH), IC40.17 (PH), IC40.18 (PH), IC40.19 (PH), IC40.42 (PH)
unnamed: IC40.22 (RT/CLK), R100.2
unnamed: IC40.26 (VADJ), R181.2
unnamed: R165.2, R181.1
P1V2: C135.2, IC24.2 (VLDOIN), R125.2
P2V5: C214.2, IC22.9 (OUT), IC22.10 (OUT), R62.2, TP24.1
P3V3: C132.2, C212.1, C213.2, C319.1, C320.2, C321.2, C322.2, C323.2, IC22.1 (IN), IC22.2 (IN), IC24.7 (EN), IC24.10 (VIN), IC40.27 (SENSE+), IC40.34 (VOUT), IC40.35 (VOUT), IC40.36 (VOUT), IC40.37 (VOUT), IC40.38 (VOUT), IC40.41 (VOUT)
P5V_VME: C188.2, C193.2, C196.2, C197.2, C206.1, C211.2, IC40.1 (PVIN), IC40.3 (VIN), IC40.11 (PVIN), IC40.12 (PVIN), IC40.39 (PVIN), IC40.40 (PVIN), R416.2, TP25.1
P12V: C349.1, IC32.2 (VIN), IC32.3 (EN)
PS_POR_B: IC24.9 (PGOOD)
VTT_DDR4-PS: C133.2, C134.2, IC24.3 (VO), R134.1

Notes on the sheet:
3.3V@6A
AGND pins are associated with the internal analog ground of the device. Keep AGND seperate from PGND, as a single connection is made internal to the device
Bypass resistor for using +5V_VME instead of the auxillary 5VREG regulator. If mounted, do not assemble the P5VREG DC/DC circuitry.
0.75V@3A
25 signals * 0.6/40 = 375mA worst case
5V -> 3.3V regurgitator, 6A Due to special request by the Computer History Museum and the CERN Retrocomputing Club, we cannot rely on the +3.3V VME64x power rail as it is not available in certain models of VME crates... So we must produce the 3.3V from 5V here.
