ttrain4086-cpu/Kicad-VME-Wren-Update/pp_driver_2x.kicad_sch

## KiCad design pp_driver_2x.kicad_sch (2026-05-15)

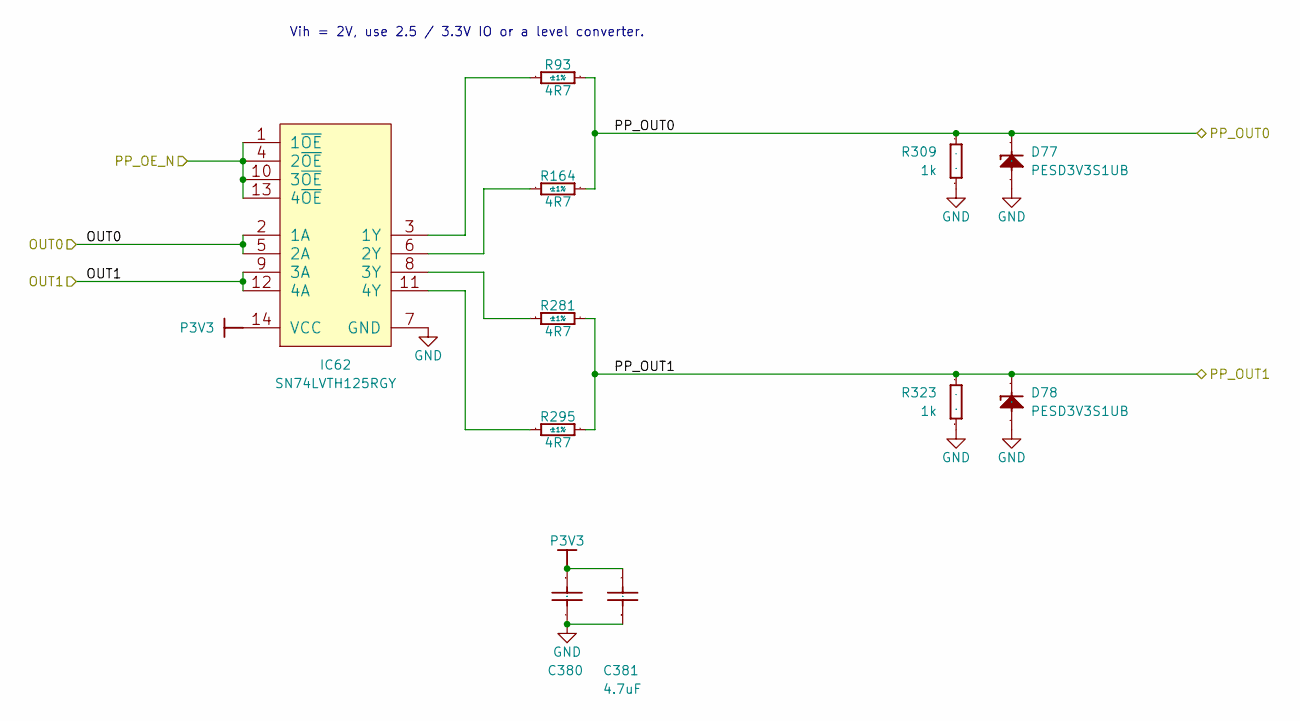
[picture p20: schematic pp_driver_2x.kicad_sch]

Parts:
C380: CC0402_100NF_16V_10%_X7R; CAPC1005X55N; Voltage 16V; Tolerance ±10%; Part Number CC0402_100NF_16V_10%_X7R
C381: CC0402_4.7UF_6.3V_20%_X5R; CAPC1005X55N; Voltage 6.3V; Tolerance ±20%; Part Number CC0402_4.7UF_6.3V_20%_X5R
D77, D78: PESD3V3S1UB; SODFL1608X65N; Voltage 3V3; Part Number PESD3V3S1UB
IC62: SN74LVTH125RGY; TEXAS_RGY (S-PVQFN-N14); Part Number SN74LVTH125RGY
R93, R164, R281, R295: R0402_4R7_1%_0.0625W_200PPM; RESC1005X40N; Tolerance ±1%; Part Number R0402_4R7_1%_0.0625W_200PPM
R309, R323: R0402_1K_1%_0.0625W_100PPM; RESC1005X40N; Tolerance ±1%; Part Number R0402_1K_1%_0.0625W_100PPM

Connections:
GND: C380.2, C381.1, D77.2 (A), D78.2 (A), IC62.7 (GND), R309.1, R323.1
unnamed: IC62.3 (1Y), R93.1
unnamed: IC62.6 (2Y), R164.1
unnamed: IC62.8 (3Y), R281.1
unnamed: IC62.11 (4Y), R295.1
OUT0: IC62.2 (1A), IC62.5 (2A)
OUT1: IC62.9 (3A), IC62.12 (4A)
P3V3: C380.1, C381.2, IC62.14 (VCC)
PP_OE_N: IC62.1 (1~OE), IC62.4 (2~OE), IC62.10 (3~OE), IC62.13 (4~OE)
PP_OUT0: D77.1 (C), R93.2, R164.2, R309.2
PP_OUT1: D78.1 (C), R281.2, R295.2, R323.2

Notes on the sheet:
Vih = 2V, use 2.5 / 3.3V IO or a level converter.
