ttrain4086-cpu/Kicad-VME-Wren-Update/pp_driver_8x.kicad_sch

## KiCad design pp_driver_8x.kicad_sch (2026-05-15)

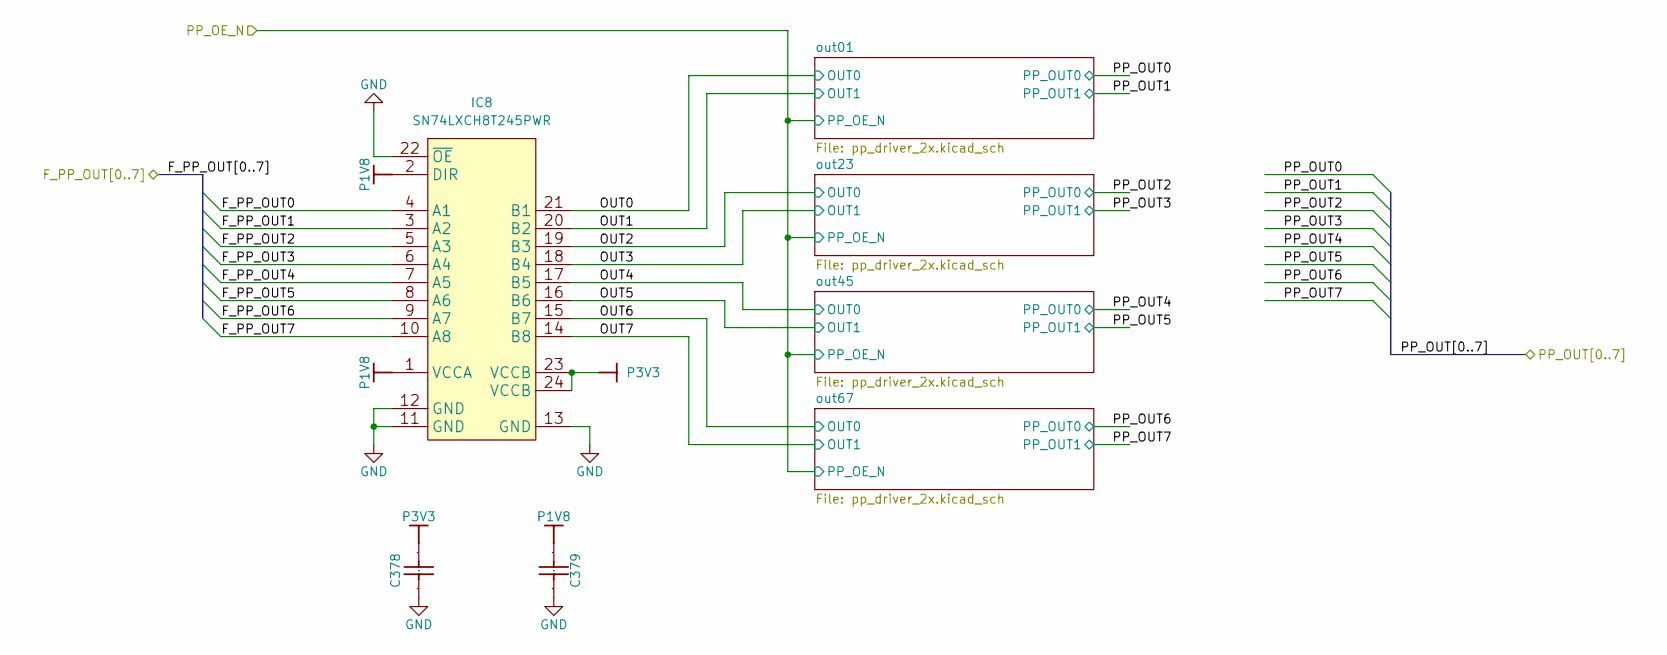
[picture p21: schematic pp_driver_8x.kicad_sch]

Parts:
C378, C379: CC0402_100NF_16V_10%_X7R; CAPC1005X55N; Voltage 16V; Tolerance ±10%; Part Number CC0402_100NF_16V_10%_X7R
IC8: SN74LXCH8T245PWR; SOP65P640X120-24N

Connections:
F_PP_OUT0: IC8.4 (A1)
F_PP_OUT1: IC8.3 (A2)
F_PP_OUT2: IC8.5 (A3)
F_PP_OUT3: IC8.6 (A4)
F_PP_OUT4: IC8.7 (A5)
F_PP_OUT5: IC8.8 (A6)
F_PP_OUT6: IC8.9 (A7)
F_PP_OUT7: IC8.10 (A8)
GND: C378.2, C379.2, IC8.11 (GND), IC8.12 (GND), IC8.13 (GND), IC8.22 (~OE)
OUT0: IC8.21 (B1)
OUT1: IC8.20 (B2)
OUT2: IC8.19 (B3)
OUT3: IC8.18 (B4)
OUT4: IC8.17 (B5)
OUT5: IC8.16 (B6)
OUT6: IC8.15 (B7)
OUT7: IC8.14 (B8)
P1V8: C379.1, IC8.1 (VCCA), IC8.2 (DIR)
P3V3: C378.1, IC8.23 (VCCB), IC8.24 (VCCB)
