ttrain4086-cpu/Kicad-VME-Wren-Update/sfp+.kicad_sch

## KiCad design sfp+.kicad_sch (2026-05-15)

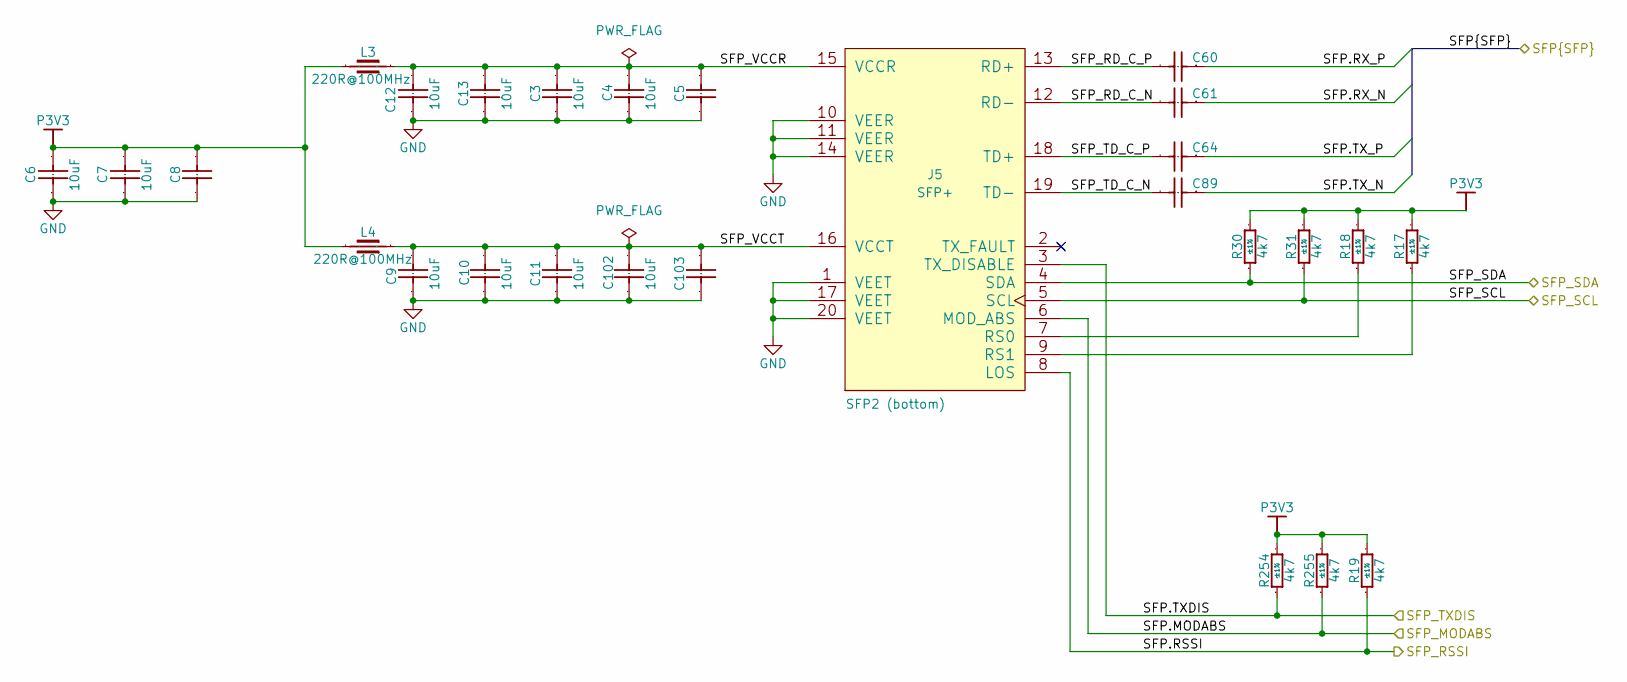
[picture p22: schematic sfp+.kicad_sch]

Parts:
C3, C4, C6, C7, C9, C10, C11, C12, C13, C102: CC0402_10UF_6.3V_20%_X5R; CAPC1005X70N; Voltage 6.3V; Tolerance ±10%; Part Number CC0402_10UF_6.3V_20%_X5R
C5, C8, C60, C61, C64, C89, C103: CC0402_100NF_16V_10%_X7R; CAPC1005X55N; Voltage 16V; Tolerance ±10%; Part Number CC0402_100NF_16V_10%_X7R
J5: SFP2 (bottom); TYCO_1888247-1; Part Number TYCO_1888247-1
L3, L4: IND0805_MURATA_BLM21PG221SN1D; INDC2012X105N; Tolerance ±25%; Part Number IND0805_MURATA_BLM21PG221SN1D
R17, R18, R19, R30, R31, R254, R255: R0402_4K7_1%_0.0625W_100PPM; RESC1005X40N; Tolerance ±1%; Part Number R0402_4K7_1%_0.0625W_100PPM

Connections:
GND: C3.1, C4.1, C5.2, C6.1, C7.1, C8.2, C9.1, C10.1, C11.1, C12.1, C13.1, C102.1, C103.2, J5.1 (VEET), J5.10 (VEER), J5.11 (VEER), J5.14 (VEER), J5.17 (VEET), J5.20 (VEET)
unnamed: J5.7 (RS0), R18.1
unnamed: J5.9 (RS1), R17.1
P3V3: C6.2, C7.2, C8.1, L3.2, L4.2, R17.2, R18.2, R19.2, R30.2, R31.2, R254.2, R255.2
SFP.MODABS: J5.6 (MOD_ABS), R255.1
SFP.RSSI: J5.8 (LOS), R19.1
SFP.RX_N: C61.1
SFP.RX_P: C60.1
SFP.TXDIS: J5.3 (TX_DISABLE), R254.1
SFP.TX_N: C89.1
SFP.TX_P: C64.1
SFP_RD_C_N: C61.2, J5.12 (RD-)
SFP_RD_C_P: C60.2, J5.13 (RD+)
SFP_SCL: J5.5 (SCL), R31.1
SFP_SDA: J5.4 (SDA), R30.1
SFP_TD_C_N: C89.2, J5.19 (TD-)
SFP_TD_C_P: C64.2, J5.18 (TD+)
SFP_VCCR: C3.2, C4.2, C5.1, C12.2, C13.2, J5.15 (VCCR), L3.1
SFP_VCCT: C9.2, C10.2, C11.2, C102.2, C103.1, J5.16 (VCCT), L4.1
