ttrain4086-cpu/Kicad-VME-Wren-Update/slow_gpio.kicad_sch

## KiCad design slow_gpio.kicad_sch (2026-05-15)

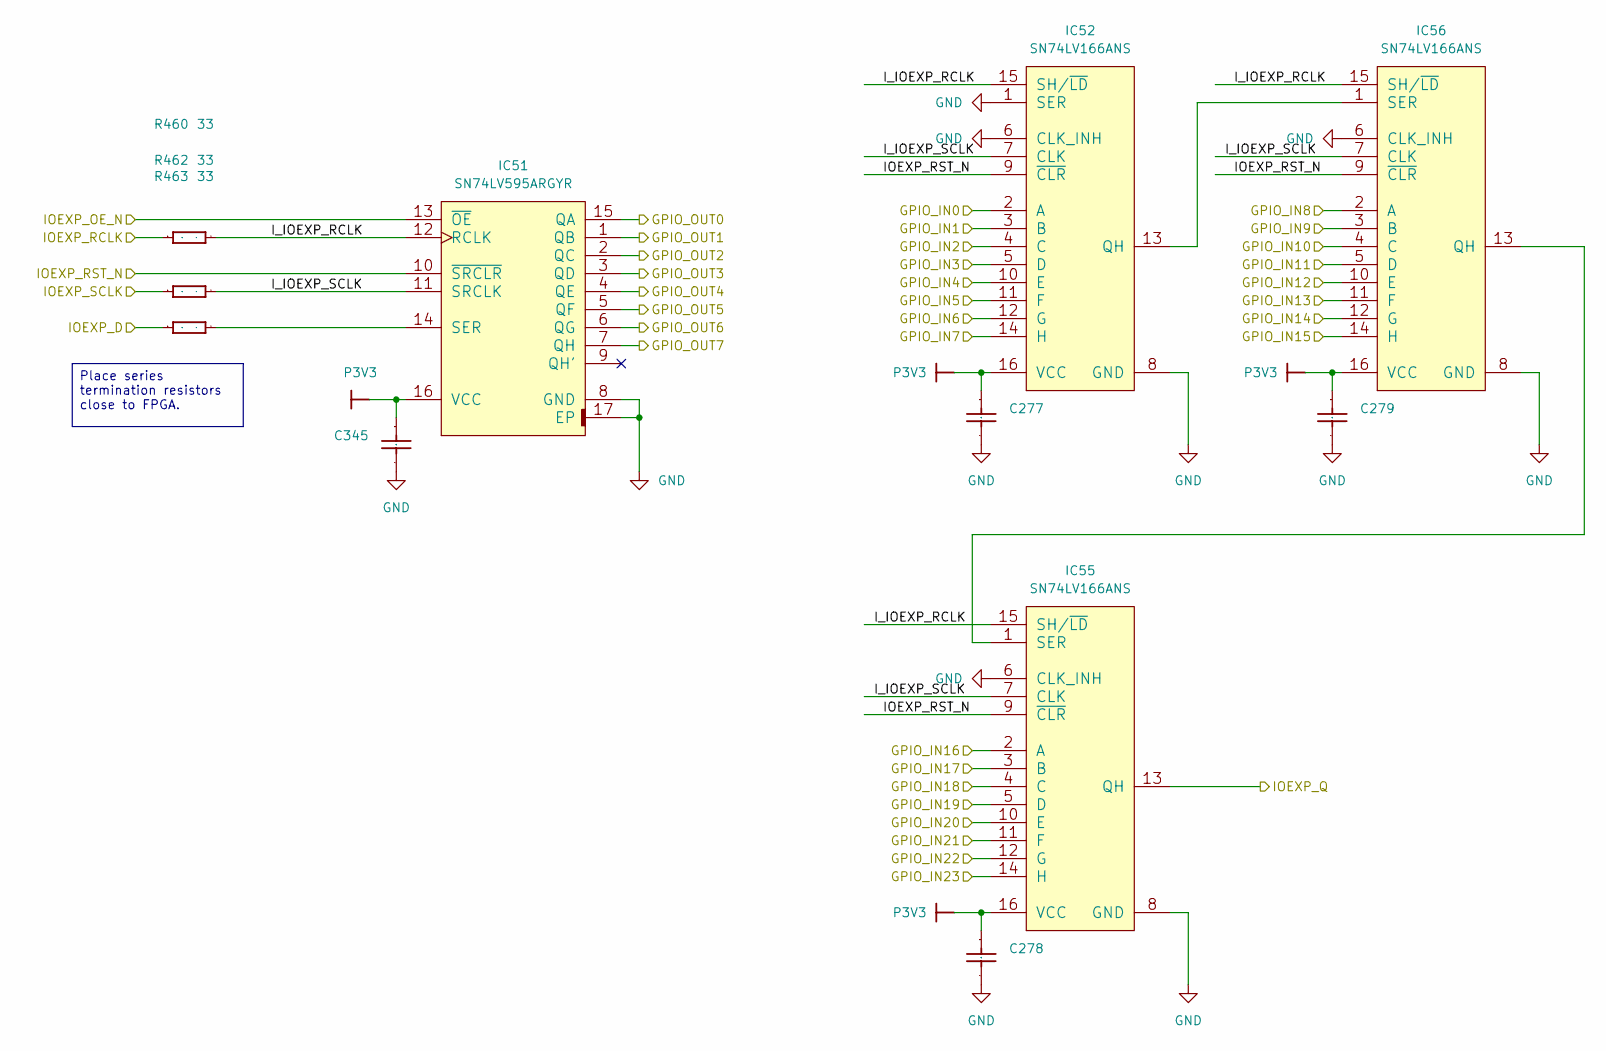
[picture p23: schematic slow_gpio.kicad_sch]

Parts:
C277, C278, C279, C345: CC0402_100NF_16V_10%_X7R; CAPC1005X55N; Voltage 16V; Tolerance ±10%; Part Number CC0402_100NF_16V_10%_X7R
IC51: SN74LV595ARGYR; TEXAS_RGY (R-PVQFN-N16); Part Description 8-Bit Shift Register with 3-State Outpu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
IC52, IC55, IC56: SN74LV166ANS; SOIC127P780X200-16N; Part Description 8-Bit Parallel-Load Shift Register
R460, R462, R463: R0402_33R_1%_0.0625W_100PPM; RESC1005X40N; Tolerance ±1%; Part Number R0402_33R_1%_0.0625W_100PPM

Connections:
GND: C277.2, C278.2, C279.2, C345.2, IC51.8 (GND), IC51.17 (EP), IC52.1 (SER), IC52.6 (CLK_INH), IC52.8 (GND), IC55.6 (CLK_INH), IC55.8 (GND), IC56.6 (CLK_INH), IC56.8 (GND)
GPIO_IN0: IC52.2 (A)
GPIO_IN1: IC52.3 (B)
GPIO_IN2: IC52.4 (C)
GPIO_IN3: IC52.5 (D)
GPIO_IN4: IC52.10 (E)
GPIO_IN5: IC52.11 (F)
GPIO_IN6: IC52.12 (G)
GPIO_IN7: IC52.14 (H)
GPIO_IN8: IC56.2 (A)
GPIO_IN9: IC56.3 (B)
GPIO_IN10: IC56.4 (C)
GPIO_IN11: IC56.5 (D)
GPIO_IN12: IC56.10 (E)
GPIO_IN13: IC56.11 (F)
GPIO_IN14: IC56.12 (G)
GPIO_IN15: IC56.14 (H)
GPIO_IN16: IC55.2 (A)
GPIO_IN17: IC55.3 (B)
GPIO_IN18: IC55.4 (C)
GPIO_IN19: IC55.5 (D)
GPIO_IN20: IC55.10 (E)
GPIO_IN21: IC55.11 (F)
GPIO_IN22: IC55.12 (G)
GPIO_IN23: IC55.14 (H)
GPIO_OUT0: IC51.15 (QA)
GPIO_OUT1: IC51.1 (QB)
GPIO_OUT2: IC51.2 (QC)
GPIO_OUT3: IC51.3 (QD)
GPIO_OUT4: IC51.4 (QE)
GPIO_OUT5: IC51.5 (QF)
GPIO_OUT6: IC51.6 (QG)
GPIO_OUT7: IC51.7 (QH)
IOEXP_D: R463.1
IOEXP_OE_N: IC51.13 (~OE)
IOEXP_Q: IC55.13 (QH)
IOEXP_RCLK: R460.1
IOEXP_RST_N: IC51.10 (~SRCLR), IC52.9 (~CLR), IC55.9 (~CLR), IC56.9 (~CLR)
IOEXP_SCLK: R462.1
I_IOEXP_RCLK: IC51.12 (RCLK), IC52.15 (SH/~LD), IC55.15 (SH/~LD), IC56.15 (SH/~LD), R460.2
I_IOEXP_SCLK: IC51.11 (SRCLK), IC52.7 (CLK), IC55.7 (CLK), IC56.7 (CLK), R462.2
unnamed: IC51.14 (SER), R463.2
unnamed: IC52.13 (QH), IC56.1 (SER)
unnamed: IC55.1 (SER), IC56.13 (QH)
P3V3: C277.1, C278.1, C279.1, C345.1, IC51.16 (VCC), IC52.16 (VCC), IC55.16 (VCC), IC56.16 (VCC)

Notes on the sheet:
Place series termination resistors close to FPGA.
