ttrain4086-cpu/Kicad-VME-Wren-Update/user_interface.kicad_sch

## KiCad design user_interface.kicad_sch (2026-05-15)

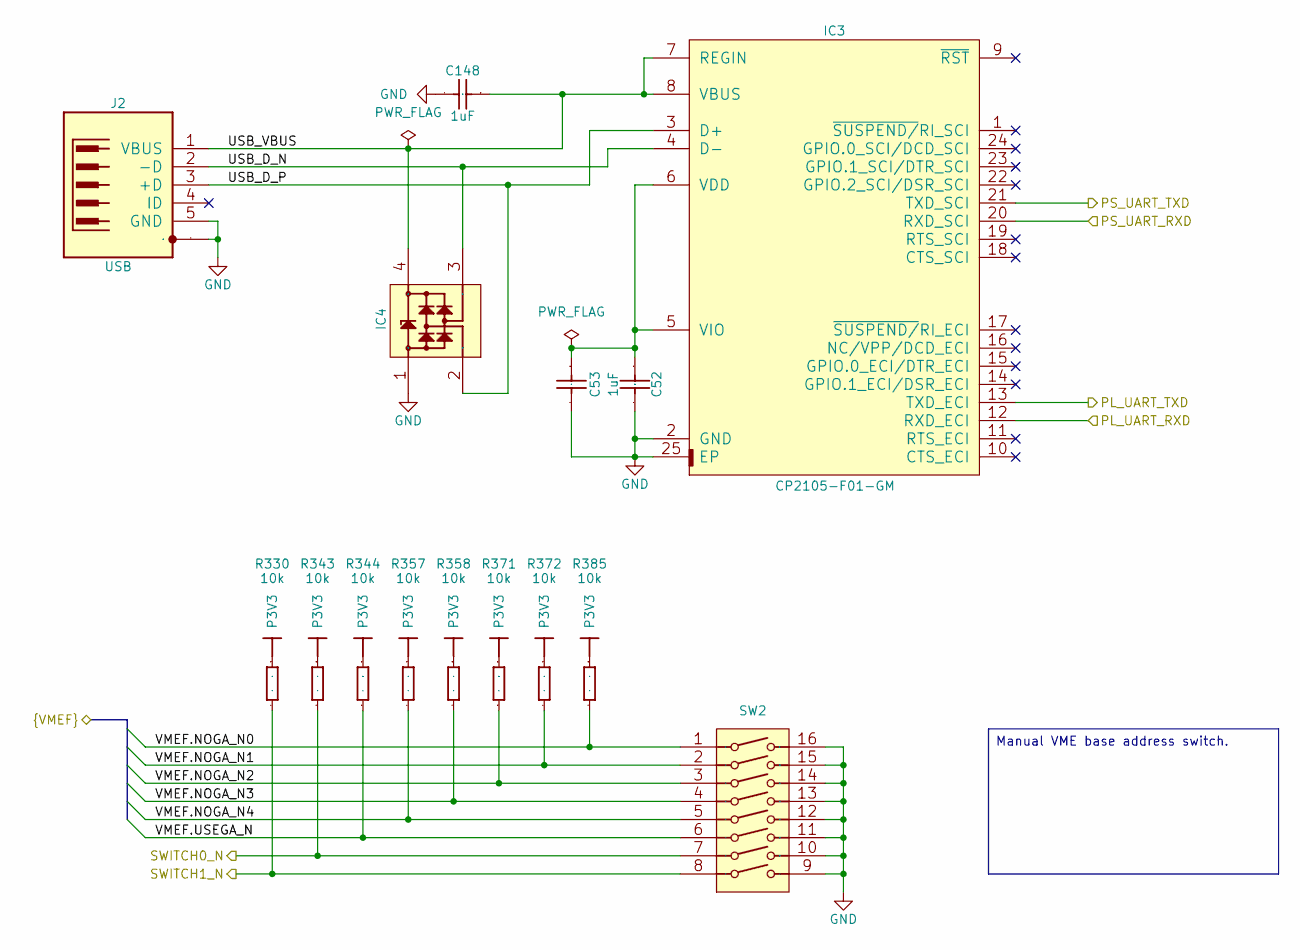
[picture p24: schematic user_interface.kicad_sch]

Parts:
C52, C148: CC0402_1UF_25V_10%_X5R; CAPC1005X55N; Voltage 25V; Tolerance ±10%; Part Number CC0402_1UF_25V_10%_X5R
C53: CC0402_100NF_16V_10%_X7R; CAPC1005X55N; Voltage 16V; Tolerance ±10%; Part Number CC0402_100NF_16V_10%_X7R
IC3: CP2105-F01-GM; QFN50P400X400X80-25N-S280; Part Number CP2105-F01-GM
IC4: PRTR5V0U2X; SOT190P230X110-4N; Voltage 5.5V; Part Number PRTR5V0U2X
J2: MOLEX_500075-1517; Part Number MOLEX_500075-1517
R330, R343, R344, R357, R358, R371, R372, R385: R0402_10K_1%_0.0625W_100PPM; RESC1005X40N; Tolerance ±1%; Part Number R0402_10K_1%_0.0625W_100PPM
SW2: SW_TYCO_1-1571983-0; Part Number SW_TYCO_1-1571983-0

Connections:
GND: C52.2, C53.2, C148.2, IC3.2 (GND), IC3.25 (EP), IC4.1 (GND), J2.5 (GND), J2.6 (SH), SW2.9, SW2.10, SW2.11, SW2.12, SW2.13, SW2.14, SW2.15, SW2.16
unnamed: C52.1, C53.1, IC3.5 (VIO), IC3.6 (VDD)
P3V3: R330.1, R343.1, R344.1, R357.1, R358.1, R371.1, R372.1, R385.1
PL_UART_RXD: IC3.12 (RXD_ECI)
PL_UART_TXD: IC3.13 (TXD_ECI)
PS_UART_RXD: IC3.20 (RXD_SCI)
PS_UART_TXD: IC3.21 (TXD_SCI)
SWITCH0_N: R343.2, SW2.7
SWITCH1_N: R330.2, SW2.8
USB_D_N: IC3.4 (D-), IC4.3 (I/O2), J2.2 (-D)
USB_D_P: IC3.3 (D+), IC4.2 (I/O1), J2.3 (+D)
USB_VBUS: C148.1, IC3.7 (REGIN), IC3.8 (VBUS), IC4.4 (VCC), J2.1 (VBUS)
VMEF.NOGA_N0: R385.2, SW2.1
VMEF.NOGA_N1: R372.2, SW2.2
VMEF.NOGA_N2: R371.2, SW2.3
VMEF.NOGA_N3: R358.2, SW2.4
VMEF.NOGA_N4: R357.2, SW2.5
VMEF.USEGA_N: R344.2, SW2.6

Notes on the sheet:
Manual VME base address switch.
