ttrain4086-cpu/Kicad-VME-Wren-Update/vme-wren.kicad_sch

## KiCad design vme-wren.kicad_sch (2026-05-15)

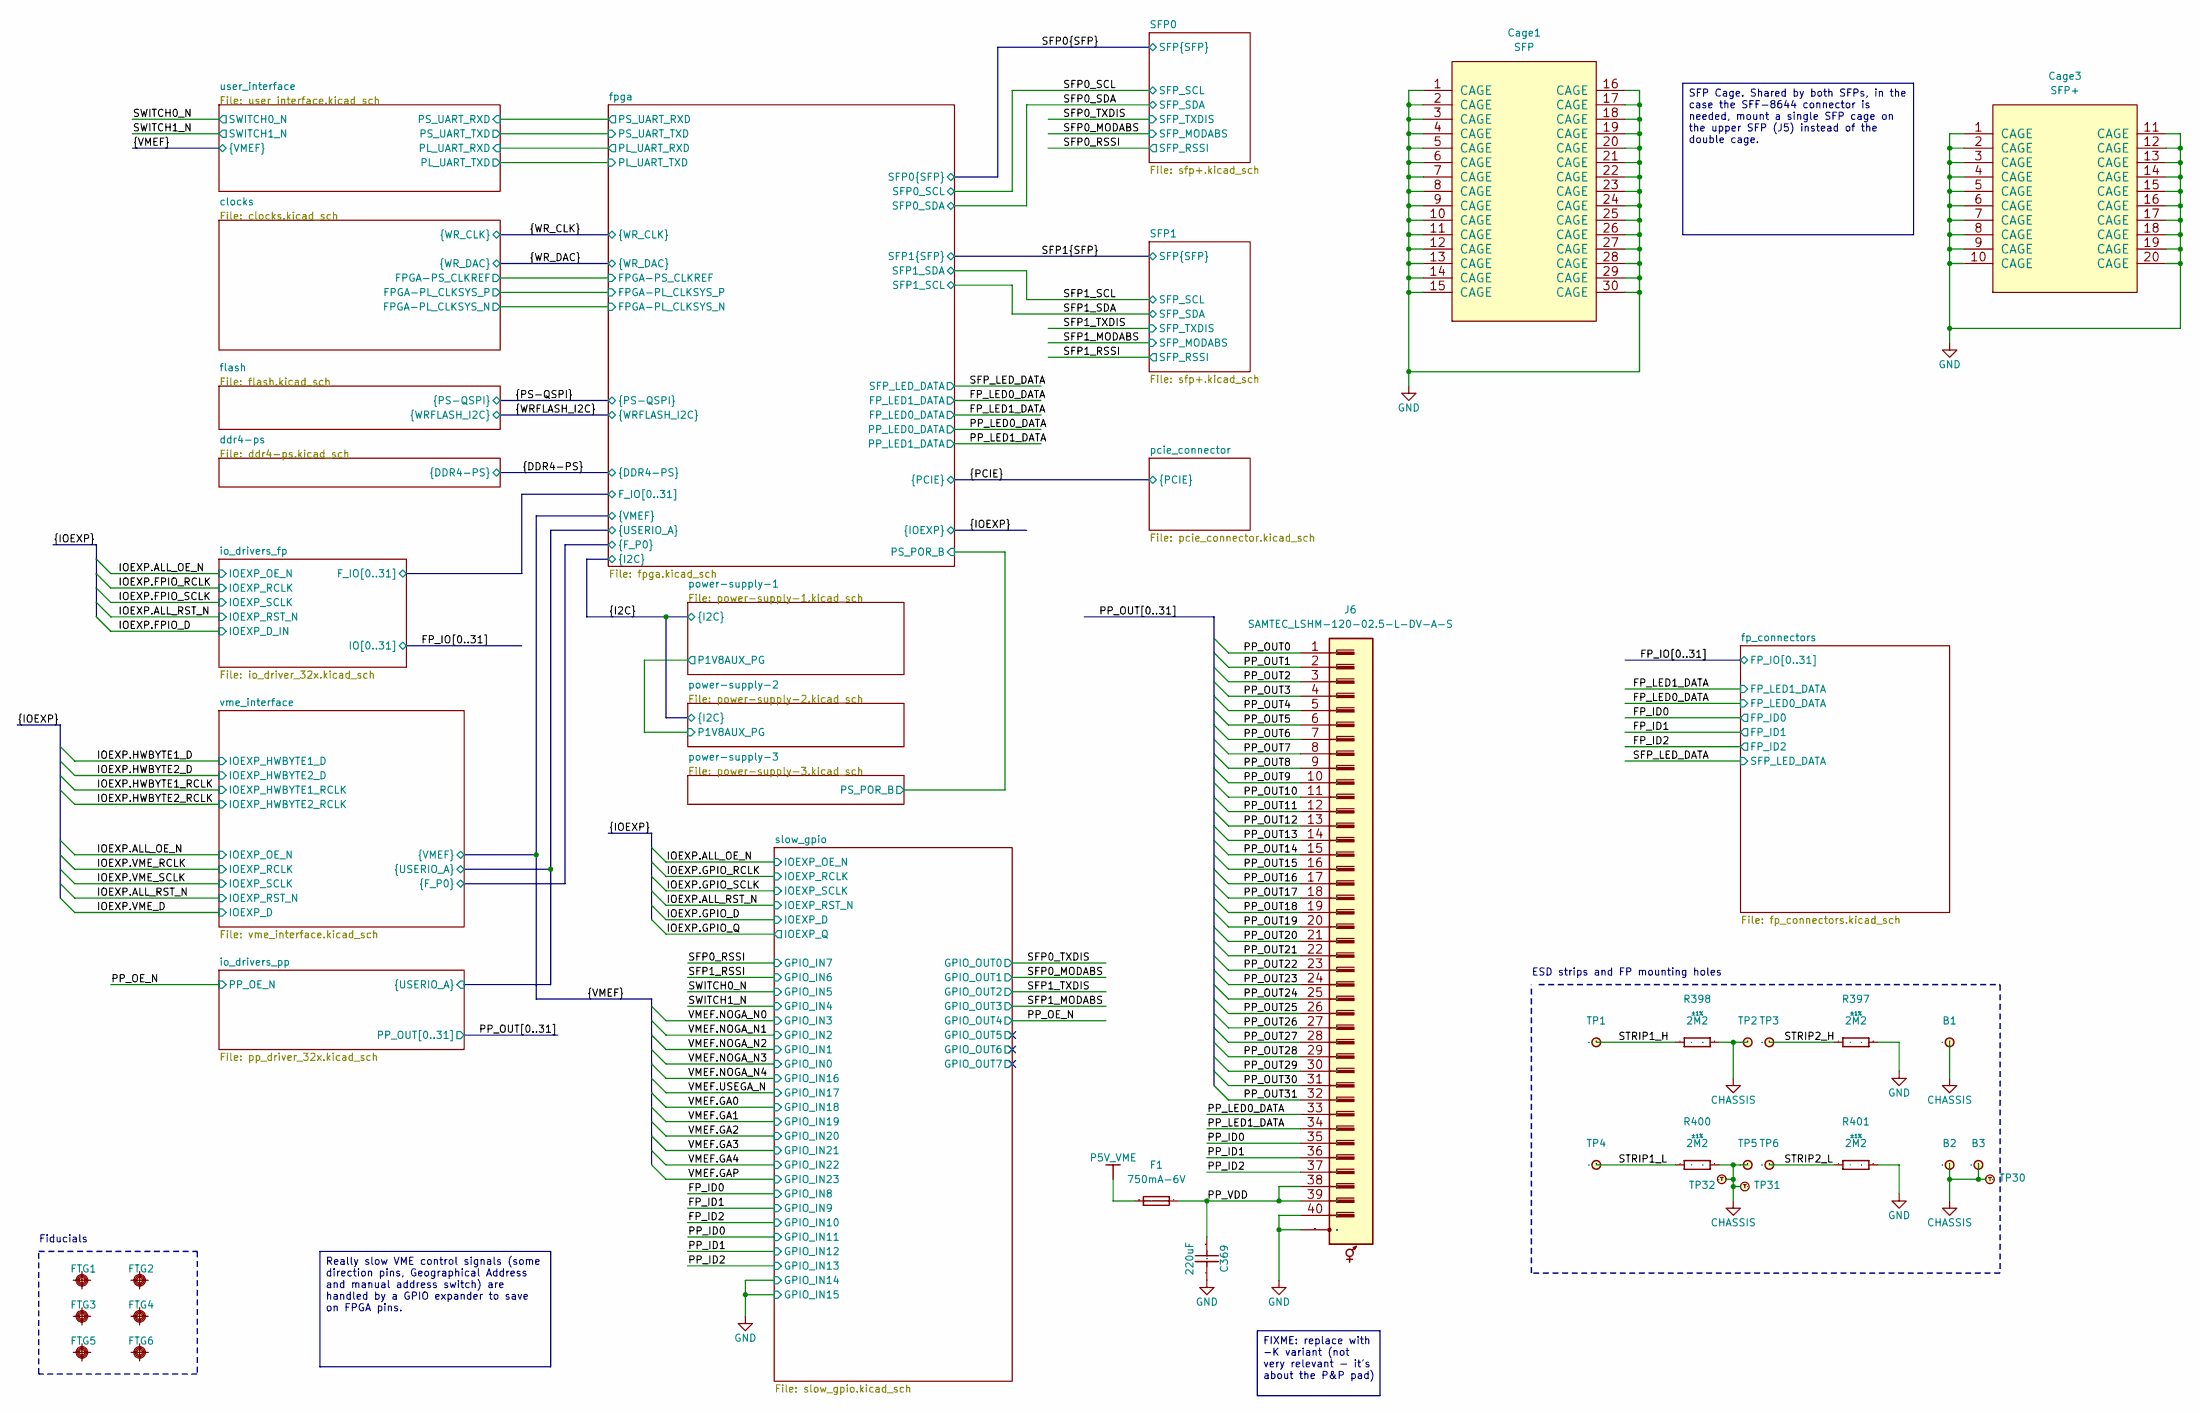
[picture p25: schematic vme-wren.kicad_sch]

Parts:
B1, B2, B3: PLATED_HOLE2.7_PAD5.0; MTG270_500; Part Number PLATED_HOLE2.7_PAD5.0
C369: CC1210_220UF_6.3V_20%_X5R; CAPC3225X280N; Voltage 6.3V; Tolerance ±20%; Part Number CC1210_220UF_6.3V_20%_X5R
Cage1: TYCO_1761014-3; Part Number TYCO_1761014-3
Cage3: MOLEX_74737-0009; Part Number MOLEX_74737-0009
F1: FUSR_LITTELFUSE_0603L075SL; FUSR_LITTELFUSE_0603L; Part Number FUSR_LITTELFUSE_0603L075SL
FTG1, FTG2, FTG3, FTG4, FTG5, FTG6: FIDUCIAL_TARGET_C100-200; FIDUCIAL_TOP_C100-200; Part Number FIDUCIAL_TARGET_C100-200
J6: SAMTEC_LSHM-120-02.5-L-DV-A-S; SAMTEC_LSHM-120-02.5-X-DV-A-S; Part Number SAMTEC_LSHM-120-02.5-L-DV-A-S
R397, R398, R400, R401: R0805_2M2_1%_0.125W_100PPM; RESC2012X60N; Tolerance ±1%; Part Number R0805_2M2_1%_0.125W_100PPM
TP1, TP2, TP3, TP4, TP5, TP6: SMD_PAD_1.27X1.27MM; TPS127; Part Number SMD_PAD_1.27X1.27MM
TP30, TP31: Tomachie_TP_E; TPS127
TP32: Tomachie_TP_W; TPS127

Connections:
CHASSIS: B1.1, B2.1, B3.1, R398.1, R400.1, TP2.1, TP5.1, TP30.1, TP31.1, TP32.1
GND: C369.2, Cage1.1, Cage1.2, Cage1.3, Cage1.4, Cage1.5, Cage1.6, Cage1.7, Cage1.8, Cage1.9, Cage1.10, Cage1.11, Cage1.12, Cage1.13, Cage1.14, Cage1.15, Cage1.16, Cage1.17, Cage1.18, Cage1.19, Cage1.20, Cage1.21, Cage1.22, Cage1.23, Cage1.24, Cage1.25, Cage1.26, Cage1.27, Cage1.28, Cage1.29, Cage1.30, Cage3.1, Cage3.2, Cage3.3, Cage3.4, Cage3.5, Cage3.6, Cage3.7, Cage3.8, Cage3.9, Cage3.10, Cage3.11, Cage3.12, Cage3.13, Cage3.14, Cage3.15, Cage3.16, Cage3.17, Cage3.18, Cage3.19, Cage3.20, J6.40, J6.41 (Shield), R397.1, R401.1
P5V_VME: F1.1
PP_ID0: J6.35
PP_ID1: J6.36
PP_ID2: J6.37
PP_LED0_DATA: J6.33
PP_LED1_DATA: J6.34
PP_OUT0: J6.1
PP_OUT1: J6.2
PP_OUT2: J6.3
PP_OUT3: J6.4
PP_OUT4: J6.5
PP_OUT5: J6.6
PP_OUT6: J6.7
PP_OUT7: J6.8
PP_OUT8: J6.9
PP_OUT9: J6.10
PP_OUT10: J6.11
PP_OUT11: J6.12
PP_OUT12: J6.13
PP_OUT13: J6.14
PP_OUT14: J6.15
PP_OUT15: J6.16
PP_OUT16: J6.17
PP_OUT17: J6.18
PP_OUT18: J6.19
PP_OUT19: J6.20
PP_OUT20: J6.21
PP_OUT21: J6.22
PP_OUT22: J6.23
PP_OUT23: J6.24
PP_OUT24: J6.25
PP_OUT25: J6.26
PP_OUT26: J6.27
PP_OUT27: J6.28
PP_OUT28: J6.29
PP_OUT29: J6.30
PP_OUT30: J6.31
PP_OUT31: J6.32
PP_VDD: C369.1, F1.2, J6.38, J6.39
STRIP1_H: R398.2, TP1.1
STRIP1_L: R400.2, TP4.1
STRIP2_H: R397.2, TP3.1
STRIP2_L: R401.2, TP6.1

Notes on the sheet:
Fiducials
ESD strips and FP mounting holes
SFP Cage. Shared by both SFPs, in the case the SFF-8644 connector is needed, mount a single SFP cage on the upper SFP (J5) instead of the double cage.
Really slow VME control signals (some direction pins, Geographical Address and manual address switch) are handled by a GPIO expander to save on FPGA pins.
FIXME: replace with -K variant (not very relevant - it's about the P&P pad)
