ttrain4086-cpu/Kicad-VME-Wren-Update/vme_buffers_addr.kicad_sch

## KiCad design vme_buffers_addr.kicad_sch (2026-05-15)

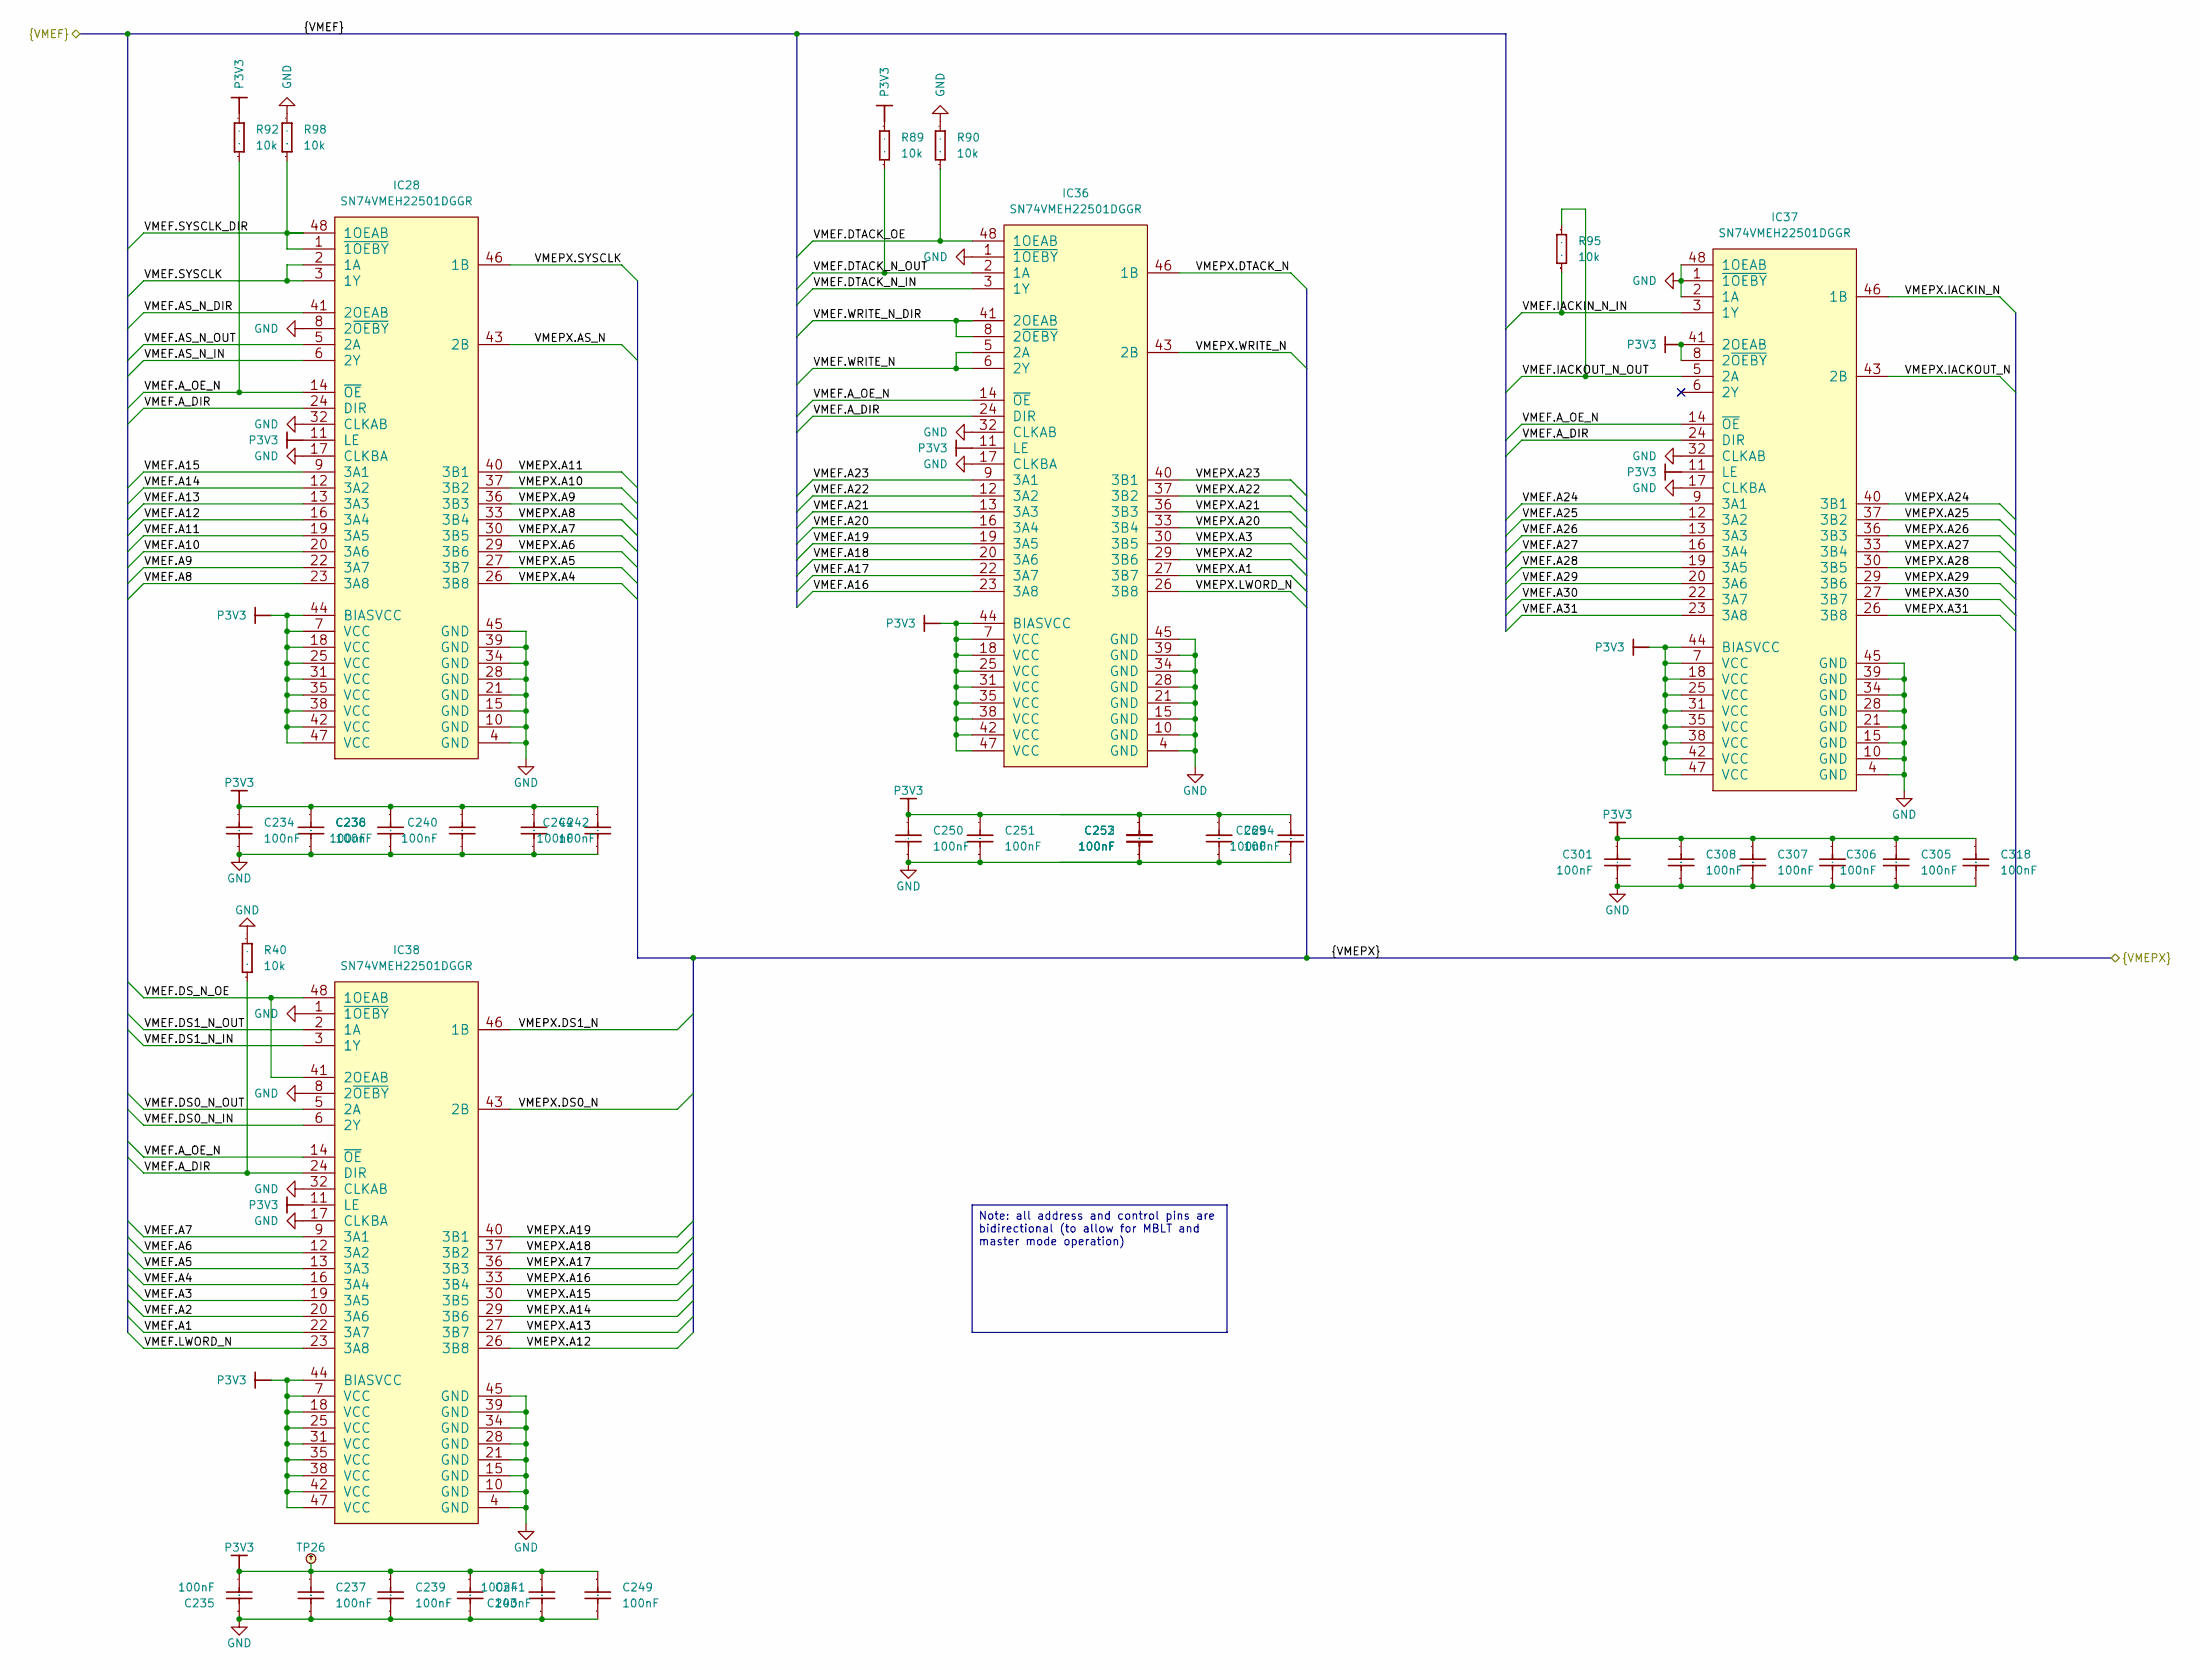
[picture p26: schematic vme_buffers_addr.kicad_sch]

Parts:
C234, C235, C236, C237, C238, C239, C240, C241, C242, C243, C244, C249, C250, C251, C252, C253, C254, C269, C301, C305, C306, C307, C308, C318: CC0402_100NF_16V_10%_X7R; CAPC1005X55N; Voltage 16V; Tolerance ±10%; Part Number CC0402_100NF_16V_10%_X7R
IC28, IC36, IC37, IC38: SN74VMEH22501DGGR; SOP50P810X120-48N; Part Description 8-Bit Universal Bus Transceiver and Two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
R40, R89, R90, R92, R95, R98: R0402_10K_1%_0.0625W_100PPM; RESC1005X40N; Tolerance ±1%; Part Number R0402_10K_1%_0.0625W_100PPM
TP26: Tomachie_TP_N; TPS127

Connections:
GND: C234.1, C235.1, C236.1, C237.1, C238.2, C239.2, C240.2, C241.2, C242.1, C243.1, C244.2, C249.2, C250.1, C251.1, C252.2, C253.2, C254.1, C269.2, C301.1, C305.1, C306.2, C307.2, C308.1, C318.2, IC28.4 (GND), IC28.8 (2~OEBY), IC28.10 (GND), IC28.15 (GND), IC28.17 (CLKBA), IC28.21 (GND), IC28.28 (GND), IC28.32 (CLKAB), IC28.34 (GND), IC28.39 (GND), IC28.45 (GND), IC36.1 (~1OEBY), IC36.4 (GND), IC36.10 (GND), IC36.15 (GND), IC36.17 (CLKBA), IC36.21 (GND), IC36.28 (GND), IC36.32 (CLKAB), IC36.34 (GND), IC36.39 (GND), IC36.45 (GND), IC37.1 (~1OEBY), IC37.2 (1A), IC37.4 (GND), IC37.10 (GND), IC37.15 (GND), IC37.17 (CLKBA), IC37.21 (GND), IC37.28 (GND), IC37.32 (CLKAB), IC37.34 (GND), IC37.39 (GND), IC37.45 (GND), IC37.48 (1OEAB), IC38.1 (~1OEBY), IC38.4 (GND), IC38.8 (2~OEBY), IC38.10 (GND), IC38.15 (GND), IC38.17 (CLKBA), IC38.21 (GND), IC38.28 (GND), IC38.32 (CLKAB), IC38.34 (GND), IC38.39 (GND), IC38.45 (GND), R40.2, R90.2, R98.2
P3V3: C234.2, C235.2, C236.2, C237.2, C238.1, C239.1, C240.1, C241.1, C242.2, C243.2, C244.1, C249.1, C250.2, C251.2, C252.1, C253.1, C254.2, C269.1, C301.2, C305.2, C306.1, C307.1, C308.2, C318.1, IC28.7 (VCC), IC28.11 (LE), IC28.18 (VCC), IC28.25 (VCC), IC28.31 (VCC), IC28.35 (VCC), IC28.38 (VCC), IC28.42 (VCC), IC28.44 (BIASVCC), IC28.47 (VCC), IC36.7 (VCC), IC36.11 (LE), IC36.18 (VCC), IC36.25 (VCC), IC36.31 (VCC), IC36.35 (VCC), IC36.38 (VCC), IC36.42 (VCC), IC36.44 (BIASVCC), IC36.47 (VCC), IC37.7 (VCC), IC37.8 (2~OEBY), IC37.11 (LE), IC37.18 (VCC), IC37.25 (VCC), IC37.31 (VCC), IC37.35 (VCC), IC37.38 (VCC), IC37.41 (2OEAB), IC37.42 (VCC), IC37.44 (BIASVCC), IC37.47 (VCC), IC38.7 (VCC), IC38.11 (LE), IC38.18 (VCC), IC38.25 (VCC), IC38.31 (VCC), IC38.35 (VCC), IC38.38 (VCC), IC38.42 (VCC), IC38.44 (BIASVCC), IC38.47 (VCC), R89.2, R92.2, TP26.1
VMEF.A1: IC38.22 (3A7)
VMEF.A2: IC38.20 (3A6)
VMEF.A3: IC38.19 (3A5)
VMEF.A4: IC38.16 (3A4)
VMEF.A5: IC38.13 (3A3)
VMEF.A6: IC38.12 (3A2)
VMEF.A7: IC38.9 (3A1)
VMEF.A8: IC28.23 (3A8)
VMEF.A9: IC28.22 (3A7)
VMEF.A10: IC28.20 (3A6)
VMEF.A11: IC28.19 (3A5)
VMEF.A12: IC28.16 (3A4)
VMEF.A13: IC28.13 (3A3)
VMEF.A14: IC28.12 (3A2)
VMEF.A15: IC28.9 (3A1)
VMEF.A16: IC36.23 (3A8)
VMEF.A17: IC36.22 (3A7)
VMEF.A18: IC36.20 (3A6)
VMEF.A19: IC36.19 (3A5)
VMEF.A20: IC36.16 (3A4)
VMEF.A21: IC36.13 (3A3)
VMEF.A22: IC36.12 (3A2)
VMEF.A23: IC36.9 (3A1)
VMEF.A24: IC37.9 (3A1)
VMEF.A25: IC37.12 (3A2)
VMEF.A26: IC37.13 (3A3)
VMEF.A27: IC37.16 (3A4)
VMEF.A28: IC37.19 (3A5)
VMEF.A29: IC37.20 (3A6)
VMEF.A30: IC37.22 (3A7)
VMEF.A31: IC37.23 (3A8)
VMEF.AS_N_DIR: IC28.41 (2OEAB)
VMEF.AS_N_IN: IC28.6 (2Y)
VMEF.AS_N_OUT: IC28.5 (2A)
VMEF.A_DIR: IC28.24 (DIR), IC36.24 (DIR), IC37.24 (DIR), IC38.24 (DIR), R40.1
VMEF.A_OE_N: IC28.14 (~OE), IC36.14 (~OE), IC37.14 (~OE), IC38.14 (~OE), R92.1
VMEF.DS0_N_IN: IC38.6 (2Y)
VMEF.DS0_N_OUT: IC38.5 (2A)
VMEF.DS1_N_IN: IC38.3 (1Y)
VMEF.DS1_N_OUT: IC38.2 (1A)
VMEF.DS_N_OE: IC38.41 (2OEAB), IC38.48 (1OEAB)
VMEF.DTACK_N_IN: IC36.3 (1Y)
VMEF.DTACK_N_OUT: IC36.2 (1A), R89.1
VMEF.DTACK_OE: IC36.48 (1OEAB), R90.1
VMEF.IACKIN_N_IN: IC37.3 (1Y), R95.1
VMEF.IACKOUT_N_OUT: IC37.5 (2A), R95.2
VMEF.LWORD_N: IC38.23 (3A8)
VMEF.SYSCLK: IC28.2 (1A), IC28.3 (1Y)
VMEF.SYSCLK_DIR: IC28.1 (~1OEBY), IC28.48 (1OEAB), R98.1
VMEF.WRITE_N: IC36.5 (2A), IC36.6 (2Y)
VMEF.WRITE_N_DIR: IC36.8 (2~OEBY), IC36.41 (2OEAB)
VMEPX.A1: IC36.27 (3B7)
VMEPX.A2: IC36.29 (3B6)
VMEPX.A3: IC36.30 (3B5)
VMEPX.A4: IC28.26 (3B8)
VMEPX.A5: IC28.27 (3B7)
VMEPX.A6: IC28.29 (3B6)
VMEPX.A7: IC28.30 (3B5)
VMEPX.A8: IC28.33 (3B4)
VMEPX.A9: IC28.36 (3B3)
VMEPX.A10: IC28.37 (3B2)
VMEPX.A11: IC28.40 (3B1)
VMEPX.A12: IC38.26 (3B8)
VMEPX.A13: IC38.27 (3B7)
VMEPX.A14: IC38.29 (3B6)
VMEPX.A15: IC38.30 (3B5)
VMEPX.A16: IC38.33 (3B4)
VMEPX.A17: IC38.36 (3B3)
VMEPX.A18: IC38.37 (3B2)
VMEPX.A19: IC38.40 (3B1)
VMEPX.A20: IC36.33 (3B4)
VMEPX.A21: IC36.36 (3B3)
VMEPX.A22: IC36.37 (3B2)
VMEPX.A23: IC36.40 (3B1)
VMEPX.A24: IC37.40 (3B1)
VMEPX.A25: IC37.37 (3B2)
VMEPX.A26: IC37.36 (3B3)
VMEPX.A27: IC37.33 (3B4)
VMEPX.A28: IC37.30 (3B5)
VMEPX.A29: IC37.29 (3B6)
VMEPX.A30: IC37.27 (3B7)
VMEPX.A31: IC37.26 (3B8)
VMEPX.AS_N: IC28.43 (2B)
VMEPX.DS0_N: IC38.43 (2B)
VMEPX.DS1_N: IC38.46 (1B)
VMEPX.DTACK_N: IC36.46 (1B)
VMEPX.IACKIN_N: IC37.46 (1B)
VMEPX.IACKOUT_N: IC37.43 (2B)
VMEPX.LWORD_N: IC36.26 (3B8)
VMEPX.SYSCLK: IC28.46 (1B)
VMEPX.WRITE_N: IC36.43 (2B)

Notes on the sheet:
Note: all address and control pins are bidirectional (to allow for MBLT and master mode operation)
