ttrain4086-cpu/Kicad-VME-Wren-Update/vme_buffers_aux.kicad_sch

## KiCad design vme_buffers_aux.kicad_sch (2026-05-15)

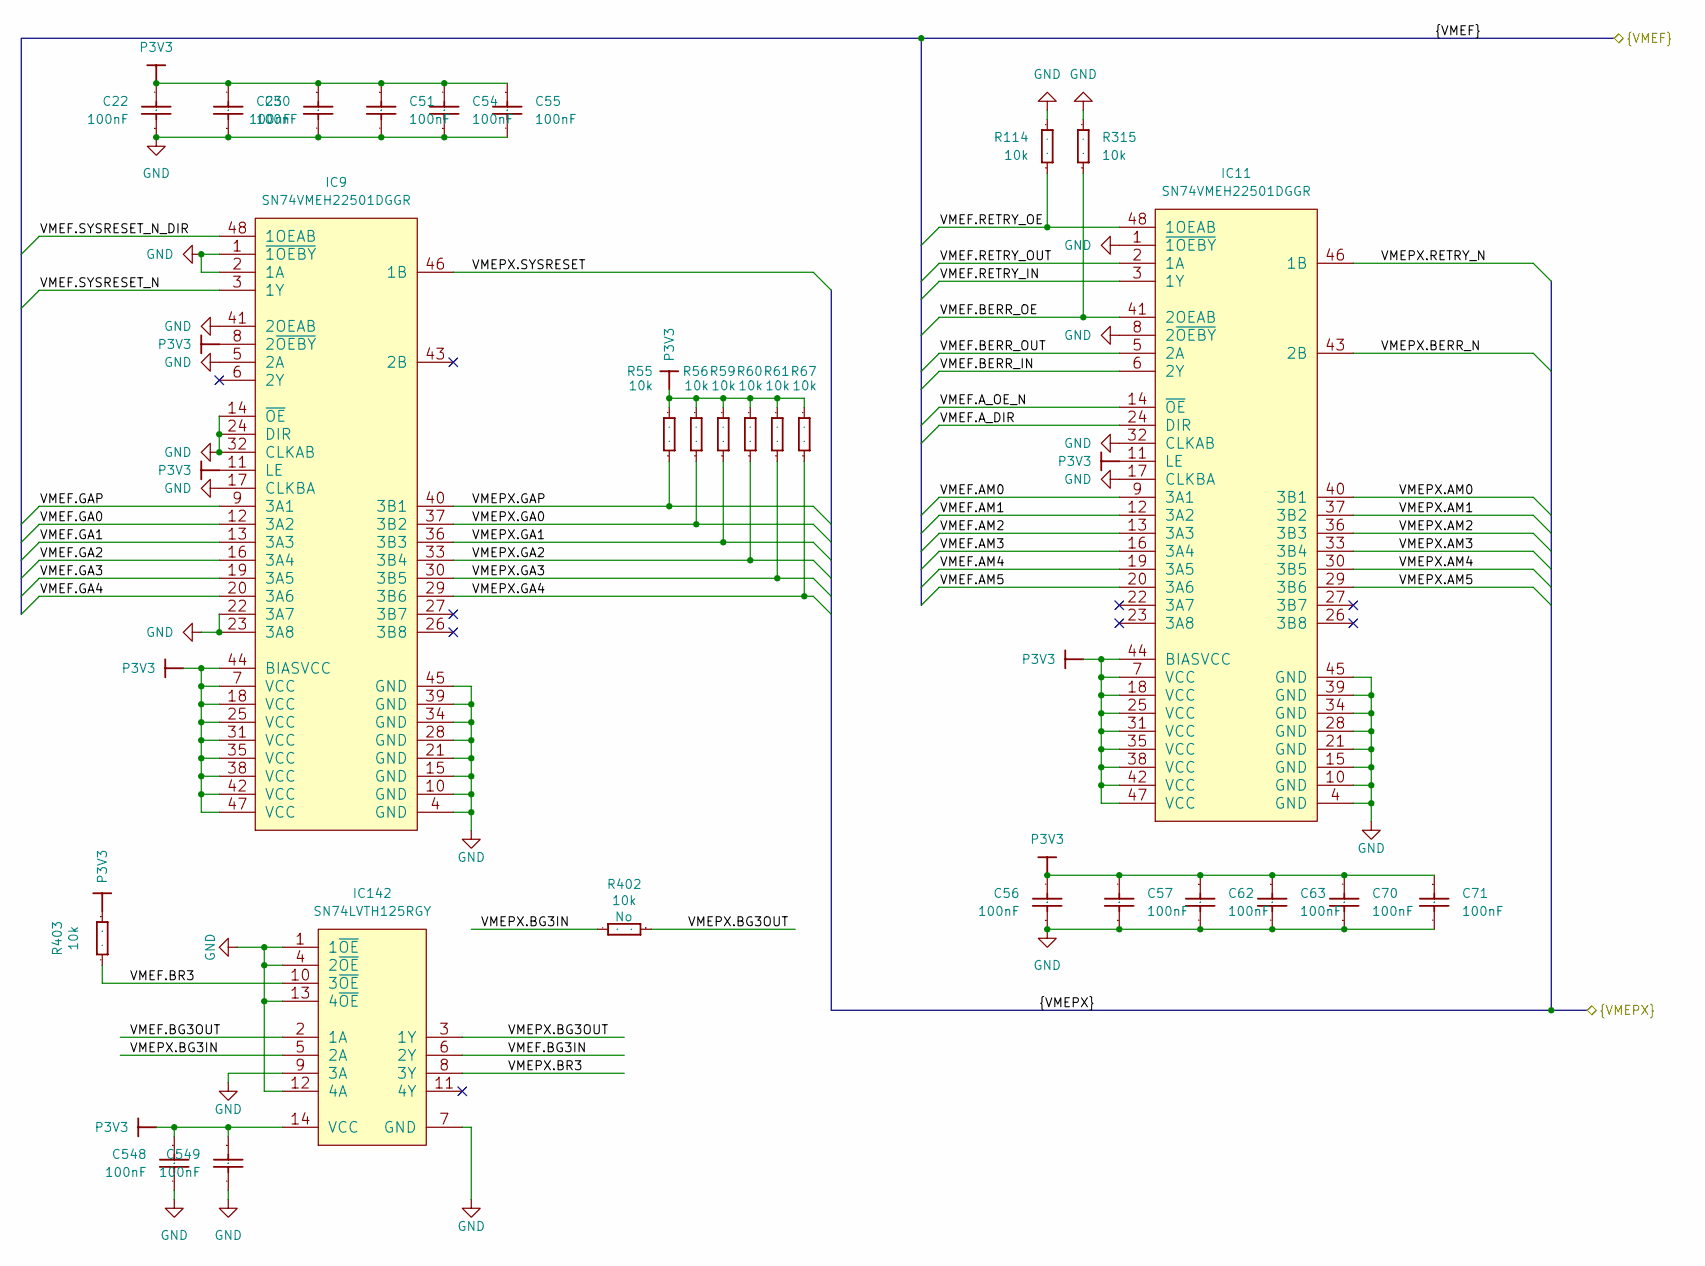
[picture p27: schematic vme_buffers_aux.kicad_sch]

Parts:
C22, C23, C50, C51, C54, C55, C56, C57, C62, C63, C70, C71, C548, C549: CC0402_100NF_16V_10%_X7R; CAPC1005X55N; Voltage 16V; Tolerance ±10%; Part Number CC0402_100NF_16V_10%_X7R
IC9, IC11: SN74VMEH22501DGGR; SOP50P810X120-48N; Part Description 8-Bit Universal Bus Transceiver and Two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
IC142: SN74LVTH125RGY; TEXAS_RGY (S-PVQFN-N14); Part Description 3.3V ABT Quadruple Bus Buffer with 3-St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
R55, R56, R59, R60, R61, R67, R114, R315, R402, R403: R0402_10K_1%_0.0625W_100PPM; RESC1005X40N; Tolerance ±1%; Part Number R0402_10K_1%_0.0625W_100PPM

Connections:
GND: C22.1, C23.1, C50.2, C51.2, C54.1, C55.2, C56.1, C57.1, C62.2, C63.2, C70.1, C71.2, C548.2, C549.2, IC9.1 (~1OEBY), IC9.2 (1A), IC9.4 (GND), IC9.5 (2A), IC9.10 (GND), IC9.14 (~OE), IC9.15 (GND), IC9.17 (CLKBA), IC9.21 (GND), IC9.22 (3A7), IC9.23 (3A8), IC9.24 (DIR), IC9.28 (GND), IC9.32 (CLKAB), IC9.34 (GND), IC9.39 (GND), IC9.41 (2OEAB), IC9.45 (GND), IC11.1 (~1OEBY), IC11.4 (GND), IC11.8 (2~OEBY), IC11.10 (GND), IC11.15 (GND), IC11.17 (CLKBA), IC11.21 (GND), IC11.28 (GND), IC11.32 (CLKAB), IC11.34 (GND), IC11.39 (GND), IC11.45 (GND), IC142.1 (1~OE), IC142.4 (2~OE), IC142.7 (GND), IC142.9 (3A), IC142.12 (4A), IC142.13 (4~OE), R114.2, R315.2
P3V3: C22.2, C23.2, C50.1, C51.1, C54.2, C55.1, C56.2, C57.2, C62.1, C63.1, C70.2, C71.1, C548.1, C549.1, IC9.7 (VCC), IC9.8 (2~OEBY), IC9.11 (LE), IC9.18 (VCC), IC9.25 (VCC), IC9.31 (VCC), IC9.35 (VCC), IC9.38 (VCC), IC9.42 (VCC), IC9.44 (BIASVCC), IC9.47 (VCC), IC11.7 (VCC), IC11.11 (LE), IC11.18 (VCC), IC11.25 (VCC), IC11.31 (VCC), IC11.35 (VCC), IC11.38 (VCC), IC11.42 (VCC), IC11.44 (BIASVCC), IC11.47 (VCC), IC142.14 (VCC), R55.2, R56.2, R59.2, R60.2, R61.2, R67.2, R403.1
VMEF.AM0: IC11.9 (3A1)
VMEF.AM1: IC11.12 (3A2)
VMEF.AM2: IC11.13 (3A3)
VMEF.AM3: IC11.16 (3A4)
VMEF.AM4: IC11.19 (3A5)
VMEF.AM5: IC11.20 (3A6)
VMEF.A_DIR: IC11.24 (DIR)
VMEF.A_OE_N: IC11.14 (~OE)
VMEF.BERR_IN: IC11.6 (2Y)
VMEF.BERR_OE: IC11.41 (2OEAB), R315.1
VMEF.BERR_OUT: IC11.5 (2A)
VMEF.BG3IN: IC142.6 (2Y)
VMEF.BG3OUT: IC142.2 (1A)
VMEF.BR3: IC142.10 (3~OE), R403.2
VMEF.GA0: IC9.12 (3A2)
VMEF.GA1: IC9.13 (3A3)
VMEF.GA2: IC9.16 (3A4)
VMEF.GA3: IC9.19 (3A5)
VMEF.GA4: IC9.20 (3A6)
VMEF.GAP: IC9.9 (3A1)
VMEF.RETRY_IN: IC11.3 (1Y)
VMEF.RETRY_OE: IC11.48 (1OEAB), R114.1
VMEF.RETRY_OUT: IC11.2 (1A)
VMEF.SYSRESET_N: IC9.3 (1Y)
VMEF.SYSRESET_N_DIR: IC9.48 (1OEAB)
VMEPX.AM0: IC11.40 (3B1)
VMEPX.AM1: IC11.37 (3B2)
VMEPX.AM2: IC11.36 (3B3)
VMEPX.AM3: IC11.33 (3B4)
VMEPX.AM4: IC11.30 (3B5)
VMEPX.AM5: IC11.29 (3B6)
VMEPX.BERR_N: IC11.43 (2B)
VMEPX.BG3IN: IC142.5 (2A), R402.2
VMEPX.BG3OUT: IC142.3 (1Y), R402.1
VMEPX.BR3: IC142.8 (3Y)
VMEPX.GA0: IC9.37 (3B2), R56.1
VMEPX.GA1: IC9.36 (3B3), R59.1
VMEPX.GA2: IC9.33 (3B4), R60.1
VMEPX.GA3: IC9.30 (3B5), R61.1
VMEPX.GA4: IC9.29 (3B6), R67.1
VMEPX.GAP: IC9.40 (3B1), R55.1
VMEPX.RETRY_N: IC11.46 (1B)
VMEPX.SYSRESET: IC9.46 (1B)
