ttrain4086-cpu/Kicad-VME-Wren-Update/vme_buffers_data.kicad_sch

## KiCad design vme_buffers_data.kicad_sch (2026-05-15)

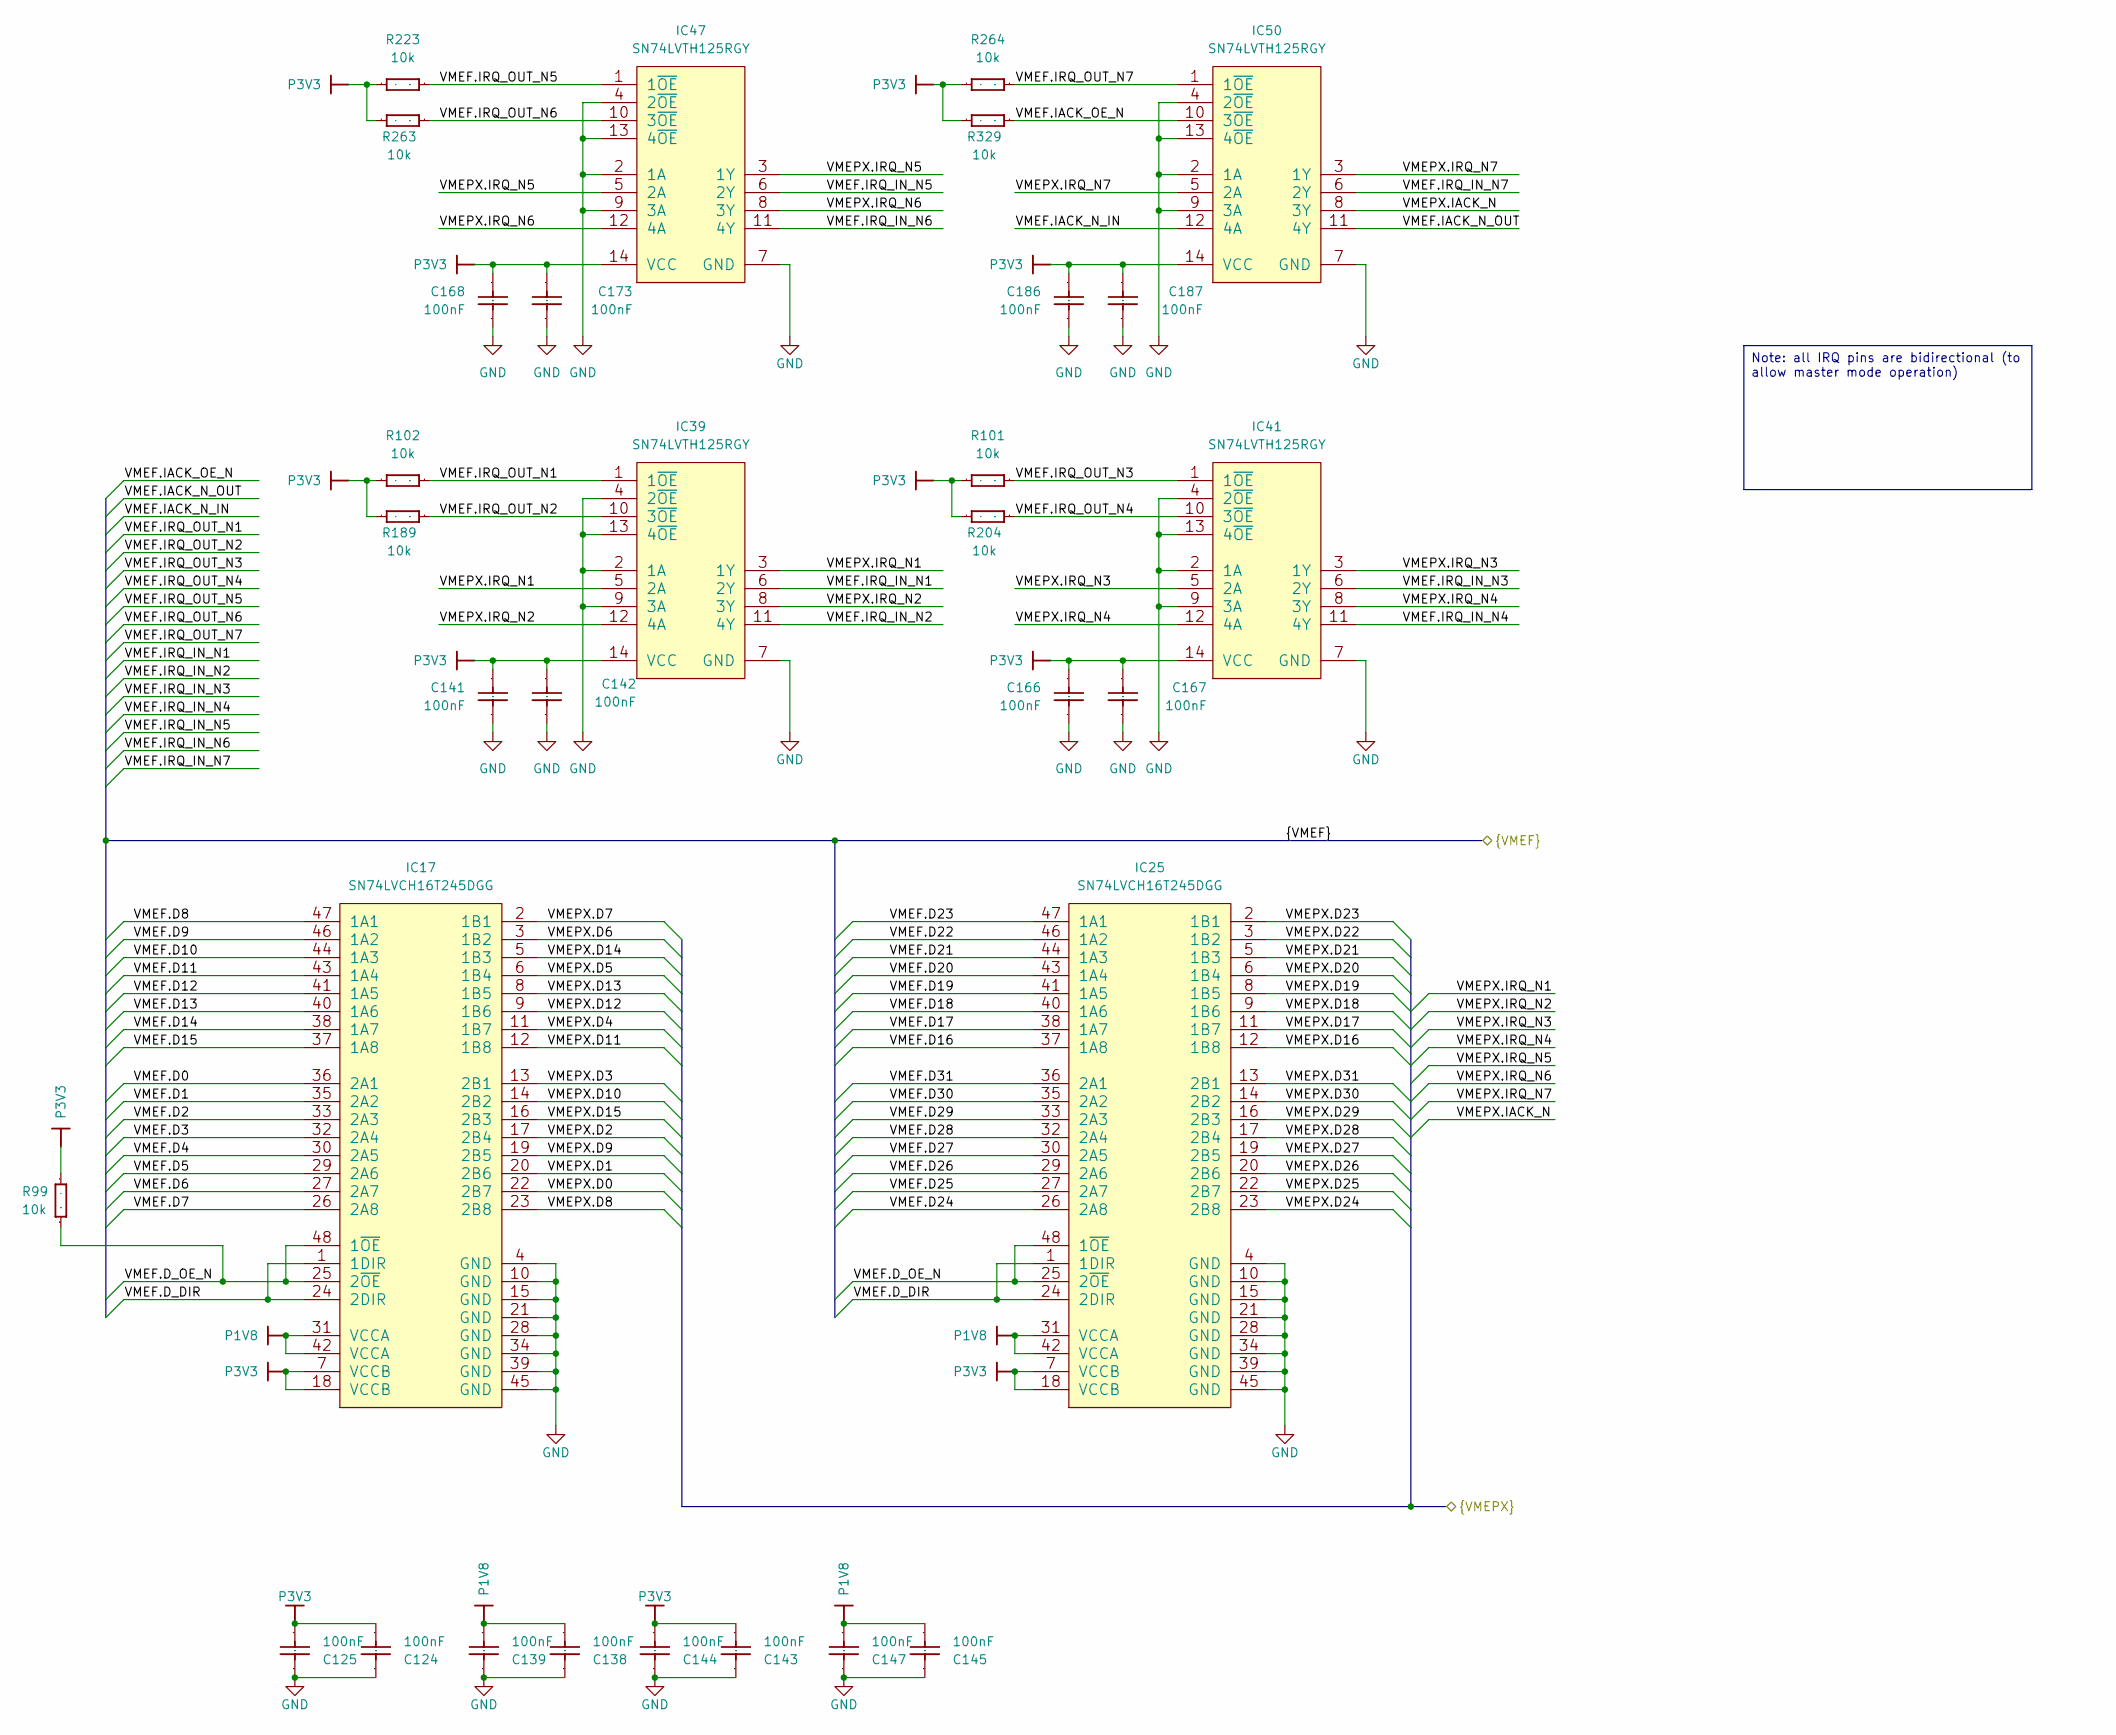
[picture p28: schematic vme_buffers_data.kicad_sch]

Parts:
C124, C125, C138, C139, C141, C142, C143, C144, C145, C147, C166, C167, C168, C173, C186, C187: CC0402_100NF_16V_10%_X7R; CAPC1005X55N; Voltage 16V; Tolerance ±10%; Part Number CC0402_100NF_16V_10%_X7R
IC17, IC25: SN74LVCH16T245DGG; SOP50P810X120-48N; Part Description 16-Bit Dual-Supply Bus Transceiver with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
IC39, IC41, IC47, IC50: SN74LVTH125RGY; TEXAS_RGY (S-PVQFN-N14); Part Description 3.3V ABT Quadruple Bus Buffer with 3-St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
R99, R101, R102, R189, R204, R223, R263, R264, R329: R0402_10K_1%_0.0625W_100PPM; RESC1005X40N; Tolerance ±1%; Part Number R0402_10K_1%_0.0625W_100PPM

Connections:
GND: C124.1, C125.1, C138.1, C139.1, C141.2, C142.2, C143.1, C144.1, C145.1, C147.1, C166.2, C167.2, C168.2, C173.2, C186.2, C187.2, IC17.4 (GND), IC17.10 (GND), IC17.15 (GND), IC17.21 (GND), IC17.28 (GND), IC17.34 (GND), IC17.39 (GND), IC17.45 (GND), IC25.4 (GND), IC25.10 (GND), IC25.15 (GND), IC25.21 (GND), IC25.28 (GND), IC25.34 (GND), IC25.39 (GND), IC25.45 (GND), IC39.2 (1A), IC39.4 (2~OE), IC39.7 (GND), IC39.9 (3A), IC39.13 (4~OE), IC41.2 (1A), IC41.4 (2~OE), IC41.7 (GND), IC41.9 (3A), IC41.13 (4~OE), IC47.2 (1A), IC47.4 (2~OE), IC47.7 (GND), IC47.9 (3A), IC47.13 (4~OE), IC50.2 (1A), IC50.4 (2~OE), IC50.7 (GND), IC50.9 (3A), IC50.13 (4~OE)
P1V8: C138.2, C139.2, C145.2, C147.2, IC17.31 (VCCA), IC17.42 (VCCA), IC25.31 (VCCA), IC25.42 (VCCA)
P3V3: C124.2, C125.2, C141.1, C142.1, C143.2, C144.2, C166.1, C167.1, C168.1, C173.1, C186.1, C187.1, IC17.7 (VCCB), IC17.18 (VCCB), IC25.7 (VCCB), IC25.18 (VCCB), IC39.14 (VCC), IC41.14 (VCC), IC47.14 (VCC), IC50.14 (VCC), R99.2, R101.2, R102.2, R189.2, R204.2, R223.2, R263.2, R264.2, R329.2
VMEF.D0: IC17.36 (2A1)
VMEF.D1: IC17.35 (2A2)
VMEF.D2: IC17.33 (2A3)
VMEF.D3: IC17.32 (2A4)
VMEF.D4: IC17.30 (2A5)
VMEF.D5: IC17.29 (2A6)
VMEF.D6: IC17.27 (2A7)
VMEF.D7: IC17.26 (2A8)
VMEF.D8: IC17.47 (1A1)
VMEF.D9: IC17.46 (1A2)
VMEF.D10: IC17.44 (1A3)
VMEF.D11: IC17.43 (1A4)
VMEF.D12: IC17.41 (1A5)
VMEF.D13: IC17.40 (1A6)
VMEF.D14: IC17.38 (1A7)
VMEF.D15: IC17.37 (1A8)
VMEF.D16: IC25.37 (1A8)
VMEF.D17: IC25.38 (1A7)
VMEF.D18: IC25.40 (1A6)
VMEF.D19: IC25.41 (1A5)
VMEF.D20: IC25.43 (1A4)
VMEF.D21: IC25.44 (1A3)
VMEF.D22: IC25.46 (1A2)
VMEF.D23: IC25.47 (1A1)
VMEF.D24: IC25.26 (2A8)
VMEF.D25: IC25.27 (2A7)
VMEF.D26: IC25.29 (2A6)
VMEF.D27: IC25.30 (2A5)
VMEF.D28: IC25.32 (2A4)
VMEF.D29: IC25.33 (2A3)
VMEF.D30: IC25.35 (2A2)
VMEF.D31: IC25.36 (2A1)
VMEF.D_DIR: IC17.1 (1DIR), IC17.24 (2DIR), IC25.1 (1DIR), IC25.24 (2DIR)
VMEF.D_OE_N: IC17.25 (2~OE), IC17.48 (1~OE), IC25.25 (2~OE), IC25.48 (1~OE), R99.1
VMEF.IACK_N_IN: IC50.12 (4A)
VMEF.IACK_N_OUT: IC50.11 (4Y)
VMEF.IACK_OE_N: IC50.10 (3~OE), R329.1
VMEF.IRQ_IN_N1: IC39.6 (2Y)
VMEF.IRQ_IN_N2: IC39.11 (4Y)
VMEF.IRQ_IN_N3: IC41.6 (2Y)
VMEF.IRQ_IN_N4: IC41.11 (4Y)
VMEF.IRQ_IN_N5: IC47.6 (2Y)
VMEF.IRQ_IN_N6: IC47.11 (4Y)
VMEF.IRQ_IN_N7: IC50.6 (2Y)
VMEF.IRQ_OUT_N1: IC39.1 (1~OE), R102.1
VMEF.IRQ_OUT_N2: IC39.10 (3~OE), R189.1
VMEF.IRQ_OUT_N3: IC41.1 (1~OE), R101.1
VMEF.IRQ_OUT_N4: IC41.10 (3~OE), R204.1
VMEF.IRQ_OUT_N5: IC47.1 (1~OE), R223.1
VMEF.IRQ_OUT_N6: IC47.10 (3~OE), R263.1
VMEF.IRQ_OUT_N7: IC50.1 (1~OE), R264.1
VMEPX.D0: IC17.22 (2B7)
VMEPX.D1: IC17.20 (2B6)
VMEPX.D2: IC17.17 (2B4)
VMEPX.D3: IC17.13 (2B1)
VMEPX.D4: IC17.11 (1B7)
VMEPX.D5: IC17.6 (1B4)
VMEPX.D6: IC17.3 (1B2)
VMEPX.D7: IC17.2 (1B1)
VMEPX.D8: IC17.23 (2B8)
VMEPX.D9: IC17.19 (2B5)
VMEPX.D10: IC17.14 (2B2)
VMEPX.D11: IC17.12 (1B8)
VMEPX.D12: IC17.9 (1B6)
VMEPX.D13: IC17.8 (1B5)
VMEPX.D14: IC17.5 (1B3)
VMEPX.D15: IC17.16 (2B3)
VMEPX.D16: IC25.12 (1B8)
VMEPX.D17: IC25.11 (1B7)
VMEPX.D18: IC25.9 (1B6)
VMEPX.D19: IC25.8 (1B5)
VMEPX.D20: IC25.6 (1B4)
VMEPX.D21: IC25.5 (1B3)
VMEPX.D22: IC25.3 (1B2)
VMEPX.D23: IC25.2 (1B1)
VMEPX.D24: IC25.23 (2B8)
VMEPX.D25: IC25.22 (2B7)
VMEPX.D26: IC25.20 (2B6)
VMEPX.D27: IC25.19 (2B5)
VMEPX.D28: IC25.17 (2B4)
VMEPX.D29: IC25.16 (2B3)
VMEPX.D30: IC25.14 (2B2)
VMEPX.D31: IC25.13 (2B1)
VMEPX.IACK_N: IC50.8 (3Y)
VMEPX.IRQ_N1: IC39.3 (1Y), IC39.5 (2A)
VMEPX.IRQ_N2: IC39.8 (3Y), IC39.12 (4A)
VMEPX.IRQ_N3: IC41.3 (1Y), IC41.5 (2A)
VMEPX.IRQ_N4: IC41.8 (3Y), IC41.12 (4A)
VMEPX.IRQ_N5: IC47.3 (1Y), IC47.5 (2A)
VMEPX.IRQ_N6: IC47.8 (3Y), IC47.12 (4A)
VMEPX.IRQ_N7: IC50.3 (1Y), IC50.5 (2A)

Notes on the sheet:
Note: all IRQ pins are bidirectional (to allow master mode operation)
