ttrain4086-cpu/Kicad-VME-Wren-Update/vme_buffers_p0_hwbyte.kicad_sch

## KiCad design vme_buffers_p0_hwbyte.kicad_sch (2026-05-15)

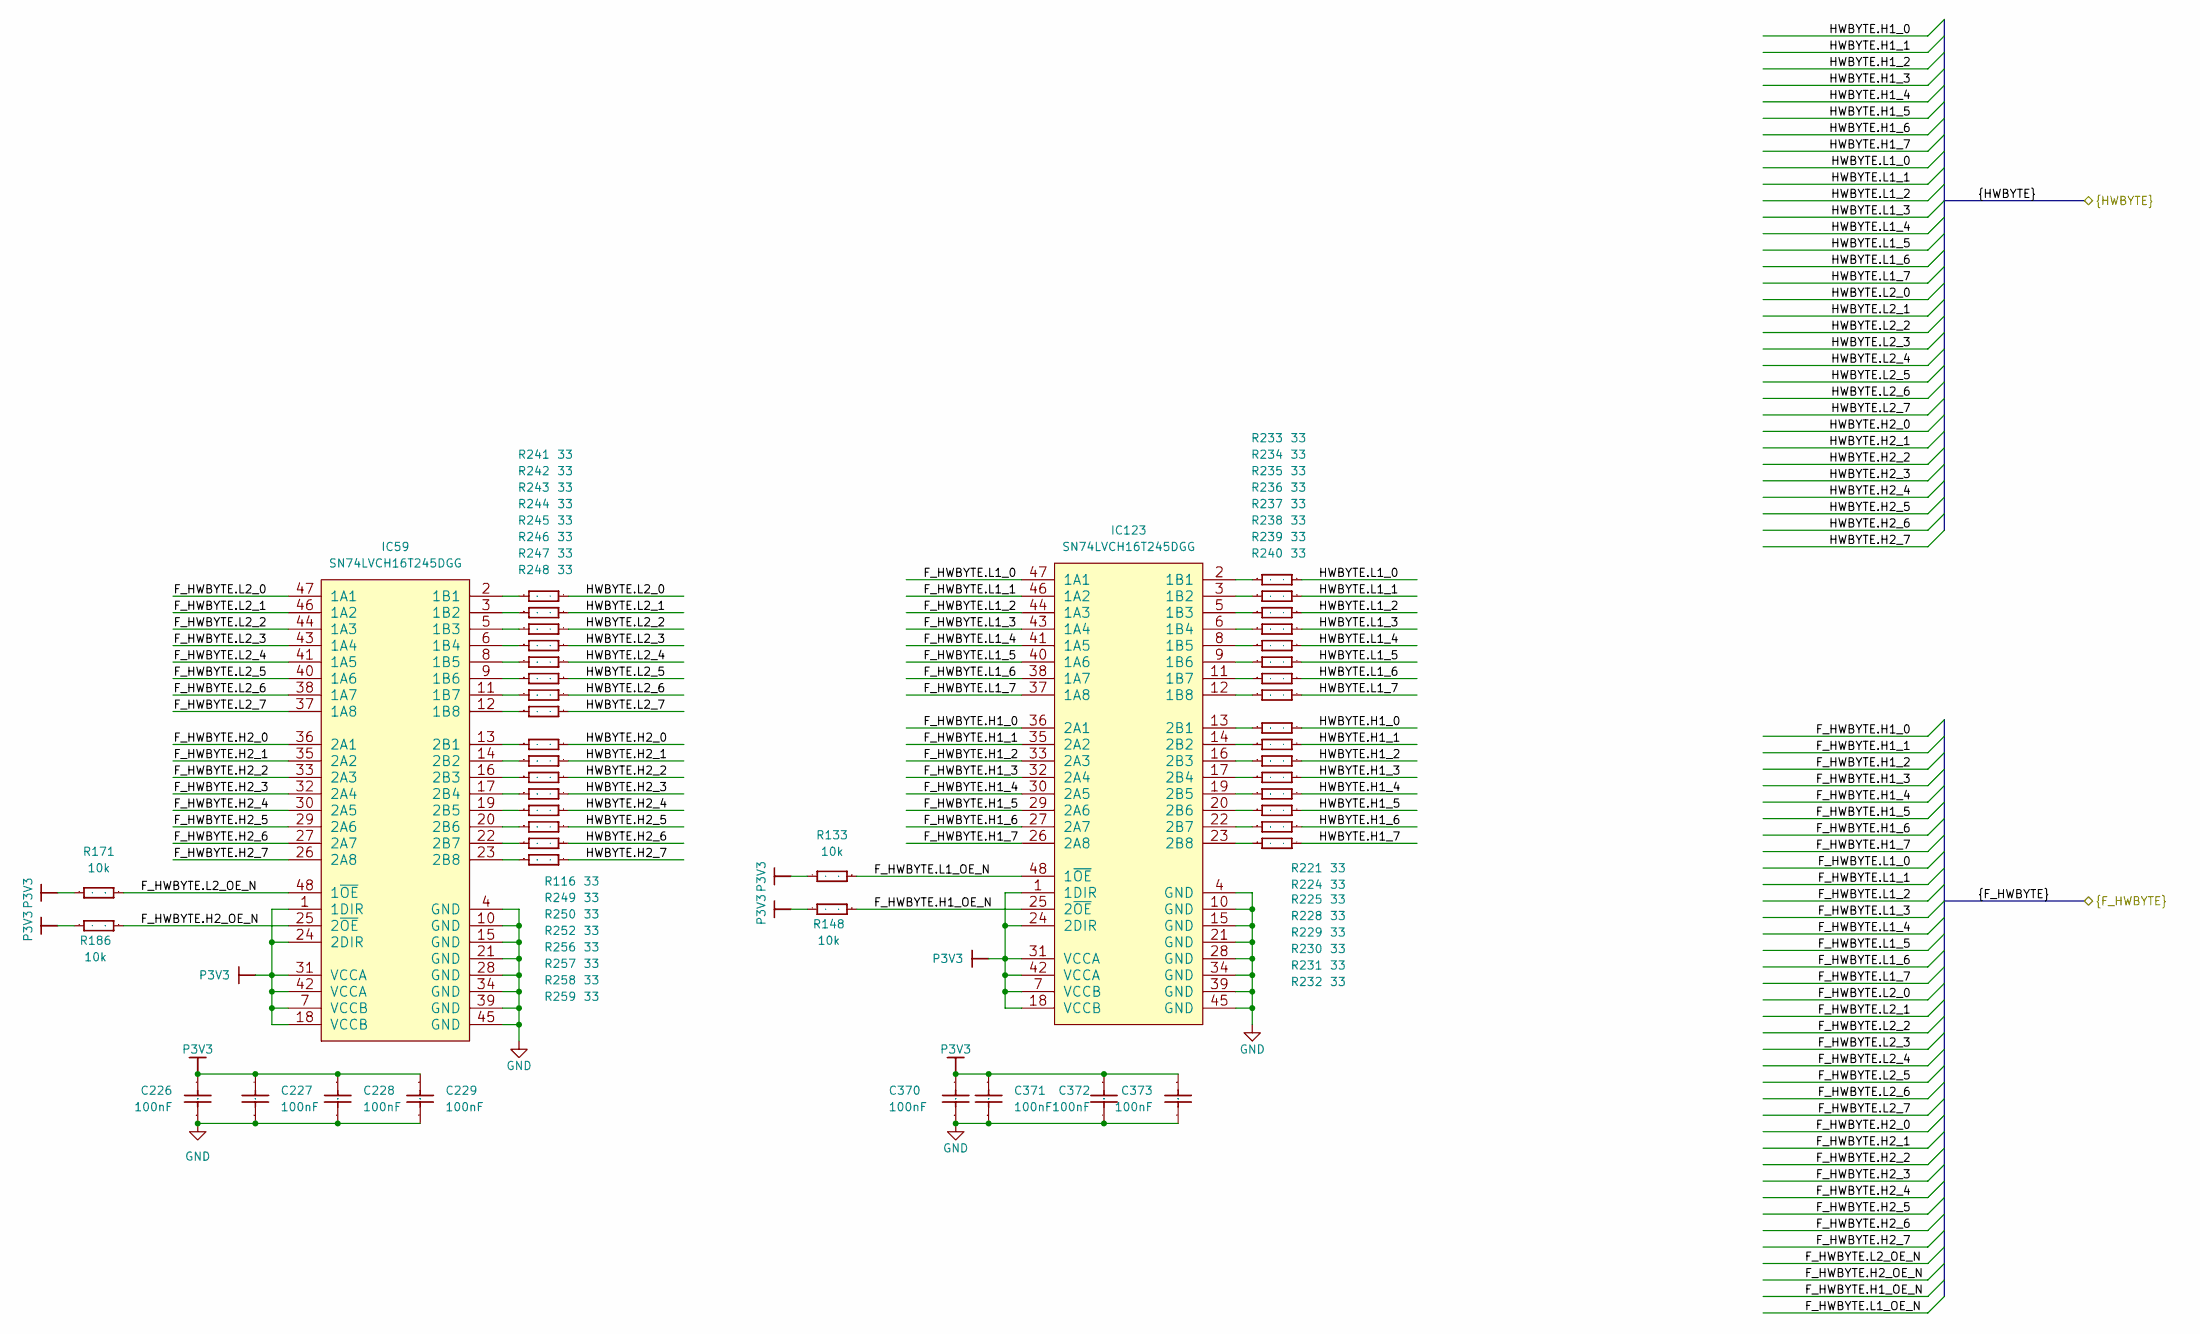
[picture p29: schematic vme_buffers_p0_hwbyte.kicad_sch]

Parts:
C226, C227, C228, C229, C370, C371, C372, C373: CC0402_100NF_16V_10%_X7R; CAPC1005X55N; Voltage 16V; Tolerance ±10%; Part Number CC0402_100NF_16V_10%_X7R
IC59, IC123: SN74LVCH16T245DGG; SOP50P810X120-48N; Part Description 16-Bit Dual-Supply Bus Transceiver with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
R116, R221, R224, R225, R228, R229, R230, R231, R232, R233, R234, R235, R236, R237, R238, R239, R240, R241, R242, R243, R244, R245, R246, R247, R248, R249, R250, R252, R256, R257, R258, R259: R0402_33R_1%_0.0625W_100PPM; RESC1005X40N; Tolerance ±1%; Part Number R0402_33R_1%_0.0625W_100PPM
R133, R148, R171, R186: R0402_10K_1%_0.0625W_100PPM; RESC1005X40N; Tolerance ±1%; Part Number R0402_10K_1%_0.0625W_100PPM

Connections:
F_HWBYTE.H1_0: IC123.36 (2A1)
F_HWBYTE.H1_1: IC123.35 (2A2)
F_HWBYTE.H1_2: IC123.33 (2A3)
F_HWBYTE.H1_3: IC123.32 (2A4)
F_HWBYTE.H1_4: IC123.30 (2A5)
F_HWBYTE.H1_5: IC123.29 (2A6)
F_HWBYTE.H1_6: IC123.27 (2A7)
F_HWBYTE.H1_7: IC123.26 (2A8)
F_HWBYTE.H1_OE_N: IC123.25 (2~OE), R148.1
F_HWBYTE.H2_0: IC59.36 (2A1)
F_HWBYTE.H2_1: IC59.35 (2A2)
F_HWBYTE.H2_2: IC59.33 (2A3)
F_HWBYTE.H2_3: IC59.32 (2A4)
F_HWBYTE.H2_4: IC59.30 (2A5)
F_HWBYTE.H2_5: IC59.29 (2A6)
F_HWBYTE.H2_6: IC59.27 (2A7)
F_HWBYTE.H2_7: IC59.26 (2A8)
F_HWBYTE.H2_OE_N: IC59.25 (2~OE), R186.1
F_HWBYTE.L1_0: IC123.47 (1A1)
F_HWBYTE.L1_1: IC123.46 (1A2)
F_HWBYTE.L1_2: IC123.44 (1A3)
F_HWBYTE.L1_3: IC123.43 (1A4)
F_HWBYTE.L1_4: IC123.41 (1A5)
F_HWBYTE.L1_5: IC123.40 (1A6)
F_HWBYTE.L1_6: IC123.38 (1A7)
F_HWBYTE.L1_7: IC123.37 (1A8)
F_HWBYTE.L1_OE_N: IC123.48 (1~OE), R133.1
F_HWBYTE.L2_0: IC59.47 (1A1)
F_HWBYTE.L2_1: IC59.46 (1A2)
F_HWBYTE.L2_2: IC59.44 (1A3)
F_HWBYTE.L2_3: IC59.43 (1A4)
F_HWBYTE.L2_4: IC59.41 (1A5)
F_HWBYTE.L2_5: IC59.40 (1A6)
F_HWBYTE.L2_6: IC59.38 (1A7)
F_HWBYTE.L2_7: IC59.37 (1A8)
F_HWBYTE.L2_OE_N: IC59.48 (1~OE), R171.1
GND: C226.1, C227.1, C228.2, C229.2, C370.1, C371.1, C372.2, C373.2, IC59.4 (GND), IC59.10 (GND), IC59.15 (GND), IC59.21 (GND), IC59.28 (GND), IC59.34 (GND), IC59.39 (GND), IC59.45 (GND), IC123.4 (GND), IC123.10 (GND), IC123.15 (GND), IC123.21 (GND), IC123.28 (GND), IC123.34 (GND), IC123.39 (GND), IC123.45 (GND)
HWBYTE.H1_0: R221.2
HWBYTE.H1_1: R224.2
HWBYTE.H1_2: R225.2
HWBYTE.H1_3: R228.2
HWBYTE.H1_4: R229.2
HWBYTE.H1_5: R230.2
HWBYTE.H1_6: R231.2
HWBYTE.H1_7: R232.2
HWBYTE.H2_0: R116.2
HWBYTE.H2_1: R249.2
HWBYTE.H2_2: R250.2
HWBYTE.H2_3: R252.2
HWBYTE.H2_4: R256.2
HWBYTE.H2_5: R257.2
HWBYTE.H2_6: R258.2
HWBYTE.H2_7: R259.2
HWBYTE.L1_0: R233.2
HWBYTE.L1_1: R234.2
HWBYTE.L1_2: R235.2
HWBYTE.L1_3: R236.2
HWBYTE.L1_4: R237.2
HWBYTE.L1_5: R238.2
HWBYTE.L1_6: R239.2
HWBYTE.L1_7: R240.2
HWBYTE.L2_0: R241.2
HWBYTE.L2_1: R242.2
HWBYTE.L2_2: R243.2
HWBYTE.L2_3: R244.2
HWBYTE.L2_4: R245.2
HWBYTE.L2_5: R246.2
HWBYTE.L2_6: R247.2
HWBYTE.L2_7: R248.2
unnamed: IC59.2 (1B1), R241.1
unnamed: IC59.3 (1B2), R242.1
unnamed: IC59.5 (1B3), R243.1
unnamed: IC59.6 (1B4), R244.1
unnamed: IC59.8 (1B5), R245.1
unnamed: IC59.9 (1B6), R246.1
unnamed: IC59.11 (1B7), R247.1
unnamed: IC59.12 (1B8), R248.1
unnamed: IC59.13 (2B1), R116.1
unnamed: IC59.14 (2B2), R249.1
unnamed: IC59.16 (2B3), R250.1
unnamed: IC59.17 (2B4), R252.1
unnamed: IC59.19 (2B5), R256.1
unnamed: IC59.20 (2B6), R257.1
unnamed: IC59.22 (2B7), R258.1
unnamed: IC59.23 (2B8), R259.1
unnamed: IC123.2 (1B1), R233.1
unnamed: IC123.3 (1B2), R234.1
unnamed: IC123.5 (1B3), R235.1
unnamed: IC123.6 (1B4), R236.1
unnamed: IC123.8 (1B5), R237.1
unnamed: IC123.9 (1B6), R238.1
unnamed: IC123.11 (1B7), R239.1
unnamed: IC123.12 (1B8), R240.1
unnamed: IC123.13 (2B1), R221.1
unnamed: IC123.14 (2B2), R224.1
unnamed: IC123.16 (2B3), R225.1
unnamed: IC123.17 (2B4), R228.1
unnamed: IC123.19 (2B5), R229.1
unnamed: IC123.20 (2B6), R230.1
unnamed: IC123.22 (2B7), R231.1
unnamed: IC123.23 (2B8), R232.1
P3V3: C226.2, C227.2, C228.1, C229.1, C370.2, C371.2, C372.1, C373.1, IC59.1 (1DIR), IC59.7 (VCCB), IC59.18 (VCCB), IC59.24 (2DIR), IC59.31 (VCCA), IC59.42 (VCCA), IC123.1 (1DIR), IC123.7 (VCCB), IC123.18 (VCCB), IC123.24 (2DIR), IC123.31 (VCCA), IC123.42 (VCCA), R133.2, R148.2, R171.2, R186.2
