ttrain4086-cpu/Kicad-VME-Wren-Update/vme_buffers_userio_p2.kicad_sch

## KiCad design vme_buffers_userio_p2.kicad_sch (2026-05-15)

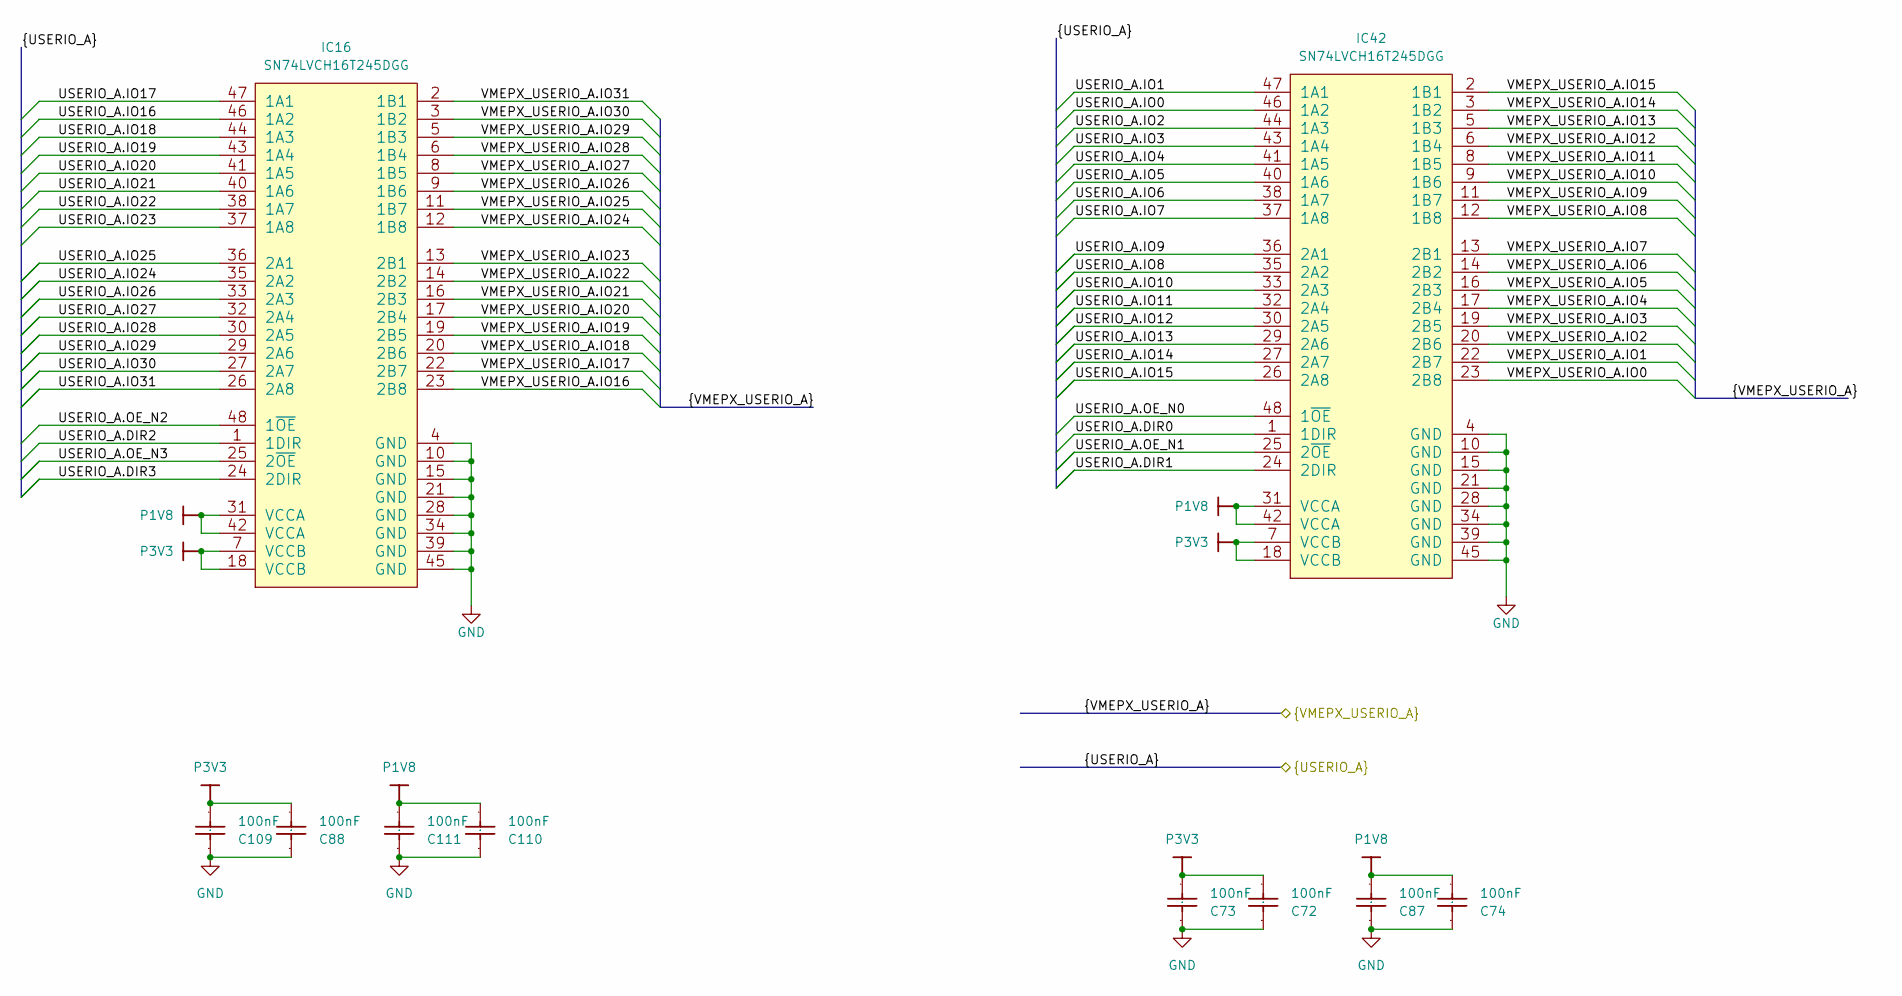
[picture p30: schematic vme_buffers_userio_p2.kicad_sch]

Parts:
C72, C73, C74, C87, C88, C109, C110, C111: CC0402_100NF_16V_10%_X7R; CAPC1005X55N; Voltage 16V; Tolerance ±10%; Part Number CC0402_100NF_16V_10%_X7R
IC16, IC42: SN74LVCH16T245DGG; SOP50P810X120-48N; Part Description 16-Bit Dual-Supply Bus Transceiver with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

Connections:
GND: C72.1, C73.1, C74.1, C87.1, C88.1, C109.1, C110.1, C111.1, IC16.4 (GND), IC16.10 (GND), IC16.15 (GND), IC16.21 (GND), IC16.28 (GND), IC16.34 (GND), IC16.39 (GND), IC16.45 (GND), IC42.4 (GND), IC42.10 (GND), IC42.15 (GND), IC42.21 (GND), IC42.28 (GND), IC42.34 (GND), IC42.39 (GND), IC42.45 (GND)
P1V8: C74.2, C87.2, C110.2, C111.2, IC16.31 (VCCA), IC16.42 (VCCA), IC42.31 (VCCA), IC42.42 (VCCA)
P3V3: C72.2, C73.2, C88.2, C109.2, IC16.7 (VCCB), IC16.18 (VCCB), IC42.7 (VCCB), IC42.18 (VCCB)
USERIO_A.DIR0: IC42.1 (1DIR)
USERIO_A.DIR1: IC42.24 (2DIR)
USERIO_A.DIR2: IC16.1 (1DIR)
USERIO_A.DIR3: IC16.24 (2DIR)
USERIO_A.IO0: IC42.46 (1A2)
USERIO_A.IO1: IC42.47 (1A1)
USERIO_A.IO2: IC42.44 (1A3)
USERIO_A.IO3: IC42.43 (1A4)
USERIO_A.IO4: IC42.41 (1A5)
USERIO_A.IO5: IC42.40 (1A6)
USERIO_A.IO6: IC42.38 (1A7)
USERIO_A.IO7: IC42.37 (1A8)
USERIO_A.IO8: IC42.35 (2A2)
USERIO_A.IO9: IC42.36 (2A1)
USERIO_A.IO10: IC42.33 (2A3)
USERIO_A.IO11: IC42.32 (2A4)
USERIO_A.IO12: IC42.30 (2A5)
USERIO_A.IO13: IC42.29 (2A6)
USERIO_A.IO14: IC42.27 (2A7)
USERIO_A.IO15: IC42.26 (2A8)
USERIO_A.IO16: IC16.46 (1A2)
USERIO_A.IO17: IC16.47 (1A1)
USERIO_A.IO18: IC16.44 (1A3)
USERIO_A.IO19: IC16.43 (1A4)
USERIO_A.IO20: IC16.41 (1A5)
USERIO_A.IO21: IC16.40 (1A6)
USERIO_A.IO22: IC16.38 (1A7)
USERIO_A.IO23: IC16.37 (1A8)
USERIO_A.IO24: IC16.35 (2A2)
USERIO_A.IO25: IC16.36 (2A1)
USERIO_A.IO26: IC16.33 (2A3)
USERIO_A.IO27: IC16.32 (2A4)
USERIO_A.IO28: IC16.30 (2A5)
USERIO_A.IO29: IC16.29 (2A6)
USERIO_A.IO30: IC16.27 (2A7)
USERIO_A.IO31: IC16.26 (2A8)
USERIO_A.OE_N0: IC42.48 (1~OE)
USERIO_A.OE_N1: IC42.25 (2~OE)
USERIO_A.OE_N2: IC16.48 (1~OE)
USERIO_A.OE_N3: IC16.25 (2~OE)
VMEPX_USERIO_A.IO0: IC42.23 (2B8)
VMEPX_USERIO_A.IO1: IC42.22 (2B7)
VMEPX_USERIO_A.IO2: IC42.20 (2B6)
VMEPX_USERIO_A.IO3: IC42.19 (2B5)
VMEPX_USERIO_A.IO4: IC42.17 (2B4)
VMEPX_USERIO_A.IO5: IC42.16 (2B3)
VMEPX_USERIO_A.IO6: IC42.14 (2B2)
VMEPX_USERIO_A.IO7: IC42.13 (2B1)
VMEPX_USERIO_A.IO8: IC42.12 (1B8)
VMEPX_USERIO_A.IO9: IC42.11 (1B7)
VMEPX_USERIO_A.IO10: IC42.9 (1B6)
VMEPX_USERIO_A.IO11: IC42.8 (1B5)
VMEPX_USERIO_A.IO12: IC42.6 (1B4)
VMEPX_USERIO_A.IO13: IC42.5 (1B3)
VMEPX_USERIO_A.IO14: IC42.3 (1B2)
VMEPX_USERIO_A.IO15: IC42.2 (1B1)
VMEPX_USERIO_A.IO16: IC16.23 (2B8)
VMEPX_USERIO_A.IO17: IC16.22 (2B7)
VMEPX_USERIO_A.IO18: IC16.20 (2B6)
VMEPX_USERIO_A.IO19: IC16.19 (2B5)
VMEPX_USERIO_A.IO20: IC16.17 (2B4)
VMEPX_USERIO_A.IO21: IC16.16 (2B3)
VMEPX_USERIO_A.IO22: IC16.14 (2B2)
VMEPX_USERIO_A.IO23: IC16.13 (2B1)
VMEPX_USERIO_A.IO24: IC16.12 (1B8)
VMEPX_USERIO_A.IO25: IC16.11 (1B7)
VMEPX_USERIO_A.IO26: IC16.9 (1B6)
VMEPX_USERIO_A.IO27: IC16.8 (1B5)
VMEPX_USERIO_A.IO28: IC16.6 (1B4)
VMEPX_USERIO_A.IO29: IC16.5 (1B3)
VMEPX_USERIO_A.IO30: IC16.3 (1B2)
VMEPX_USERIO_A.IO31: IC16.2 (1B1)
