ttrain4086-cpu/Kicad-VME-Wren-Update/vme_interface.kicad_sch

## KiCad design vme_interface.kicad_sch (2026-05-15)

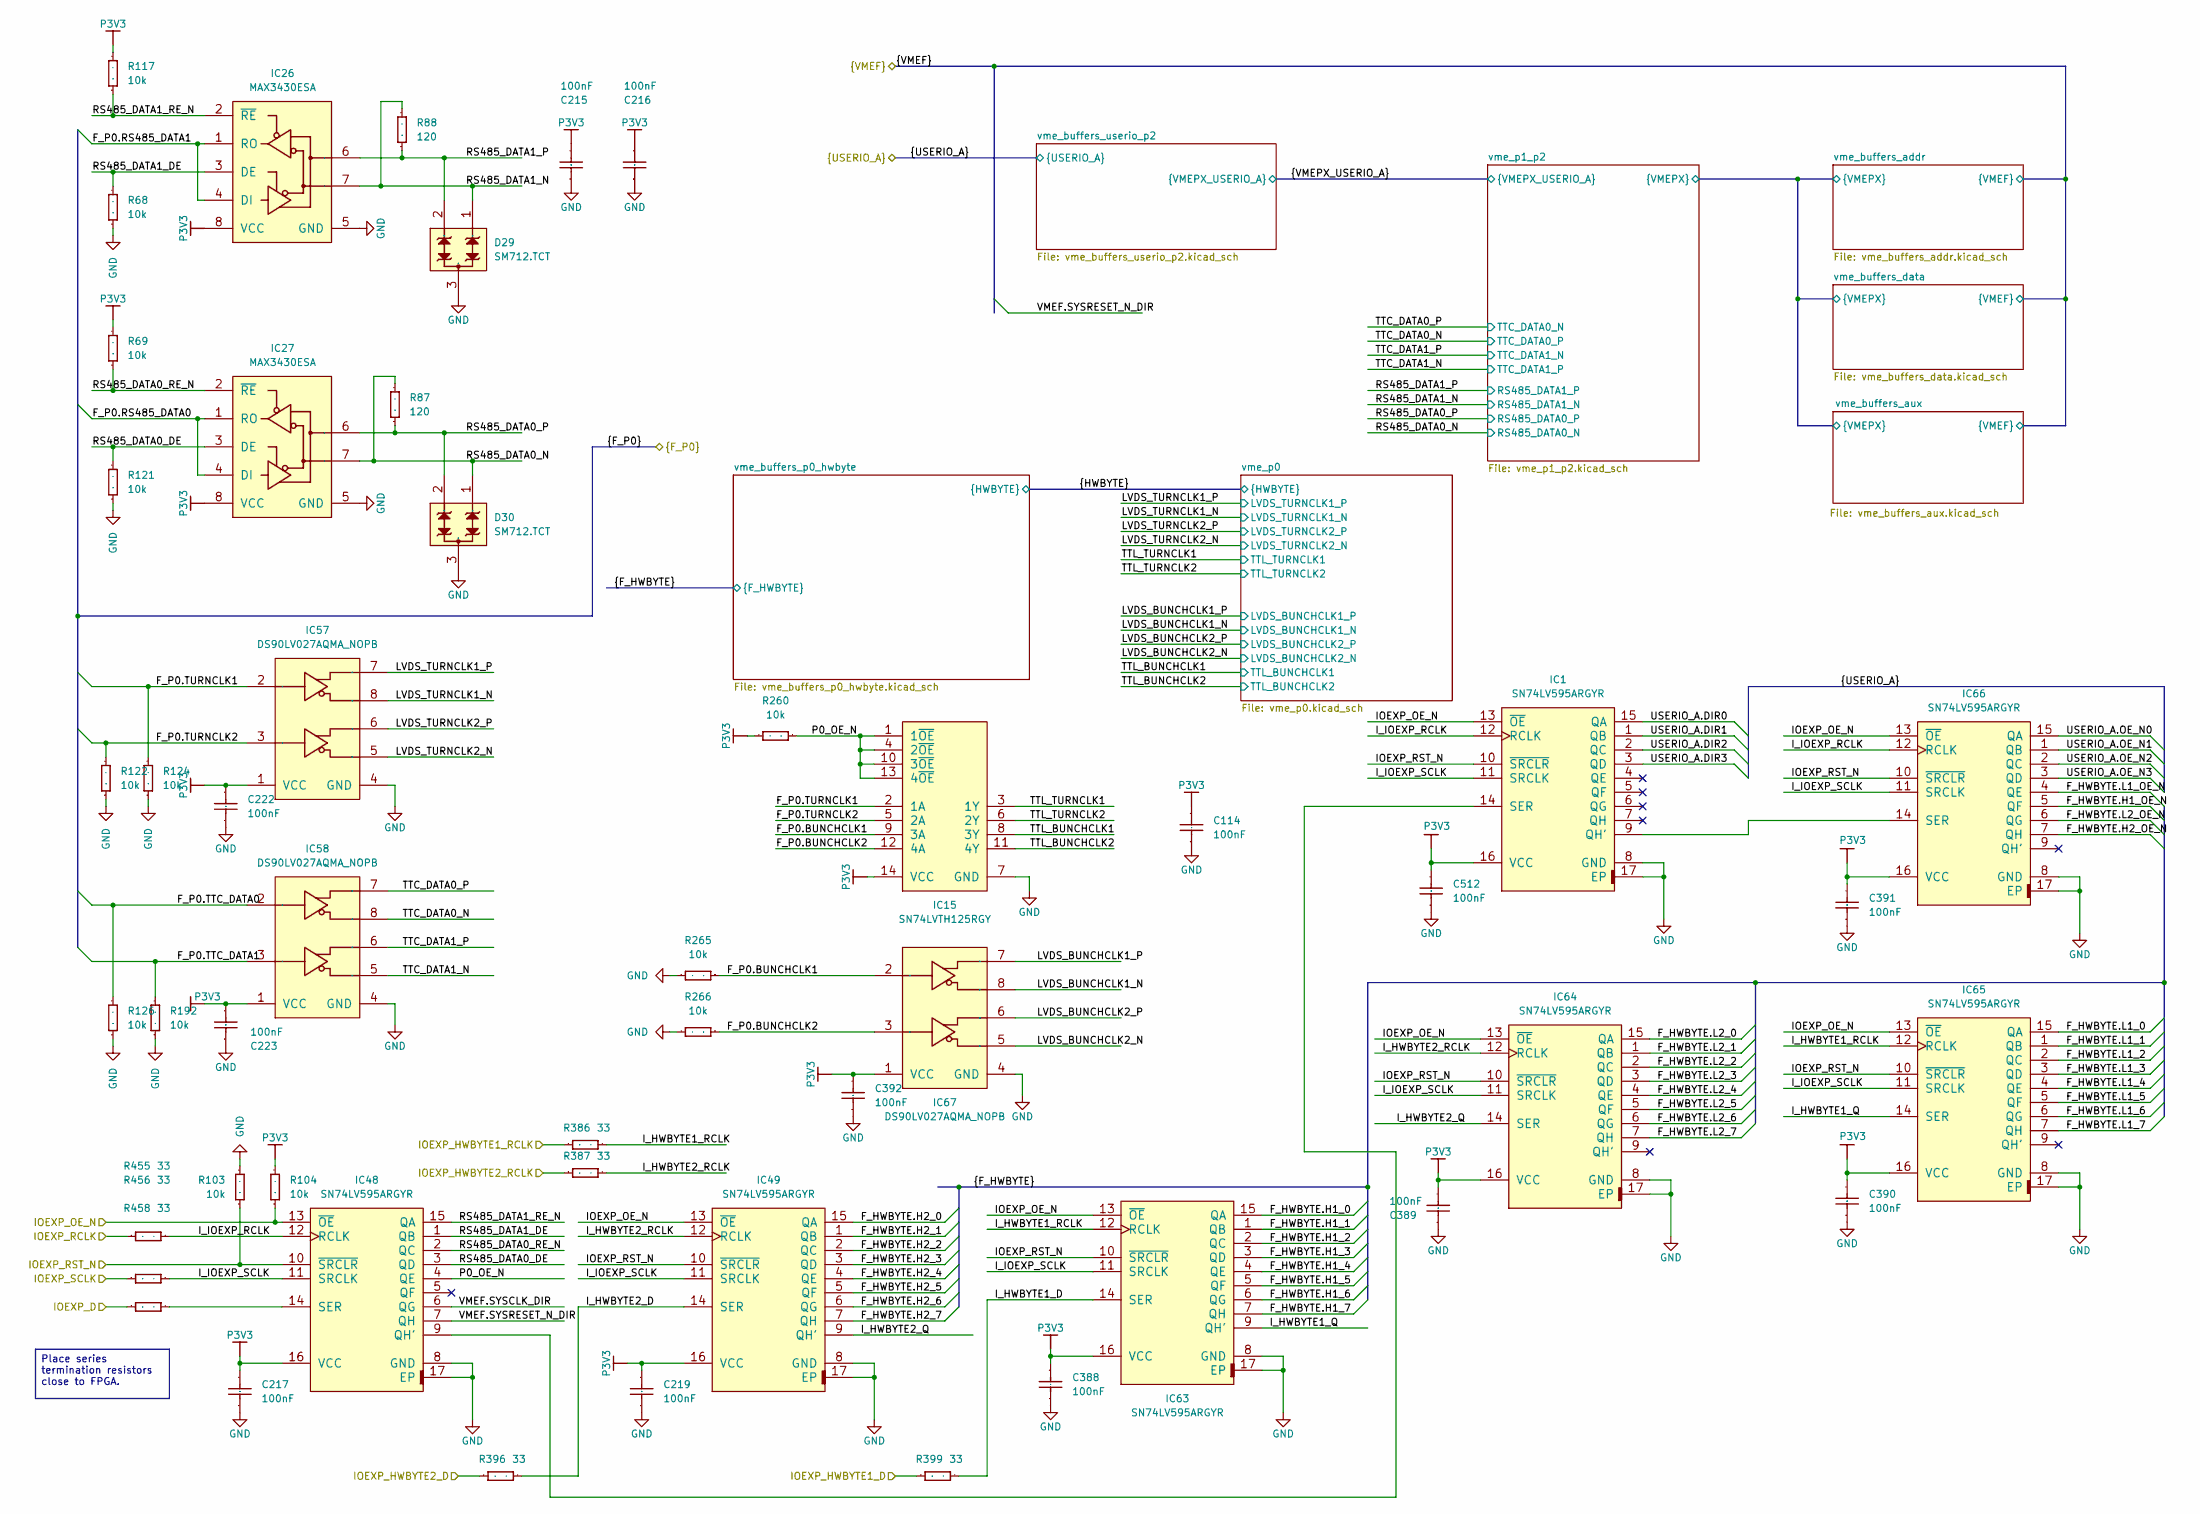
[picture p31: schematic vme_interface.kicad_sch]

Parts:
C114, C215, C216, C217, C219, C222, C223, C388, C389, C390, C391, C392, C512: CC0402_100NF_16V_10%_X7R; CAPC1005X55N; Voltage 16V; Tolerance ±10%; Part Number CC0402_100NF_16V_10%_X7R
D29, D30: SM712.TCT; SOT95P237X112-3N; Voltage 12V/-7V; Part Description Asymmetrical TVS Diode for Extended Com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
IC1, IC48, IC49, IC63, IC64, IC65, IC66: SN74LV595ARGYR; TEXAS_RGY (R-PVQFN-N16); Part Description 8-Bit Shift Register with 3-State Outpu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
IC15: SN74LVTH125RGY; TEXAS_RGY (S-PVQFN-N14); Part Number SN74LVTH125RGY
IC26, IC27: MAX3430ESA; SOIC127P600X175-8N; Part Description ±80V Fault-Protected, Fail-Safe, 1/4-Un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
IC57, IC58, IC67: DS90LV027AQMA_NOPB; SOIC127P600X175-8N; Part Description Automotive LVDS Dual Differential Driver
R68, R69, R103, R104, R117, R121, R122, R124, R126, R192, R260, R265, R266: R0402_10K_1%_0.0625W_100PPM; RESC1005X40N; Tolerance ±1%; Part Number R0402_10K_1%_0.0625W_100PPM
R87, R88: R0603_120R_1%_0.2W_200PPM; RESC1608X55N; Tolerance ±1%; Part Number R0603_120R_1%_0.2W_200PPM
R386, R387, R396, R399, R455, R456, R458: R0402_33R_1%_0.0625W_100PPM; RESC1005X40N; Tolerance ±1%; Part Number R0402_33R_1%_0.0625W_100PPM

Connections:
F_HWBYTE.H1_0: IC63.15 (QA)
F_HWBYTE.H1_1: IC63.1 (QB)
F_HWBYTE.H1_2: IC63.2 (QC)
F_HWBYTE.H1_3: IC63.3 (QD)
F_HWBYTE.H1_4: IC63.4 (QE)
F_HWBYTE.H1_5: IC63.5 (QF)
F_HWBYTE.H1_6: IC63.6 (QG)
F_HWBYTE.H1_7: IC63.7 (QH)
F_HWBYTE.H1_OE_N: IC66.5 (QF)
F_HWBYTE.H2_0: IC49.15 (QA)
F_HWBYTE.H2_1: IC49.1 (QB)
F_HWBYTE.H2_2: IC49.2 (QC)
F_HWBYTE.H2_3: IC49.3 (QD)
F_HWBYTE.H2_4: IC49.4 (QE)
F_HWBYTE.H2_5: IC49.5 (QF)
F_HWBYTE.H2_6: IC49.6 (QG)
F_HWBYTE.H2_7: IC49.7 (QH)
F_HWBYTE.H2_OE_N: IC66.7 (QH)
F_HWBYTE.L1_0: IC65.15 (QA)
F_HWBYTE.L1_1: IC65.1 (QB)
F_HWBYTE.L1_2: IC65.2 (QC)
F_HWBYTE.L1_3: IC65.3 (QD)
F_HWBYTE.L1_4: IC65.4 (QE)
F_HWBYTE.L1_5: IC65.5 (QF)
F_HWBYTE.L1_6: IC65.6 (QG)
F_HWBYTE.L1_7: IC65.7 (QH)
F_HWBYTE.L1_OE_N: IC66.4 (QE)
F_HWBYTE.L2_0: IC64.15 (QA)
F_HWBYTE.L2_1: IC64.1 (QB)
F_HWBYTE.L2_2: IC64.2 (QC)
F_HWBYTE.L2_3: IC64.3 (QD)
F_HWBYTE.L2_4: IC64.4 (QE)
F_HWBYTE.L2_5: IC64.5 (QF)
F_HWBYTE.L2_6: IC64.6 (QG)
F_HWBYTE.L2_7: IC64.7 (QH)
F_HWBYTE.L2_OE_N: IC66.6 (QG)
F_P0.BUNCHCLK1: IC15.9 (3A), IC67.2 (DI1), R265.1
F_P0.BUNCHCLK2: IC15.12 (4A), IC67.3 (DI2), R266.1
F_P0.RS485_DATA0: IC27.1 (RO), IC27.4 (DI)
F_P0.RS485_DATA1: IC26.1 (RO), IC26.4 (DI)
F_P0.TTC_DATA0: IC58.2 (DI1), R126.2
F_P0.TTC_DATA1: IC58.3 (DI2), R192.2
F_P0.TURNCLK1: IC15.2 (1A), IC57.2 (DI1), R124.2
F_P0.TURNCLK2: IC15.5 (2A), IC57.3 (DI2), R122.2
GND: C114.1, C215.1, C216.1, C217.1, C219.1, C222.1, C223.1, C388.1, C389.1, C390.1, C391.1, C392.1, C512.1, D29.3 (GND), D30.3 (GND), IC1.8 (GND), IC1.17 (EP), IC15.7 (GND), IC26.5 (GND), IC27.5 (GND), IC48.8 (GND), IC48.17 (EP), IC49.8 (GND), IC49.17 (EP), IC57.4 (GND), IC58.4 (GND), IC63.8 (GND), IC63.17 (EP), IC64.8 (GND), IC64.17 (EP), IC65.8 (GND), IC65.17 (EP), IC66.8 (GND), IC66.17 (EP), IC67.4 (GND), R68.1, R103.2, R121.1, R122.1, R124.1, R126.1, R192.1, R265.2, R266.2
IOEXP_D: R456.1
IOEXP_HWBYTE1_D: R399.1
IOEXP_HWBYTE1_RCLK: R386.1
IOEXP_HWBYTE2_D: R396.1
IOEXP_HWBYTE2_RCLK: R387.1
IOEXP_OE_N: IC1.13 (~OE), IC48.13 (~OE), IC49.13 (~OE), IC63.13 (~OE), IC64.13 (~OE), IC65.13 (~OE), IC66.13 (~OE), R104.1
IOEXP_RCLK: R455.1
IOEXP_RST_N: IC1.10 (~SRCLR), IC48.10 (~SRCLR), IC49.10 (~SRCLR), IC63.10 (~SRCLR), IC64.10 (~SRCLR), IC65.10 (~SRCLR), IC66.10 (~SRCLR), R103.1
IOEXP_SCLK: R458.1
I_HWBYTE1_D: IC63.14 (SER), R399.2
I_HWBYTE1_Q: IC63.9 (QH'), IC65.14 (SER)
I_HWBYTE1_RCLK: IC63.12 (RCLK), IC65.12 (RCLK), R386.2
I_HWBYTE2_D: IC49.14 (SER), R396.2
I_HWBYTE2_Q: IC49.9 (QH'), IC64.14 (SER)
I_HWBYTE2_RCLK: IC49.12 (RCLK), IC64.12 (RCLK), R387.2
I_IOEXP_RCLK: IC1.12 (RCLK), IC48.12 (RCLK), IC66.12 (RCLK), R455.2
I_IOEXP_SCLK: IC1.11 (SRCLK), IC48.11 (SRCLK), IC49.11 (SRCLK), IC63.11 (SRCLK), IC64.11 (SRCLK), IC65.11 (SRCLK), IC66.11 (SRCLK), R458.2
LVDS_BUNCHCLK1_N: IC67.8 (DO1-)
LVDS_BUNCHCLK1_P: IC67.7 (DO1+)
LVDS_BUNCHCLK2_N: IC67.5 (DO2-)
LVDS_BUNCHCLK2_P: IC67.6 (DO2+)
LVDS_TURNCLK1_N: IC57.8 (DO1-)
LVDS_TURNCLK1_P: IC57.7 (DO1+)
LVDS_TURNCLK2_N: IC57.5 (DO2-)
LVDS_TURNCLK2_P: IC57.6 (DO2+)
unnamed: IC1.9 (QH'), IC66.14 (SER)
unnamed: IC1.14 (SER), IC48.9 (QH')
unnamed: IC48.14 (SER), R456.2
P0_OE_N: IC15.1 (1~OE), IC15.4 (2~OE), IC15.10 (3~OE), IC15.13 (4~OE), IC48.4 (QE), R260.1
P3V3: C114.2, C215.2, C216.2, C217.2, C219.2, C222.2, C223.2, C388.2, C389.2, C390.2, C391.2, C392.2, C512.2, IC1.16 (VCC), IC15.14 (VCC), IC26.8 (VCC), IC27.8 (VCC), IC48.16 (VCC), IC49.16 (VCC), IC57.1 (VCC), IC58.1 (VCC), IC63.16 (VCC), IC64.16 (VCC), IC65.16 (VCC), IC66.16 (VCC), IC67.1 (VCC), R69.2, R104.2, R117.2, R260.2
RS485_DATA0_DE: IC27.3 (DE), IC48.3 (QD), R121.2
RS485_DATA0_N: D30.1 (I/O1), IC27.7 (B), R87.2
RS485_DATA0_P: D30.2 (I/O2), IC27.6 (A), R87.1
RS485_DATA0_RE_N: IC27.2 (~RE), IC48.2 (QC), R69.1
RS485_DATA1_DE: IC26.3 (DE), IC48.1 (QB), R68.2
RS485_DATA1_N: D29.1 (I/O1), IC26.7 (B), R88.2
RS485_DATA1_P: D29.2 (I/O2), IC26.6 (A), R88.1
RS485_DATA1_RE_N: IC26.2 (~RE), IC48.15 (QA), R117.1
TTC_DATA0_N: IC58.8 (DO1-)
TTC_DATA0_P: IC58.7 (DO1+)
TTC_DATA1_N: IC58.5 (DO2-)
TTC_DATA1_P: IC58.6 (DO2+)
TTL_BUNCHCLK1: IC15.8 (3Y)
TTL_BUNCHCLK2: IC15.11 (4Y)
TTL_TURNCLK1: IC15.3 (1Y)
TTL_TURNCLK2: IC15.6 (2Y)
USERIO_A.DIR0: IC1.15 (QA)
USERIO_A.DIR1: IC1.1 (QB)
USERIO_A.DIR2: IC1.2 (QC)
USERIO_A.DIR3: IC1.3 (QD)
USERIO_A.OE_N0: IC66.15 (QA)
USERIO_A.OE_N1: IC66.1 (QB)
USERIO_A.OE_N2: IC66.2 (QC)
USERIO_A.OE_N3: IC66.3 (QD)
VMEF.SYSCLK_DIR: IC48.6 (QG)
VMEF.SYSRESET_N_DIR: IC48.7 (QH)

Notes on the sheet:
Place series termination resistors close to FPGA.
