ttrain4086-cpu/Kicad-VME-Wren-Update/vme_p1_p2.kicad_sch

## KiCad design vme_p1_p2.kicad_sch (2026-05-15)

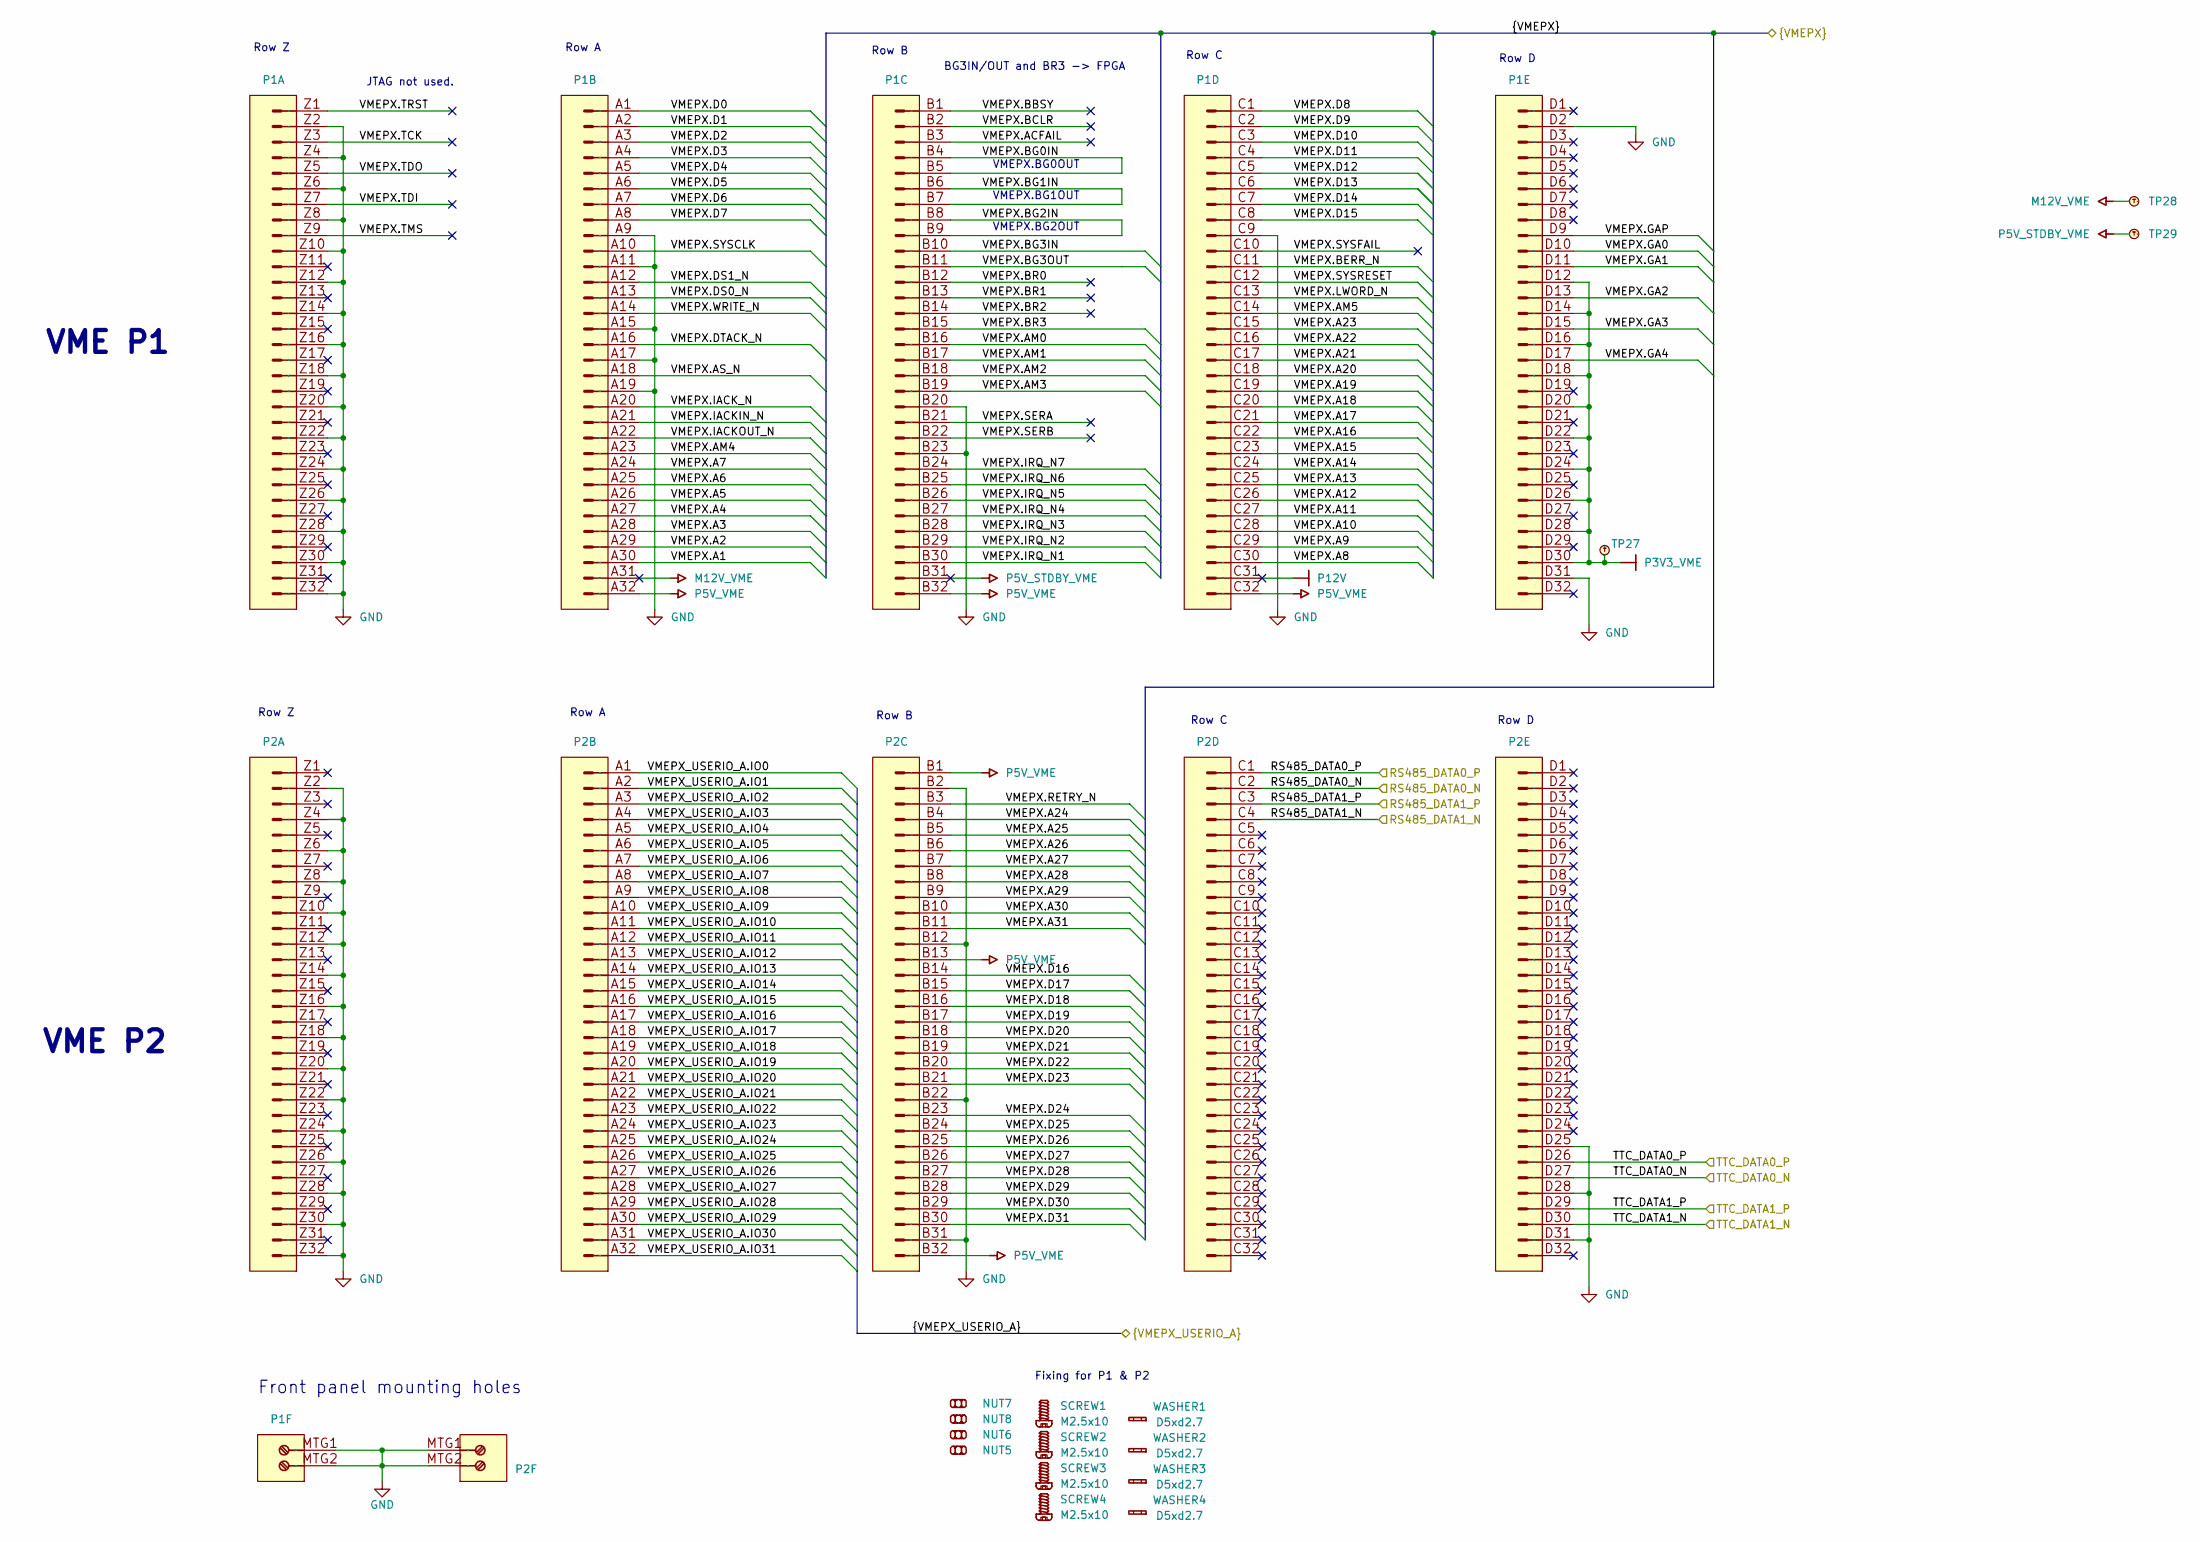
[picture p32: schematic vme_p1_p2.kicad_sch]

Parts:
NUT5, NUT6, NUT7, NUT8: BOSSARD_BN628-1241427_v; Part Number BOSSARD_BN628-1241427_v
P1, P2: HARTING_02_01_160_2101; HARTING_02 01 160 2101; Part Number HARTING_02_01_160_2101
SCREW1, SCREW2, SCREW3, SCREW4: BOSSARD_BN5687-3061600_v; Part Number BOSSARD_BN5687-3061600_v
TP27: Tomachie_TP_N; TPS127
TP28, TP29: Tomachie_TP_E; TPS127
WASHER1, WASHER2, WASHER3, WASHER4: BOSSARD_BN678-8303525_v; Part Number BOSSARD_BN678-8303525_v

Connections:
GND: P1.A9 (a9), P1.A11 (a11), P1.A15 (a15), P1.A17 (a17), P1.A19 (a19), P1.B20 (b20), P1.B23 (b23), P1.C9 (c9), P1.D2 (d2), P1.D31 (d31), P1.MTG1, P1.MTG2, P1.Z2 (z2), P1.Z4 (z4), P1.Z6 (z6), P1.Z8 (z8), P1.Z10 (z10), P1.Z12 (z12), P1.Z14 (z14), P1.Z16 (z16), P1.Z18 (z18), P1.Z20 (z20), P1.Z22 (z22), P1.Z24 (z24), P1.Z26 (z26), P1.Z28 (z28), P1.Z30 (z30), P1.Z32 (z32), P2.B2 (b2), P2.B12 (b12), P2.B22 (b22), P2.B31 (b31), P2.D25 (d25), P2.D28 (d28), P2.D31 (d31), P2.MTG1, P2.MTG2, P2.Z2 (z2), P2.Z4 (z4), P2.Z6 (z6), P2.Z8 (z8), P2.Z10 (z10), P2.Z12 (z12), P2.Z14 (z14), P2.Z16 (z16), P2.Z18 (z18), P2.Z20 (z20), P2.Z22 (z22), P2.Z24 (z24), P2.Z26 (z26), P2.Z28 (z28), P2.Z30 (z30), P2.Z32 (z32)
M12V_VME: P1.A31 (a31), TP28.1
P3V3_VME: P1.D12 (d12), P1.D14 (d14), P1.D16 (d16), P1.D18 (d18), P1.D20 (d20), P1.D22 (d22), P1.D24 (d24), P1.D26 (d26), P1.D28 (d28), P1.D30 (d30), TP27.1
P5V_STDBY_VME: P1.B31 (b31), TP29.1
P5V_VME: P1.A32 (a32), P1.B32 (b32), P1.C32 (c32), P2.B1 (b1), P2.B13 (b13), P2.B32 (b32)
P12V: P1.C31 (c31)
RS485_DATA0_N: P2.C2 (c2)
RS485_DATA0_P: P2.C1 (c1)
RS485_DATA1_N: P2.C4 (c4)
RS485_DATA1_P: P2.C3 (c3)
TTC_DATA0_N: P2.D27 (d27)
TTC_DATA0_P: P2.D26 (d26)
TTC_DATA1_N: P2.D30 (d30)
TTC_DATA1_P: P2.D29 (d29)
VMEPX.A1: P1.A30 (a30)
VMEPX.A2: P1.A29 (a29)
VMEPX.A3: P1.A28 (a28)
VMEPX.A4: P1.A27 (a27)
VMEPX.A5: P1.A26 (a26)
VMEPX.A6: P1.A25 (a25)
VMEPX.A7: P1.A24 (a24)
VMEPX.A8: P1.C30 (c30)
VMEPX.A9: P1.C29 (c29)
VMEPX.A10: P1.C28 (c28)
VMEPX.A11: P1.C27 (c27)
VMEPX.A12: P1.C26 (c26)
VMEPX.A13: P1.C25 (c25)
VMEPX.A14: P1.C24 (c24)
VMEPX.A15: P1.C23 (c23)
VMEPX.A16: P1.C22 (c22)
VMEPX.A17: P1.C21 (c21)
VMEPX.A18: P1.C20 (c20)
VMEPX.A19: P1.C19 (c19)
VMEPX.A20: P1.C18 (c18)
VMEPX.A21: P1.C17 (c17)
VMEPX.A22: P1.C16 (c16)
VMEPX.A23: P1.C15 (c15)
VMEPX.A24: P2.B4 (b4)
VMEPX.A25: P2.B5 (b5)
VMEPX.A26: P2.B6 (b6)
VMEPX.A27: P2.B7 (b7)
VMEPX.A28: P2.B8 (b8)
VMEPX.A29: P2.B9 (b9)
VMEPX.A30: P2.B10 (b10)
VMEPX.A31: P2.B11 (b11)
VMEPX.ACFAIL: P1.B3 (b3)
VMEPX.AM0: P1.B16 (b16)
VMEPX.AM1: P1.B17 (b17)
VMEPX.AM2: P1.B18 (b18)
VMEPX.AM3: P1.B19 (b19)
VMEPX.AM4: P1.A23 (a23)
VMEPX.AM5: P1.C14 (c14)
VMEPX.AS_N: P1.A18 (a18)
VMEPX.BBSY: P1.B1 (b1)
VMEPX.BCLR: P1.B2 (b2)
VMEPX.BERR_N: P1.C11 (c11)
VMEPX.BG0IN: P1.B4 (b4), P1.B5 (b5)
VMEPX.BG1IN: P1.B6 (b6), P1.B7 (b7)
VMEPX.BG2IN: P1.B8 (b8), P1.B9 (b9)
VMEPX.BG3IN: P1.B10 (b10)
VMEPX.BG3OUT: P1.B11 (b11)
VMEPX.BR0: P1.B12 (b12)
VMEPX.BR1: P1.B13 (b13)
VMEPX.BR2: P1.B14 (b14)
VMEPX.BR3: P1.B15 (b15)
VMEPX.D0: P1.A1 (a1)
VMEPX.D1: P1.A2 (a2)
VMEPX.D2: P1.A3 (a3)
VMEPX.D3: P1.A4 (a4)
VMEPX.D4: P1.A5 (a5)
VMEPX.D5: P1.A6 (a6)
VMEPX.D6: P1.A7 (a7)
VMEPX.D7: P1.A8 (a8)
VMEPX.D8: P1.C1 (c1)
VMEPX.D9: P1.C2 (c2)
VMEPX.D10: P1.C3 (c3)
VMEPX.D11: P1.C4 (c4)
VMEPX.D12: P1.C5 (c5)
VMEPX.D13: P1.C6 (c6)
VMEPX.D14: P1.C7 (c7)
VMEPX.D15: P1.C8 (c8)
VMEPX.D16: P2.B14 (b14)
VMEPX.D17: P2.B15 (b15)
VMEPX.D18: P2.B16 (b16)
VMEPX.D19: P2.B17 (b17)
VMEPX.D20: P2.B18 (b18)
VMEPX.D21: P2.B19 (b19)
VMEPX.D22: P2.B20 (b20)
VMEPX.D23: P2.B21 (b21)
VMEPX.D24: P2.B23 (b23)
VMEPX.D25: P2.B24 (b24)
VMEPX.D26: P2.B25 (b25)
VMEPX.D27: P2.B26 (b26)
VMEPX.D28: P2.B27 (b27)
VMEPX.D29: P2.B28 (b28)
VMEPX.D30: P2.B29 (b29)
VMEPX.D31: P2.B30 (b30)
VMEPX.DS0_N: P1.A13 (a13)
VMEPX.DS1_N: P1.A12 (a12)
VMEPX.DTACK_N: P1.A16 (a16)
VMEPX.GA0: P1.D10 (d10)
VMEPX.GA1: P1.D11 (d11)
VMEPX.GA2: P1.D13 (d13)
VMEPX.GA3: P1.D15 (d15)
VMEPX.GA4: P1.D17 (d17)
VMEPX.GAP: P1.D9 (d9)
VMEPX.IACKIN_N: P1.A21 (a21)
VMEPX.IACKOUT_N: P1.A22 (a22)
VMEPX.IACK_N: P1.A20 (a20)
VMEPX.IRQ_N1: P1.B30 (b30)
VMEPX.IRQ_N2: P1.B29 (b29)
VMEPX.IRQ_N3: P1.B28 (b28)
VMEPX.IRQ_N4: P1.B27 (b27)
VMEPX.IRQ_N5: P1.B26 (b26)
VMEPX.IRQ_N6: P1.B25 (b25)
VMEPX.IRQ_N7: P1.B24 (b24)
VMEPX.LWORD_N: P1.C13 (c13)
VMEPX.RETRY_N: P2.B3 (b3)
VMEPX.SERA: P1.B21 (b21)
VMEPX.SERB: P1.B22 (b22)
VMEPX.SYSCLK: P1.A10 (a10)
VMEPX.SYSFAIL: P1.C10 (c10)
VMEPX.SYSRESET: P1.C12 (c12)
VMEPX.TCK: P1.Z3 (z3)
VMEPX.TDI: P1.Z7 (z7)
VMEPX.TDO: P1.Z5 (z5)
VMEPX.TMS: P1.Z9 (z9)
VMEPX.TRST: P1.Z1 (z1)
VMEPX.WRITE_N: P1.A14 (a14)
VMEPX_USERIO_A.IO0: P2.A1 (a1)
VMEPX_USERIO_A.IO1: P2.A2 (a2)
VMEPX_USERIO_A.IO2: P2.A3 (a3)
VMEPX_USERIO_A.IO3: P2.A4 (a4)
VMEPX_USERIO_A.IO4: P2.A5 (a5)
VMEPX_USERIO_A.IO5: P2.A6 (a6)
VMEPX_USERIO_A.IO6: P2.A7 (a7)
VMEPX_USERIO_A.IO7: P2.A8 (a8)
VMEPX_USERIO_A.IO8: P2.A9 (a9)
VMEPX_USERIO_A.IO9: P2.A10 (a10)
VMEPX_USERIO_A.IO10: P2.A11 (a11)
VMEPX_USERIO_A.IO11: P2.A12 (a12)
VMEPX_USERIO_A.IO12: P2.A13 (a13)
VMEPX_USERIO_A.IO13: P2.A14 (a14)
VMEPX_USERIO_A.IO14: P2.A15 (a15)
VMEPX_USERIO_A.IO15: P2.A16 (a16)
VMEPX_USERIO_A.IO16: P2.A17 (a17)
VMEPX_USERIO_A.IO17: P2.A18 (a18)
VMEPX_USERIO_A.IO18: P2.A19 (a19)
VMEPX_USERIO_A.IO19: P2.A20 (a20)
VMEPX_USERIO_A.IO20: P2.A21 (a21)
VMEPX_USERIO_A.IO21: P2.A22 (a22)
VMEPX_USERIO_A.IO22: P2.A23 (a23)
VMEPX_USERIO_A.IO23: P2.A24 (a24)
VMEPX_USERIO_A.IO24: P2.A25 (a25)
VMEPX_USERIO_A.IO25: P2.A26 (a26)
VMEPX_USERIO_A.IO26: P2.A27 (a27)
VMEPX_USERIO_A.IO27: P2.A28 (a28)
VMEPX_USERIO_A.IO28: P2.A29 (a29)
VMEPX_USERIO_A.IO29: P2.A30 (a30)
VMEPX_USERIO_A.IO30: P2.A31 (a31)
VMEPX_USERIO_A.IO31: P2.A32 (a32)

Notes on the sheet:
Row D
Row B
Front panel mounting holes
Row A
VMEPX.BG1OUT
BG3IN/OUT and BR3 -> FPGA
Row Z
VMEPX.BG0OUT
VMEPX.BG2OUT
JTAG not used.
VME P1
Row C
Fixing for P1 & P2
VME P2
