ttrain4086-cpu/Kicad-VME-Wren-Update/(commit log)

2026-05-15 Add files via upload
    CERN White Rabbit VME Schematic updated with test points inserted.
    [clocks.kicad_sch, ddr4-ps.kicad_sch, flash.kicad_sch, fp_connectors.kicad_sch, fpga-config.kicad_sch, fpga-hd-banks.kicad_sch, fpga-hp-banks.kicad_sch, fpga-mgts-power.kicad_sch]
2026-05-15 added the PDF of the Schematic
    PDF of schematic if you dont have KiCad or don't use Kicad but would like to follow along using the PDF with the report.
