ttrain4086-cpu/Kicad-VME-Wren-Update/(notices)

Notices in the files:
parts and their libraries:
License: CC-BY-SA 4.0
